vasilepi/Thesis/README.md

# Thesis
This repo contains everything about my thesis project at AUTh
