vasilepi/Thesis/TeX/title.tex

\newcommand{\uni}{ΑΡΙΣΤΟΤΕΛΕΙΟ ΠΑΝΕΠΙΣΤΗΜΙΟ ΘΕΣΣΑΛΟΝΙΚΗΣ}
\newcommand{\faculty}{ΠΟΛΥΤΕΧΝΙΚΗ ΣΧΟΛΗ}
\newcommand{\tmhma}{ΤΜΗΜΑ ΜΗΧΑΝΟΛΟΓΩΝ ΜΗΧΑΝΙΚΩΝ}

\newcommand{\titlos}{Προκαταρτικός Και Μηχανοτρονικός Σχεδιασμός Ημιαυτόνομου Ρομποτικού Διασώστη Για U.S.A.R. Αποστολές}
\newcommand{\ypotitlos}{Διπλωματική Εργασία}

\newcommand{\onomaauthor}{ΒΑΣΙΛΕΙΟΣ ΠΑΠΑΜΙΧΑΗΛ}

\newcommand{\advisor}{Σαββαΐδης Γεώργιος}
\newcommand{\advisorView}{Γιαννάκης Ευστράτιος, Τσακίρης Αντώνιος}
\newcommand{\mailauthor}{\href{mailto:vasilepi@meng.auth.gr}{vasilepi@meng.auth.gr}}
\newcommand{\aem}{6920}
\newcommand{\hmeromhnia}{\today}

\begin{titlepage}
    \begin{center}
    \raisebox{20mm}{
    \begin{tikzpicture}
        \draw (0,0) -- (6,0);
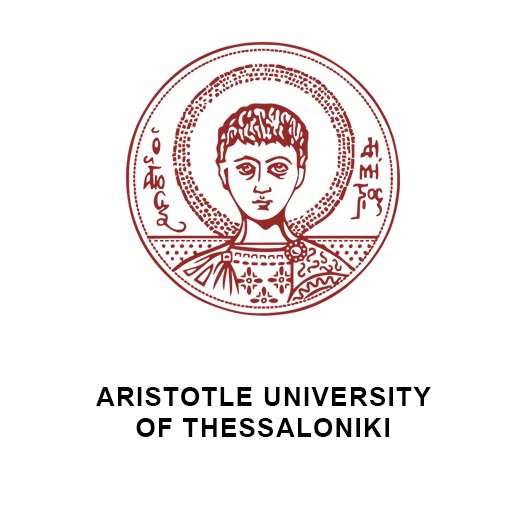
[picture p1: TeX/media/autheng.png]
    \end{tikzpicture}}\raisebox{20mm}{\begin{tikzpicture}
        \draw (0,0) -- (6,0);
    \end{tikzpicture}}
     \end{center}
    
    \begin{center}
        \large
        \uni\\
        \normalsize
        \faculty\\
        \vspace{1em}
        \tmhma
    \end{center}

    \vspace{2cm}
    \begin{center}
        \Large
        \textbf{\titlos}\\
        \vspace{1em}
        \large
        \textit{\ypotitlos}
    \end{center}
    \begin{center}
        \begin{tikzpicture}
        \draw (0,0) -- (4,0);
    \end{tikzpicture}\\
    \vspace{7em}
    \Large
    \textbf{\onomaauthor}\\
    \vspace{3em}
    
    \end{center}

    \vspace{1em}
    \hspace{4ex}
    \begin{minipage}[t]{0.8\textwidth} 
        \raggedright
        \textbf{Υπεύθυνος καθηγητής}: \advisor\\
        \textbf{Υπεύθυνος παρακολούθησης}: \advisorView\\
        \textbf{Email}: \mailauthor\\
        \textbf{ΑΕΜ}: \aem
    \end{minipage}\\

    \vspace{4cm}
    \begin{center}
        \textit{\hmeromhnia}\\
        \begin{tikzpicture}
            \draw (0,0) -- (15,0);
        \end{tikzpicture}
    \end{center}

\end{titlepage}
