vasilepi/Thesis/TeX/sections/conceptual.tex

\section{Στόχοι του προκαταρτικού σχεδιασμού}
% project requirements

Ο προκαταρτικός σχεδιασμός αναφέρεται στην δημιουργική φάση σχεδιασμού ενός συστήματος. Συνήθως αποτελείται από τη φάση του προσδιρισμού των λειτουργιών του προς σχεδίαση συστήματος, τη φάση της διατύπωσης των προϋποθέσεων, των προδιαγραφών, αλλά και των στόχων του σχεδιασμού, και τη φάση της υλοποίησης της σχεδιαστικής πρότασης. Πολλές φορές επίσης, αναλύονται εναλλακτικές σχεδιαστικές προτάσεις και αξιολογούνται με διάφορες μεθόδους ώστε να προκύψει η βέλτιστη σχεδιαστική πρόταση για το προς μελέτη σύστημα \cite{designArgyris}. Παρακάτω θα αναλυθούν οι προδιαγραφές του σχεδιασμού και οι προϋποθέσεις της σχειδαστικής πρότασεις.
\par Η αποστολή ενός ρομποτικού διασώστη μπορεί να διαφέρει σημαντικά, όπως και η πληθώρα των πιθανών καταστροφών. Ιδιαίτερα σε περίπτωση σεισμού, η χρήση ενός τέτοιου συστήματος καθίσταται ακόμη πιο αποτελεσματική, τόσο επειδή η σχεδίαση και υλοποίηση ενός ρομποτικού διασώστη παρουσιάζει λιγότερες τεχνικές δυσκολίες, όσο και επειδή οι άνθρωποι διασώστες εκτίθενται σε υψηλό και απρόβλεπτο κίνδυνο. Ένας άνθρωπος διασώστης που επιχειρεί να εισχωρήσει σε συντρίμμια για τον εντοπισμό θυμάτων δεν μπορεί να γνωρίζει εάν και πότε ενδέχεται να σημειωθεί επιπλέον κατάρρευση ή πτώση φερώντων υλικών με αποτέλεσμα να διακινδυνεύει τη ζωή του. Επιπλέον, οι άνθρωποι διασώστες συχνά αντιμετωπίζουν σημαντικούς περιορισμούς χώρου σε τέτοιες αποστολές. Λόγω του όγκου του ανθρώπινου σώματος, πολλές φορές δεν είναι δυνατόν να περάσουν μέσα από πολύ στενά ανοίγματα ή σχισμές, στα οποία ενδέχεται να βρίσκεται παγιδευμένο κάποιο θύμα. Έτσι, ένας ρομποτικός διασώστης για σεισμικές καταστροφές καθίσταται ιδιαίτερα χρήσιμος και αποτελεσματικός.
\par Η χρήση των ρομποτικών διασώστων μπορεί επίσης να ποικίλει. Τα ρομπότ αυτά συχνά δαιχωρίζονται στα παρακάτω είδη. Προφανώς ένας ρομποτικός διασώστης μπορεί να σχεδιάζεται για να λειτουργεί με οποιονδήποτε συνδυασμό όλων των παρακάτω:
\begin{itemize}
    \item \textbf{Ρομπότ έρευνας και ανίχνευσης.} Βασικός στόχος του διασώστη αυτού είναι η έρευνα μιας πληγείσας περιοχής και η ανίχνευση πιθανών θυμάτων ή αιτιών της καταστροφής.
    \item \textbf{Ρομπότ αρωγής ανθρώπινων αποστολών.} Τα ρομπότ αυτά υποστηρίζουν τους ανθρώπους διασώστες κατά τη διάρκεια των επιχειρήσεων, παρέχοντας βοήθεια όπου απαιτείται.
    \item \textbf{Ρομπότ παροχής πρώτων βοηθειών.} Έχουν ως κύρια αποστολή τη μεταφορά ειδών πρώτης ανάγκης ή ιατρικού εξοπλισμού σε δυσπρόσιτες περιοχές όπου μπορεί να βρίσκονται θύματα.
    \item \textbf{Άμεσοι ρομποτικοί διασώστες.} Αποτελούν την πιο προηγμένη κατηγορία, καθώς σχεδιάζονται για να λειτουργούν ημιαυτόνομα σε επιχειρήσεις απεγκλωβισμού. Διαθέτουν μηχανισμούς για τον εντοπισμό, την απελευθέρωση και τη μεταφορά θυμάτων.
\end{itemize} 
Παρακάτω φαίνονται μερικά παραδείγματα ρομποτικών διασωστών με διάφορες λειτουργίες. Αυτά τα ρομπότ εξειδικεύονται σε USAR αποστολές και έχουν αναπτυχθεί στην Ιαπωνία, όπου η ανάγκη για τέτοιες τεχνολογίες είναι πολύ μεγάλη λόγω της συχνότητας αλλά και της κλίμακας των σεισμικών καταστροφών. Για τα πλαίσια αυτής εργασίας κρίνεται σκόπιμο να σχεδιασθεί ένας διασώστης για USAR αποστολές και πιο συγκεκριμένα για αποστολές διάσωσης μετά από σεισμούς.
\begin{figure}[H]
    \centering
    \begin{subfigure}[b]{0.3\linewidth}
        \centering
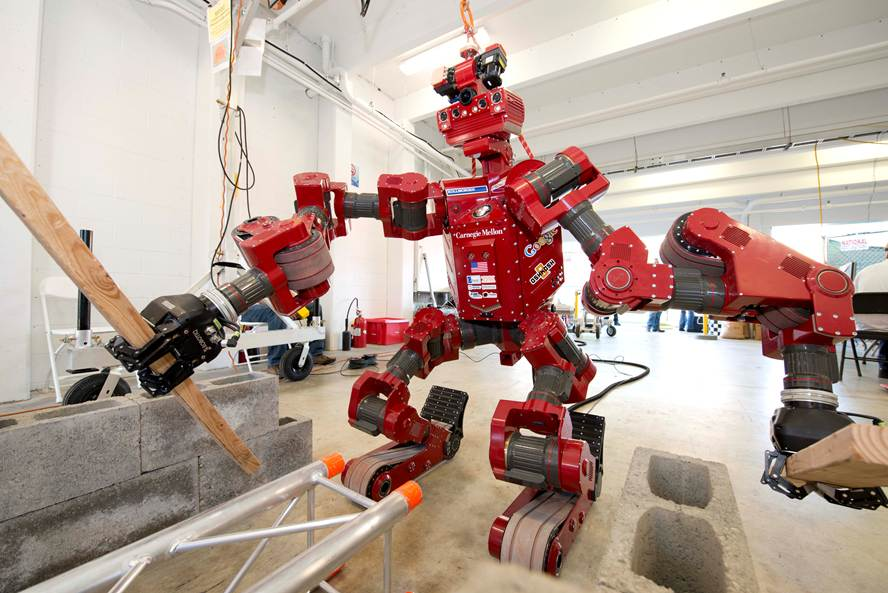
[picture p2: TeX/media/chimp.jpg]
        \adjustbox{valign=b}{}
        \caption{CHIMP (CMU Highly Intelligent Mobile Platform) ρομποτικός διασώστης.}
        \label{fig:rlabel1}
    \end{subfigure}
    \hfill
    \begin{subfigure}[b]{0.3\linewidth}
        \centering
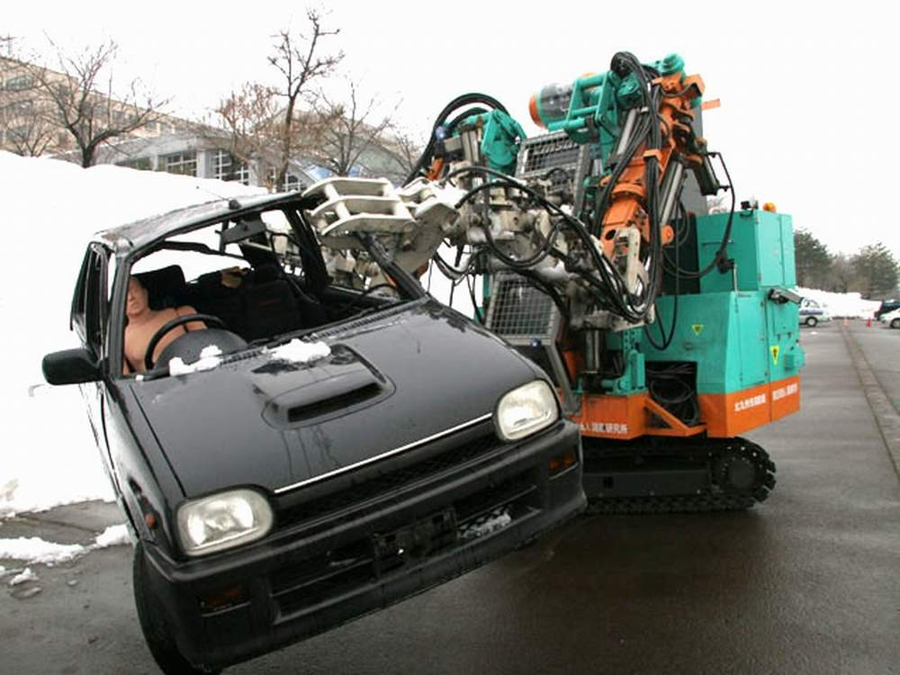
[picture p3: TeX/media/enryu.JPG]
        \adjustbox{valign=b}{}
        \caption{T-52 Enryu (Rescue Dragon) ρομποτικός εξομοιωτής.}
        \label{fig:rlabel2}
    \end{subfigure}
    \hfill
    \begin{subfigure}[b]{0.3\linewidth}
        \centering
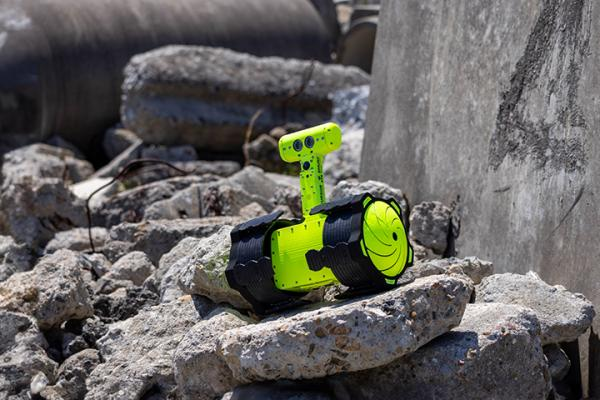
[picture p4: TeX/media/smurf.jpg]
        \adjustbox{valign=b}{}
        \caption{SMURF (Soft Miniaturized Underground Robotic Finder) ανιχνευτής.}
        \label{fig:rlabel3}
    \end{subfigure}
    \caption{Διάφοροι ρομποτικοί διασώστες γαι ξεχωριστές λειτουργίες. Από αριστερά προς τα δεξιά: άμεσος ρομποτικός διασώστης, ρομπότ αρωγής ανθρώπινων αποστολών, ρομπότ έρευνας και ανίχνευσης.}
    \label{fig:robotRescuers}
\end{figure}

 Με βάση όλα τα παραπάνω, η κύρια λειτουργία του διασώστη εκλέγεται να είναι η ανίχνευση και η έρευνα μετά από σεισμικές καταστροφές. Ο διασώστης προς σχεδιάση θα κληθεί κατά τη λειτουργία του να αναζητά και να εντοπίζει θύματα καθώς και να παρέχει σε αυτά είδη πρώτων αναγκών. Επομένως, η λειτουργία του ρομπότ θα είναι καθαρά ο εντοπισμός των θυμάτων ή των επιζόντων που χρήζουν βοήθεια. Για να έχει νόημα ένα τέτοιο σύστημα θα πρέπει προφανώς το ρομπότ να είναι αρκετά μικρό ώστε να μπορεί διασχίζει περάσματα μη προσβάσιμα από άνθρωπο. Επίσης, το όλο σύστημα θα λειτουργεί με αλγόριθμο εντοπισμού ώστε το ρομπότ να είναι αυτόνομο. Η ημιαυτονομία θα προκύπτει από το γεγονός ότι ο ειδικευμένος χειριστής του ρομπότ θα μπορεί ανά πάσα στιγμή να πάρει τα ηνία και να χειριστεί απομακρυσμένα το ρομπότ.

\par Επομένως, λόγω της φύσης της λειτουργίας του ρομποτικού διασώστη, πρέπει να ληφθούν υπόψη οι παρακάτω προϋποθέσεις σχεδιασμού:
\begin{itemize}
    \item Ο διασώστης θα πρέπει να μπορεί να εισχωρεί σε συντρήμια.
    \item Ο διασώστης θα πρέπει να είναι ανθεκτικός σε κρούσεις και απότομες μεταβολές φορτίου.
    \item Ο διασώστης θα πρέπει να μπορεί να αποφύγει εμπόδια και να κινείται σε ανώμαλο έδαφος.
    \item Ο διασώστης θα πρέπει να έχει, φιλικό προς το θύμα, τρόπο να παραδίδει είδη πρώτων βοηθειών. 
    \item Ο διασώστης θα πρέπει να έχει μεγάλη αυτονομία μπαταρίας και να λειτουργεί ημιαυτόνομα.
\end{itemize}

Αναλύοντας τα παραπάνω, προκύπτουν πιο συγκεκριμένα οι προϋποθέσεις/στόχοι (requirements) του σχεδιασμού. Πιο συγκεκριμένα για να μπορεί ο διασώστης να εισχωρεί σε συντρήμια, θα πρέπει να είναι αρκούντως μικρός. Επίσης, όσο αναφορά την ανθεκτικτότητα, τα υλικά του ρομπότ θα πρέπει να χαρακτηρίζονται από υψηλή αντοχή. Για να επιτευχθεί η εύκολη αποφυγή εμποδίων (transversability), κρίνεται σκόπιμη η χρήση ερπύστριας καθώς προσφέρει τη μέγιστη προσαρμοστικότητα σε ανώμαλα εδάφη. Ο διασώστης θα πρέπει επίσης να είναι όσο πιο ελαφρύς γίνεται από άποψη κόστους αλλά και για να είναι όσο πιο φιλικός προς το θύμα. Τέλος, η μεγάλη διάρκεια ζωής έγγυται στο ότι πρέπει ο διασώστης να διαρκεί όσο μια τυπική επιχείρηση έρευνας και διάσωσης. Με βάση όλα αυτά φαίνονται παρακάτω οι προϋποθέσεις του σχεδιασμού αναλυτικά. Σχετικά με τις μέγιστες διαστάσεις και το βάρος του διασώστη, αυτά δε προκύπτουν τελείως αυθαίρετα αλλά με βάση τις διαστάσεις του \ref{tab:xiphias}, της πλατφόρμας Plasma RX \cite{plasmaRX19}, στην οποία γίνεται εκτενή αναφορά στα παρακάτω κεφάλαια.
\begin{table}[H]
    \centering
    \rowcolors{2}{gray}{white}
        \begin{tabular}{|c|p{13cm}|}
        \hline
        \rowcolor{Dandelion}
        Requirement & \multicolumn{1}{c|}{Description}\\
        \hline
        R-01 & Ο διασώστης θα πρέπει να ζυγίζει λιγότερο από $35\; kg$.\\
        \hline
        R-02 & Ο διασώστης θα πρέπει είναι μικρότερος από $65\times 65 \times 65 cm^3$.\\
        \hline
        R-03 & Η αυτονομία του διασώστη θα πρέπει να διαρκεί τουλάχιστον 3h.\\
        \hline
        R-04 & Ο διασώστης θα πρέπει μεταφέρει ήδη πρώτων αναγκών έως και $5\; kg$.\\
        \hline
        R-05 & Ο διασώστης θα πρέπει να λειτουργεί ημιαυτόνομα, όπου ο χειριστής να μπορεί ανά πάσα στιγμή να πάρει τον έλεγχο του ρομπότ.\\
        \hline
        \end{tabular}
    \caption{Προϋποθέσεις σχεδιασμού ρομποτικού διασώστη για USAR αποστολές.}
    \label{tab:reqs}
\end{table}

Επίσης, όσο αναφορά την ανάλυση των περαιτέρω σχεδιαστικών προτάσεων, κρίνεται αναγκαίο για την επίτευξη των χρονικών ορίων της εργασίας, να μην αναλυθεί πάνω από μια σχεδιαστική πρόταση. Έτσι, ο προκαταρτικός σχεδιασμός θα αποτελείται από δύο επαναλήψεις (loops) με σκοπό τη βελτιστοποίση του βάρους του διασώστη.
\par Η γενικότερη πορεία του σχεδιασμού μπορεί να συνοψιστεί στο \ref{fig:timeplan}. Ξεκινώντας από τις απαιτήσεις του σχεδιασμού, προκύπτει η βασική σχεδιαστική ιδέα. Έπειτα, η βασική ιδέα βελτιώνεται με σκοπό τη μείωση της μάζας του ρομπότ. Αφού σχεδιαστεί η βελτιωμένη έκδοση του ρομπότ, σειρά έχει ο σχεδιασμός του κυκλώματος και η επιλογή των ηλεκτρονικών καθώς και η ανάλυση της αυτονομίας της μπαταρίας του ρομπότ. Τέλος, προχωρώντας πλέον στον διαμορφωτικό σχεδιασμό, αναλύονται οι μηχανισμοί των οδοντωτών τροχών αλλά και των λοιπών μηχανολογικών στοιχείων. Με την ολοκλήρωση και αυτού του σταδίου προκύπτει η τελική σχεδιαστική πρόταση καθώς και προτάσεις για περαιτέρω βελτίωση του διασώστη.
\begin{figure}[H]
    \centering
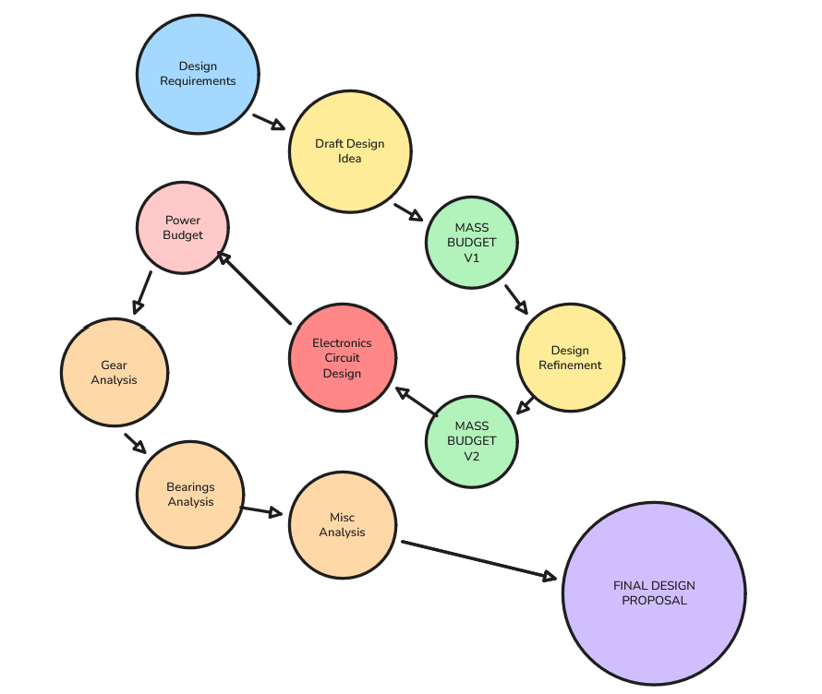
[picture p5: TeX/media/designTimeplan.png]
    
    \caption{Γενικότερη πορεία σχεδιασμού και σταδίων της μελέτης.}
    \label{fig:timeplan}
\end{figure}

\section{Ανάλυση απαιτήσεων συστήματος}
\subsection{Λειτουργικές απαιτήσεις}
% functionality system
% sensors initial
Στα πλαίσια του σχεδιασμού της αρχιτεκτονικής ελέγχου του ρομπότ, κρίνεται απαραίτητος ο σαφής καθορισμός της ισορροπίας μεταξύ των εντολών του χειριστή-διασώστη και του βαθμού αυτονομίας του συστήματος. Επιπροσθέτως, για λόγους συντομίας και ευκολίας στην αναφορά κατά την παρούσα μελέτη, στο προτεινόμενο ρομποτικό σύστημα αποδίδεται η κωδική ονομασία \textbf{V.L.A.D. (Victim Localization Assistant Droid)}. Εφεξής, η αναφορά στο σύστημα θα γίνεται με τη χρήση αυτού του ακρωνυμίου.
\par Εξετάζοντας το περιβάλλον στο οποίο θα δρα το V.L.A.D., όπως και έχει ήδη αναφερθεί, θα πρέπει η λειτουργικότητα του συστήματος να δίνει τη δυνατότητα για ευκολία στην αποφυγή εμποδίων και την προσαρμοστικότητα σε ανώμαλα εδάφη. Επίσης, θα πρέπει το κέντρο βάρους του συστήματος να βρίσκεται χαμηλά αλλά και η ροπή αδράνειας του ως προς τους άξονες παράλληλους στο έδαφος του πεδίου να είναι υψηλή, ώστε να αποφευχθεί η ανατροπή του συστήματος.
\par Η χρήση του V.L.A.D. θα είναι καθαρά μη παρεμβατική καθώς σχεδιάζεται έτσι ώστε να είναι μικρό και ταχύ. Αυτή η λειτουργία ενισχύει τη χρήση του σε αποστολές έρευνας και ανίχνευσης και για αυτό ο κύριος σκοπός του συστήματος θα είναι ο εντοπισμός θυμάτων ή επιζώντων μετά από τη καταστροφή. Το σύστημα έπειτα θα έχει ως σκοπό να παρέχει πρώτες βοήθειες στους επιζώντες και να ειδοποιεί τον χειριστή του για την ακριβή θέση και κατάσταση των επιζώντων ώστε να καταστρωθεί η αποστολή διάσωσής τους.
\par Το λειτουργικό σύστημα θα καταστρωθεί έτσι ώστε, οι ενδείξεις και τα δεδομένα από τους αισθητήρες να χρησιμοποιούνται σε μοντέλα αναγνώρισης επιζώντων/θυμάτων. Έπειτα, με υπολογιστική λογική θα προκύπτουν οι επόμενες κινήσεις του συστήματος. Μία εξ αυτών θα είναι και η σήμανση προς τον χειριστή σε περίπτωση που προκύπτουν σφάλματα από τα μοντέλα επεξεργασίας δεδομένων ή λόγω σύντηξης σε επίπεδο απόφασης των μοντέλων.
\par Με βάση τα παραπάνω, οι στόχοι του σχεδιασμού του λειτουργικού συστήματος συνοψίζονται παρακάτω:
\begin{itemize}
    \item Ανίχνευση και εντοπισμός της ακριβής τοποθεσίας επιζώντων/θυμάτων μετά το πέρας της καταστροφής.
    \item Αναγνώριση εμποδίων και χαρτογράφηση χώρου κατά τη λειτουργία.
    \item Αυτόνομη λήψη αποφάσεων στηριζόμενη από μοντέλα μηχανικής μάθησης και επεξεργασίας δεδομένων.
\end{itemize}
Επομένως, η επιλογή των αισθητήρων θα πρέπει να δικαιολογείται με τη κατάστρωση ενός υποθετικού πλάνου λειτουργίας του συστήματος για απόδειξη της ορθής λειτουργίας του.

\par Ξεκινώντας με την ανίχνευση και τον εντοπισμό των θυμάτων, αναλύοντας τις πιθανές ανάγκες σε μια τέτοια κατάσταση, το V.L.A.D. θα πρέπει να είναι ικανό να:
\begin{itemize}
    \item Φέρνει σε επικοινωνία τους επιζώντες με το χειριστή
    \item Μεταφέρει εικόνες των θυμάτων/επιζώντων στο χειριστή
    \item Αναγνωρίζει αυτόνομα τον ανθρώπινο οργανισμό
\end{itemize}

Για την επίτευξη των παραπάνω, διάφοροι συνδυασμοί αισθητήρων θα μπορούσαν να χρησιμοποιηθούν. Σε περίπτωση μη ορατότητας του επιζώντος, θα πρέπει το V.L.A.D. να ανιχνεύει τη παραμικρή κίνηση ή και ήχο και μέσω αυτής/ού να λαμβάνει ημιαυτόνομα αποφάσεις. Κρίνεται σκόπιμο σε μια τέτοια κατάσταση, να υπάρχει η δυνατότητα ανίχνευσης σημάτων δονήσεων υψηλής αλλά και χαμηλής συχνότητας καθώς και ηχητικών σημάτων. Για τα τελευταία, η χρήση ενός απλού μικροφώνου είναι αρκετή για να επιτρέψει την επικοινωνία των επιζώντων με το κέντρο ελέγχου/χειριστή. Όσο αναοφρά τα σήματα υψηλής συχνότητας, αυτά μπορούν να ανφέρονται σε σήματα από χτύπους (tapping, knocking) οι οποίοι μπορεί να δηλώνουν την ύπαρξη του ανθρώπου στα συντρήμμια. Αντίστοιχα, τα σήματα χαμηλής συχνότητας όπως η ανθρώπινη κίνηση ή η αναπνοή δηλώνουν το ίδιο. Για την ανίχνευση τέτοιων σημάτων, η χρήση επιταχυνσιόμετρων είναι ικανοποιητική.
\par Άλλες ανάγκες ανίχνευσης σε τέτοιες αποστολές είναι η εικόνα. Αντί της συμβατικής κάμερας προτιμάται η χρήση θερμικής κάμερας ευρείας γωνίας. Αυτό γιατί η θερμική κάμερα θα επιτρέψει στον διασώστη να λαμβάνει δεδομένα πίσω από ογκώδη αντικείμενα αλλά και για τη καταγραφή εικόνας ανεξαρτήτος της φωτεινότητας του χώρου. Σε πολύ κρυφά σημεία μέσα στα συντρήμμια μπορεί να μην υπάρχει η δυνατότητα να περάσουν οι ακτίνες του φωτός, καθιστόντας μια συμβατική κάμερα χωρίς κάποιου είδους περαιτέρω φωτισμού μη χρήσιμη. 
\par Τέλος, για τη βελτίωση της ευρωστίας του συτήματος αλλά και για μια πιο ολοκληρωμένη συλλογή δεδομένων κατά την λειτουργία, δύναται να χρησιμοποιηθούν αισθητήρες καταγραφής ρύπων και συγκεκριμένα $CO_2$. Ο ανθρώπινος οργανισμός εκμπέμπει υψηλή συγκέντρωση του προαναφερόμενου ρύπου, με αποτελέσμα να καθίσταται ιδιαίτερα χρήσιμη για την ανίχνευση των επιζόντων ένας τέτοιος αισθητήρας.
\begin{figure}[H]
    \centering
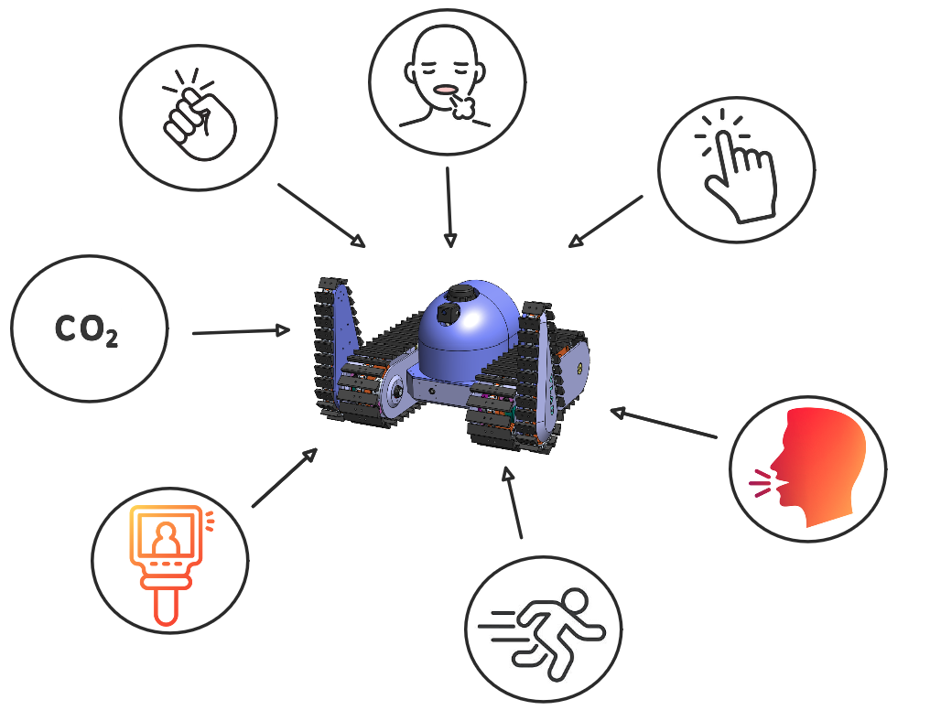
[picture p6: TeX/media/sensorData.png]
    
    \caption{Δυνατότητες ανίχνευσης ρομποτικού διασώστη με βάση το διαφορετικό είδος δεδομένων.}
    \label{fig:sensorData}
\end{figure}

\par Οι προαναφερθέντες αισθητήρες συμβάλλουν καθοριστικά στον εντοπισμό των θυμάτων, ωστόσο, δεν επαρκούν για την αντίληψη του χώρου από την πλευρά του ρομπότ. Συγκεκριμένα, αδυνατούν να υποστηρίξουν λειτουργίες χαρτογράφησης του άγνωστου περιβάλλοντος ή να εντοπίσουν εμπόδια που απειλούν την ακεραιότητα του οχήματος. Συνεπώς, για την επίτευξη αυτόνομης ή ημι-αυτόνομης πλοήγησης, κρίνεται απαραίτητη η ενσωμάτωση μιας επιπρόσθετης σουίτας αισθητήρων πλοήγησης.
\par Αρχικά, είναι αναγκαίο το σύστημα να γνωρίζει ανά πάσα στιγμή τον προσανατολισμό του και τις μεταβολές της κινητικής του κατάστασης στον χώρο. Η λειτουργία αυτή επιτυγχάνεται μέσω μιας μονάδας αδρανειακών μετρήσεων (Inertial Measurement Unit - IMU). Ο συγκεκριμένος αισθητήρας συνδυάζει δεδομένα από επιταχυνσιόμετρα, γυροσκόπια και συχνά μαγνητόμετρα. Στο πλαίσιο του V.L.A.D., το IMU είναι κρίσιμο για τον αλγόριθμο εκτίμησης θέσης, καθώς παρέχει δεδομένα για τις γωνίες Euler (Roll, Pitch, Yaw), επιτρέποντας στο ρομπότ να αντιλαμβάνεται την κλίση του σε ράμπες ή σκάλες και να διορθώνει την πορεία του.
\par Έπειτα, για τη διαδικασία της χαρτογράφησης και του ταυτόχρονου εντοπισμού θέσης, η βιβλιογραφία προτείνει διάφορες προσεγγίσεις. Μία επιλογή αποτελεί η χρήση τρισδιάστατων σαρωτών laser (3D LiDAR), οι οποίοι προσφέρουν πλήρη γεωμετρική αναπαράσταση του χώρου, αλλά με υψηλό κόστος και υπολογιστικό φόρτο. Μια εναλλακτική είναι οι κάμερες βάθους (RGB-D Cameras), οι οποίες παρέχουν πληροφορία χρώματος και απόστασης, ωστόσο η απόδοσή τους επηρεάζεται σημαντικά από τις συνθήκες φωτισμού και τη σκόνη που συχνά επικρατούν σε σενάρια καταστροφών.
\par Για την περίπτωση του V.L.A.D., η βέλτιστη λύση, λαμβάνοντας υπόψη τους περιορισμούς κόστους και υπολογιστικής ισχύος, κρίνεται η χρήση ενός δισδιάστατου σαρωτή laser (2D LiDAR 360$^\circ$). Ο αισθητήρας αυτός λειτουργεί εκπέμποντας παλμούς laser περιστροφικά, μετρώντας τον χρόνο που απαιτείται για την επιστροφή της δέσμης. Το αποτέλεσμα είναι η δημιουργία ενός δισδιάστατου νέφους σημείων σε πραγματικό χρόνο, το οποίο επιτρέπει σε αντίστοιχο λογισμικό να δημιουργήσει έναν χάρτη κατάληψης, εντοπίζοντας τοίχους και εμπόδια περιμετρικά του ρομπότ με υψηλή ακρίβεια.
\par Συνοψίζοντας, οι αισθητήρες που κρίνονται αναγκαίοι για την ορθή και αξιόπιστη λειτουργία του V.L.A.D. είναι αισθητήρες καταγραφής διοξειδίου του άνθρακα ($CO_2$), αισθητήρες καταγραφής ήχου (μικρόφωνο), αισθητήρας θερμικής απεικόνισης (thermal image camera) και τέλος αισθητήρας καταγραφής ταλαντωτικών σημάτων (επιταχυνσιόμετρο) για την ανίχνευση των θυμάτων. Αντίστοιχα, χρειάζονται επίσης και αισθητήρες IMU και 2D LiDAR για τη χαρτογράφηση και την αναγνώριση εμποδίων. Με την σωστή διαχείριση και επεξεργασία των δεδομένων των παραπάνω αισθητήρων, ο διασώστης καλύπτει πολύ μεγάλο εύρος δυνατοτήτων κατά τις αποστολές εύρευνας και ανίχνευσης, καθιστόντας το σύστημα ικανό να πετύχει τον σκοπό για τον οποίο σχεδιάζεται.

\subsection{Μηχανικές απαιτήσεις}
% terrain transversability
% payload
% μεταδοση κινησης
% αναλυση του plasma rx19

\subsubsection{Σύστημα κίνησης}

Καθώς η μελέτη βασίζεται σε ρομποτικό σύστημα το οποίο θα πρέπει να κινείται σε συντρήμμια μετά το πέρας καταστροφών, είναι ύψιστης σημασίας να αναλυθούν οι μηχανικές απαιτήσεις του ρομπότ για την ορθή λειτουργία του. Όσο αναφορά τα ρομποτικά συστήματα και τα υποσυστήματα μετάδοσης της κίνησης, υπάρχουν διάφοροι τρόποι να ενιχύσει κανείς τη δυνατότητα του συστήματος να διασχίζει ανώμαλα εδάφη με ευκολία. Μερικές επιλογές για το σύστημα κίνησης πέρα από τη τυπική οδήγηση με τροχούς παρουσιάζονται παρακάτω \cite{mobileRobots}.
\par Η χρήση μηχανισμού ερπύστριας αποτελεί μία από τις πιο αποδοτικές μεθόδους για την πλοήγηση ρομποτικών οχημάτων σε δύσβατα και ανώμαλα εδάφη. Δομικά, το σύστημα αποτελείται από τον οδοντωτό τροχό μετάδοσης κίνησης (sprocket), τους τροχούς υποστήριξης (roller wheels) και τον τροχό τάνυσης (idler). Το κυρίως σώμα της ερπύστριας συγκροτείται από αρθρωτούς συνδέσμους (links) που φέρουν τα πέλματα (track shoes). Λειτουργικά, ο οδοντωτός τροχός λαμβάνει ροπή από τον κινητήρα και την μετατρέπει σε γραμμική κίνηση της αλυσίδας. Οι τροχοί υποστήριξης κατανέμουν το βάρος του οχήματος στο έδαφος, ενώ περιστρέφονται ελεύθερα. Τα πέλματα είναι σχεδιασμένα ώστε να μεγιστοποιούν την πρόσφυση (traction) και να μειώνουν την πίεση που ασκείται στο έδαφος (ground pressure), επιτρέποντας την κίνηση σε μαλακά ή ανώμαλα υποστρώματα. Τέλος, ο τροχός τάνυσης ρυθμίζει την ένταση της αλυσίδας, απορροφώντας τυχόν χαλαρώσεις (slack) και εξασφαλίζοντας τη σταθερή εμπλοκή των εξαρτημάτων κατά την κίνηση. Εναλλακτικά, οι ερπύστριες μπορούν να είναι και ενιαίας χύτευσης (continuous tracks). Οι ερπύστριες αυτές είναι κατασκευασμένες από ενισχυμένο συνθετικό ελαστικό και φέρουν στην εσωτερική τους πλευρά διαμορφωμένες προεξοχές (drive lugs), οι οποίες εμπλέκονται άμεσα με εσοχές στον κινητήριο τροχό (sprocket), επιτυγχάνοντας έτσι θετική μετάδοση κίνησης χωρίς ολίσθηση.

\begin{figure}[H]
    \centering
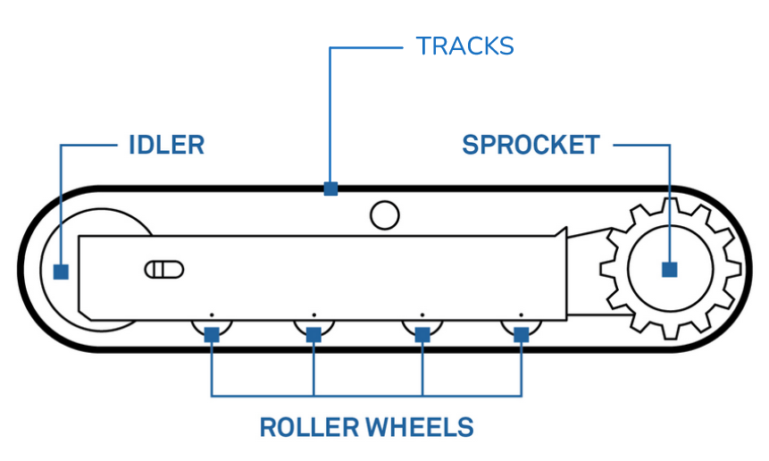
[picture p7: TeX/media/tracks1.png]
    
    \caption{Μηχανικά μέρη ερπυστρίας.}
    \label{fig:tracks1}
\end{figure}

\begin{figure}[H]
    \centering
    \begin{subfigure}{0.45\linewidth}
        \centering
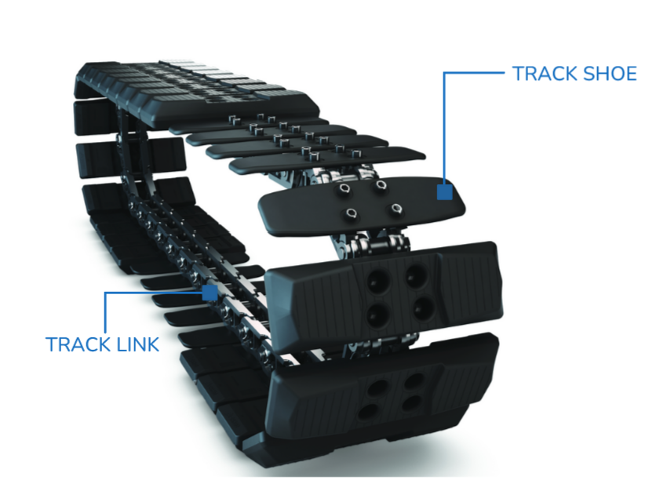
[picture p8: TeX/media/tracks2.png]
        
        \caption{Ερπύστρια με αρθρωτούς συνδέσμους.}
        \label{fig:track2}
    \end{subfigure}
    \hfill
    \begin{subfigure}{0.45\linewidth}
        \centering
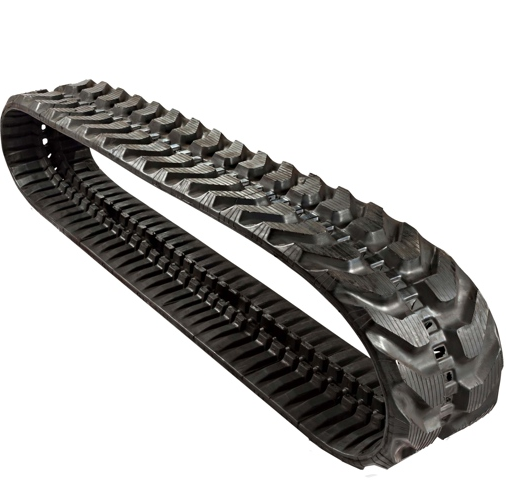
[picture p9: TeX/media/tracks3.png]
        
        \caption{Ενιαία ερπύστρια.}
        \label{fig:tracks3}
    \end{subfigure}
    \caption{Σύγκριση διαφορετικών ειδών ερπύστριας.}
    \label{fig:tracksvs}
\end{figure}

Άλλη επιλογή για το σύστημα κίνησης αποτελούν οι ερπύστριες μεταβλητής γεωμετρίας. Αυτή η κατηγορία αφορά ερπυστριοφόρα οχήματα που έχουν τη δυνατότητα να αλλάζουν το σχήμα της ερπύστριας κατά τη λειτουργία τους. Το σασί ή οι τροχοί τάνυσης κινούνται μέσω ενεργοποιητών, αλλάζοντας το περίγραμμα της ερπύστριας. Επίσης, αντί ερπυστριών, μπορούν αν χρησιμοποιηθούν και τροχοί μεταβλητής γεωμετρίας. Και τα δύο προαναφερθέντα συστήματα κίνησης βασίζονται στη μεταβολή της γεωμετρίας των τροχών ή και του γενικότερου συστήματος κίνησης για τη διευκόλυνση της κίνησης σε ανώμαλα εδάφη αλλά και για την αλλαγή του κέντρου βάρους σε σημείο που εξυπηρετεί καλύτερα κατά την λειτουργία του οχήματος. Τέτοια συστήματα παρουσιάζονται παρακάτω.
\begin{figure}[H]
    \centering
    \begin{subfigure}{0.45\linewidth}
        \centering
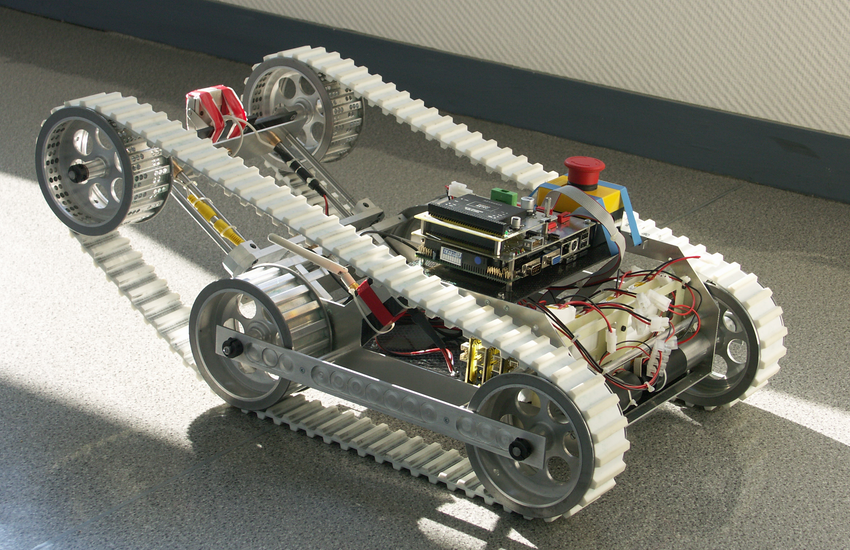
[picture p10: TeX/media/confTracks.png]
        
        \caption{Σύστημα μεταβλητής γεωμετρίας ερπύστριας \cite{b2p2}.}
        \label{fig:confTracks}
    \end{subfigure}
    \hfill
    \begin{subfigure}{0.45\linewidth}
        \centering
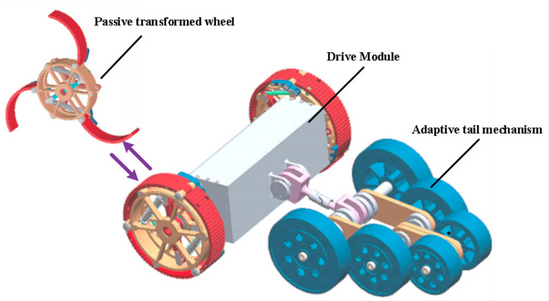
[picture p11: TeX/media/confWheels.png]
        
        \caption{Σύστημα μεταβλητής γεωμετρίας τροχού \cite{transWheel}.}
        \label{fig:confWheels}
    \end{subfigure}
    \caption{Συστήματα κίνησης μεταβλητής γεωμετρίας.}
    \label{fig:transMove}
\end{figure}

Τέλος, τα συστήματα με το μεγαλύτερο ενδιαφέρον, αλλά και αυτά με τα οποία ασχολείται η παρόν μελέτη, είναι τα συστήματα πολλαπλών ερπυστριών όπου το όχημα αποτελείται από επιπλέον ερπύστριες που δύναται να κινούνται σε σχέση με το σώμα του ρομπότ. Οι δεύτερες αναφέρονται και ως ερπύστριες με περιστρεφόμενους βραχίονες και αποτελούν τη πιο δημοφιλή κατηγορία συστήματος κίνησης σε ρομποτικούς διασώστες. Τα συστήματα αυτά αποτελούνται από το κύριο σώμα ερπύστριας (main track) και από βοηθητικές, μικρότερες ερπύστριες προσαρμοσμένες στα άκρα, οι οποίες ονομάζονται \textit{Flippers} ή \textit{Sub-tracks}. Οι βραχίονες αυτοί έχουν τη δυνατότητα ενεργής περιστροφής (συνήθως 360 μοιρών) γύρω από τον άξονα του κινητήριου τροχού ή του τροχού τάνυσης. Η συγκεκριμένη αρχιτεκτονική επιτρέπει τη δυναμική μεταβολή της γεωμετρίας του ρομπότ, καθιστώντας εφικτή την υπερπήδηση εμποδίων ύψους μεγαλύτερου από τη διάμετρο του τροχού, καθώς και την ασφαλή πλοήγηση σε κλιμακοστάσια μέσω της ενεργής μετατόπισης του κέντρου μάζας. Τέτοιο σύστημα παρουσιάζεται παρακάτω.
\begin{figure}[H]
    \centering
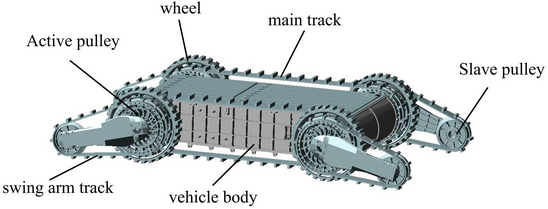
[picture p12: TeX/media/flipperTrack.png]
    
    \caption{Σύστημα πολλαπλής ερπύστριας με περιστρεφόμενο βραχίονα \cite{multiJoint}.}
    \label{fig:flipperTrack}
\end{figure}

Η επιλογή του συστήματος κίνησης με ερπύστρια και περιστρεφόμενους βραχίονες (flipper tracks) για την παρούσα μελέτη βασίστηκε στην αδιαμφισβήτητη υπεροχή του έναντι των συμβατικών μεθόδων πλοήγησης. Παράλληλα, πρόκειται για μια τεχνολογική λύση ευρέως διαδεδομένη στα ρομποτικά συστήματα διάσωσης, γεγονός που εξασφαλίζει την ύπαρξη εκτενούς βιβλιογραφίας και ερευνητικών δεδομένων για την υποστήριξη του σχεδιασμού. 
\par Η υπεροχή του συστήματος αυτού βασίζεται κυρίως στο γεγονός ότι δίνεται η δυνατότητα στο V.L.A.D. να αναριχείται με ευκολία σε σκάλες/υψώματα. Περιστρέφοντας τα flippers προς τα κάτω, το ρομπότ ανυψώνει το μπροστινό μέρος του σώματος του, αλλάζοντας τη γωνία προσβολής. Αυτό επιτρέπει στο ρομπότ να ξεπεράσει ψηλά εμπόδια όπως ένα σκαλοπάτι. Επίσης, ο περιστρεφόμενος βραχίονας βοηθάει στη γενικότερη διαχείριση του κέντρου βάρους της πλατφόρμας. Κατά την άνοδο σε απότομες κλίσεις, τα flippers εκτείνονται μπροστά ή πίσω για να αυξήσουν το ενεργό μήκος του οχήματος. Αυτό μετατοπίζει το κέντρο βάρους και αποτρέπει την εκτροπή της πλατφόρμας όπως φαίνεται και στο \ref{fig:flipperPerk}. Επιπροσθέτως, η συμβολή των αρθρωτών βραχιόνων (flippers) κρίνεται καθοριστική για τη δυνατότητα διέλευσης εδαφικών κενών. Στις αποστολές έρευνας και διάσωσης, οι οποίες διεξάγονται κατά κανόνα σε μετα-καταστροφικά περιβάλλοντα, η παρουσία εδαφικών ασυνεχειών αποτελεί συχνό φαινόμενο και μείζονα πρόκληση για την κινητικότητα ενός ρομποτικού συστήματος. Τέλος, οι βραχίονες αυτοί καθίστανται χρήσιμοι και σε περίπτωση ανατροπής της πλατφόρμας, όπου με τη χρήση τους ως μοχλό μπορεί ένα ρομποτικό σύστημα να επανέλθει στο φυσικό του προσανατολισμό.
\begin{figure}[H]
    \centering
    \begin{subfigure}{0.3\linewidth}
        \centering
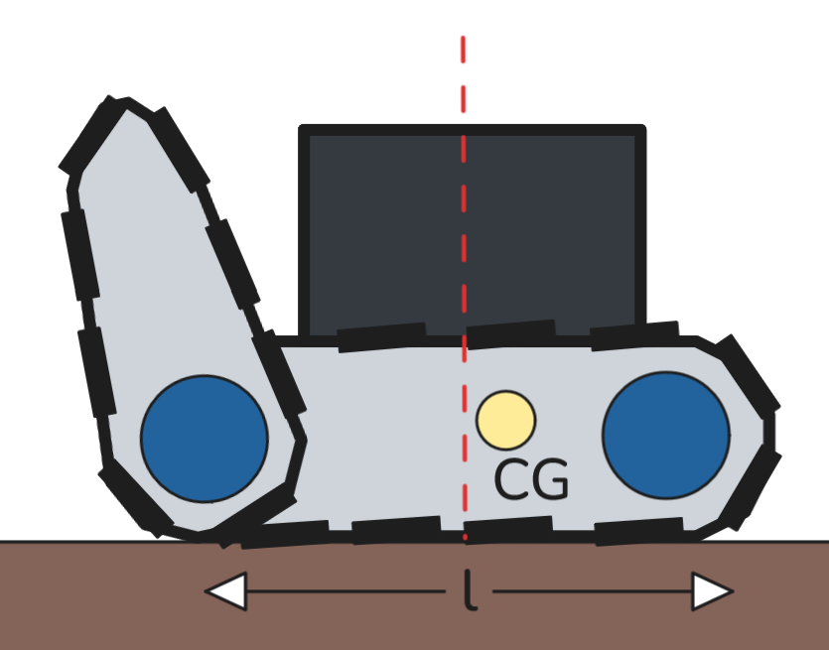
[picture p13: TeX/media/flipperPerk1.png]
        
        \caption{Κίνηση σε ευθεία.}
        \label{fig:flipperPerk1}
    \end{subfigure}
    \hfill
    \begin{subfigure}{0.3\linewidth}
        \centering
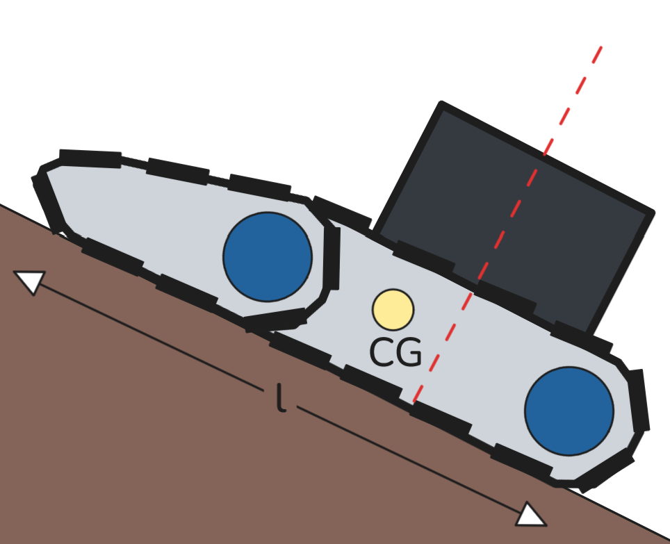
[picture p14: TeX/media/flipperPerk2.png]
        
        \caption{Κίνηση σε κεκλιμένο επίπεδο.}
        \label{fig:flipperPerk2}
    \end{subfigure}
    \hfil
    \begin{subfigure}{0.3\linewidth}
        \centering
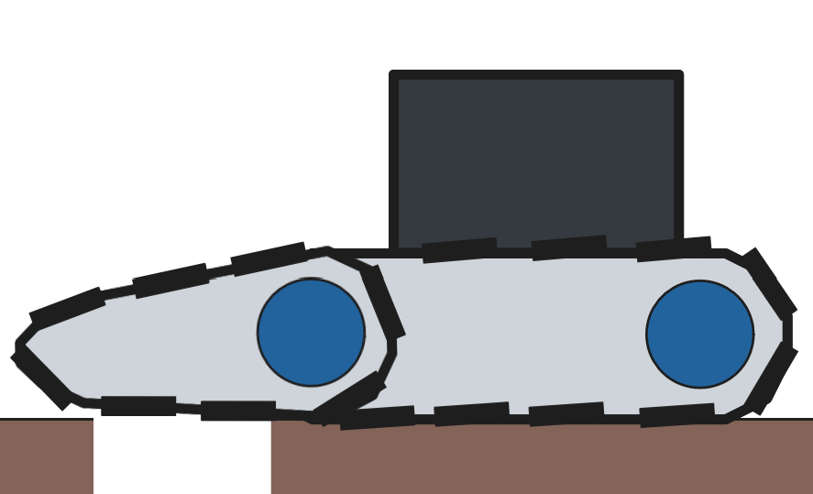
[picture p15: TeX/media/flipperPerk3.png]
        
        \caption{Διέλευση εδαφικών ασυνεχειών.}
        \label{fig:flipperPerk3}
    \end{subfigure}
    \caption{Σενάρια κίνησης συστήματος με διπλή ερπύστρια και περιστρεφόμενο βραχίονα (\textit{Flipper}).}
    \label{fig:flipperPerk}
\end{figure}

\begin{figure}[H]
    \centering
    \begin{subfigure}{0.3\linewidth}
        \centering
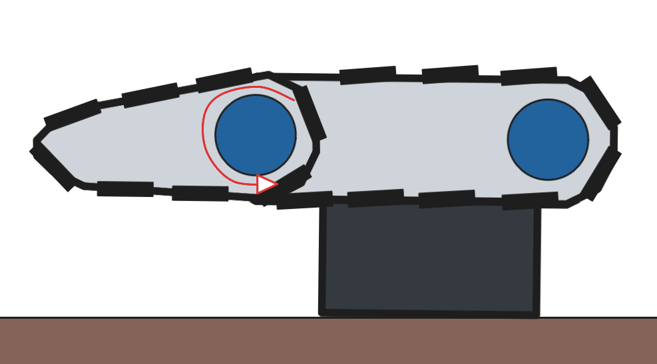
[picture p16: TeX/media/flipUp1.png]
        
        \caption{Καρέ 1.}
        \label{fig:flip1}
    \end{subfigure}
    \hfill
    \begin{subfigure}{0.3\linewidth}
        \centering
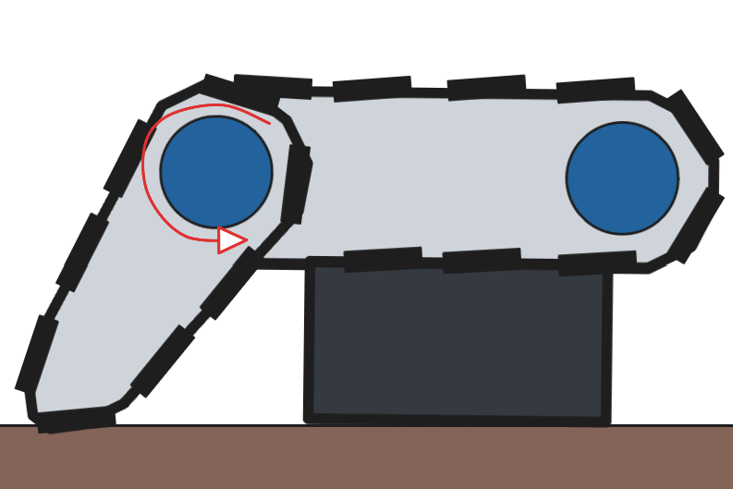
[picture p17: TeX/media/flipUp2.png]
        
        \caption{Καρέ 2.}
        \label{fig:flip2}
    \end{subfigure}
    \hfill
    \begin{subfigure}{0.3\linewidth}
        \centering
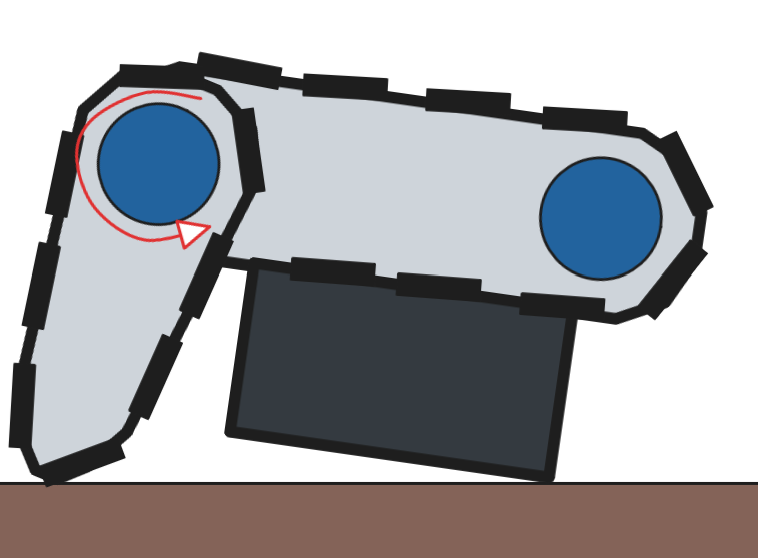
[picture p18: TeX/media/flipUp3.png]
        
        \caption{Καρέ 3.}
        \label{fig:flip3}
    \end{subfigure}
    \caption{Αλληλουχία επαναφοράς πλατφόρμας από ανατροπή με τη χρήση των flippers.}
    \label{fig:flipUp}
\end{figure}

\subsubsection{Μετάδοση κίνησης και αλλαγή κατεύθυνσης}
Ο σύνηθης και πιο αποδοτικός τρόπος να κινείται ένας τέτοιος διασώστης είναι προφανώς η χρήση ηλεκτροκινητήρων. Για τη χρήση αυτών, θα πρέπει να επιλεχθεί το είδος του ηλεκτροκινητήρα καθώς και η διάταξη των κινητήρων. Η διάταξη και ο αριθμός των κινητήρων θα πρέπει να αποφασιστούν με γνώμονα τον επιθμητό τρόπο αλλαγής πορείας του ρομπότ.
\par Η επιλογή των ηλεκτροκινητήρων αποτελεί κρίσιμη παράμετρο για τον σχεδιασμό του συστήματος κίνησης, καθώς καθορίζει άμεσα την ικανότητα του ρομπότ να υπερνικά εμπόδια και να διαχειρίζεται το φορτίο του. Στη ρομποτική κινητικότητα, οι επικρατέστερες τεχνολογίες είναι τρεις.
\par Αρχικά, οι Βηματικοί Κινητήρες προσφέρουν υψηλή ακρίβεια θέσης χωρίς ανάγκη κλειστού βρόχου ελέγχου, ωστόσο απορρίπτονται συχνά σε εφαρμογές ταχείας κίνησης λόγω του χαμηλού λόγου ισχύος προς βάρος και της μειωμένης απόδοσης σε υψηλές στροφές. Μια δεύτερη κατηγορία είναι οι Κινητήρες Συνεχούς Ρεύματος. Διακρίνονται για την απλότητα της οδήγησής τους και το χαμηλό κόστος, αποτελώντας μια αξιόπιστη λύση και θεωρούνται η πλέον ενδεδειγμένη επιλογή για σύγχρονα ρομπότ έρευνας και διάσωσης. Αν και απαιτούν πολύπλοκα ηλεκτρονικά ελέγχου, προσφέρουν τον βέλτιστο λόγο ροπής-βάρους, υψηλότερη ενεργειακή απόδοση και μεγαλύτερη διάρκεια ζωής. Για αυτούς τους λόγους, το V.L.A.D. έχει επιλεχθεί να κινείται με κινητήρες \textbf{συνεχούς ρεύματος}.
\par Η ικανότητα αλλαγής πορείας ενός ρομποτικού οχήματος δύναται να υλοποιηθεί μέσω διαφορετικών μηχανικών διατάξεων, οι οποίες κατηγοριοποιούνται βάσει του τρόπου που επιβάλλουν τη ροπή στρέψης. Η πιο διαδεδομένη μέθοδος στα συμβατικά οχήματα είναι το σύστημα Ackermann (Ackermann steering), όπου η αλλαγή κατεύθυνσης επιτυγχάνεται μέσω της γεωμετρικής μεταβολής της γωνίας των κατευθυντήριων τροχών. Μια δεύτερη κατηγορία είναι η αρθρωτή αλλαγή διεύθυνσης (Articulated steering), κατά την οποία το σασί χωρίζεται σε δύο τμήματα που περιστρέφονται το ένα ως προς το άλλο, μέθοδος συνήθης σε βαρέα χωματουργικά οχήματα.
\par Ωστόσο, για τα ερπυστριοφόρα ρομπότ και τα οχήματα υψηλής ευελιξίας, προκρίνεται η μέθοδος της αλλαγής διεύθυνσης μέσω ολίσθησης (Skid Steering) ή διαφορικής (Differential Steering). Στη πρώτη, οι τροχοί ή οι ερπύστριες της αριστερής και της δεξιάς πλευράς κινούνται ανεξάρτητα. Η στροφή επιτυγχάνεται εφαρμόζοντας γωνιακές ταχύτητες αντίθετης κατεύθυνσης στην κάθε πλευρά, δημιουργώντας έτσι μια ροπή εκτροπής που εξαναγκάζει το όχημα να περιστραφεί ολισθαίνοντας. Το σημαντικότερο πλεονέκτημα αυτής της μεθόδου είναι η δυνατότητα επίτευξης μηδενικής ακτίνας στροφής, επιτρέποντας στο ρομπότ να περιστρέφεται γύρω από τον γεωμετρικό του άξονα, χαρακτηριστικό κρίσιμο για την πλοήγηση σε στενούς χώρους. Η δε δεύτερη, επιτυγχάνεται μέσω χρήσης ίδιας κατεύθυνσης αλλά διαφορετικής σε μέτρο, γωνιακή ταχύτητα σε κάθε πλευρά της πλατφόρμας, με αποτέλεσμα αυτή να στρίβει ακολουθώντας μια γεωμετρική καμπύλη στροφής.
\begin{figure}[H]
    \centering
    \begin{subfigure}{0.28\linewidth}
        \centering
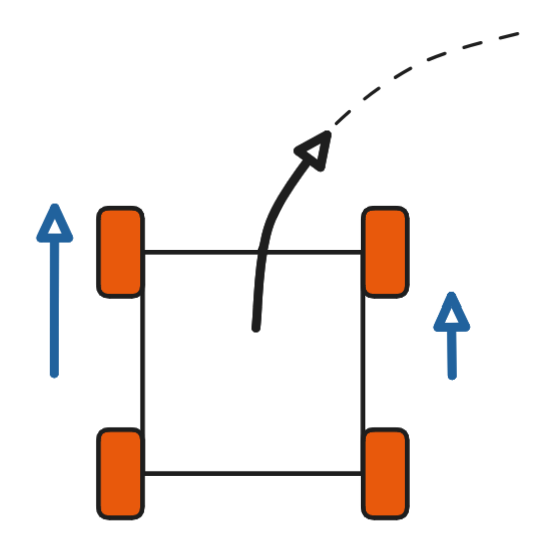
[picture p19: TeX/media/diffSteer.png]
        
        \caption{Διαφορική αλλαγή κατεύθυνσης.}
        \label{fig:diffSteer}
    \end{subfigure}%
    \hspace{2cm}
    \begin{subfigure}{0.28\linewidth}
        \centering
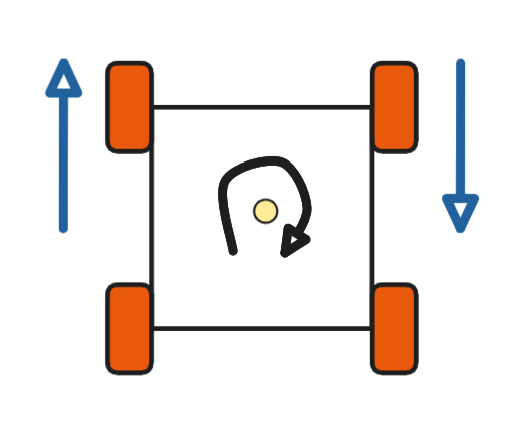
[picture p20: TeX/media/skidSteer1.png]
        
        \caption{Αλλαγή κατεύθυνσης μέσω ολίσθησης.}
        \label{fig:skidSteer1}
    \end{subfigure}
    \caption{Μέθοδοι αλλαγής κατεύθυνσης πλατφόρμας με τέσσερεις τροχούς.}
    \label{fig:steer}
\end{figure}

\section{Ισοζύγιο μάζας και διάταξη αισθητήρων}
\subsection{Αρχικός σχεδιασμός συστήματος κίνησης}
% basismenos sto plasma rx19
% mass budget v1
\subsubsection{Η ρομποτική πλατφόρμα Plasma RX}
Ο τομέας της ρομποτικής διάσωσης γνωρίζει ραγδαία ανάπτυξη στις χώρες της Ασίας και, ειδικότερα, στην Ιαπωνία. Λόγω της έντονης σεισμικότητας που χαρακτηρίζει την περιοχή, η χρήση ρομποτικών διασωστών έχει αναχθεί σε επιτακτική ανάγκη για τη διασφάλιση της αποτελεσματικότητας και της ασφάλειας των επιχειρήσεων έρευνας και διάσωσης. Στο πλαίσιο αυτό, η σχεδίαση της πλατφόρμας V.L.A.D. ενσωματώνει και αξιοποιεί βέλτιστες πρακτικές και αρχιτεκτονικές επιλογές που έχουν προκύψει από την ιαπωνική έρευνα. Ιδιαίτερη έμφαση δίνεται σε λύσεις που έχουν δοκιμαστεί και διακριθεί στον ετήσιο διεθνή διαγωνισμό RoboCupRescue, ο οποίος αποτελεί πεδίο αναφοράς για την εξέλιξη των αυτόνομων διασωστικών συστημάτων. 
\par Ειδικότερα, ξεκινώντας από το κρισιμότερο υποσύστημα ενός ρομποτικού διασώστη, αυτό της κίνησης, εξετάστηκαν σχεδιαστικές επιλογές που βασίζονται σε ερπύστριες με περιστρεφόμενους βραχίονες. Χαρακτηριστικό παράδειγμα αποτελεί η εργασία των Kamol Chuengsatiansup κ.ά. \cite{plasmaRX19} και η ανάπτυξη της ρομποτικής πλατφόρμας Plasma RX. Η αρχιτεκτονική κίνησης του V.L.A.D. αντλεί το σχεδιαστικό της έναυσμα από την εν λόγω πλατφόρμα, ενώ επιμέρους στόχο της παρούσας έρευνας αποτελεί η βελτιστοποίηση του συγκεκριμένου μηχανισμού και η προσαρμογή του στις μικρότερες διαστάσεις του V.L.A.D.
\par Η πλατφόρμα Plasma RX συμμετείχε στον παγκόσμιο διαγωνισμό World RoboCup το 2008 κερδίζοντας τη πρώτη θέση και με τη βράβευση της καλύτερης κινητικότητας ρομποτικής πλατφόρμας. Η πλατφόρμα αφορά δύο διαφορετικούς διασώστες βασισμένους στην ίδια σχεδιαστική πρόταση. Αυτά είναι το RX και το Xiphias. Το μικρότερο εξ αυτών, το Xiphias, φέρει τα χαρακτηριστικά του \ref{tab:xiphias}, και αποτελεί την έμπνευση για το V.L.A.D.
\begin{figure}[H]
    \centering
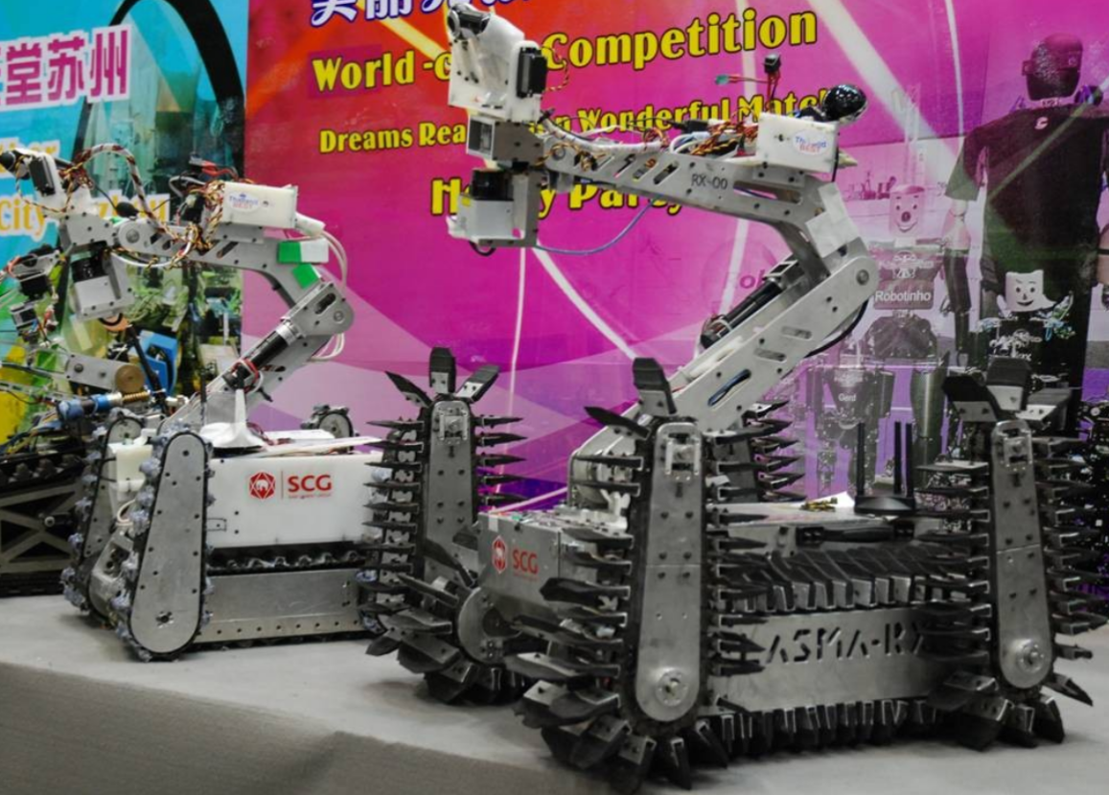
[picture p21: TeX/media/plasmaRob.png]
    
    \caption{Ρομποτική πλατφόρμα Plasma RX. Στα αριστερά το Xiphias και στα δεξιά το RX \cite{plasmaRX19}.}
    \label{fig:label}
\end{figure}
\begin{table}[H]
    \centering
    \rowcolors{2}{gray}{white}
        \begin{tabular}{|c|c|}
        \hline
        \rowcolor{Dandelion}
        Characteristic & Value \\
        \hline
        Mass & $35\;kg$\\
        \hline
        Volume & $62\times 65 \times 40 cm^3$\\
        \hline
        Αριθμός βραχιόνων & 4 (2 σε κάθε πλευρά)\\
        \hline
        \end{tabular}
    \caption{Χαρακτηριστικά του ρομποτικού διασώστη Xiphias.}
    \label{tab:xiphias}
\end{table} 

Η πλατφόρμα διασωστών Plasma RX αποτελείται από τέσσερεις συνολικά βραχίονες και έξι δαφορετικές ερπυστρίες. Επίσης, υιοθετεί και ρομποτικό χέρι-βραχίονα για την εξυπηρέτηση πιο δραστικών αναγκών ενός διασώστη από την απλή ανίχνευση. Το σύστημα κίνησης λειτουργεί με έξι συνολικά ηλεκτροκινητήρες εκ των οποίων, οι δύο είναι για τη μεταφορά της πλατφόρμας και τη κίνηση της βασικής ερπύστριας, ενώ οι υπόλοιποι τέσσερεις προορίζονται για τη περοστροφή των βραχιόνων (flippers). 
\begin{figure}[H]
    \centering
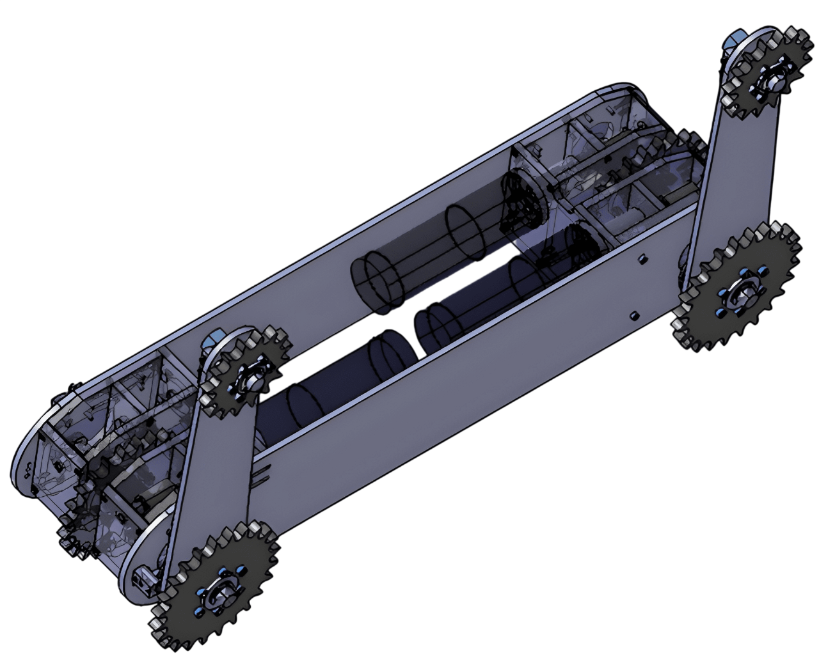
[picture p22: TeX/media/plasmaDrive.png]
    
    \caption{Σύστημα κίνησης ερπύστριας και βραχιόνων της πλατφόρμας Plasma RX \cite{plasmaRX19}.}
    \label{fig:plasmaDrive}
\end{figure}

Παρακάτω φαίνεται επίσης και η τομή του συστήματος κίνησης. Αυτό αποτελείται από το περίβλημα του συστήματος (gearbox), δύο ζευγάρια οδοντωτών τροχών ατέρμονα-κορώνα, τον βραχίονα καθώς και τις ατράκτους για τη μεταφορά της κίνησης. Η κύρια άτρακτος (sprocket shaft) είναι υπεύθυνη για τη μετάδοση της κίνησης από τον ηλεκτροκινητήρα στο τροχό της ερπύστριας.  Όπως παρατηρείτα, η ερπύστρια αποτελείται από αρθρωτούς συνδέσμους με πέλματα ενώ η διαφορετική περιστροφή του βραχίονα (flipper) και της κύριας ατράκτου επιτυγχάνεται μέσω χρήσης εδράνων κύλισης. Οι μεταφορές ροπής γίνονται με τη χρήση πολύσφηνων ή κοχλιών. Οι ερπύστριες των βραχιόνων και του κυρίου μέρους το συστήματος κίνησης κινούνται με κοινή γωνιακή ταχύτητα καθώς συνδέονται οι δύο τροχοί των διαφορετικών ερπυστριών στην ίδια άτρακτο κίνησης.
\par Η χρήση ζεύγους οδοντωτών τροχών ατέρμονα-κορώνας, αποτελεί μια ιδιαίτερα έξυπνη λύση για τη μεταφορά της ροπής. Η συγκεκριμένη οδοντοκίνηση χαρακτηρίζεται από μεγάλους λόγος μετάδοσης επιτρέποντας την μεγάλη αύξηση της ροπής έναντι της ταχύτητας. Επίσης, αποτελούν εξαιρετικά χρήσιμη λύση για την εξοικονόμιση χώρου καθώς μεταφέρουν τη ροπή σε άξονες κάθετους μεταξύ τους. 
\begin{figure}[H]
    \centering
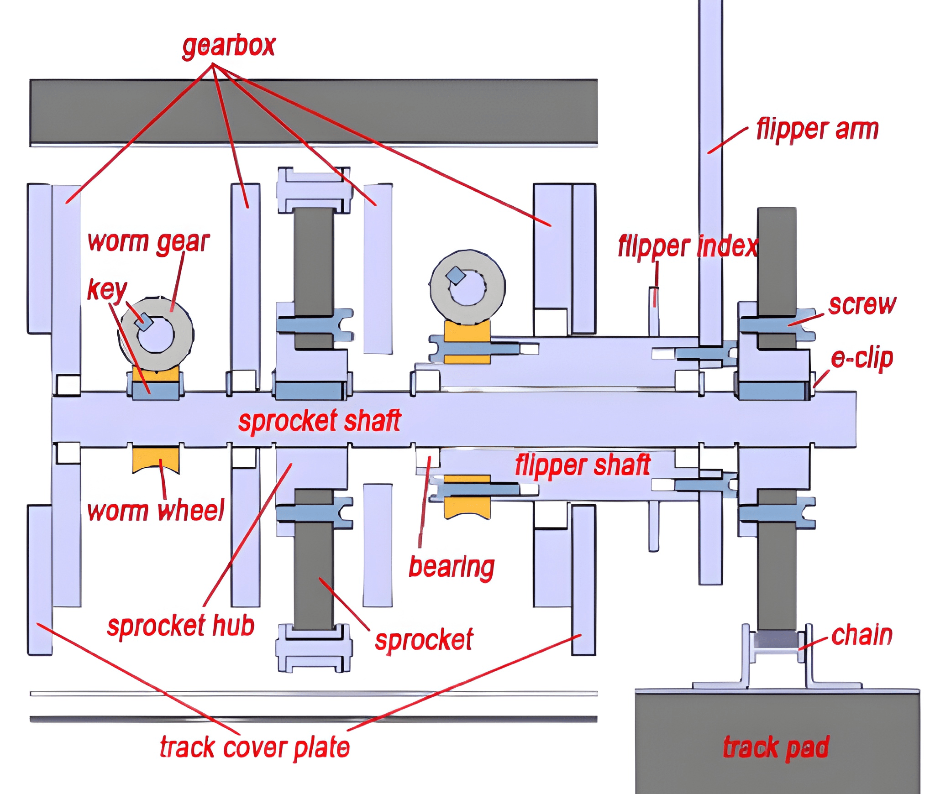
[picture p23: TeX/media/plasmaCS.png]
    
    \caption{Τομή συστήματος κίνησης Plasma RX \cite{plasmaRX19}.}
    \label{fig:plasmaCS}
\end{figure}

\subsubsection{Πρώτη εκδοχή πλατφόρμας V.L.A.D.}
Ακολουθώντας τη σχεδιαστική λογική της παραπάνω πλατφόρμας, το πρώτο πράγμα που πρέπει να γίνει είναι ο σχεδιασμός των κομματιών που αποτελούν τη συναρμολογημένη διάταξη του συστήματος κίνησης. Οι αρχικές διαστάσεις των διαφόρων κομματιών προκύπτουν αυθαίρετα στην αρχή, τηρώντας τις προϋποθέσεις του σχεδιασμού στον \ref{tab:reqs}. Στη δεύτερη επανάληψη του ισοζυγίου μάζας θα προκύψουν πιο συγκεκριμένες και στοχευμένες διαστάσεις με γνώμονα που θα αναλυθεί παρακάτω. Στο πρώτο ισοζύγιο μάζας θα περιλαμβάνονται, τα δύο συμμετρικά κιβώτια κίνησης με τα επιμέρους κομμάτια και το σώμα της πλατφόρμας. Δε θα περιλαμβάνονται δηλαδή οι διαμορφώσεις για τον αποθηκευτικό χώρο του διασώστη αλλά και τα ηλεκτρονικά του συστήματος.

\begin{figure}[H]
    \centering
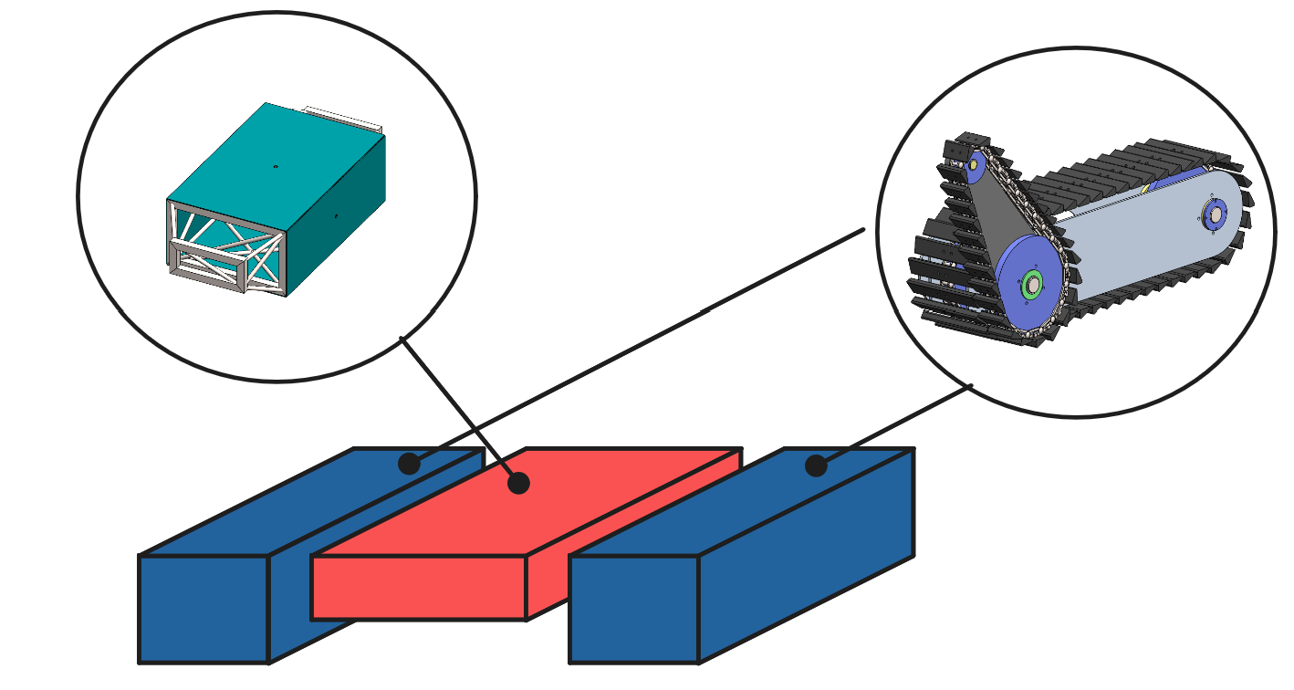
[picture p24: TeX/media/draftidea.png]
    
    \caption{Αρχική γεωμετρία για τη πρώτη επανάληψη του ισοζυγίου μάζας.}
    \label{fig:draftidea}
\end{figure}

\par Ξεκινώντας με το σκαρίφημα της συναρμολογημένης, θα γίνουν έπειτα και τα τρισδιάστατα σχέδια του κάθε στοιχείου του μηχανισμού. Το σκαρίφημα φαίνεται στο \ref{fig:skar} και όπως παρατηρείται ακολουθεί πιστά τη πλατφόρμα του Plasma RX με ορισμένες αλλαγές. Οι αλλαγές αυτές αφορούν τον πιο ορθό ορισμό των εδράσεων.

\begin{figure}[H]
    \centering
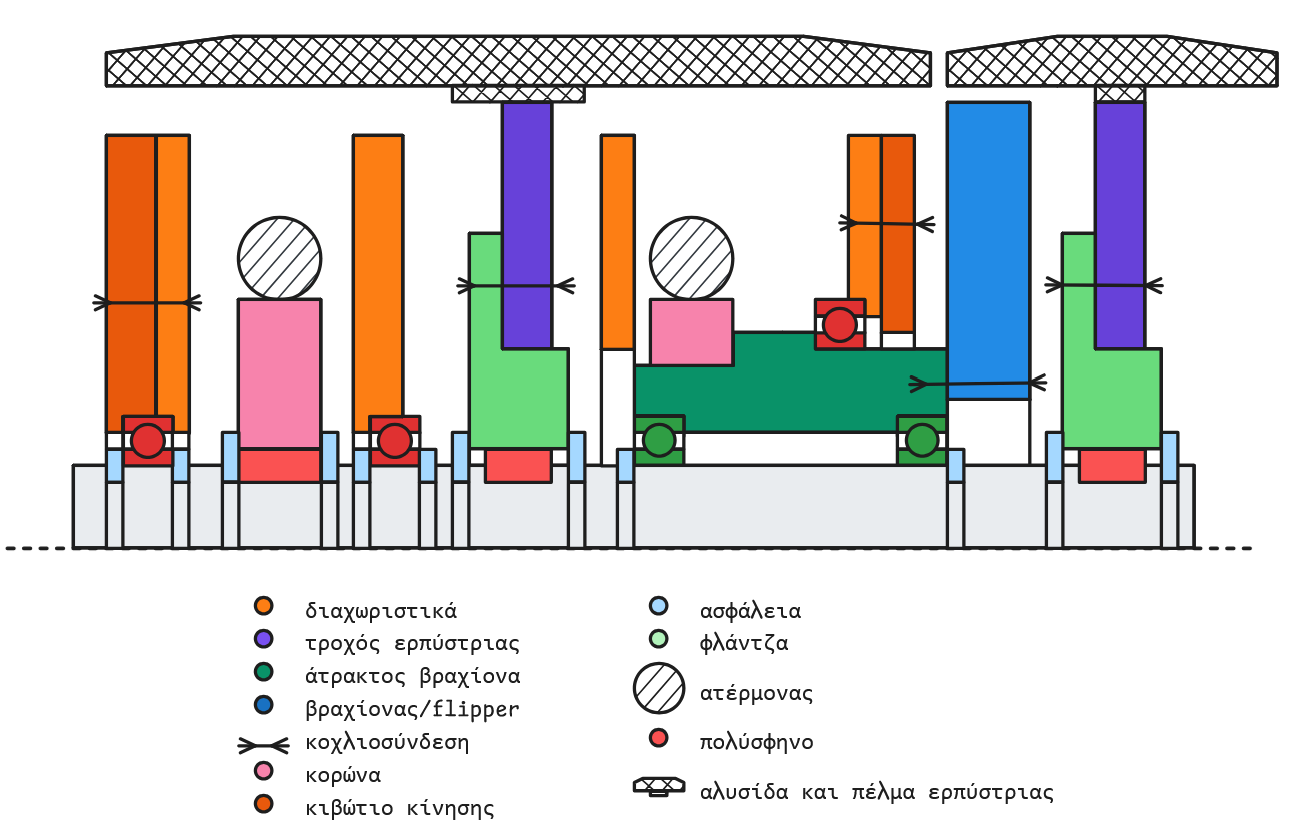
[picture p25: TeX/media/skar.png]
    
    \caption{Αρχικό σκαρίφημα κιβωτίο κίνησης.}
    \label{fig:skar}
\end{figure}

Στο παραπάνω σκαρίφημα, διακρίνονται όλα τα στοιχεία του μηχανισμού. Τα διαχωριστικά και το κιβώτιο κίνησης συνδέονται με κοχλίες καθώς και με στιβαρή πλάκα. Επομένως, αυτό είναι το στιβαρό κομμάτι του μηχανισμού. Η σταθερή έδραση γίνεται στα αριστερά, δηλαδή πιο κοντά στο σώμα της πλατφόρμας. Στο αρχικό σκαρίφημα υπάρχουν αρκετές εκρεμμότητες αλλά αυτές θα διορθωθούν κατά τη δεύτερη επανάληψη. Το πρώτο αυτό στάδιο χρησιμεύει στη πλαισίωση της ιδέας και στο να δημιουργήσει το αρχικό έναυσμα για τη δημιουργία των τρισδιάστατων αρχείων CAD των κομματιών αλλά και της συναρμολογημένης διάταξης του μηχανισμού.

\par Αρχικά, γίνεται ο σχεδιασμός της κύριας ατράκτου. Θα χρησιμοποιηθούν ασφάλειες για τη τοποθέτηση όλων των στοιχείων και αυτό θα αναθεωρηθεί αργότερα. Η αρχική διάμετρος της ατράκτου επιλέγεται στα $20\;mm$. Δημιουργούνται όλα τα απαραίτητα διάκενα για τη τοποθέτηση των ασφαλειών και τη σταθεροποίηση των λοιπών στοιχείων. Επίσης, δημιουργούνται και τυφλές οπές για τη χρήση πολύσφηνου για τη μεταφορά της ροπής από την κύρια άτρακτο στους τροχούς των ερπυστριών. Θα σχεδιαστούν δύο συμμετρικά κιβώτια κίνησης που θα αποτελούνται από όλα τα επιμέρους στοιχεία κίνησης και τους κινητήρες. Όλα τα στοιχεία κίνησης θα αναφέρονται από εδώ και πέρα για τη πρώτη εκδοχή του σχεδιασμού ως \textbf{v1} (version 1).
\begin{figure}[H]
    \centering
    \begin{subfigure}{0.45\linewidth}
        \centering
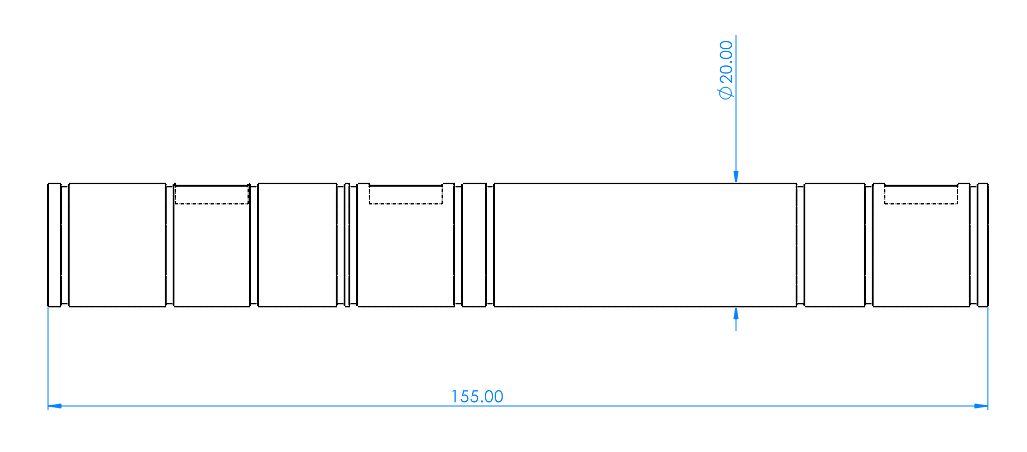
[picture p26: TeX/media/shaftMech1.png]
        
        \caption{Διαστάσεις της κύριας ατράκτου \textit{v1}.}
        \label{fig:shaftMech1}
    \end{subfigure}
    \hfill
    \begin{subfigure}{0.45\linewidth}
        \centering
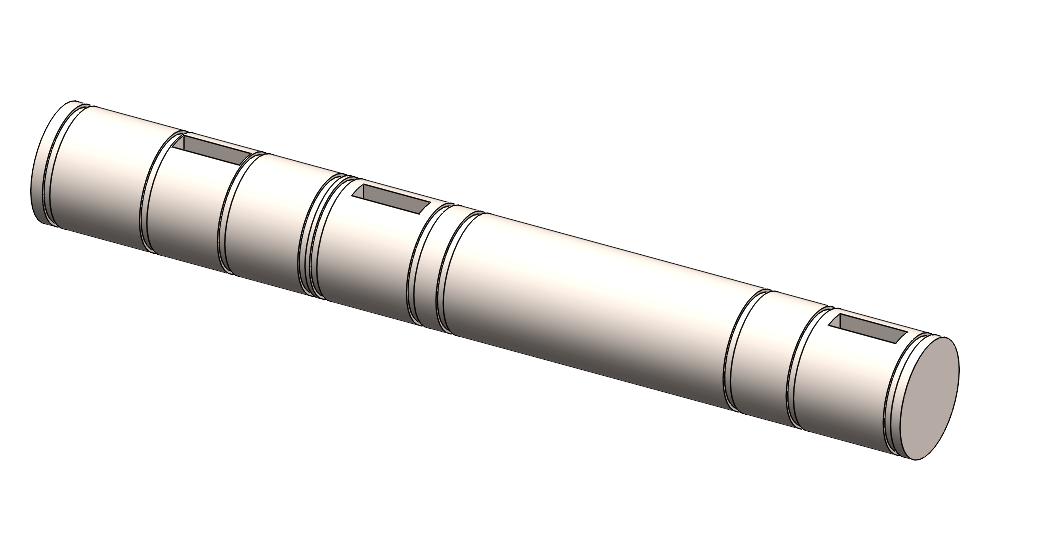
[picture p27: TeX/media/shaftTri1.png]
        
        \caption{Τριμετρική όψη κύριας ατράκτου \textit{v1}.}
        \label{fig:shaftTri1}
    \end{subfigure}
    \caption{Τρισδιάστατο σχέδιο κύριας ατράκτου \textit{v1}.}
    \label{fig:shaftv1}
\end{figure}
Έπειτα θα δημιουργηθεί ο βραχίονας (flipper) καθώς και η άτρακτος του βραχίονα (μανίκι). Το μανίκι θα πρέπει να εδράζεται στην κύρια άτρακτο κίνησης. Τα έδρανα κύλισης πρέπει εφαρμόζουν σε εσωτερική διάμετρο $20\; mm$. Όλα τα έδρανα κύλισης θα επιλεχθούν από τον επίσημο ιστότοπο της SKF Bearings. Οι ασφάλειες και τα λοιπά στοιχεία επιλέγονται από τον επίσημο ιστότοπο της McMaster Carr. Ο βραχίονας παρατηρείται παρακάτω.

\begin{figure}[H]
    \centering
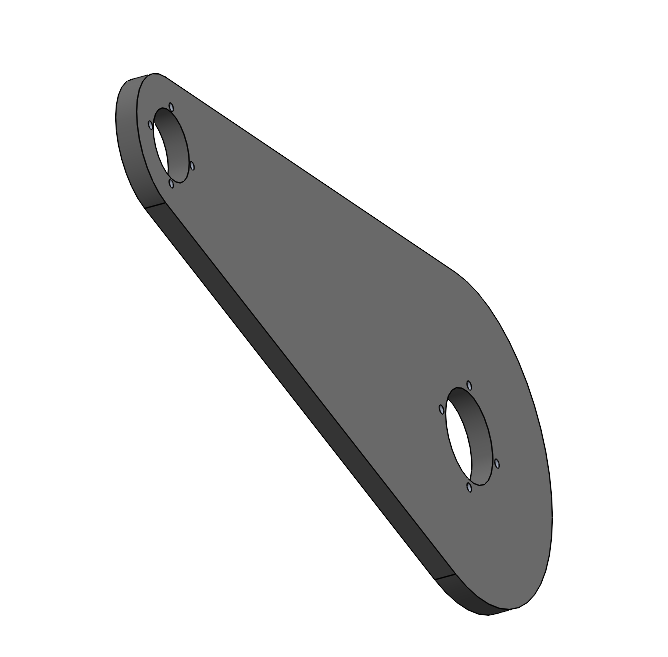
[picture p28: TeX/media/flipperv1.png]
    
    \caption{Περιστρεφόμενος βραχίονας \textit{v1}.}
    \label{fig:flipperv1}
\end{figure}

Αυθαίρετα επιλέγονται τα έδρανα που φαίνονται στον \ref{tab:bearings} για το σύστημα. Με βάση αυτές τις διαστάσεις σχεδιάζεται και η άτρακτος του βραχίονα καθώς και τα λοιπά μηχανολογικά στοιχεία. Ο τροχός της ερπύστριας επιλέγεται με διάμετρο αρκούντως μεγάλη για να προσφέρει ανοχή μεταξύ της αλυσίδας της ερπύστριας και του κιβωτίου κίνησης.
\begin{table}[H]
    \centering
    \rowcolors{2}{gray}{white}
        \begin{tabular}{|c|c|c|}
        \hline
        \rowcolor{Dandelion}
        Bearing & Specification & Usage\\
        \hline
        w61704 & 20x27x4 mm & Σταθερή έδραση κύριας ατράκτου και έδραση διαχωριστικού\\
        \hline
        61804 & 20x32x7 mm & Εδράσεις ατράκτου βραχίονα\\
        \hline
        61809 & 45x58x7 mm & Έδραση κιβωτίου κίνησης\\
        \hline
        \end{tabular}
    \caption{Έδρανα κύλισης συστήματος κίνησης κύριας ερπύστριας και βραχίονα \textit{v1}.}
    \label{tab:bearings}
\end{table}

Παρακάτω φαίνεται η συναρμολογημένη του κιβωτίου με τα διαχωριστικά. Δύο συμμετρικά κιβώτια αποτελούν το σύστημα κίνησης της πλατφόρμας. Τα δύο αυτά κιβώτια θα συνδέονται με κοχλίες στο κεντρικό σώμα της πλατφόρμας. Το σώμα αυτό θα σχεδιασθεί για αρχή με συμβατικό τρόπο δημιουργείας σασί. Θα δημιουργηθεί δηλαδή δικτύωμα απο μεταλλικές μπάρες το οποίο θα περιβάλλεται απο μεταλλικές πλάκες. Αργότερα αυτό θα αναθεωρηθεί καθώς αποτελεί έναν παρχωχημένο, κοστοβόρο και μη αποδοτικό τρόπο σχεδιασμού.
\begin{figure}[H]
    \centering
    \begin{subfigure}{0.45\linewidth}
        \centering
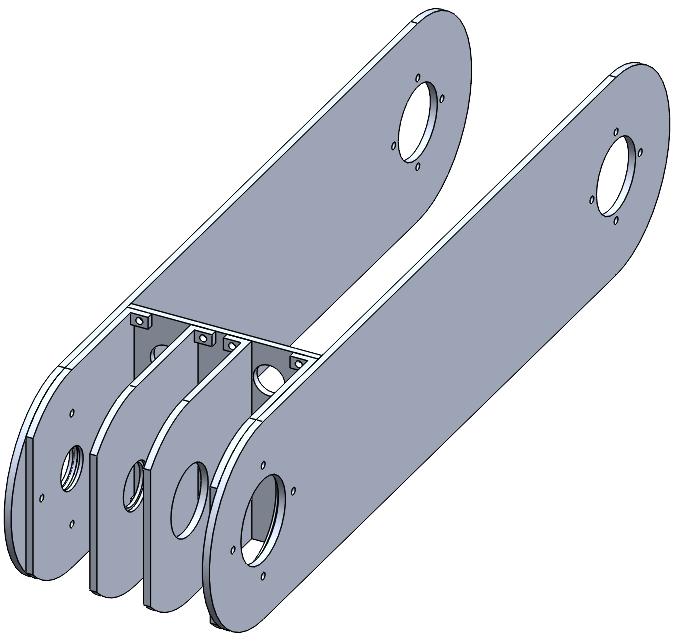
[picture p29: TeX/media/encv1.png]
        
        \caption{Κιβώτιο κίνησης \textit{v1}.}
        \label{fig:encv1}
    \end{subfigure}
    \hfill
    \begin{subfigure}{0.45\linewidth}
        \centering
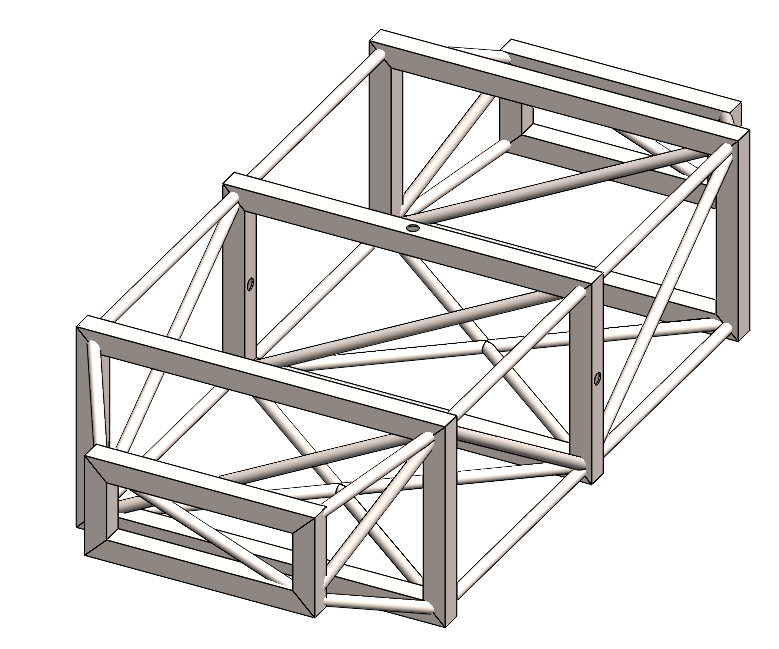
[picture p30: TeX/media/chasisv1.png]
        
        \caption{Δικτύωμα σώματος \textit{v1}.}
        \label{fig:chasisv1}
    \end{subfigure}
    \caption{Κιβώτιο κίνησης και σασί πλατφόρμας V.L.A.D. \textit{v1}.}
    \label{fig:encchasisv1}
\end{figure}

Όπως αναφέρθηκε, η ερπύστρια που θα χρησιμοποιηθεί θα αποτελείται από αρθρωτούς συνδέσμους και πέλματα αντί της ενιαίας χύτευσης. Συνολικά για τη γεωμετρία που προκύπτει για τη πλατφόρμα χρειάστηκαν 47 συναρμολογημένες διατάξεις συνδέσμου-πέλματος για τη κύρια ερπύστρια. Ενώ με μικρότερο πέλμα, χρειάστηκαν 29 σύνδεσμοι για τη δευτερεύουσα ερπύστρια του βραχίονα. Παρακάτω φαίνεται ο μεταλλικός αρθρωτός σύνδεσμος καθώς και η συναρμολόγηση με το πέλμα της ερπύστριας.
\begin{figure}[H]
    \centering
    \begin{subfigure}{0.45\linewidth}
        \centering
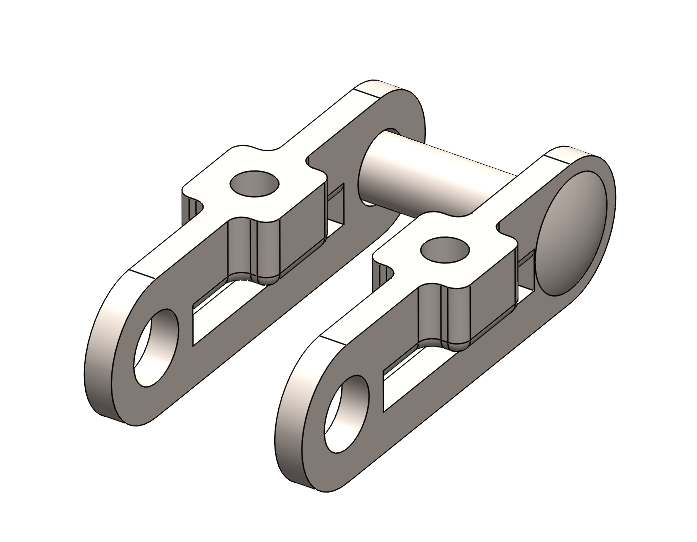
[picture p31: TeX/media/chainlinkv1.png]
        
        \caption{Αρθρωτός σύνδεσμος αλυσίδας ερπύστριας.}
        \label{fig:chainlinkv1}
    \end{subfigure}
    \hfill
    \begin{subfigure}{0.45\linewidth}
        \centering
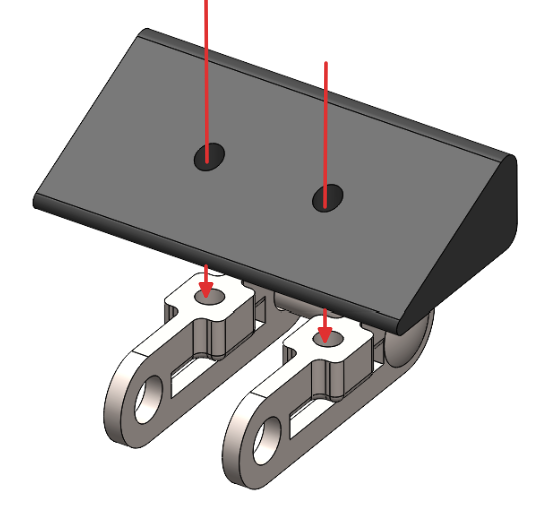
[picture p32: TeX/media/chainShoev1.png]
        
        \caption{Συναρμολόγηση συνδέσμου-πέλματος ερπύστριας.}
        \label{fig:chainShoev1}
    \end{subfigure}
    \caption{Στοιχεία ερπύστριας \textit{v1}.}
    \label{fig:tracksv1}
\end{figure}

Αφού λοιπόν σχεδιαστούν όλα τα τρισδιάστατα αρχεία των επιμέρους στοιχείων που αποτελούν τη πλατφόρμα, δημιουργείται και η ολική συναρμολογημένη διάταξη σε τρισδιάστατη μορφή. Περιορίζονται οι κατάλληλοι βαθμοί ελευθερίας με τη χρήση mates/joints, ενώ επιτρέπεται η περιστροφή των συνδέσμων της ερπύστριας αλλά και των βραχιόνων για καλύτερη οπτικοποίηση του μηχανισμού και των ανοχών του συστήματος. Η συναρμολογημένη φαίνεται παρακάτω.

\begin{figure}[H]
    \centering
    \begin{subfigure}{0.3\linewidth}
        \centering
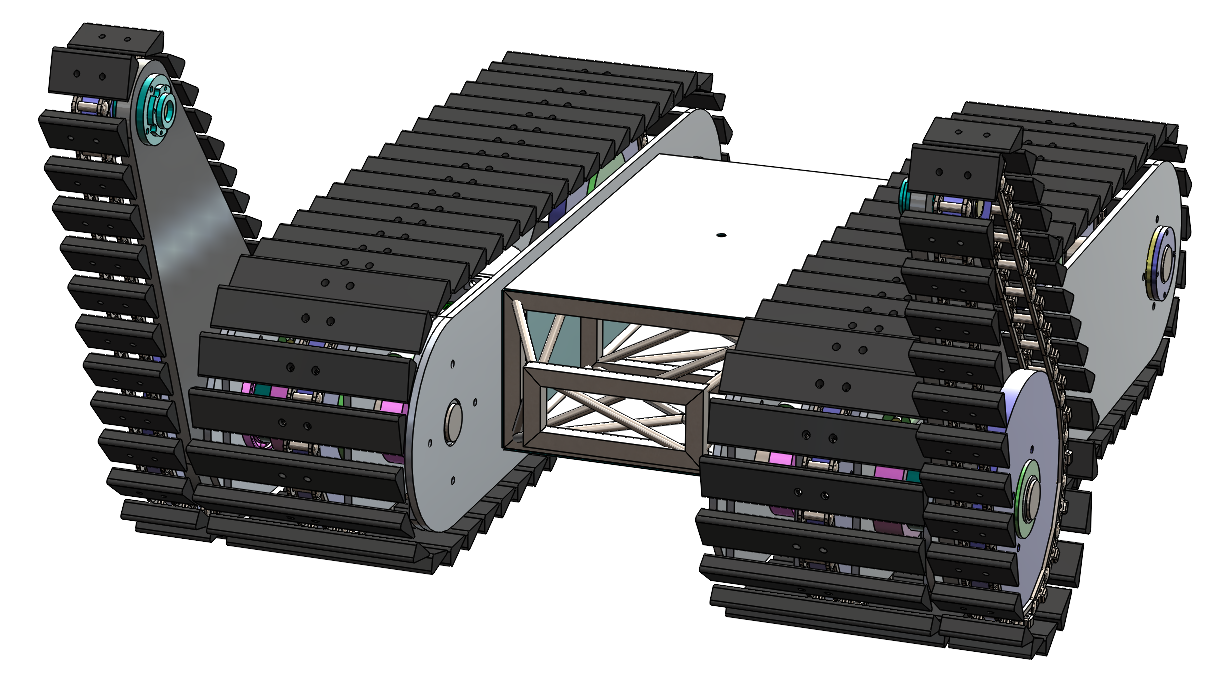
[picture p33: TeX/media/v11.png]
        
        \caption{Εμπρόσθια διμετρική όψη.}
        \label{fig:v11}
    \end{subfigure}
    \hfill
    \begin{subfigure}{0.3\linewidth}
        \centering
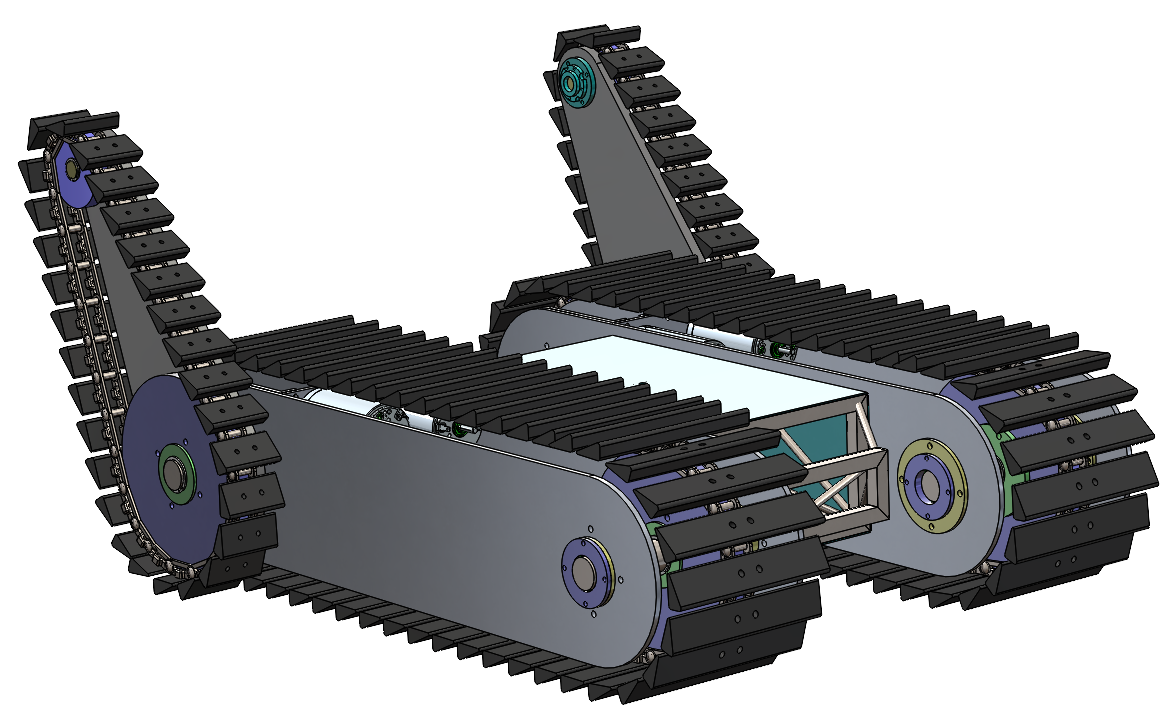
[picture p34: TeX/media/v12.png]
        
        \caption{Οπίσθια διμετρική όψη.}
        \label{fig:v12}
    \end{subfigure}
    \hfill
    \begin{subfigure}{0.3\linewidth}
        \centering
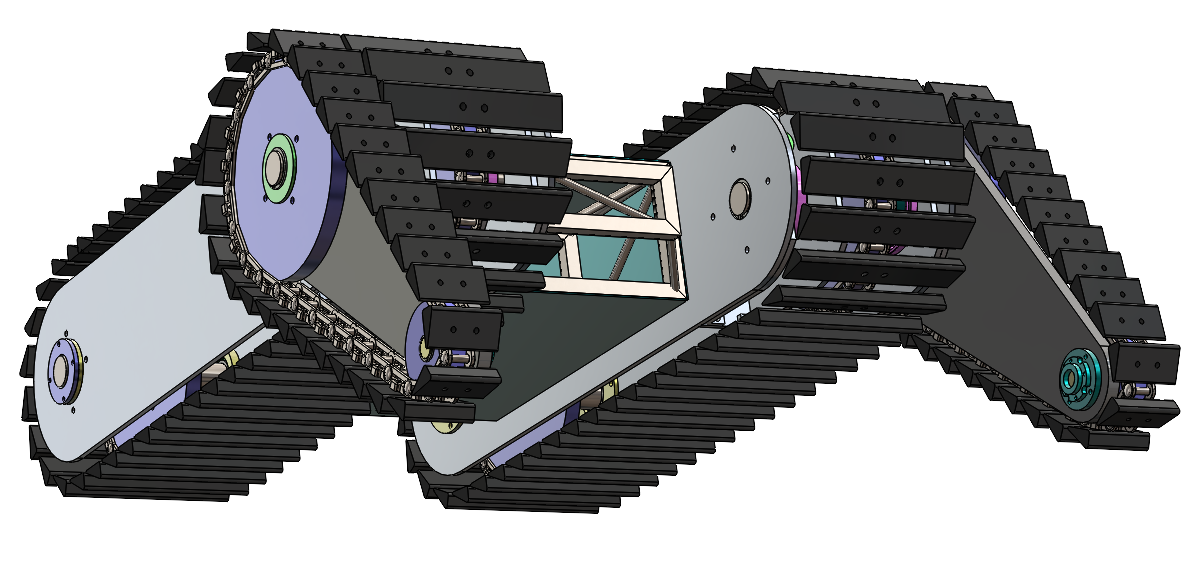
[picture p35: TeX/media/v13.png]
        
        \caption{Κάτω διμετρική όψη.}
        \label{fig:v13}
    \end{subfigure}
    \caption{Πρώτη εκδοχή της συναρμολογημένης πλατφόρμας V.L.A.D.}
    \label{fig:assv1}
\end{figure}

\begin{figure}[H]
    \centering
    \begin{subfigure}{0.45\linewidth}
        \centering
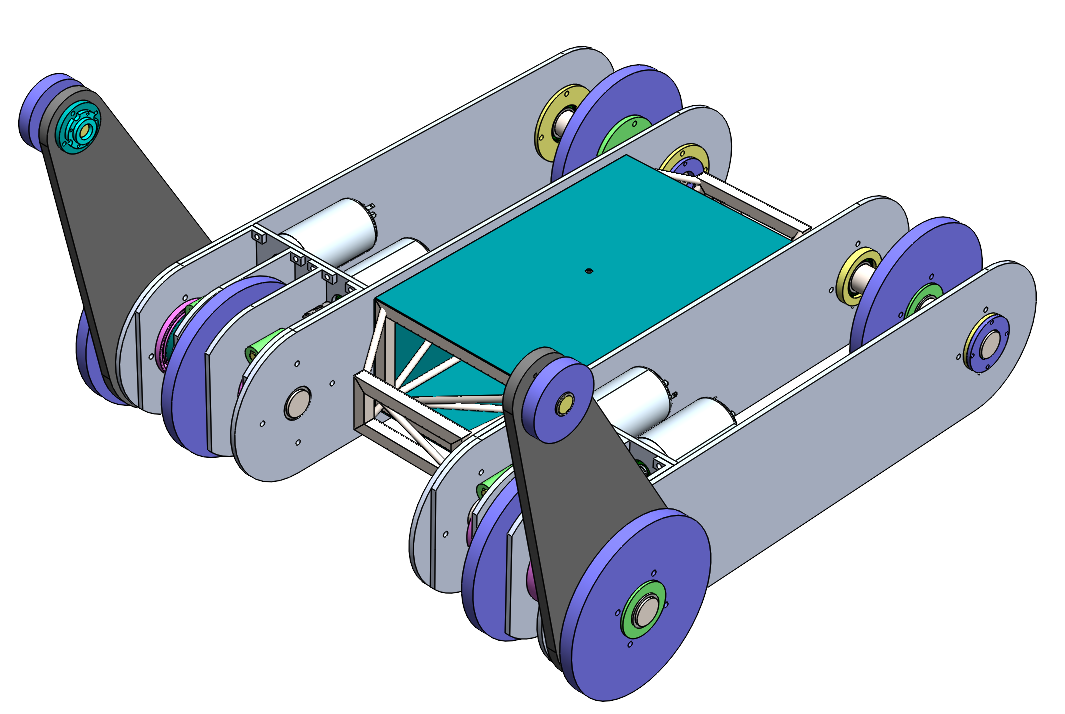
[picture p36: TeX/media/v14.png]
        
        \caption{Τριμετρική όψη.}
        \label{fig:v14}
    \end{subfigure}
    \hfill
    \begin{subfigure}{0.45\linewidth}
        \centering
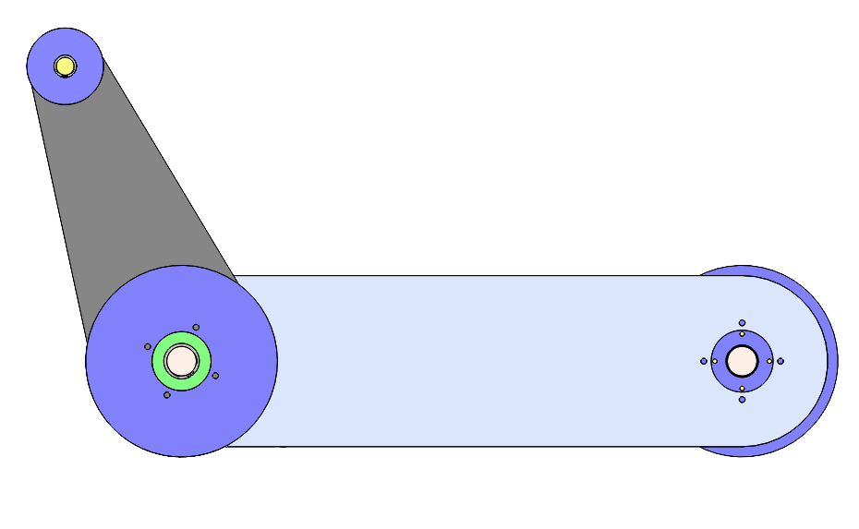
[picture p37: TeX/media/v15.png]
        
        \caption{Πλάγια όψη.}
        \label{fig:v15}
    \end{subfigure}
    \caption{Πρώτη εκδοχή συναρμολογημένου διασώστη, δίχως τη παρουσία των ερπυστρίων.}
    \label{fig:assv1NOTRACK}
\end{figure}

Παρακάτω επίσης παρατηρούνται μερικές απεικονίσεις του V.L.A.D. κατά μερικά σενάρια λειτουργίας. Πιο συγκεκριμένα, οι αναδιπλωμένοι βραχίονες (retracted flippers) σε γωνία $0^\circ$ σε σχέση με τον άξονα κατά το μήκος του ρομπότ, βοηθούν στην εξοικονόμιση χώρου και τη μείωση του ενεργού μήκος της πλατφόρμας. Αυτό καθίσταται ιδιαίτερα χρήσιμο κατά τη διέλευση από στενά περάσματα. Έπειτα, οι ανασηκωμένοι βραχίονες κατά $90^\circ$, χρησιμοποιούνται κατά την καθοδική πορεία του διασώστη καθώς προσφέρουν τη μεγαλύτερη δυνατή τριβή λόγω της μικρότερης δυνατής επιφάνειας επαφής της δευτερεύουσας ερπύστριας με το έδαφος. Τέλος, οι εκτεταμένοι βραχίονες, ή αλλιώς οι βραχίονες σε γωνία $180^\circ$, προσφέρουν τη μέγιστη δυνατή τριβή αλλά και ενεργό επιφάνεια επαφής που τους καθιστά ιδιαίτερα χρήσιμους κατά την κίνηση σε κεκλιμένο επίπεδα και την αποφυγή ανατροπής της πλατφόρμας.

\begin{figure}[H]
    \centering
    \begin{subfigure}{0.3\linewidth}
        \centering
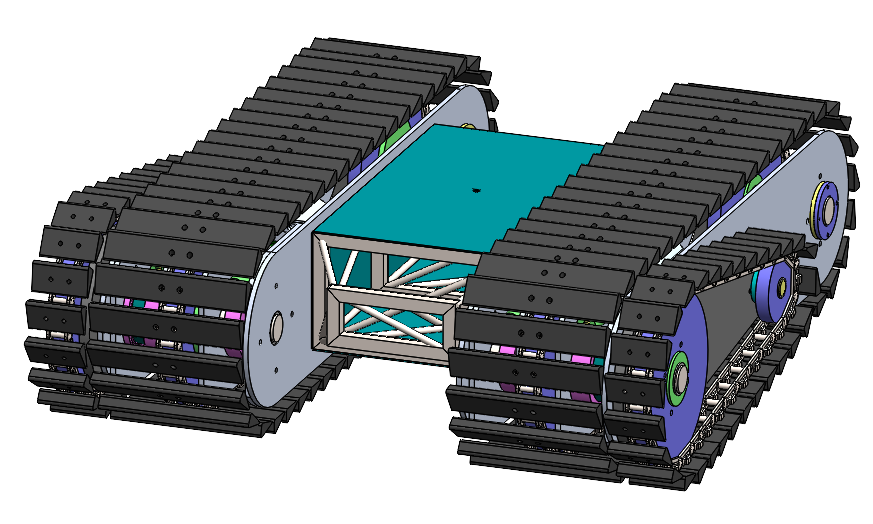
[picture p38: TeX/media/v16.png]
        
        \caption{Αναδιπλωμένοι βραχίονες για εξοικονόμηση χώρου.}
        \label{fig:v16}
    \end{subfigure}
    \hfill
    \begin{subfigure}{0.3\linewidth}
        \centering
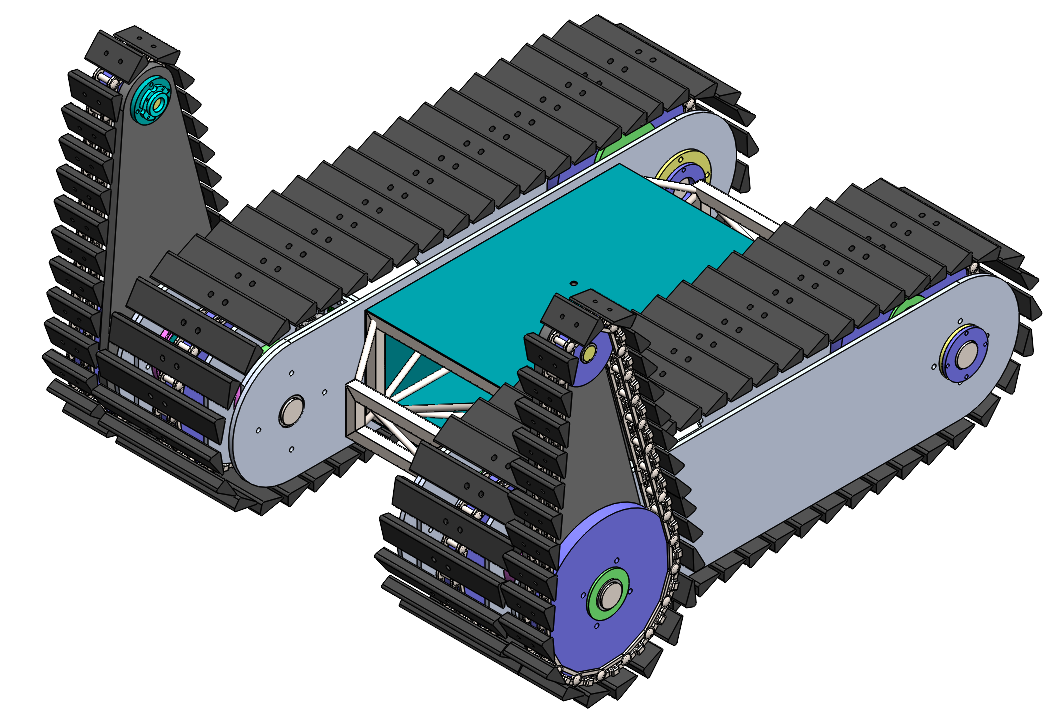
[picture p39: TeX/media/v17.png]
        
        \caption{Ανασηκωμένοι βραχίονες σε γωνία $90^\circ$ για κανονική πορεία σε ευθεία.}
        \label{fig:v17}
    \end{subfigure}
    \hfill
    \begin{subfigure}{0.3\linewidth}
        \centering
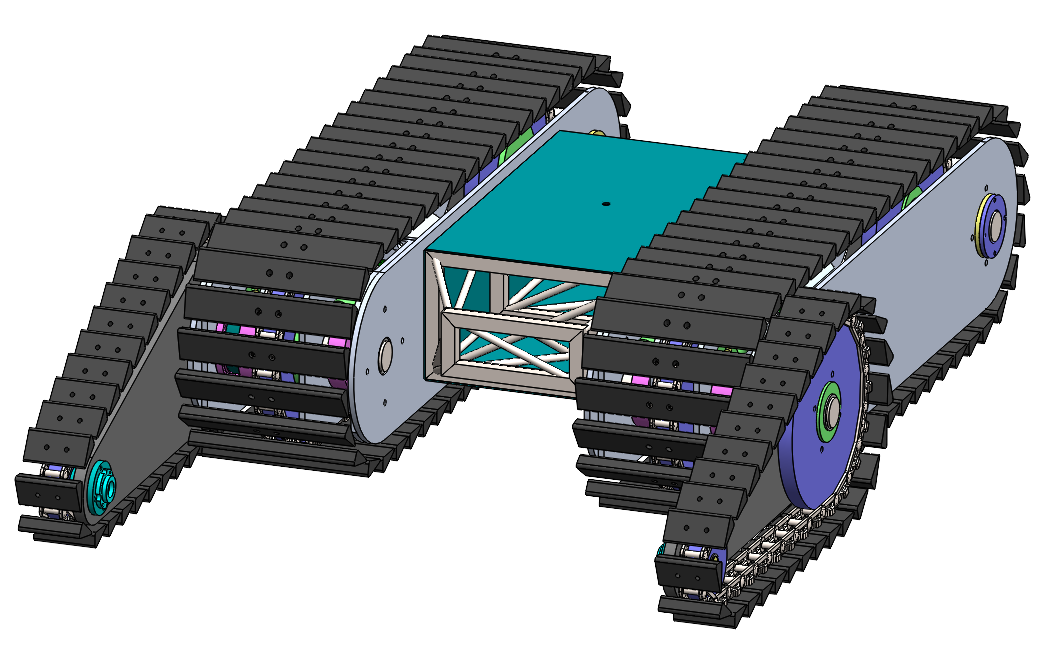
[picture p40: TeX/media/v18.png]
        
        \caption{Εκτεταμένοι βραχίονες για κίνηση σε κεκλιμένο.}
        \label{fig:v18}
    \end{subfigure}
    \caption{Σενάρια κίνησης πρώτης εκδοχής πλατφόρμας V.L.A.D.}
    \label{fig:assv1MOVE}
\end{figure}

\subsubsection{Επιλογή υλικών και πρώτη εκδοχή ισοζύγιου μάζας}
Όσο αναφορά τα υλικά των επιμέρους κομματιών του διασώστη. Αυτά επιλέγονται με γνώμονα τη μείωση του συνολικού βάρους της παλτφόρμας. Με βάση αυτό, για κάθε τεμάχιο, \textbf{εκτός των πελμάτων και των αρθρωτών συνδέσμων της ερπύστριας και όλων των ατράκτων}, επιλέγεται το αλουμίνιο ως υλικό κατασκευής. Πιο συγκεκριμένα επιλέγεται το υλικό \textit{2024 T4}, για τον υψηλό λόγο μέτρου ελαστικότητας προς πυκνότητα υλικού που διαθέτει, καθιστόντας το ιδανικό για τη μείωση του συνολικού βάρους της κατασκευής χωρίς να περιορίζεται η αντοχή της. Για τα υπόλοιπα μεταλλικά κομμάτια, δηλαδή για τις ατράκτους και τους συνδέσμους, επιλέγεται ο απλός κατασκευαστικός χάλυβας λόγω του μεγάλου μέτρου ελαστικότητας του υλικού και καθώς αυτό το υλικό συνηθίζεται για τη κατασκευή των συγκεκριμένων μηχανολογικών στοιχείων. Τέλος, τα πέλματα της ερπύστριας κατασκευάζονται από ελαστικό υλικό για την αποφυγή της ολίσθησης της πλατφόρμας κατά την εκκίνηση της περιστροφής των τροχών της ερπύστριας.
\par Ο υπολογισμός της μάζας του κάθε επιμέρους στοιχείου γίνεται μέσω του ίδιου λογισμικού σχεδίασης CAD (SOLIDWORKS) και του built-in εργαλείου του. Επίσης, στο ισοζύγιο πρέπει να συνυπολογιστούν και τα βάρη των:
\begin{itemize}
    \item κινητήρων
    \item ηλεκτρονικών
    \item λοιπών μηχανολογικών στοιχείων
    \item payload
\end{itemize}

Το payload (φορτίο μεταφοράς), αναφέρεται στο φορτίο πρώτων βοηθειών που θα μεταφέρει ο διασώστης. Το φορτίο αυτό θα πρέπει να μη ξεπερνάει τα $5\;kg$ σύμφωνα με τον \ref{tab:reqs}. Στο ισοζύγιο θα ληφθεί υπόψη η μέγιστη τιμή του payload, δηλαδή αυτή των πέντε κιλών. Αναφορικά με τα παρελκόμενα μηχανολογικά στοιχεία και τα υλικά σύνδεσης (κοχλίες, περικόχλια, ασφάλειες κ.ά.), διενεργήθηκε μια συντηρητική εκτίμηση της μάζας τους, ενσωματώνοντας σημαντικό περιθώριο ασφαλείας. Η προσέγγιση αυτή στοχεύει στην αύξηση του συνολικού υπολογιζόμενου βάρους στο ισοζύγιο μάζας, ώστε να διασφαλιστεί η εγκυρότητα της μελέτης βάσει της αρχής σχεδιασμού για το δυσμενέστερο σενάριο (worst-case scenario).
\par Όσον αφορά τον υπολογισμό της συνολικής μάζας των ηλεκτρονικών ελήφθησαν υπόψη οι τεχνικές προδιαγραφές αντίστοιχων εμπορικά διαθέσιμων αισθητήρων. Παράλληλα, για την ενεργειακή μονάδα του ρομπότ, διενεργήθηκε αναλυτική εκτίμηση βάρους. Θεωρώντας ότι η μπαταρία της πλατφόρμας συγκροτείται από συγκεκριμένο πλήθος στοιχείων λιθίου τύπου 18650, η συνολική μάζα υπολογίζεται αθροιστικά, λαμβάνοντας υπόψη την τυπική μάζα εκάστου στοιχείου. Η σχεδίαση της συστοιχίας περιλαμβάνει συνδεσμολογία σε σειρά για την επίτευξη της απαιτούμενης τάσης λειτουργίας, καθώς και παράλληλη σύνδεση για την αύξηση της χωρητικότητας και κατ' επέκταση της αυτονομίας του συστήματος. Θεωρώντας περίπου 40 τέτοια στοιχεία και με μάζα $50\; g$ έκαστο, υπολογίζεται η συνολική μάζας της μπαταρίας στα $2\; kg$.
\par Τέλος, σχετικά με τους κινητήρες, επιλέγονται εμπορικά διαθέσιμοι κινητήρες συνεχούς ρεύματος. Οι κινητήρες αυτοί λειτουργούν ως place-holders, προσδίδουν δηλαδή την πιο ολοκληρωμένη γεωμετρική απεικόνιση του διασώστη χωρίς να έχει διερευνηθεί εάν μπορούν να υποστηρίξουν την πλατφόρμα με την απαραίτητη ροπή κίνησης. Αργότερα, αφού ολοκληρωθεί το ισοζύγιο μάζας θα υπολογισθούν πολύ πιο αναλυτικά οι απαιτήσεις των κινητήρων για το σύστημα.
\par Οι κινητήρες εδώ εφαρμόζουν στην πλάκα σύνδεσης των διαχωριστικών πλακών και πακτώνονται σε αυτήν μέσω των ιδίων εσωτερικών σπειρωμάτων που φέρουν στην εμπρόσθια επιφάνεια του κελύφους του κινητήρα. Ο κινητήρας έπειτα συνδέεται μέσω ενός εύκαμπτου συνδέσμου αξόνων, με τον ατέρμονα κοχλία. Ο σύνδεσμος αυτός, διαθέτει ελικοειδή χάραξη στο σώμα του που το βοηθάει να δρα ως ελατήριο, με αποτέλεσμα να απορροφάει κραδασμούς και να διορθώνει σφάλματα παράλληλων και γωνιακών αποκλίσεων. Οι απαραίτητες εδράσεις (μία μετά τον εύκαμπτο σύνδεσμο και μία μετά τον ατέρμονα) δε θα σχεδιασθούν για αυτό το πρώτο στάδιο του ισοζυγίου αλλά θα αναλυθούν μετέπειτα.

\begin{figure}[H]
    \centering
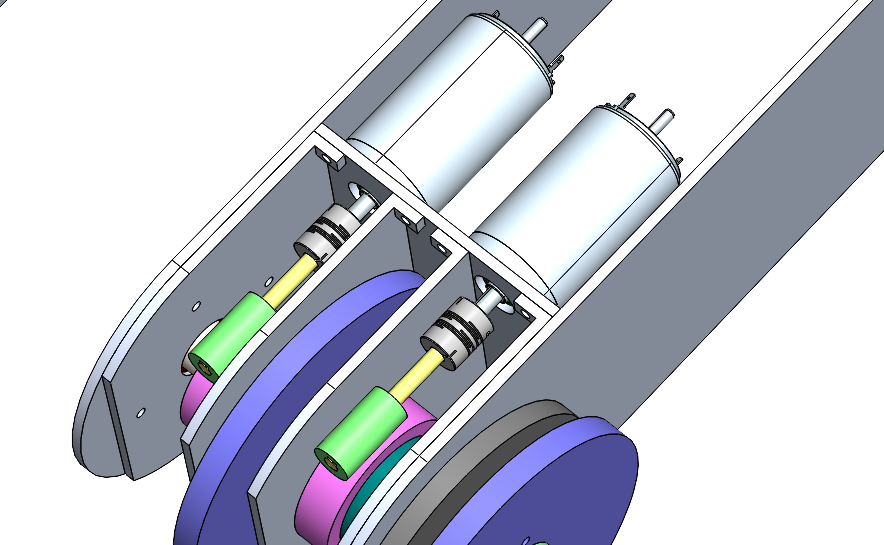
[picture p41: TeX/media/motorMount.png]
    
    \caption{Συνδεσμολογία κινητήρα και ατέρμονα κοχλία.}
    \label{fig:motorMount}
\end{figure}

\par Παρακάτω στο \ref{fig:bomv1} φαίνεται η τομή της συναρμολογημένης διάταξης του κύριου συστήματος κίνησης και του δευτερεύων συστήματος κίνησης. Σχετικά με το δευτερεύων σύστημα κίνησης, αυτό πρέπει να φέρει άτρακτο με ελεύθερη περιστροφή η οποία στηρίζει και τον δευτερεύων τροχό της εξωτερικής ερπύστριας του βραχίονα. Εδώ, οι ασφάλειες είναι πρόχειρα τοποθετημένες για την εξακρίβωση της γεωμετρίας του συστήματος.
\begin{figure}[H]
    \centering
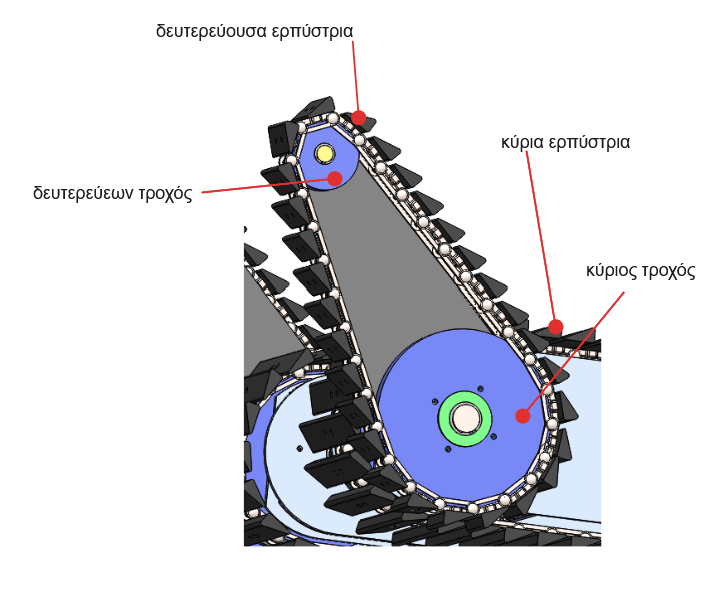
[picture p42: TeX/media/secTrack.png]
    
    \caption{Δευτερεύων σύστημα κίνησης πλατφόρμας.}
    \label{fig:secTrack}
\end{figure}

Η διάμετρος της δευτερεύουσας ατράκτου εκλέγεται $10\; mm$ και με βάση αυτήν επιλέγονται τα έδρανα κύλισης 61800 με διαστάσεις 10x19x5 mm. Σχεδιάεται και πλήμνη για την έδραση της ατράκτου στον βραχίονα ενώ ο τρόπος μεταφοράς ροπής από την δευτερεύουσα άτρακτο στον τροχό κρίνεται δίχως ενδιαφέρον για το συγκεκριμένο στάδιο του σχεδιασμού και θα αναλυθεί εκτενέστερα παρακάτω.
\par Τέλος, διακρίνονται και εξαρτήματα της οπίσθιας σύνδεσης, όπου η άτρακτος εδράζεται στο σώμα του κιβωτίου κίνησης και περιστρέφεται μέσω του οπίσθιου τροχού της κύριας ερπύστριας.
\newpage

\begin{figure}[H]
    \centering
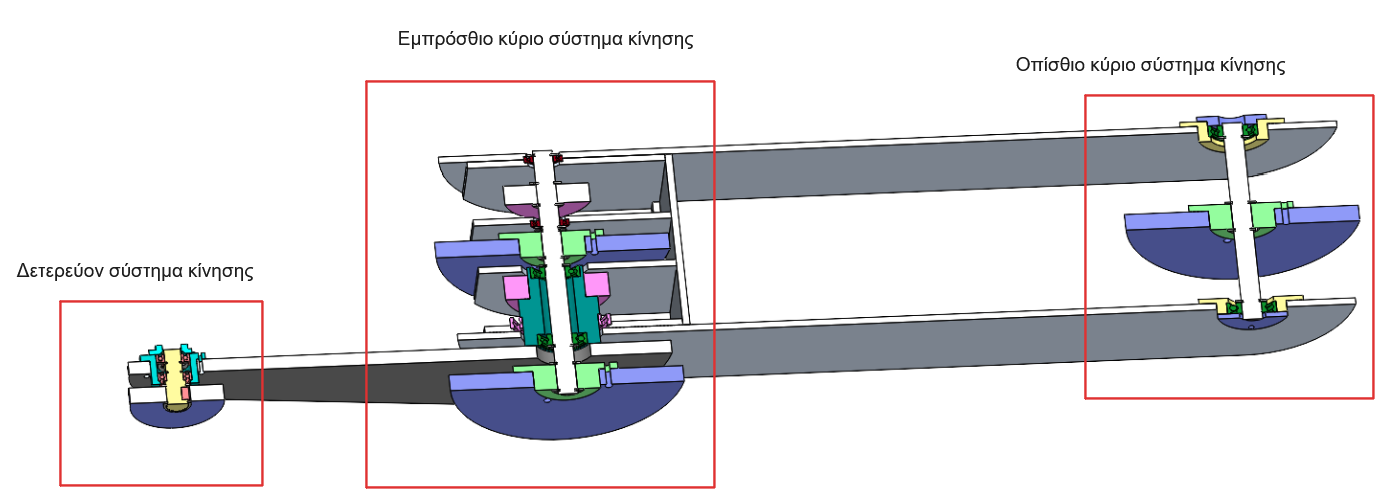
[picture p43: TeX/media/systKin.png]
    
    \caption{Διάκριση υποσυστημάτων κίνησης.}
    \label{fig:systKin}
\end{figure}

\begin{figure}[H]
    \centering
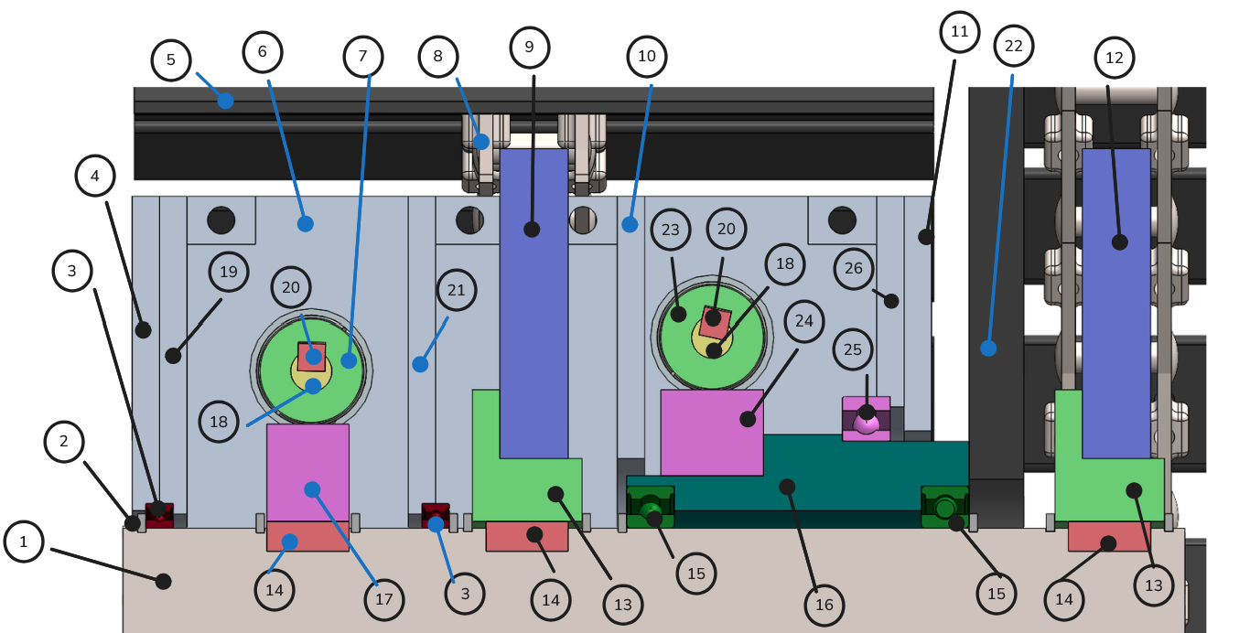
[picture p44: TeX/media/bomv1.png]
    
    \caption{Τομή συναρμολογημένης διάταξης κύριου συστήματος κίνησης \textit{v1}.}
    \label{fig:bomv1}
\end{figure}

\begin{figure}[H]
    \centering
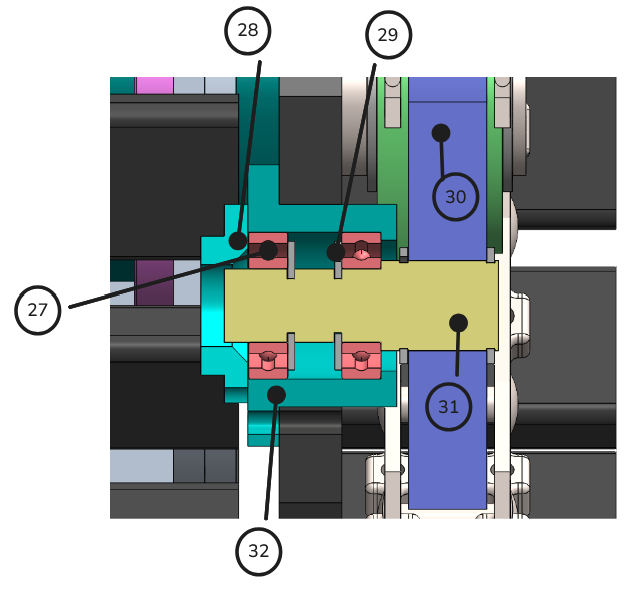
[picture p45: TeX/media/bomsmallV1.png]
    
    \caption{Τομή συναρμολογημένης διάταξης δευτερεύοντος συστήματος κίνησης \textit{v1}.}
    \label{fig:bomsmallV1}
\end{figure}

\begin{figure}[H]
    \centering
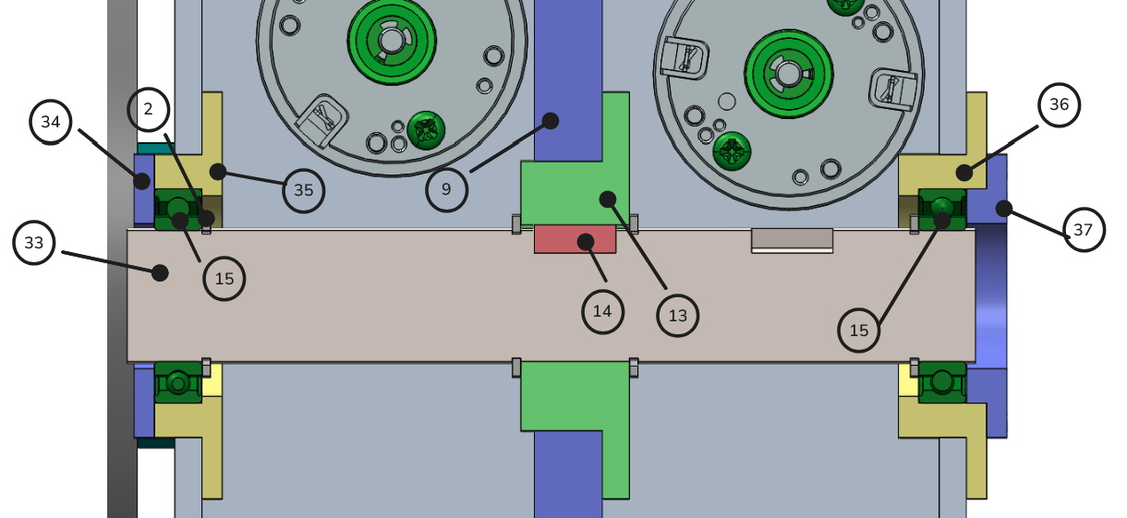
[picture p46: TeX/media/bombackV1.png]
    
    \caption{Τομή συναρμολογημένης διάταξης οπίσθιας ατράκτου κύριου συστήματος κίνησης \textit{v1}.}
    \label{fig:bombackV1}
\end{figure}

\begin{table}[H]
    \centering
    \rowcolors{2}{gray}{white}
        \begin{tabular}{|c|l|}
       \hline
       \rowcolor{Dandelion}
       Part ID & Description\\
       \hline
MOB-01 & Κύρια άτρακτος \\
\hline
MOB-02 & Ασφάλεια ατράκτου\\
\hline
MOB-03 & SKF w61704\\
\hline
MOB-04 & Εσωτερικό καπάκι κιβωτίου κίνησης\\
\hline
MOB-05 & Πέλμα κύριας ερπύστριας\\
\hline
MOB-06 & Πλάκα ένωσης διαχωριστικών\\
\hline
MOB-07 & Ατέρμονας κύριας ερπύστριας\\
\hline
MOB-08 & Αρθρωτός σύνδεσμος ερπύστριας\\
\hline
MOB-09 & Τροχός κύριας ερπύστριας\\
\hline
MOB-10 & Διαχωριστική πλάκα\\
\hline
MOB-11 & Εξωτερικό καπάκι κιβωτίου κίνησης\\
\hline
MOB-12 & Κινητήριος τροχός δευτερεύουσας ερπύστριας (ίδιος με κύριας)\\
\hline
MOB-13 & Φλάντζα τροχού ερπύστριας\\
\hline
MOB-14 & Πολύσφηνο κύριας ατράκτου\\
\hline
MOB-15 & SKF 61804\\
\hline
MOB-16 & Άτρακτος περιστρεφόμενου βραχίονα\\
\hline
MOB-17 & Οδοντωτός τροχός κύριας ατράκτου\\
\hline
MOB-18 & Άξονας ατέρμονα κοχλία\\
\hline
MOB-19 & Πλάκα στήριξης εδράνου 1\\
\hline
MOB-20 & Πολύσφηνο ατράκτου ατέρμονα\\
\hline
MOB-21 & Πλάκα στήριξης εδράνου 2 \\
\hline
MOB-22 & Περιστρεφόμενος βραχίονας\\
\hline
MOB-23 & Ατέρμονας δευτερεύουσας ερπυστρίας\\
\hline
MOB-24 & Οδοντωτός τροχός ατράκτου βραχίονα\\
\hline
MOB-25 & SKF 61809\\
\hline
MOB-26 & Πλάκα στήριξης εδράνου 3\\
\hline
MOB-27 & SKF 61800\\
\hline
MOB-28 & Καπάκι πλήμνης βραχίονα\\
\hline
MOB-29 & Ασφάλεια ατράκτου\\
\hline
MOB-30 & Τροχός δευτερέυουσας ερπύστριας\\
\hline
MOB-31 & Δευτερεύουσα άτρακτος\\
\hline
MOB-32 & Πλήμνη στήριξης βραχίονα\\
\hline
MOB-33 & Οπίσθια κύρια άτρακτος\\
\hline
MOB-34 & Καπάκι πλήμνης κιβωτίου 1\\
\hline
MOB-35 & Πλήμνη στήριξης κιβωτίου κίνησης 1\\
\hline
MOB-36 & Πλήμνη στήριξης κιβωτίου κίνησης 2\\
\hline
MOB-37 & Καπάκι πλήμνης κιβωτίου 2\\
\hline
        \end{tabular}
    \caption{Λίστα εξαρτημάτων συστήματος κίνησης.}
    \label{tab:bom}
\end{table}

Από τις παραπάνω τομές διακρίνονται όλα τα επιμέρους στοιχεία του μηχανισμού του συστήματος κίνησης. Παρακάτω, στον \ref{tab:massBudgetV1} φαίνεται η πρώτη επανάληψη του ισοζυγίου μάζας με όλα τα εξαρτήματα συγκεντρωμένα. Στα λοιπά μηχανολογικά στοιχεία έχουν συμπεριληφθεί κοχλίες, περικόχλια, οι έυκαμπτοι σύνδεσμοι, ασφάλειες και γενικότερα, οποιδήποτε εξάρτημα δεν αναγράφεται ως διακριτή οντότητα στον πίνακα. Τα λοιπά ηλεκτρονικά, αναφέρονται στα καλώδια, connectors κ.λ.π. ενώ τα λοιπά εξαρτήματα στο σώμα αναφέρονται πάλι σε μηχανολογικά στοιχεία όπως εξαρτήματα σύνδεσης. Έχουν καταγραφεί μόνο οι αισθητήρες που έχουν σημαντική μάζα στοιχείου ενώ οι υπόλοιποι εξ αυτών έχουν ομαδοποιηθεί μέσω των λοιπών αισθητήρων. Τέλος, να σημειωθεί πως στο συγκεκριμένο στάδιο, ο ατέρμονας είναι κοινός στο σχεδιασμό και για τις δύο οδοντοκινήσεις.

\begin{table}[H]
    \centering
    \rowcolors{2}{gray}{white}
\begin{tabular}{|l|l|c|r|r|}
\hline
\rowcolor{Periwinkle}
\multicolumn{1}{|c|}{Part} & \multicolumn{1}{c|}{Material} & \multicolumn{1}{c|}{Qty} & \multicolumn{1}{c|}{Unit Mass (g)} & \multicolumn{1}{c|}{Total Mass (g)} \\
\hline
\rowcolor{YellowGreen}
\multicolumn{5}{|c|}{Mobility Subsystem} \\
\hline
Καπάκι πλήμνης κιβωτίου 1 & 2024 T4 & 2 & 8.15 & 16.3 \\
\hline
Καπάκι πλήμνης κιβωτίου 2 & 2024 T4 & 2 & 11.63 & 23.26 \\
\hline
Πλήμνη στήριξης κιβωτίου κίνησης 1 & 2024 T4 & 2 & 32.95 & 65.9 \\
\hline
Πλήμνη στήριξης κιβωτίου κίνησης 2 & 2024 T4 & 2 & 28.18 & 56.36 \\
\hline
Αρθρωτός σύνδεσμος ερπύστριας & Steel & 152 & 12.25 & 1862 \\
\hline
Πέλμα κύριας ερπύστριας & Rubber Natural & 94 & 16.64 & 1564.16 \\
\hline
Πέλμα δευτερεύουσας ερπυστρίας & Rubber Natural & 58 & 6.09 & 353.22 \\
\hline
Περιστρεφόμενος βραχίονας & 2024 T4 & 2 & 526.09 & 1052.18 \\
\hline
Άτρακτος περιστρεφόμενου βραχίονα & 2024 T4 & 2 & 109.54 & 219.08 \\
\hline
Πλάκα στήριξης εδράνου 1 & 2024 T4 & 2 & 130.42 & 260.84 \\
\hline
Πλάκα στήριξης εδράνου 2 & 2024 T4 & 2 & 131.62 & 263.24 \\
\hline
Πλάκα στήριξης εδράνου 3 & 2024 T4 & 2 & 108.22 & 216.44 \\
\hline
Διαχωριστική πλάκα & 2024 T4 & 2 & 122.7 & 245.4 \\
\hline
Πλάκα ένωσης διαχωριστικών & 2024 T4 & 2 & 133.23 & 266.46 \\
\hline
Πλήμνη στήριξης βραχίονα & 2024 T4 & 2 & 18.2 & 36.4 \\
\hline
Δευτερεύουσα άτρατκος & Steel & 2 & 23.82 & 47.64 \\
\hline
Καπάκι πλήμνης βραχίονα & 2024 T4 & 2 & 4.33 & 8.66 \\
\hline
Τροχός δευτερεύουσας ερπύστριας & 2024 T4 & 2 & 55.7 & 111.4 \\
\hline
Τροχός κύριας ερπύστριας & 2024 T4 & 6 & 332.66 & 1995.96 \\
\hline
Φλάντζα τροχού ερπυστρίας & 2024 T4 & 6 & 58.68 &352.08 \\
\hline
Κύρια άτρακτος & Steel & 2 & 386.41 & 736.82 \\
\hline
Οπίσθια κύρια άτρακτος & Steel & 2 & 298.84 & 597.86 \\
\hline
Εσωτερικό καπάκι κιβωτίου κίνησης & 2024 T4 & 2 & 585.25 & 1170.5 \\
\hline
Εξωτερικό καπάκι κιβωτίου κίνησης & 2024 T4 & 2 & 571.04 & 1142.08 \\
\hline
Ατέρμονας κοχλίας (κοινός) & 2024 T4 & 4 & 11.89 & 47.56 \\
\hline
Άξονας ατέρμονα & 2024 T4 & 4 & 12.04 & 48.16 \\
\hline
Οδοντωτός τροχός κύριας ατράκτου & 2024 T4 & 2 & 54.91 & 109.82 \\
\hline
Οδοντωτός τροχός ατράκτου βραχίονα & 2024 T4 & 2 & 76.6 & 153.2 \\
\hline
Λοιπά μηχανολογικά στοιχεία & Var. & 1 & 3000.0 & 3000.0 \\
\hline
\rowcolor{YellowGreen}
\multicolumn{5}{|c|}{Body Subsystem} \\
\hline
Δικτύωμα σώματος & Steel & 1 & 526.98 & 526.98 \\
\hline
Καπάκια σασί σώματος & 1060 Al & 1 & 335.36 & 335.36 \\
\hline
Payload & Var. & 1 & 5000.0 & 5000.0 \\
\hline
Λοιπά στοιχεία & Var. & 1 & 1000.0 & 1000.0 \\
\hline
\rowcolor{YellowGreen}
\multicolumn{5}{|c|}{Electronics Hardware} \\
\hline
LiDAR Unit & - & 1 & 200.0 & 200.0 \\
\hline
Thermal Camera & - & 1 & 200.0 & 200.0 \\
\hline
Λοιποί αισθητήρες & - & 1 & 50.0 & 50.0 \\
\hline
Μπαταρία & - & 1 & 2000.0 & 2000.0 \\
\hline
Κινητήρες ερπύστριας & - & 2 & 480.0 & 960.0 \\
\hline
Κινητήρες βραχίονα & - & 2 & 480.0 & 960.0 \\
\hline
Λοιπά ηλεκτρονικά & - & 1 & 10.0 & 10.0 \\
\hline
\rowcolor{BlueGreen}
\multicolumn{4}{|c|}{Grand Total Mass} & $27.36\; kg$ \\
\hline
\end{tabular}

    \caption{Ισοζύγιο μάζας \textit{v1}.}
    \label{tab:massBudgetV1}
\end{table}

\subsection{Αναθεώρηση διαστάσεων ρομποτικού διασώστη}
% flip condition

Μετά την πρώτη επανάληψη του ισοζυγίου μάζας, θα πρέπει να πραγματοποιηθούν βελτιώσεις στο V.L.A.D. με κύριο σκοπό τη μείωση του βάρους του διασώστη. Μια βασική αλλαγή για την επίτευξη του σκοπού αυτού θα είναι ο επανασχεδιασμός των βασικών διαστάσεων του διασώστη. Κυρίως όσον αναφορά, το μήκος, πλάτος και ύψος της πλατφόρμας. 
\par Κατά την πρώτη επανάληψη, η μάζα του V.L.A.D. είναι \textbf{27.36 kg} και φαίνεται στον \ref{tab:massBudgetV1}. Αντίστοιχα, το μήκος της πλατφόρμας, μετρημένο από το κέντρο του εμπρόσθιου τροχού της κύριας ερπύστριας έως το κέντρο του οπίσθιου τροχού της ερπύστριας, προκύπτει \textbf{380 mm}. Επίσης, το μήκος του βραχίονα, από το κέντρο του μεγάλου τροχού της δευτερεύουσας ερπύστριας έως το κέντρο του μικρού, είναι \textbf{215 mm}. Οι συγκεκριμένες τιμές, βρίσκονται εντός των αρχικά εκλεγμένων οριών του \ref{tab:reqs}. Ωστόσο, με βάση δύο απλούς πυλώνες, θα βελτιστοποιηθούν τα συγκεκριμένα μεγέθη.
\par Ο πρώτος πυλώνας αφορά την ικανότητα του διασώστη να προσαρμόζεται σε δύσβατα εδάφη. Κρίνεται γενικότερα σκόπιμο σε τέτοιες αποστολές διάσωσης, οι ρομποτικοί διασώστες να έχουν την δυνατότητα υπερπήδησης εμποδίων και υψομετρικών διαφορών, αντίστοιχα με την ικανότητα των ανθρώπων να ανέρχονται σκαλοπάτια. Η διαδικασία λειτουργίας που ακολουθεί η πλατφόρμα V.L.A.D. για την υπερπήδηση ενός σκαλοπατιού, βασίζεται στη χρήση του περιστρεφόμενου βραχίονα του, όπως φαίνεται και στο \ref{fig:stairClimb}. Με βάση λοιπόν τα παραπάνω, κρίνεται ότι η ιδανική διάσταση για το μήκος του βραχίονα πρέπει να είναι μεγαλύερο από ένα συμβατικό σκαλοπάτι. Το ύψος ενός σκαλοπατιού εκτιμάται στα 180 mm. Έτσι, το μήκος του βραχίονα μπορεί να μειωθεί στα \textbf{200 mm}, με αποτελέσμα και τη μείωση της μάζας του. 
\begin{figure}[H]
    \centering
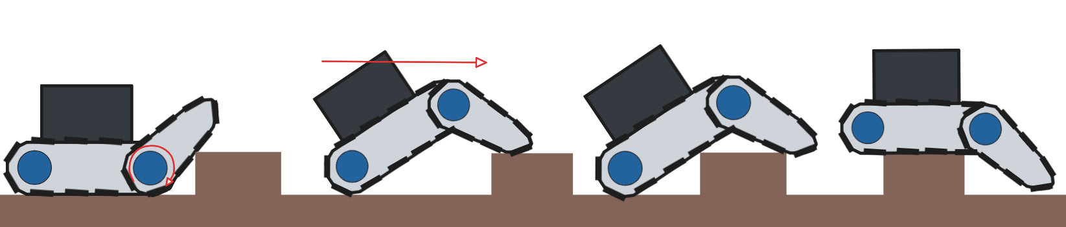
[picture p47: TeX/media/stairClimb.png]
    
    \caption{Αλληλουχία κινήσεων πλατφόρμας V.L.A.D. κατά την υπερπήδηση σκαλοπατιού.}
    \label{fig:stairClimb}
\end{figure}

\par Ο δεύτερος πυλώνας αφορά την κινηματική σταθερότητα της πλατφόρμας και την αποφυγή της ανατροπής της. Το συνολικό μήκος της πλατφόρμας σε σύγκριση με το σημείο του κέντρου βάρους της, επηρεάζουν άμεσα την ανατροπή του διασώστη κατά την ανάβαση σε κεκλιμένα επίπεδα. Από τη πρώτη εκδοχή της συναρμολογήμενης διάταξης σε CAD του V.L.A.D. μπορεί να ληφθεί το σημείο του κέντρου βάρους του.
\begin{figure}[H]
    \centering
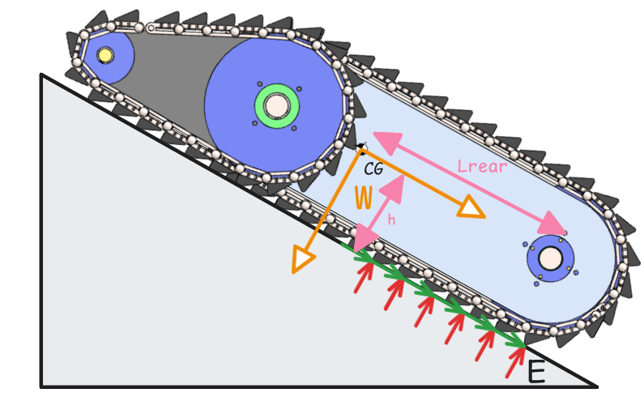
[picture p48: TeX/media/flipCond.png]
    
    \caption{Στατική ανάλυση κατά την πορεία σε κεκλιμένο επίπεδο της πλατφόρμας V.L.A.D.}
    \label{fig:flipCond}
\end{figure}

Όπως παρατηρείται στο \ref{fig:flipCond}, κατά την ανατροπή του διασώστη, η κάθετη αντίδραση του εδάφους μηδενίζεται σε κάθε σημείο επαφής της ερπύστριας με το έδαφος, εκτός από το σημείο \textit{E}, γύρω από το οποίο περιστρέφεται και ο διασώστης κατά τη πορεία σε κεκλιμένο με γωνία $\theta$. Λίγο πριν την ανατροπή η συνισταμένη ροπών ως προς το \textit{E} είναι μηδενική:
\begin{equation}
    \Sigma M_{E} = 0
\end{equation}

Στη συνισταμένη επιδρά μόνο το βάρος του διασώστη, το οποίο ασκείται στο κέντρο βάρος της πλατφόρμας που απέχει $h$ από το σημείο επαφής με το κεκλιμένο και $L_{rear}$ από το \textit{E}. Αναλύοντας τις συνιστώσες του βάρους προκύπτει:

\begin{equation}
    w\cdot h \cdot sin\theta - w \cdot L_{rear} \cdot cos\theta = 0
\end{equation}

Αναδιατυπώνοντας την παραπάνω εξίσωση προκύπτει η μέγιστη τιμή της γωνίας του κεκλιμένου επιπέδου για την αποφυγή της ανατροπής της πλατφόρμας:

\begin{equation}
    \theta = arctan\bigg(\frac{L_{rear}}{h}\bigg)
\end{equation}

Παρατηρείται ότι, όσο αυξάνεται η απόσταση του κέντρου βάρους της πλατφόρμας από το σημείο ανατροπής τόσο αυξάνεται και η επιτρεπτή γωνία κεκλιμένου. Για αυτόν τον λόγο, κατά την ανάβαση κεκλιμένου εδάφους, ο βραχιόνας οριζοντιοποιείται με το επίπεδο μετακινώντας το κέντρο βάρους πιο μακριά από το σημείο ανατροπής. 
\par Θεωρώντας λοιπόν μια αρκούντως ικανοποιητική γωνία κεκλιμένου $\theta = 50^\circ$, οι διαστάσεις $L_{rear}, h$ μπορούν να ξανά οριστούν και πιο συγκεκριμένα να μειωθεί το μήκος της πλατφόρμας σε σημείο που η οριακή γωνία κεκλιμένου είναι η ζητούμενη. Έτσι, μειώνεται το μήκος της πλατφόρμας στα \textbf{280 mm}.

\subsection{Μείωση μάζας}
%% τεχνικες μειωσης μαζας
Έχοντας πλέον μειώσει τις διαστάσεις του V.L.A.D., σειρά έχουν πιο δραστικές αλλαγές για τη μείωση της μάζας του. Όλες οι τεχνικές μείωσης μάζας που χρησιμοποιήθηκαν κατά τη δεύτερη εκδοχή του ισοζυγίου μάζας θα αναλυθούν παρακάτω.
\par Η πιο βασική τεχνική μείωσης της μάζας, είναι η επιλογή ελαφρύτερων υλικών με παρόμοια στιβαρότητα. Καθώς το αλουμίνιο αποτελεί ένα ελαφρύ σε σύγκριση με το χάλυβα υλικό, για αρχή επιλέγεται ξανά το υλικό των ατράκτων να είναι αλουμίνιο. Με αυτόν τον τρόπο εξοικονομείται πολύ μάζα στα βαριά κομμάτια του συστήματος κίνησης (ατράκτοι). Επίσης, επιλέγονται τα κομμάτια του σώματος, τα οποία θα επανασχεδιαστούν αργότερα, αλλά και τα εξωτερικά καπάκια του κιβωτίου κίνησης να κατασκευαστούν από σύνθετο υλικό ινών άνθρακα (carbon fiber). Πιο συγκεκριμένα επιλέγεται ο τύπος Zoltek Panex 33 λόγω της βελτιωμένης αντοχής του. Τέλος, οι αρθωτοί σύνδεσμοι της ερπύστριας κρίνεται ότι θα κατασκευαστούν επίσης από αλουμίνιο. Καθώς μειώθηκε το μήκος της πλατφόρμας, μειώνονται και οι σύνδεσμοι της ερπύστριας, με αποτέλεσμα να μείωνεται ακόμη περισσότερο η μάζα.
\par Παρατηρώντας ξανά τον \ref{tab:massBudgetV1}, φαίνεται ότι οι ατράκτοι προσδίδουν πολύ βάρος στη κατασκευή. Επομένως, κρίνεται αναγκαίο να μειωθεί κάπως η μάζα τους. Με τη μετατροπή των κυλίνδρικών ατράκτων σε κύλινδρο με αξονική οπή κατά όλο το μήκος τους, μειώνεται σημαντικά η μάζας της κάθε ατράκτου. Επιλέγεται κοίλη διατομή εσωτερικής διαμέτρου $5\; mm$. Η συγκεκριμένη γεωμετρία βελτιστοποιεί τον λόγο αντοχής προς βάρος, καθώς επιτυγχάνει τη μείωση της μάζας χωρίς να διακυβεύεται η μηχανική αντοχή και η δυσκαμψία του εξαρτήματος. 
\par Παράλληλα, στο πλαίσιο της βελτιστοποίησης του βάρους, εξετάστηκε η δυνατότητα μείωσης των δομικών στοιχείων. Καθώς η απλή αφαίρεση εξαρτημάτων θα διακύβευε τη λειτουργικότητα του μηχανισμού, προκρίθηκε η στρατηγική της ενοποίησης εξαρτημάτων. Συγκεκριμένα, η συναρμογή άτρακτος-πολύσφηνο-φλάντζας-τροχού αντικαταστάθηκε από απλούστερο σχεδιασμό. Στη νέα διάταξη, η φλάντζα του τροχού της ερπύστριας κατασκευάζεται ως ενιαίο τμήμα της κύριας ατράκτου, καταργώντας την ανάγκη για ξεχωριστά εξαρτήματα προσαρμογής και συνδέσμους, μειώνοντας έτσι τόσο τη μάζα όσο και την πολυπλοκότητα συναρμολόγησης. Αντίστοιχα, και ο οδοντωτός τροχός της κύριας ερπύστριας κατεργάζεται και αυτός απευθείας πάνω στην άτρακτο.

\begin{figure}[H]
    \centering
    \begin{subfigure}{0.45\linewidth}
        \centering
        
        \caption{Πρώτη εκδοχή.}
        \label{fig:csShaftOld}
    \end{subfigure}
    \hfill
    \begin{subfigure}{0.45\linewidth}
        \centering
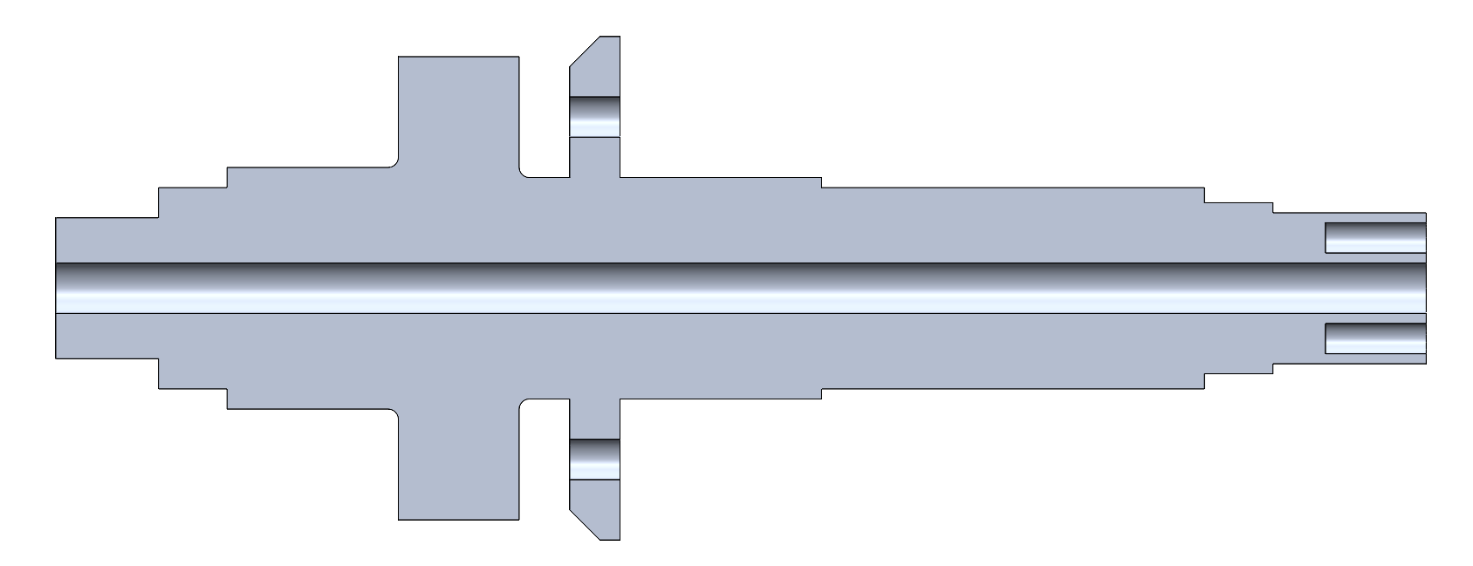
[picture p49: TeX/media/csShaftNew.png]
        
        \caption{Δεύτερη εκδοχή.}
        \label{fig:csShaftNew}
    \end{subfigure}
    \caption{Τομή κύριας ατράκτου κατά την πρώτη και δεύτερη επανάληψη του ισοζυγίου μάζας.}
    \label{fig:csShaft}
\end{figure}

\par Συνεχίζοντας, οι τροχοί των ερπυστριών μεταξύ της πρώτης και της δεύτερης εκδοχής σημειώνουν αλλαγές με σκοπό τη μείωση της επιμέρους μάζας τους. Αφαιρείται υλικό κατά την ακτινική διεύθυνση των τροχών με αποτέλεσμα να δημιουργείται νεύρο στην εσωτερική του κάθε τροχού που ενώνει την εξωτερική και την εσωτερική ακτίνα του. Αυτό συμβαίνει τόσο για τον κύριο τροχό όσο και για τον τροχό του δευτερεύοντος συστήματος κίνησης.
\begin{figure}[H]
    \centering
    \begin{subfigure}{0.45\linewidth}
        \centering
        
        \caption{Πρώτη εκδοχή.}
        \label{fig:wheelOld}
    \end{subfigure}
    \hfill
    \begin{subfigure}{0.45\linewidth}
        \centering
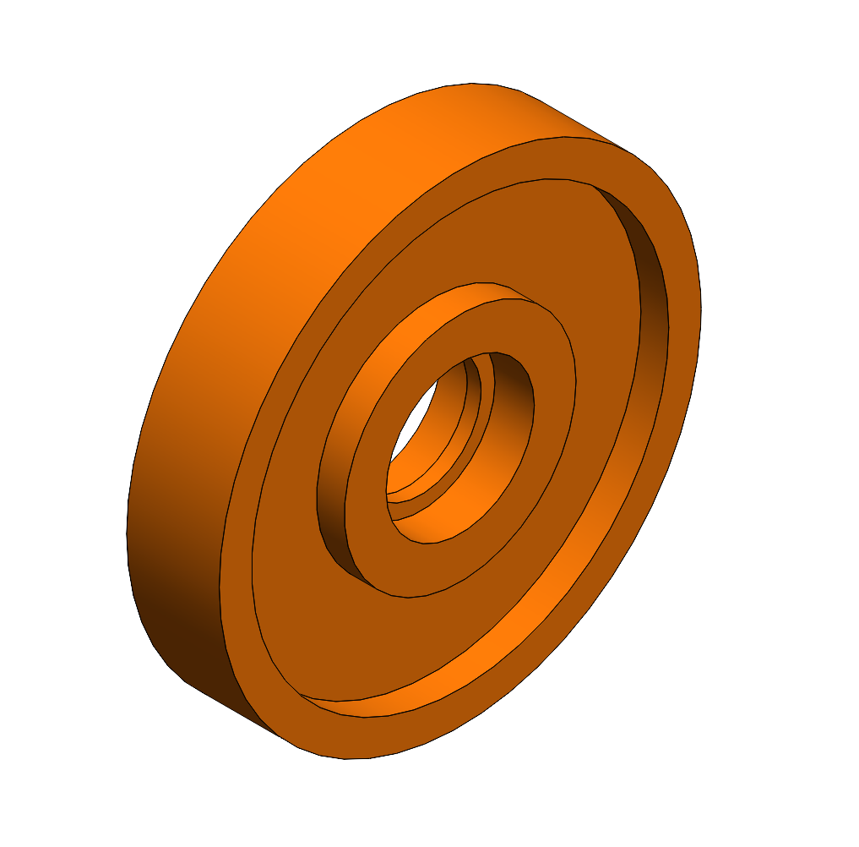
[picture p50: TeX/media/wheelNew.png]
        
        \caption{Δεύτερη εκδοχή.}
        \label{fig:wheelNew}
    \end{subfigure}
    \caption{Δευτερεύον οδοντωτός τροχός κίνησης κατά την πρώτη και δεύτερη επανάληψη του ισοζυγίου μάζας.}
    \label{fig:wheel}
\end{figure}

\par Σχετικά με τα κομμάτια του κιβωτίου κίνησης, αυτά επίσης προσδίδουν μεγάλο βάρος στην κατασκευή. Επιλέγεται λοιπόν η μείωση του πάχους των εσωτερικών και εξωτερικών καπακιών του κιβωτίου καθώς και η αφαίρεση των διαχωριστικών. Τα διαχωριστικά θα αντικατασταθούν από σταθεροποιητές για την έδραση των ζευγών των γραναζοκινήσεων ατέρμονα-τροχού, ενώ τα εξωτερικά καπάκια θα σχεδιασθούν πιο στιβαρά στα σημεία σταθεροποίησης των εδράνων κύλισης.
\par Τέλος, όπως έχει ήδη αναφερθεί, η επιλογή του σχεδιασμού δικτυώματος για το σώμα του V.L.A.D. αποτελεί μία παρωχημένη πλέον λύση. Όπως μπορεί κανείς να παρατηρήσεις από τον \ref{tab:massBudgetV1}, το δικτύωμα και τα καπάκια του συνεισφέρουν σημαντικά στην αύξηση του βάρους της κατασκευής. Εφόσον η τεχνολογία των σύνθετων υλικών εξυπηρέτησε και σε προηγούμενο σημείο τη μείωση της μάζας, προσφέροντας εξαιρετική αντοχή και ποιότητα έναντι κόστους, κρίνεται σκόπιμο, τόσο και για τη προσφορά περαιτέρω ελευθερίας κατά τον σχεδιασμό, να χρησιμοποιηθούν σύνθετα υλικά για το σώμα της πλατφόρμας. Επίσης, για την αύξηση της στιβαρότητας του συνολικού συστήματος στα σημεία ένωσης των δύο συμμετρικών κιβωτίων κίνησης του V.L.A.D., επιλέγεται η συγχώνευση του εσωτερικού καπακιού του κιβωτίου κίνησης με το σώμα της πλατφόρμας. Με αυτόν τον τρόπο, καταπολεμάται η στρέψη των κιβωτίων κίνησης αντίθετα μεταξύ τους (\ref{fig:torsionBody}) κατά την λειτουργία του διασώστη, μια καταπόνηση ιδίως σοβαρή λόγω και της έλλειψης ανάρτησης στο όχημα.

\begin{figure}[H]
    \centering
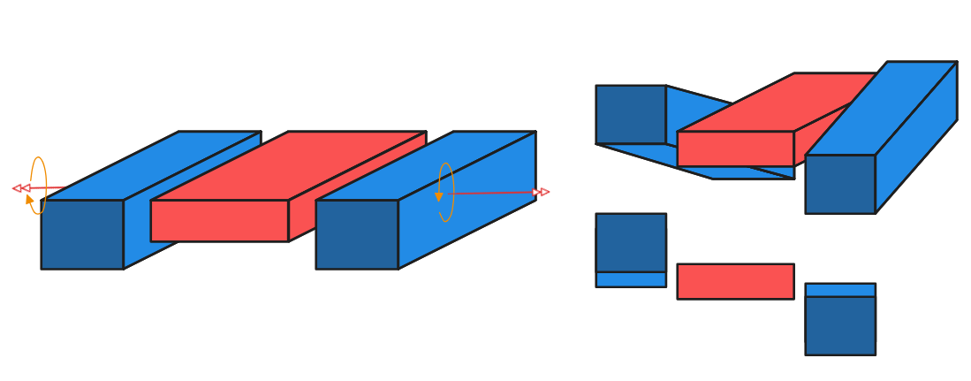
[picture p51: TeX/media/torsionBody.png]
    
    \caption{Στρέψη κιβωτίων κίνησης ως προς το σώμα της πλατφόρμας.}
    \label{fig:torsionBody}
\end{figure}

\par Παρακάτω, στο \ref{fig:bodyNew} παρατηρείται η καινούργια βελτιωμένη εκδοχή το σώματος της πλατφόρμας. Παραπάνω σχετικά με τις σχεδιαστικές αλλαγές του θα ανλυθούν στα παρακάτω κεφάλαια. Είναι εμφανές ότι τα εσωτερικά καπάκια του κιβωτίου, είναι πλέον αναπόσπαστο κομμάτι το σώματος του V.L.A.D. Το υλικό που επιλέγεται για τη κατασκευή αυτή είναι πάλι σύνθετο ανθρακόνημα Zoltek Panex 33, είτε με τη χρήση τρισδιάτατης εκτύπωσης, χρησιμοποιώντας το υλικό ως ενίσχυση σε συμβατικά πλαστικά εκτύπωσης, είτε με τη χρήση χύτευσης καλουπιού, τη σύνηθη μέθοδο παραγωγής εξαρτημάτων από ίνες άνθρακα. Για το σημείο αυτό, επιλέγεται η χρήση της απλής χύτευσης καθώς απλοποιεί τη διαδικασία υπολογισμού της μάζας του σώματος.
\begin{figure}[H]
    \centering
    \begin{subfigure}{0.45\linewidth}
        \centering
        
        \caption{Πρώτη εκδοχή.}
        \label{fig:bodyOld}
    \end{subfigure}
    \hfill
    \begin{subfigure}{0.45\linewidth}
        \centering
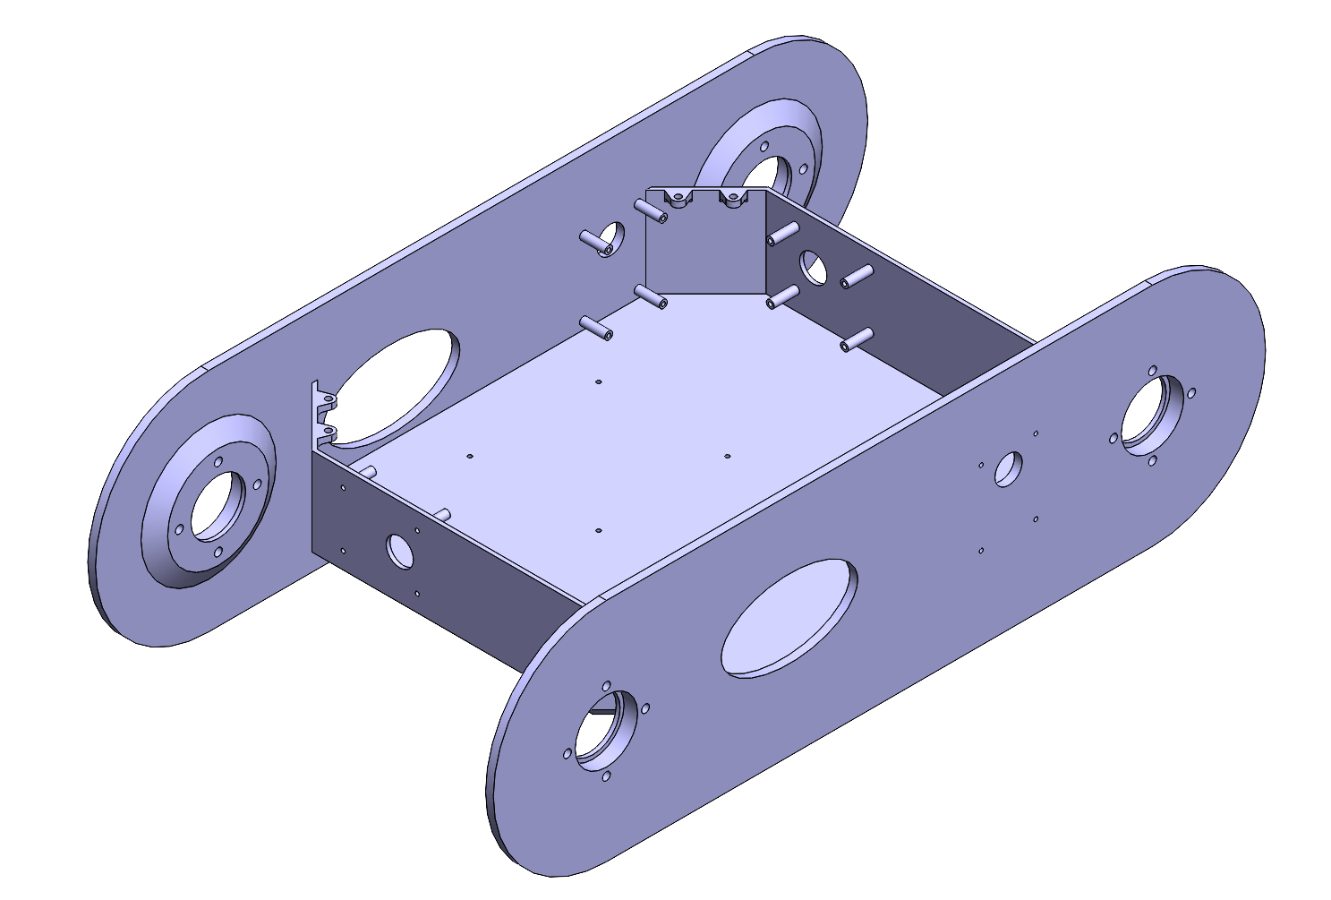
[picture p52: TeX/media/bodyNew.png]
        
        \caption{Δεύτερη εκδοχή.}
        \label{fig:bodyNew}
    \end{subfigure}
    \caption{Διάταξη σώματος πλατφόρμας κατά την πρώτη και δεύτερη επανάληψη του ισοζυγίου μάζας.}
    \label{fig:bodybody}
\end{figure}

\subsection{Στρατηγική τοποθέτησης αισθητήρων και αλγοριθμική διαχείριση τους}

Μετά την επιλογή των αισθητήρων και τον καθορισμού της χρήσης και λειτουργίας τους στα προηγούμενα κεφάλαια, θα πρέπει να δωθεί βάση και στη χωροταξική τοποθέτηση των αισθητήρων στην πλατφόρμα του V.L.A.D. με σκοπό την πιο αξιόπιστη και αποδοτική λειτουργία των ηλεκτρονικών και των αλγορίθμων διαχείρισης των δεδομένων των αισθητήρων.
Με μια ανακεφαλαίωση, οι αισθητήρες που θα χρησιμοποιηθούν είναι οι εξής:
\begin{itemize}
    \item Θερμική κάμερα
    \item Μικρόφωνο
    \item Επιταχυνσιόμετρο
    \item LiDAR
    \item IMU
    \item Αισθητήρας διοξειδίου του άνθρακα 
\end{itemize}

Ξεκινώντας με την κάμερα, κρίνεται ότι μια κάμερα είναι αρκετή για να πληρεί τις λειτουργίες-στόχους του διασώστη. Η κάμερα θα πρέπει να βρίσκεται σε υψηλό σημείο στην πλατφόρμα με σκοπό να μην επηρεάζεται το οπτικό της πεδίο από τα μέρη του ίδιου του διασώστη που αποτελούν σημαντικές πηγές θερμότητας, όπως οι κινητήρες και η μονάδα ενέργειας (μπαταρία). Η κάμερα θα πρέπει να διαθέτει αρκούντως μεγάλο οπτικό πεδίο ώστε να περιοριστεί η ανάγκη για σχεδιασμό συστήματος που της προσφέρει πολλούς βαθμούς ελευθερίας κινήσεων. Σύμφωνα και με την επιλογή του αισθητήρα LiDAR παρακάτω, κρίνεται ότι ένας περιστροφικός βραχίονας προσδίδει στην κάμερα ικανοποιητικό οπτικό πεδίο, δηλαδή $360^\circ$, εφόσον αυτή κατέχει μεγάλο οπτικό πεδίο. Το όριο που τίθεται για το οπτικό πεδίο της κάμερας είναι οι $80^\circ$ καθώς για την κάλυψη ολόκληρου το πεδίου γύρω από την πλατφόρμα απαιτείται λίγο περισσότερο από 4 περιστροφές των $90^\circ$ γύρω από τον βραχίονα περιστροφής της κάμερας.
\par Παράλληλα, για τα μικρόφωνα είναι πάλι αναγκαία η κάλυψη όλου το πεδίου γύρω από την πλατφόρμα, έτσι ώστε η τυχόν επικοινωνία με επιζώντες να μπορεί να πραγματοποιηθεί δίχως τεχνικές δυσκολίες και αντίστοιχα οι αλγόριθμοι εύρεσης θυμάτων να μην έχουν πολλά σημεία μικρής εμπιστοσύνης στο πεδίο του χώρου (λόγω ασθενών σημάτων ήχου). Για τον λόγο αυτό λοιπόν, και για την υπεροχή τους ως προς τον λόγο ποιότητας προς κόστος σε σχέση με τους υπόλοιπους τύπους, επιλέγονται δύο δικατευθιντικά μικρόφωνα, τα οποία αρκεί να τοποθετηθούν σε άξονες κάθετους μεταξύ τους για να καλύπτεται όλο το πεδίο γύρω από τον διασώστη. Τα μικρόφωνα αμφίδρομης κατευθυντικότητας, καταγράφουν σήμα μέσω πολικού διαγράμματος οκταειδούς και χαρακτηρίζονται από σημεία μηδενισμού  στον εγκάρσιο άξονα της κάψουλας, ενώ διατηρούν μέγιστη ευαισθησία στον διαμήκη άξονα. Μέσω της χρήσης δύο τέτοιων καψών σε ορθογώνια διάταξη και την εφαρμογή αλγορίθμων διασταύρωσης δεδομένων, επιτυγχάνεται η ελαχιστοποίηση της αβεβαιότητας του ακουστικού σήματος στα "τυφλά" σημεία της διάταξης.
\begin{figure}[H]
    \centering
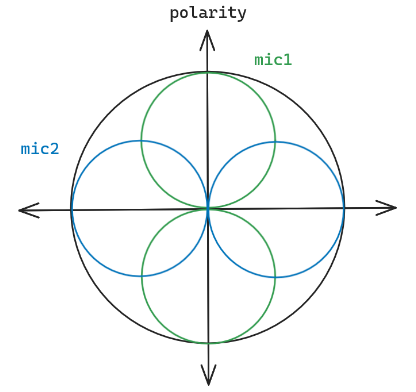
[picture p53: TeX/media/micPolarity.png]
    
    \caption{Διάγραμμα καταγραφής σήματος διάταξης μικροφώνων.}
    \label{fig:micPolarity}
\end{figure}

\par Σχετικά με το επιταχυνσιόμετρο, για τη καλύτερη εξακρίβωση των δεδομένων θα πρέπει να τοποθετηθούν δύο όμοιοι αισθητήρες. Ένας ως σημείο αναφοράς των δονήσεων που παράγει το μηχανικό σύστημα της πλατφόρμας, και ένας κοντά στην πηγή καταγραφής των δονήσεων, δηλαδή σε όσο πιο άμεση επαφή με το έδαφος. Αυτό σημαίνει ότι το επιταχυσνιόμετρο θα πρέπει να βρίσκεται στο σώμα του διασώστη, κοντά στο έδαφος ενώ το επιταχυσνιόμετρο σημείο αναφοράς μέσα στο σύστημα κίνησης ή στο κέλυφος του κιβωτίου κίνησης.
\par Προφανώς η μονάδα αδρανειακής μέτρησης θα πρέπει να βρίσκεται κοντά στο κέντρο βάρους της κατασκευής, ενώ αναφορικά με το LiDAR, μιας και η θερμική κάμερα καλύπτει ήδη την ανάγκη για τρισδιάστατη χωρική απεικόνιση, ο αισθητήρας αυτός λόγω του μικρότερου κόστους μπορεί να επιλεγεί για δισδιάστατη απεικόνιση. Έτσι, με ένα 2D LiDAR με πεδίο σκαναρίσματος $360^\circ$, οι ανάγκες χαρτογράφησης του χώρου της αποστολής του διασώστη καλύπτεται πλήρως.
\par Τέλος, οι αισθητήρες καταγραφής διοξειδίου του άνθρακα, θα πρέπει να καλύπτουν επίσης όλο το πεδίο γύρω από τον διασώστη. Μιας και οι αισθητήρες αυτοί γενικά δεν έχουν μεγάλκο εύρος καταγραφής, θα πρέπει να τοποθετηθεί ένας σε κάθε πλευρά του V.L.A.D. με σκοπό τη πλήρη κάλυψη του πεδίου. Η τελική χωροταξική τοποθέτηση των αισθητήρων στη πλατφόρμα φαίνεται στο \ref{fig:sensorPlacement}.

\begin{figure}[H]
    \centering
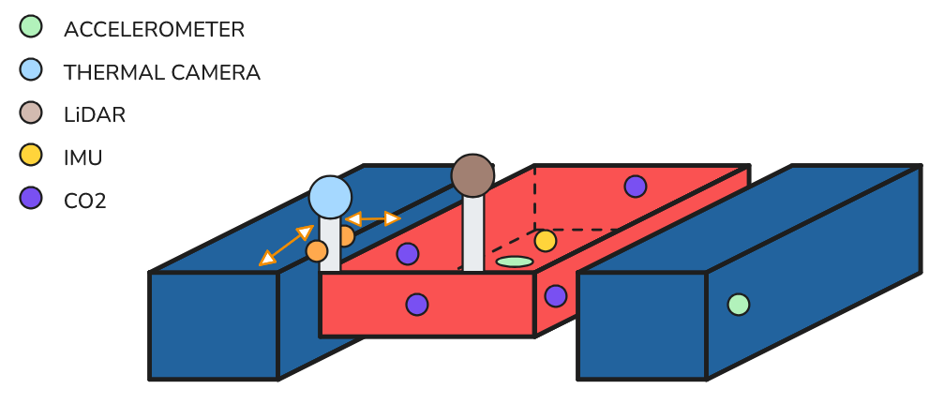
[picture p54: TeX/media/sensorPlacement.png]
    
    \caption{Στρατηγική τοποθέτηση αισθητήρων στη πλατφόρμα του V.L.A.D.}
    \label{fig:sensorPlacement}
\end{figure}

\par Για όλους τους παραπάνω αισθητήρες, θεωρείται ότι υπάρχει αντίστοιχος αλγόριθμος επεξεργασίας των δεδομένων. Είναι πολύ σημαντικό επίσης, κυρίως για τα επιταχυσνιόμετρα και τα μικρόφωνα να προηγείται στάδιο φιλτραρίσματος των σημάτων για την απλοποίηση του σειρών των δεδομένων και της καλύτερης μετεπεξεργασίας τους. Εάν τα δεδομένα κάθε αισθητήρα, μετά από την κατάλληλη προ-επεξεργασία του σήματος, είχαν τον δικό τους αλγόριθμο εντοπισμού θύματος, πρέπει να δημιουργηθεί μια λογική αλληλουχία αλγοριθμικής διαχείρισης ώστε η πλατφόρμα να δουλεύει αυτόνομα κατά την αναζήτηση θυμάτων. Ο διασώστης θεωρείται ότι λειτουργεί αυτόνομα έως ότου παρέμβει ο χειριστής του. Έτσι, με τη χρήση του παρακάτω αλγόριθμου διαχείρισης του συνόλου των δεδομένων, επιτυγχάνεται ο εντοπισμός του θύματος.
\par Αν θεωρηθεί ότι:
\begin{itemize}
    \item $A$: είναι το αποτέλεσμα (λογικό 1 ή 0) του αλγορίθμου εντοπισμού θύματος μόνο από τα δεδομένα της θερμικής κάμερας μετά από κατάλληλη προ-επεξεργασία αυτών. Όπου λογικό 1 σημαίνει ότι ο αλγόριθμος εντοπίζει θύμα προς συγκεκριμένη κατεύθυνση και 0 ότι δεν εντοπίζει.
    \item $M_i$: είναι το αποτέλεσμα (λογικό 1 ή 0) του αλγορίθμου εντοπισμού θύματος μόνο από τα δεδομένα των μικροφώνων μετά από κατάλληλη προ-επεξεργασία αυτών. Όπου λογικό 1 σημαίνει ότι ο αλγόριθμος εντοπίζει θύμα προς συγκεκριμένη κατεύθυνση και 0 ότι δεν εντοπίζει.
    \item $C_i$: είναι το αποτέλεσμα (λογικό 1 ή 0) του αλγορίθμου εντοπισμού θύματος μόνο από τα δεδομένα των αισθητήρων διοξειδίου του άνθρακα μετά από κατάλληλη προ-επεξεργασία αυτών. Όπου λογικό 1 σημαίνει ότι ο αλγόριθμος εντοπίζει θύμα προς συγκεκριμένη κατεύθυνση και 0 ότι δεν εντοπίζει.
    \item $V$: είναι το αποτέλεσμα (λογικό 1 ή 0) του αλγορίθμου εντοπισμού θύματος μόνο από τα δεδομένα του επιταχυνσιόμετρου μετά από κατάλληλη προ-επεξεργασία αυτών. Όπου λογικό 1 σημαίνει ότι ο αλγόριθμος εντοπίζει θύμα προς συγκεκριμένη κατεύθυνση και 0 ότι δεν εντοπίζει.
\end{itemize}

Για τα αποτελέσματα των αισθητήρων των μικροφώνων και του διοξειδίου του άνθρακα, θα πρέπει τουλάχιστον ένας εξ αυτών να έχει αποτέλεσμα λογικό 1. Δηλαδή για να ισχύει ότι $M_i = 1$ θα πρέπει $M_1 \text{OR} M_2 = 1$. Επίσης ορίζοντας τα παρακάτω σενάρια προκύπτει μια προτεινόμενη δομή του ολικού αλγορίθμου εντοπισμού θυμάτων της πλατφόρμας στο \ref{fig:functionality}:
\begin{itemize}
    \item $S1$: Σενάριο πρώτο, όπου το σύστημα του V.L.A.D., λόγω χαμηλής εμπιστοσύνης του ολικού αλγορίθμου εντοπισμού θύματος, παραπέμπει στον χειριστή να λάβει την απόφαση για τις επόμενες κινήσεις της αποστολής (αν θα συνεχιστεί η αναζήτηση, να ελεγχθεί κάποια άλλη συγκεκριμένη περιοχή, να επιβεβαιώσει αν όντως βρέθηκε θύμα).
    \item $VI$: Σενάριο αναγνώρισης θύματος. Κάθε φορά δηλαδή που ο αλγόριθμος καταλήγει στο αποτέλεσμα ότι εντοπίστηκε θύμα και αναμένει τις εντολές του χειριστή.
    \item $S2$: Σενάριο δεύτερο, όπου ξεκινά η αναγνώριση της πηγής ων δονήσεων μέσω κατάλληλου αλγορίθμου.
    \item $SL$: Σενάριο εκκίνησης αλγορίθμου εντοπισμού της πηγής του ηχητικού κύματος.
    \item $0$: Σενάριο σφάλματος, δεν λαμβάνονται υπόψη οι ενδείξεις των αλγορίθμων και συνεχίζεται η αναζήτηση.
    \item $CL$: Σενάριο εκκίνησης αλγορίθμου εντοπισμού της πηγής υψηλής συγκέντρωσης διοξειδίου του άνθρακα.
\end{itemize}

\begin{figure}[H]
    \centering
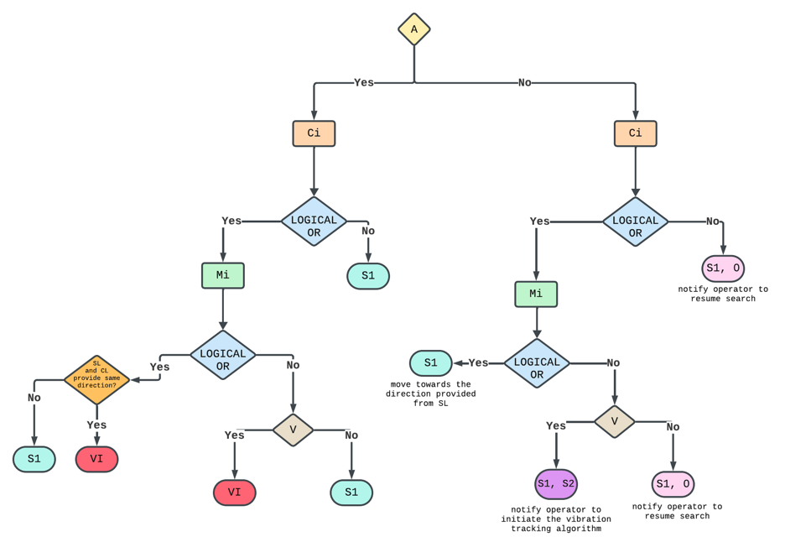
[picture p55: TeX/media/functionality.png]
    
    \caption{Ολικός αλγόριθμος εντοπισμού θυμάτων της πλατφόρμας V.L.A.D.}
    \label{fig:functionality}
\end{figure}

Θα αναλυθούν δύο παραδείγματα παρακάτω ώστε να γίνει απολύτως αντιληπτή η λειτουργία της αυτόνομης διαχείρισης των δεδομένων με σκοπό τον εντοπισμό θυμάτων.
\par Ξεκινώντας με τις ενδείξεις της θερμικής κάμερας, έστω ότι ο αλγόριθμος εντοπισμός θυμάτων μόνο από αυτά τα δεδομένα καταλήγει σε λογικό 1 (βρέθηκε θύμα). Τότε, ακολουθώντας τη δομή του ολικού αλγορίθμου, σειρά έχει η εξακρίβωση των ενδείξεων της θερμικής κάμερας με τους αισθητήρες $CO_2$. Έστω ότι ένας εξ αυτών καταλήγει σε λογικό 1, τότε επιβεβαιώνει τις ενδείξεις της θερμικής κάμερας και σειρά έχουν οι ενδείξεις των μικροφώνων. Έστω πάλι ότι ένα από τα δύο μικρόφωνα εντοπίζει θύμα μέσω του αλγορίθμου του, και επίσης έστω ότι η τοποθεσία του θύματος σύμφωνα με το αποτέλεσμα του αλγορίθμου εντοπισμού τοποθεσίας $SL$ και του $CL$ είναι προς κοινή κατεύθυνση, τότε ο ολικός αλγόριθμος καταλήγει στο συμπέρασμα ότι εντοπίστηκε θύμα.
\par Για το δεύτερο παράδειγμα υποτίθεται ότι οι ενδείξεις της κάμερας δεν εντοπίζουν θύμα. Ωστόσο, εάν τα αποτελέσματα από τουλάχιστον έναν αισθητήρα $CO_2$ καταλήγουν θετικά, ελέγχονται τότε και τα αποτελέσματα των μικροφώνων. Εάν αυτά δεν εντοπίζουν θύμα, με τη σειρά τους ελέγχονται τα αποτελέσματα του αλγορίθμου των επιταχυνσιόμετρων και έστω ότι και αυτά πορκύψουν αρνητικά, τότε ο ολικός αλγόριθμος παραπέμπει τον χειριστή να συνεχίσει την αναζήτηση.
\par Ο παραπάνω αλγόριθμος αποτελεί μια πρόταση για το πως οι εκλεγμένοι αισθητήρες μπορούν να πλαισιώσουν την αποστολή του διασώστη προσφέροντας αυτονομία κατά την λειτουργία του, ακολουθώντας τον κύριο στόχο σχεδιασμού του V.L.A.D. Προφανώς, υπάρχουν καλύτερες και πιο αποδοτικές μέθοδοι διαχείρισης του όγκου των δεδομένων από όλους τους αισθητήρες, ωστόσο αυτή η πρόταση αποτελεί μια εξακρίβωση της ευρωστίας του λειτουργικού συστήματος του ρομποτικού διασώστη.

\subsection{Σχεδιασμός σώματος και αποθήκης ειδών πρώτης ανάγκης}
Όπως έχει προηγουμένως αναφερθεί, το σώμα της πλατφόρμας θα πληρεί τις παρακάτω προϋποθέσεις:
\begin{itemize}
    \item Θα παρέχει χώρο αποθήκευσης ειδών πρώτης ανάγκης, με βάρος φορτίου όχι μεγαλύτερο από 5 κιλά.
    \item Θα αποτελεί το μέρος της πλατφόρμας όπου θα τοποθετηθούν όλα τα ηλεκτρονικά και η μπαταρία του συστήματος.
    \item Θα είναι ενιαίο κομμάτι με το εσωτερικό κέλυφος του κιβωτίου κίνησης για αύξηση της στιβαρότητας της κατασκευής.
\end{itemize}

Να σημειωθεί, ότι στις τελικές αλλαγές του σώματος, λήφθηκαν υπόψη οι πραγματικές επιλογές ηλεκτρονικών εξαρτημάτων και η τοποθέτηση τους. Οι επιλογές αυτές θα καλυφθούν σε μετέπειτα κεφάλαια.
\par Καταρχάς, πρέπει να ορισθεί σαφώς το φορτίο πρώτων βοηθειών της πλατφόρμας. Για τον λόγο αυτό χρειάζεται να επιλεγούν συγκεκριμένα αντικείμενα και παροχές που είναι σημαντικά και προτείνονται σε αποστολές διάσωσης. Στην δουλειά του Εμμανουήλ Κυριαζή κ.ά. (\cite{operations}), καταγράφονται σημαντικές λειτουργίες και στρατηγικές στις αποστολές διάσωσης σε σεισμούς. Με βάση την παραπάνω αναφορά αλλά και με περαιτέρω έρευνα προκύπτουν παρακάτω τα άκρως αναγκαία μεταφερόμενα αντικείμενα του διασώστη:
\begin{itemize}
    \item Νερό σε μπουκάλι ή σε πλαστικές σακούλες με στόμιο.
    \item Επίδεσμους, γάζες και άλλες παροχές για την περίθαλψη τραυματισμών.
    \item Αλοιφές ευγκαυμάτων και καταπολέμησης πόνων.
    \item Τρόφιμα σε ξηρή ή ρευστή μορφή, όπου στη δεύτερη περίπτωση με μεταφορά σε ειδικά σακουλάκια.
\end{itemize} 
Επιλέγεται λοιπόν, με βάση τα παραπάνω, η χρήση δύο μπουκαλιών νερού των 200 ml το κάθε ένα, η χρήση ενός φορητού φαρμακείου με επιδέσμους, γάζες, αλοιφές, χάπια κ.ά., και φακελάκια ρευστής και ξηράς τροφής.

\par Έχοντας πλέον ορίσει πιο συγκεκριμένα το payload της πλατφόρμας, μπορεί να δημιουργηθεί το τρισδιάστατο αρχείο του σώματος. Το σώμα επιλέγεται να χωριστεί σε δύο μέρη, ένα για τη τοποθέτηση της μονάδας της μπαταρίας και ένας για την αποθήκευση του payload. 
\par Το κάτω μέρος, υπεύθυνο για την τοποθέτηση του κύριου κυκλώματος ηλεκτρονικών, σχεδιάζεται με βάση τις διαστάσεις του δικτυώματος του σώματος. Η τελική του μορφή φαίνεται παρακάτω στο \ref{fig:db}. Όπως γίνεται αντιληπτό, τα εσωτερικά μέρη του κελύφους του κιβωτίου κίνησης αποτελούν προέκταση του σώματος. Επίσης, φαίνονται και δίαφοροι αποστάτες για τη τοποθέτηση συγκεκριμένων αισθητήρων όπως θα αναλυθεί και παρακάτω. Αυτό το μισό του σώματος θα είναι υπεύθυνο για την αποθήκευση της πλακέτας του επεξεργαστή, των οδηγών των κινητήρων, των αισθητήρων καταγραφής $CO_2$, της μπαταρίας και των απαραίτητων πλακετών διεπαφής των ηλεκτρονικών της πλατφόρμας.
\begin{figure}[H]
    \centering
    \begin{subfigure}{0.3\linewidth}
        \centering
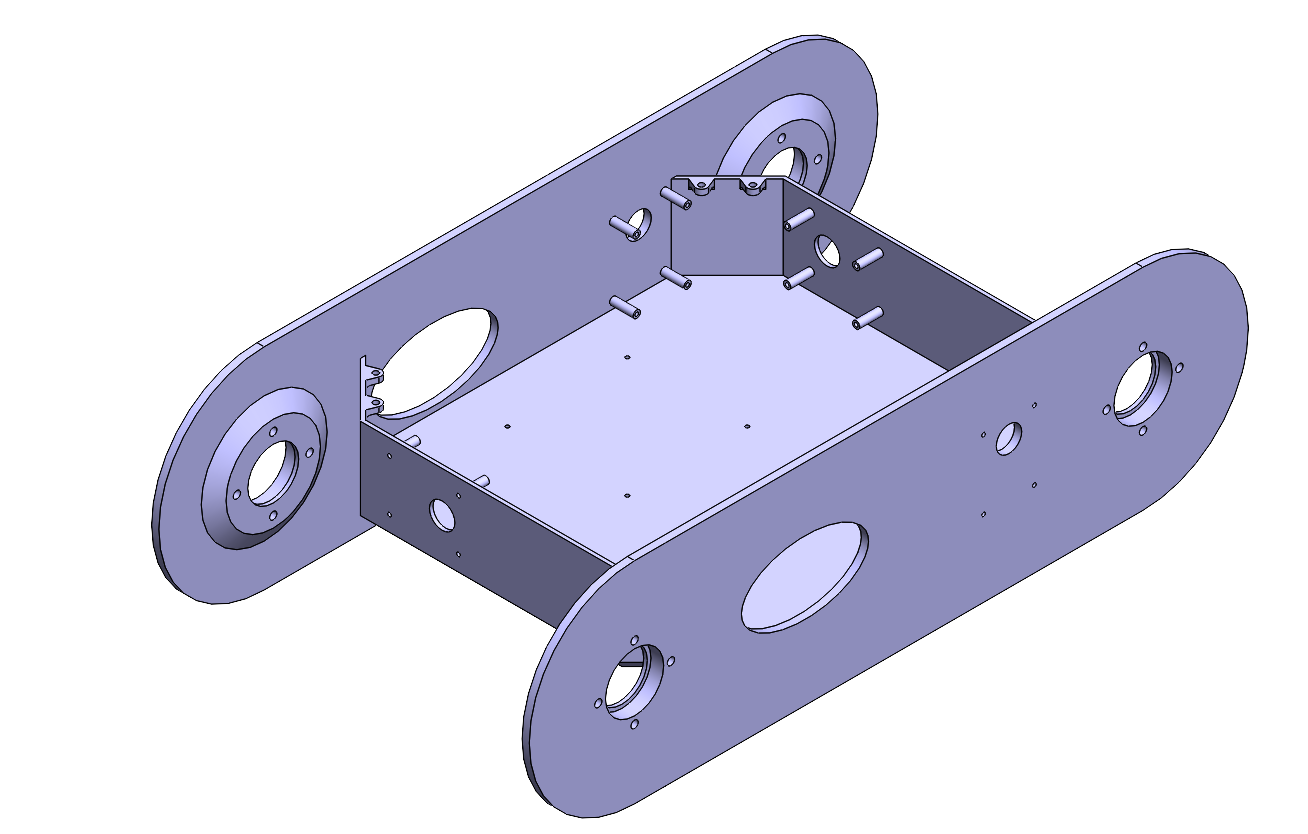
[picture p56: TeX/media/db1.png]
        
        \caption{Διμετρική όψη.}
        \label{fig:db1}
    \end{subfigure}
    \hfill
    \begin{subfigure}{0.3\linewidth}
        \centering
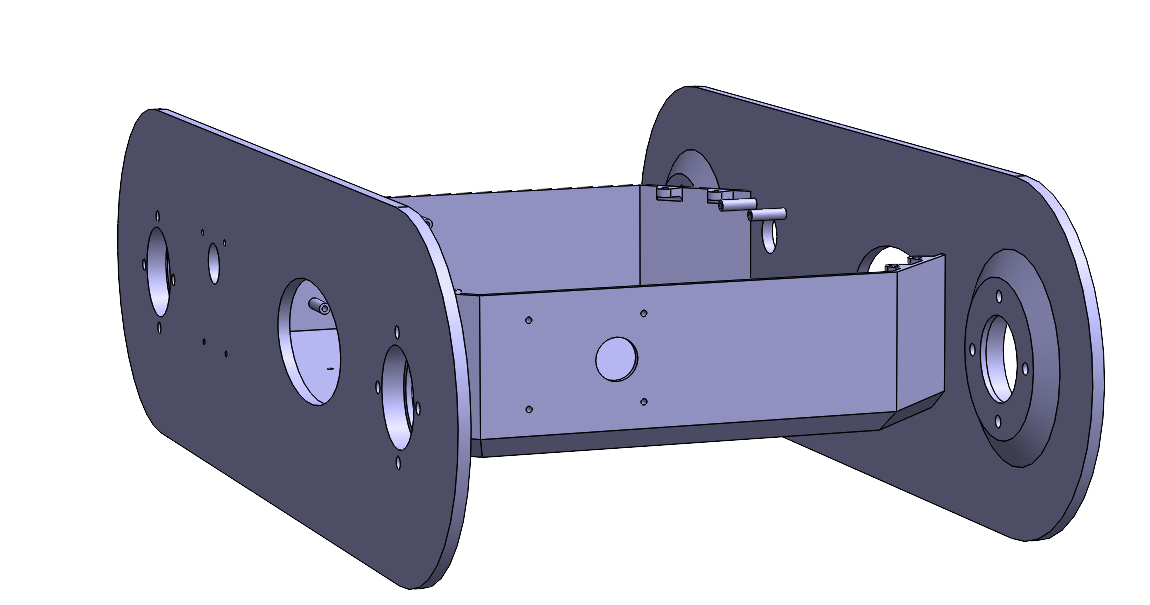
[picture p57: TeX/media/db2.png]
        
        \caption{Προοπτική σώματος.}
        \label{fig:db2}
    \end{subfigure}
    \hfill
    \begin{subfigure}{0.3\linewidth}
        \centering
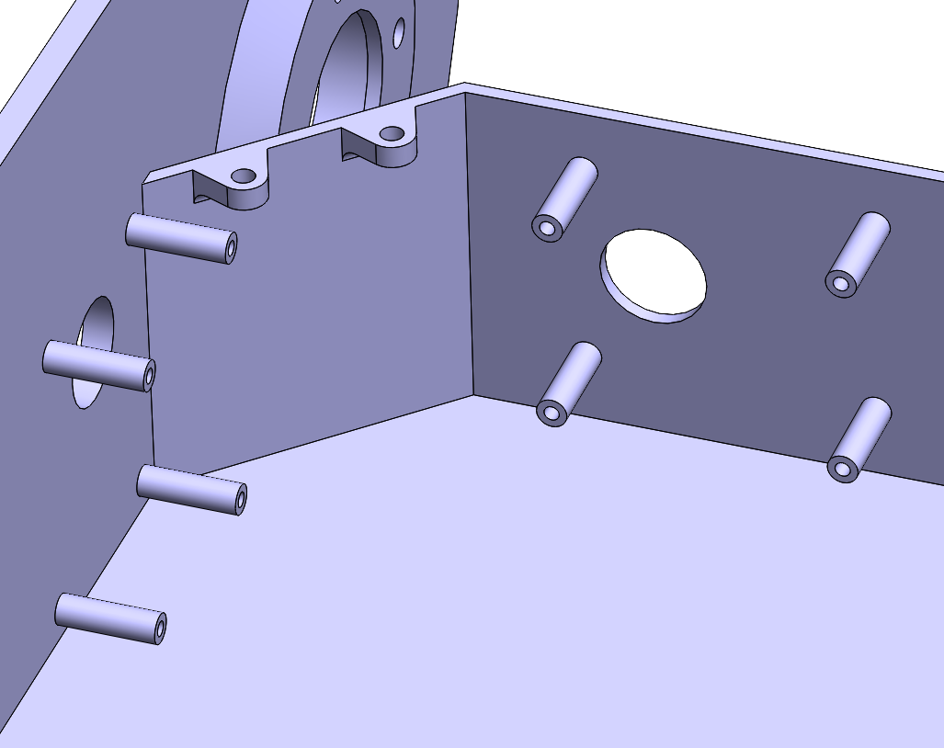
[picture p58: TeX/media/db3.png]
        
        \caption{Αποστάτες τοποθέτησης αισθητήρων.}
        \label{fig:db3}
    \end{subfigure}
    \caption{Τρισδιάστατο σχέδιο CAD του κάτω μέρους του σώματος της πλατφόρμας V.L.A.D.}
    \label{fig:db}
\end{figure}

\par Το πάνω μέρος του σώματος του V.L.A.D. θα είναι υπεύθυνο για την μεταφορά του payload και των αισθητήρων LiDAR, της κάμερας και των μικροφώνων, καθώς όπως έχει αναφερθεί, αυτά θα πρέπει να βρίσκονται σε υψηλά σημεία στην πλατφόρμα. Για λόγους αισθητικής, και εφόσον ακόμη και με αυτόν τον τρόπο εξυπηρετούνται οι στόχοι της αποστολής επιλέγεται να σχεδιαστεί θόλος για αυτό το μισό του σώματος. Ο θόλος αυτός, αποτελείται από δύο μέρη, την βάση και το καπάκι και το υλικό αυτών καθώς και η μέθοδος παραγωγής τους, επιλέγονται διαφορετικά από αυτών του κάτω μέρους. Κρίνεται ότι η χρήση τεχνολογιών τρισδιάστατης εκτύπωσης αποτελούν μια ικανοποιητική και μη κοστοβόρα επιλογή για τη κατασκευή του θόλου. Το υλικό που επιλέγεται είναι το PEEK λόγω της υψηλής αντοχής του. Παρακάτω, στα \ref{fig:ub} και \ref{fig:ubb} φαίνεται η τρισδιάστατη μορφή του θόλου καθώς και κάποιοι όγκοι που αναπαριστούν τα αντικείμενα πρώτων βοηθειών του payload. Με τη πράσινη απόχρωση αναπαρίσταται το φαρμακείο πρώτων βοηθειών με διαστάσεις $80\times75\times40\; mm$ και με ροζ απόχρωση τα μπουκάλια νερού των 200ml, με διαστάσεις $\varnothing 49\times 142\; mm$. Ο συνολικός όγκος μεταφοράς αντικειμένων πρώτων βοηθειών του θόλου προκύπτει $4.05\; lt$.
\par Όπως φαίνεται, η βάση για το LiDAR τοποθετείται στο υψηλότερο σημείο του σώματος για τους λόγους που έχουν αναφερθεί παραπάνω, ενώ η κάμερα τοποθετείται λίγο χαμηλότερα, με αποτέλεσμα βέβαια να μειώνεται λίγο από το οπτικό της πεδίο. Αυτή η παραδοχή έγινε για να μην καλύπτεται το οπτικό πεδίο σάρωσης του LiDAR. Επιπροσθέτως, η βάση στήριξης του LiDAR σχεδιάστηκε ως διαιρετή, με στόχο τη βελτιστοποίηση της διαχείρισης των καλωδιώσεων εντός της πλατφόρμας. Συγκεκριμένα, η βάση φέρει δύο οπές διέλευσης, οι οποίες επιτρέπουν την ασφαλή όδευση των καλωδίων από τους αισθητήρες του άνω επιπέδου προς τις υποδοχές των ηλεκτρονικών μονάδων που βρίσκονται στο κάτω τμήμα.

\begin{figure}[H]
    \centering
    \begin{subfigure}{0.3\linewidth}
        \centering
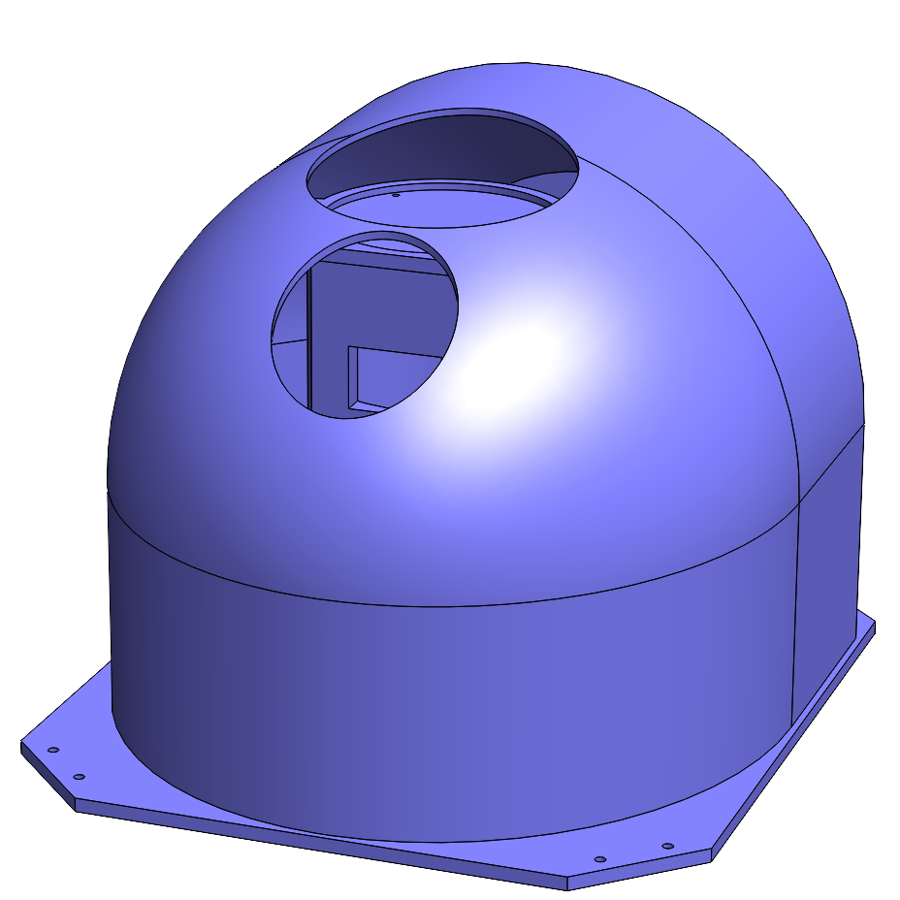
[picture p59: TeX/media/ub1.png]
        
        \caption{Συναρμολογημένη θόλου.}
        \label{fig:ub1}
    \end{subfigure}
    \hfill
    \begin{subfigure}{0.3\linewidth}
        \centering
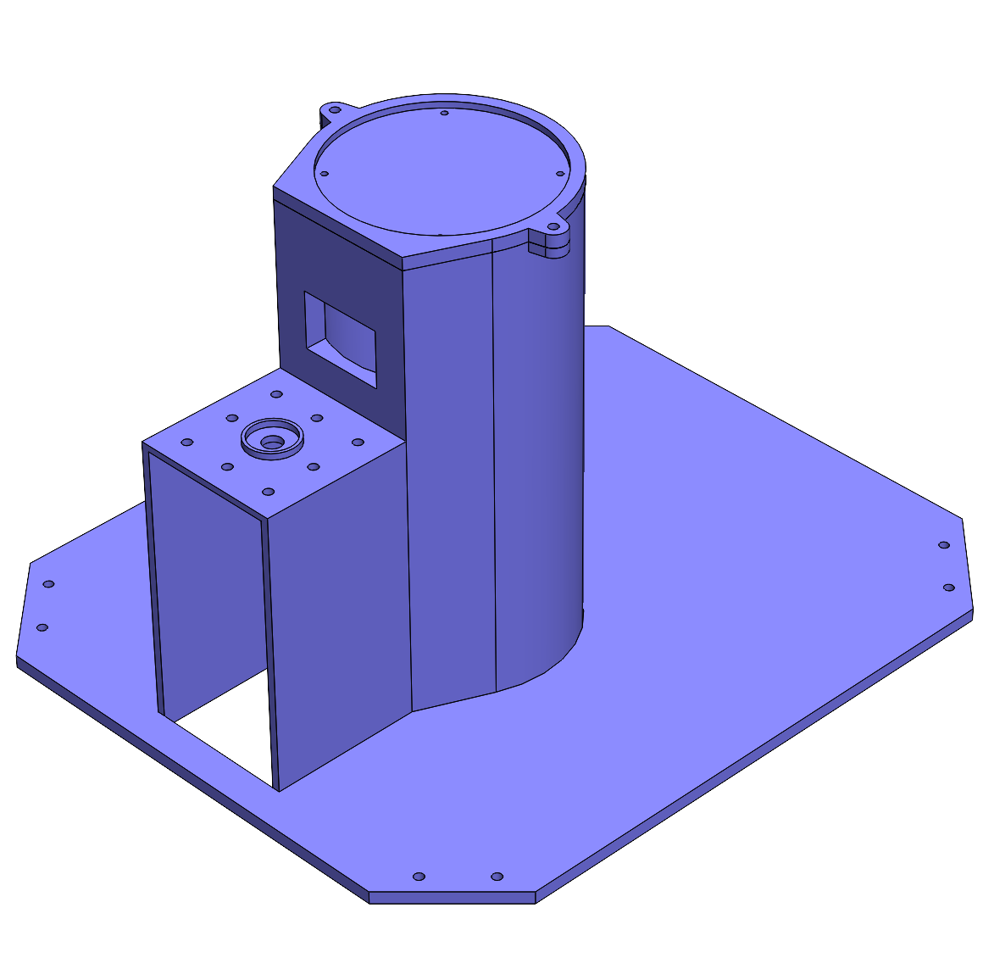
[picture p60: TeX/media/ub2.png]
        
        \caption{Βάση θόλου.}
        \label{fig:ub2}
    \end{subfigure}
    \hfill
    \begin{subfigure}{0.3\linewidth}
        \centering
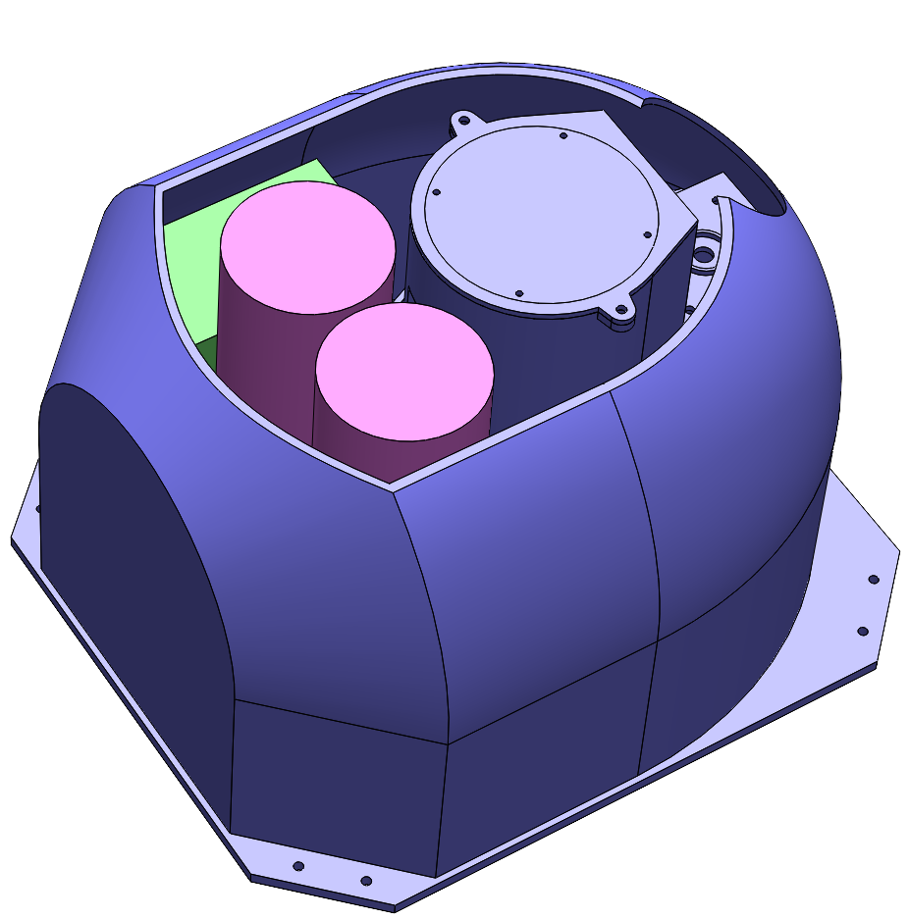
[picture p61: TeX/media/ub3.png]
        
        \caption{Χώρος αποθήκευσης payload.}
        \label{fig:ub3}
    \end{subfigure}
    \caption{Τρισδιάστατη απεικόνιση άνω μέρος σώματος και χώρου αποθήκευσης.}
    \label{fig:ub}
\end{figure}

\begin{figure}[H]
    \centering
    \begin{subfigure}{0.45\linewidth}
        \centering
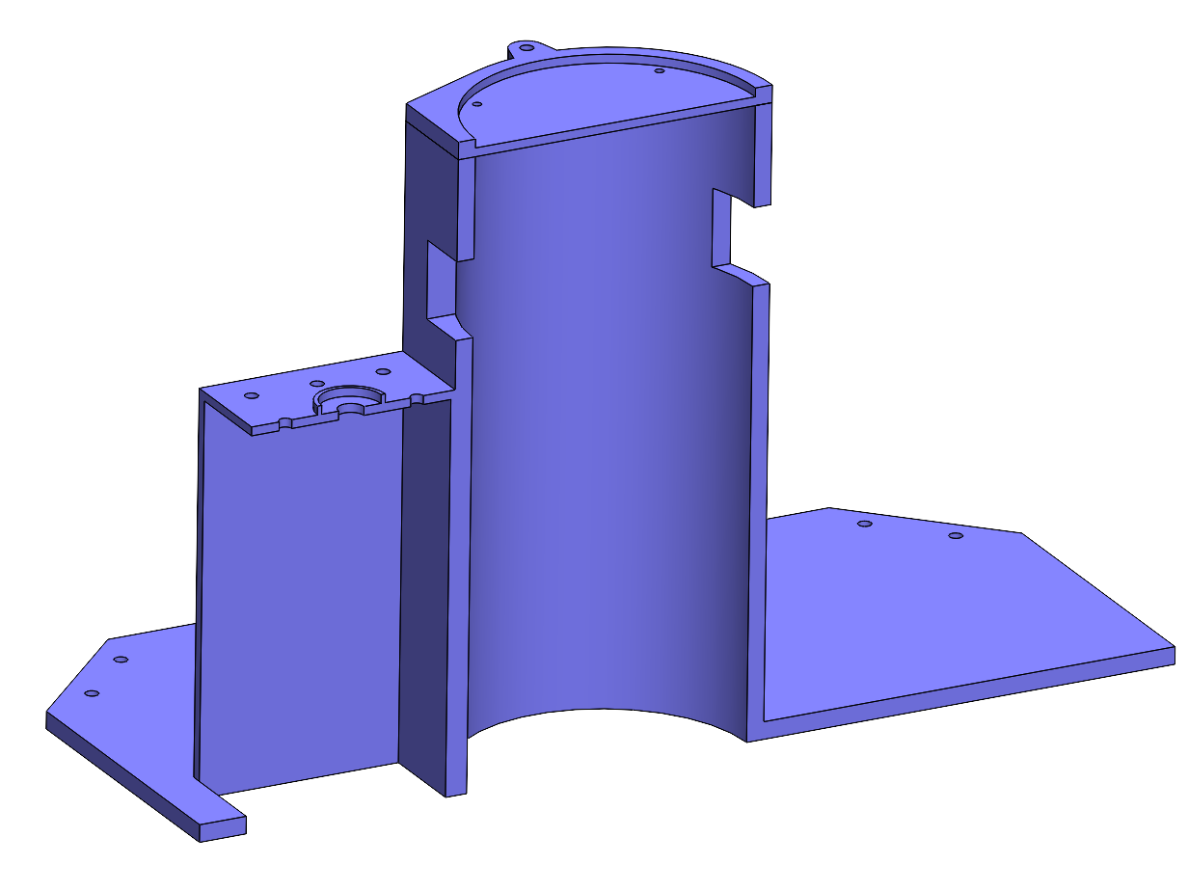
[picture p62: TeX/media/ub4.png]
        
        \caption{Τομή βάσης θόλου.}
        \label{fig:ub4}
    \end{subfigure}
    \hfill
    \begin{subfigure}{0.45\linewidth}
        \centering
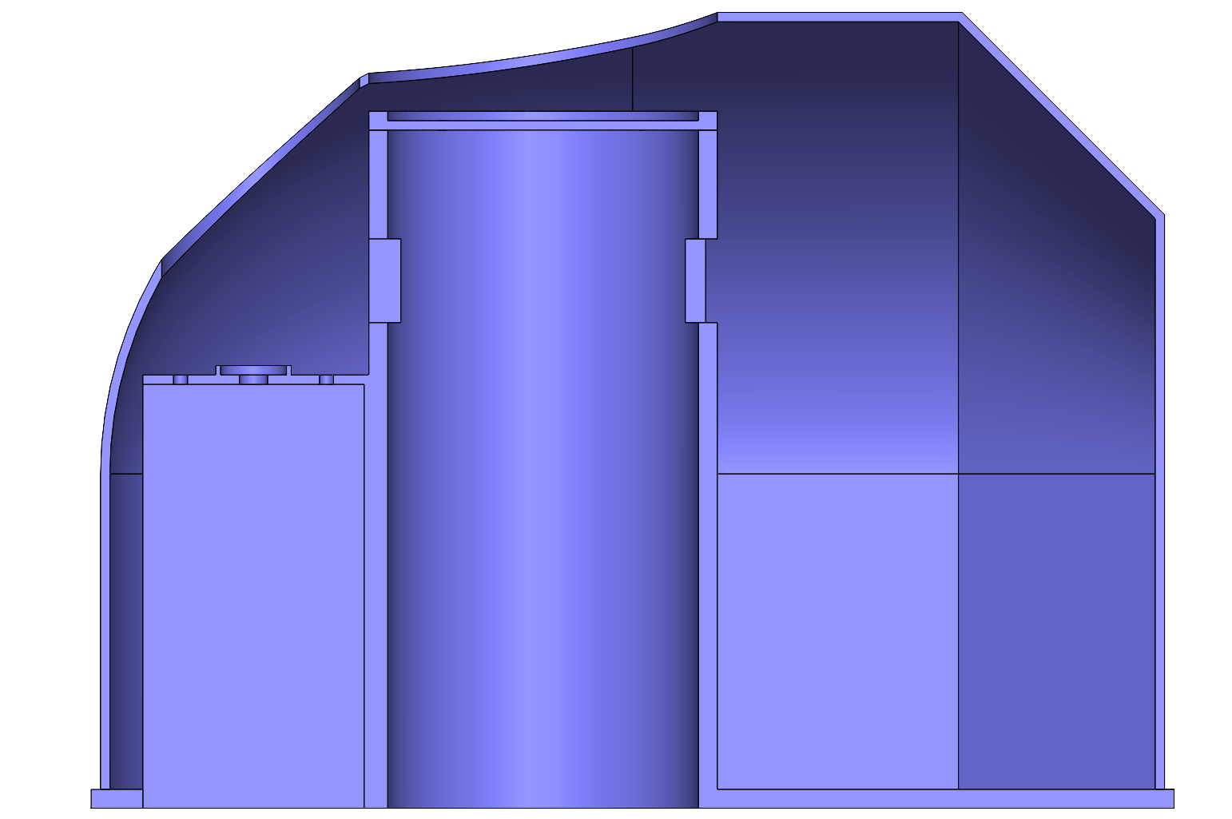
[picture p63: TeX/media/ub5.png]
        
        \caption{Τομή συναρμολογημένης.}
        \label{fig:ub5}
    \end{subfigure}
    \caption{Τομή άνω μέρους σώματος.}
    \label{fig:ubb}
\end{figure}

\subsection{Αναθεώρηση σχεδιασμού συστήματος κίνησης και τελικό ισοζύγιο μάζας}
%% allages sto systhma metadoshs kinhshs
% refinement gear interfaces, refinement worm, refinement bearing connections
% mass budget v2

Μετά και τον τελικό σχεδιασμό του σώματος, οι πιο κρίσιμες αλλαγές είναι αυτές στο σύστημα κίνησης για τη διασφάλιση της σωστής λειτουργίας όλων των μηχανολογικών εξαρτημάτων. Έχει ήδη προαναφερθεί, ότι κατά τη προηγούμενη σχεδιαστική πρόταση του συστήματος κίνησης, υπήρχαν αρκετά σημεία που χρήζαν πιο ορθή μελέτη και σχεδιασμό, αλλά για το σκοπό της αρχικής εκτίμησης μάζας κρίθηκε μη αναγκαίο να οριστούν καλύτερα σε εκείνο το σημείο. Πλεόν πρέπει να ορισθούν πιο ορθά οι εδράσεις του συστήματος, επιτρέποντας κατάλληλη στήριξη στις ατράκτους του συτήματος και οι συνδέσεις των λοιπών μηχανολογικών εξαρτημάτων.
\par Ξεκινώντας από τις εδράσεις, αυτές δεν ακολουθούσαν τις σύνηθεις πρακτικές στην έδραση ατράκτων. Μιας και η πλατφόρμα του V.L.A.D. αποτελεί ένα σύστημα που δύναται να χρησιμοποιηθεί σε δυσμενείς συνθήκες πρέπει οι εδράσεις να εξασφαλίζουν τη σταθερότητα της ατράκτου και τη σωστή διαχείριση των δυνάμεων που αυτή δέχεται. Με πλέον στιβαρό σημείο της κατασκευής το εσωτερικό μέρος του κελύφους, που αποτελεί κομμάτι του σώματος, η έδραση του σώματος στην άτρακτο αποτελεί ένα κρίσιμο σημείο καταπόνησης της κατασκευής. Έτσι, σε εκείνο το σημείο επιλέγεται να δημιουργηθεί η σταθερή έδραση της ατράκτου. Το κινητό δημείο της έδρασης της ατράκτου θα είναι στο εξωτερικό κομμάτι του κελύφους του κιβωτίου κίνησης. Σε όλα τα σημεία εδράσεων, τα κατασκευαστικά στοιχεία που είναι υπεύθυνα για τη σταθεροποίηση των εδράνων πρέπει να παρουσιάζουν κατάλληλη στιβαρότητα. Επομένως, σε εκείνα τα σημεία το πάχος των τεμαχίων αυτών αυξάνεται για να διασφαλίσει τη κατασκευαστική ακεραιότητα του συστήματος. 
\par Τα λοιπά διαχωριστικά επιλέγεται να απαλοιφθούν από τη συναρμολόγηση του κιβωτίου, επομένως μόνο η έδραση της ατράκτου του βραχίονα (flipper) του V.L.A.D. πρέπει να ορισθεί ορθά από τις εδράσεις του κύριου συτήματος κίνησης. Επιλέγεται πάλι μια συνδεσμολογία εδράνων τύπου "Σταθερή-Κινητή", όπου η σταθερή έδραση συμβαίνει στο εξωτερικό σημείο της ατράκτου, αξιοποιώντας τη κοχλιοσύνδεση του βραχίονα στην άτρακτο για τη παρεμπόδιση της κίνησης του εδράνου και τη σταθεροποίηση της ατράκτου του βραχίονα. Καθώς η άτρακτος του βραχίονα φέρει κατεργασία οδόντωσης θα πρέπει να δωθούν μεγάλη προσοχή στον ορισμό των ανοχών της συναρμολογημένης για τη διασφάλιση της ορθής θέσης λειτουργίας της οδοντοκίνησης. 
\par Και για τις δύο εδράσεις των δύο ατράκτων του κύριου συστήματος κίνησης, χρησιμοποιούνται και περικόχλια ασφαλείας ατράκτου. Αυτά τοποθετούνται σε ειδικά διαμορφωμένα εξωτερικά σπειρώματα στην επιφάνεια της κύριας ατράκτου. Για τη σύσφιξη των εδράσεων χρησιμοποιούνται και αποστάτες με σκοπό την αύξηση της επιφάνειας επαφής για τη σταθεροποίηση της έδρασης. 
\par Οι επιλογές των μηχανολογικών εξαρτημάτων έγινε με βάση των διαστάσεων που είχαν ορισθεί κατά τον σχεδιασμό του τρισδιάστατου αρχείου CAD της πλατφόρμας. Προφανώς οι επιλογές αυτές θα πρέπει να ελεγχθούν για αντοχή με βάση το έδρανο κύλισης που επιλέγεται. Μια πρόχειρη μελέτη, καθώς πιο λεπτομερής ανάλυση ξεφεύγει του στόχουν της παρόν εργασίας, πραγματοποιείται σε μετέπειτα κεφάλαια. Η τομή του κύριου συστήματος κίνησης με τις αλλαγές που προαναφέρθηκαν στο παρόν υποκεφάλαιο και στα κεφάλαια αναφορικά με τις τεχνικές μείωσης μάζας της πλατφόρμας, παρατηρείται στο \ref{fig:maingt}

\begin{figure}[H]
    \centering
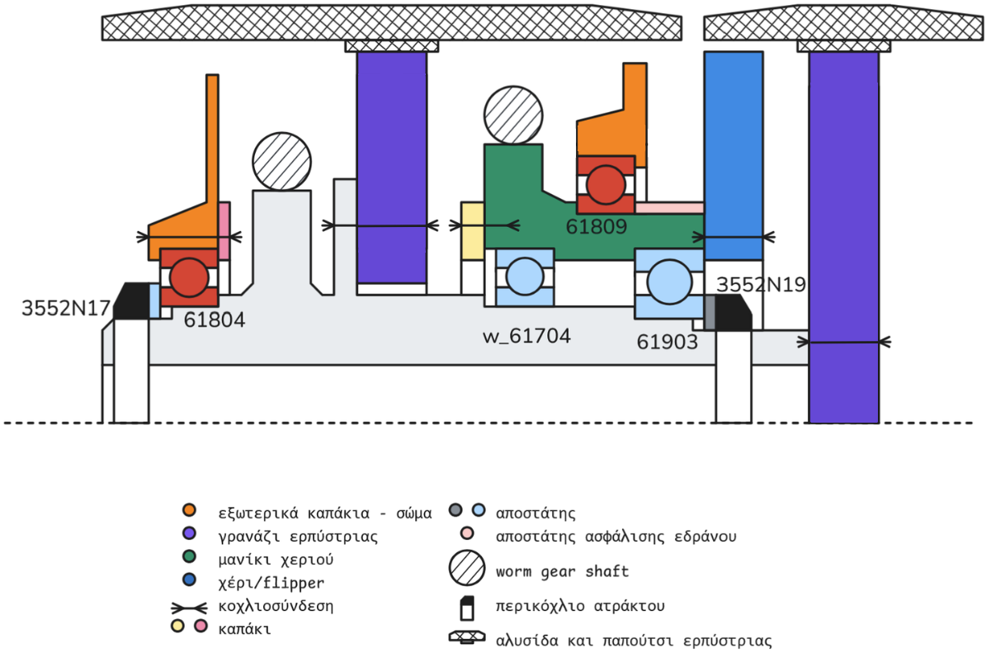
[picture p64: TeX/media/maingt.png]
    
    \caption{Σκαρίφημα συναρμολογημένης διάταξης κύριου συτήματος κίνησης κατά την δεύτερη επανάληψη του ισοζυγίου μάζας \textit{v2}.}
    \label{fig:maingt}
\end{figure}

\par Παράλληλα, αναφορικά με το οπίσθιο σύστημα κίνησης, η σταθερή έδραση είναι πάλι στο εσωτερικό κομμάτι του κελύφους, διορθώνοντας το προηγούμενο σφάλμα όπου το καπάκι της πλήμνης του κιβωτίου φέρει επαφή και με τους δύο δαχτύλιους του εδράνου κύλισης. Τέτοια σφάλματα, μαζί και με άλλα, έγιναν κατά την πρώτη επανάληψη καθώς ο σκοπός ήταν να διορθωθούν στη δεύτερη έκδοση του ισοζυγίου μάζας. Όπως ήδη αναφέρθηκε, η πρώτη επανάληψη έγινε για να αποκτηθεί μια πρώτη εκδοχή των σχεδίων της κατασκευής και να δημιουργηθεί μια πρώτη χωροταξική εκτίμηση της συναρμολόγισης. Επίσης, αντίστοιχα με τη κύρια άτρακτο, οι φλάντζες για τη πάκτωση των οδοντωτών τροχών και τη μεταφορά ροπής κατεργάζονται απευθείας στην οπίσθια κύρια άτρακτο. Η δεύτερη έδραση της ατράκτου, δημιουργείται και αυτή ως σταθερή καθώς αυτή η άτρακτος είναι βοηθητική και οδηγείται από τον εμπρόσθιο τροχό. Στο \ref{fig:backgt} φαίνεται το σκαρίφημα του οπίσθιου συστήματος κίνησης.

\begin{figure}[H]
    \centering
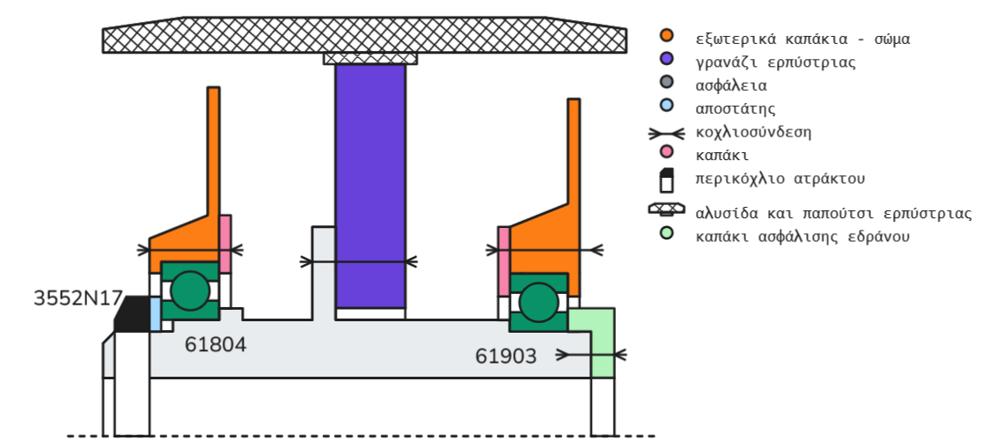
[picture p65: TeX/media/backgt.png]
    
    \caption{Σκαρίφημα συναρμολογημένης διάταξης οπίσθιου συστήματος κίνησης κατά τη δεύτερη επανάληψη του ισοζυγίου μάζας \textit{v2}.}
    \label{fig:backgt}
\end{figure}

\par Επιπρόσθετα, το δευτερεύον σύστημα κίνησης αλλάζει σε σχέση με τον ορισμό της έδρασης του βραχίονα. Πλεόν, η δευτερεύουσα άτρακτος συνδέεται μέσω κοχλιοσύνδεσης με τον βραχίονα περιστροφής και η έδραση πραγματοποιείται στον οδοντωτό τροχό. Ο τροχός αυτός είναι κινούμενος από τον τροχό της δευτερεύουσας ερπύστριας του κύριου συτήματος κίνησης. Τα έδρανα ακουλουθούν μια έδραση με προένταση τύπου "Χ", καθώς προεντείνονται τα εσωτερικά δαχτυλίδια των εδράνων μέσω ενός περικοχλίου ασφαλείας ατράκτου. Προφανώς για να λειτουργήσει αυτή η έδραση θα πρέπει ο αποστάτης των εσωτερικών δαχτυλιδιών των εδράνων να έχει μικρότερο πάχος από ότι ο αποστάτης των άνω δαχτυλιδιών, ο οποίος είναι κατεργαζμένος στον οδοντωτό τροχό. Η άτρακτος κατασκευάζεται και αυτή ως κοιλοδοκός για τη μείωση της μάζας του υποσυστήματος. Το σκαρίφημα φαίνεται παρακάτω.
\begin{figure}[H]
    \centering
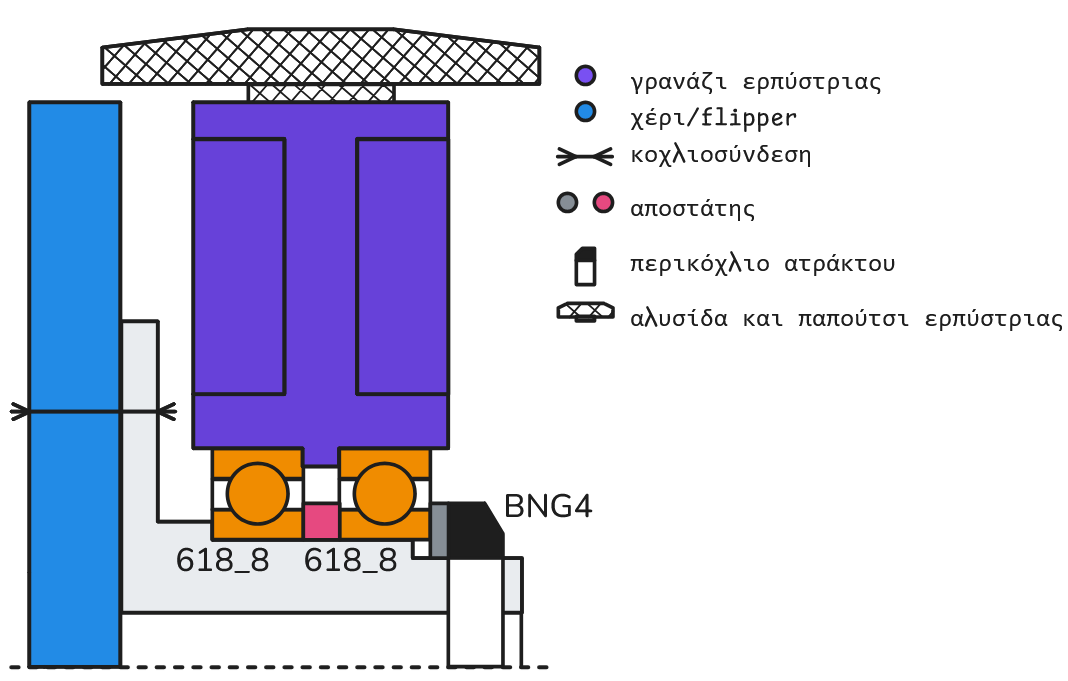
[picture p66: TeX/media/secgt.png]
    
    \caption{Σκαρίφημα συναρμολογημένης διάταξης οπίσθιου συστήματος κίνησης κατά τη δεύτερη επανάληψη του ισοζυγίου μάζας \textit{v2}.}
    \label{fig:secgt}
\end{figure}

\par Πέραν των συστημάτων κίνησης, θα πρέπει να επανασχεδιαστεί με πολύ μεγαλύτερη σαφήνεια και η έδραση του ατέρμονα κοχλία. Για να εδραστεί σωστά η άτρακτος του κοχλία θα πρέπει να δημιουργηθεί ένα σταθερό σημείο έδρασης. Αυτό επιλέγεται να γίνει στην πλευρά μακριά του κινητήρα για διευκόλυνση της συναρμολόγησης. Για να δημιουργηθούν ορθά οι εδράσεις θα πρέπει τα σημεία που πακτώνονται τα έδρανα να έχουν ικανοποιητική στιβαρότητα. Επομένως, εισάγονται στο σχεδιασμό δύο σταθεροποιητές. Αυτοί θα συνδέονται τόσο στην πλάκα ένωσης του κιβωτίου κίνησης και του σώματος όσο και στο ίδιο το σώμα μέσω κοχλισυνδέσεων. Το υλικό τους επιλέγεται για άλλη μια φορά το PEEK. Παρακάτω, στο \ref{fig:wormgt} φαίνεται το σκαρίφημα της συναρμολογημένης.
\begin{figure}[H]
    \centering
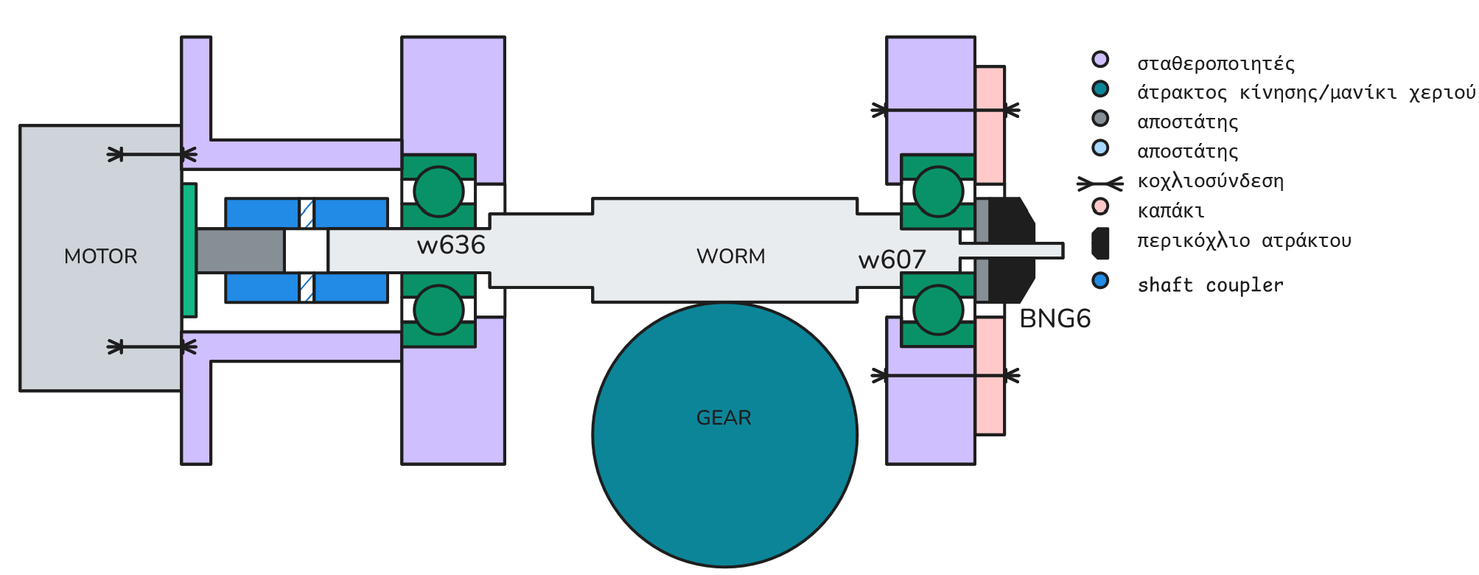
[picture p67: TeX/media/wormgt.png]
    
    \caption{Σκαρίφημα συναρμολογημένης διάταξης οπίσθιου συστήματος κίνησης κατά τη δεύτερη επανάληψη του ισοζυγίου μάζας \textit{v2}.}
    \label{fig:wormgt}
\end{figure}

\begin{figure}[H]
    \centering
    \begin{subfigure}{0.3\linewidth}
        \centering
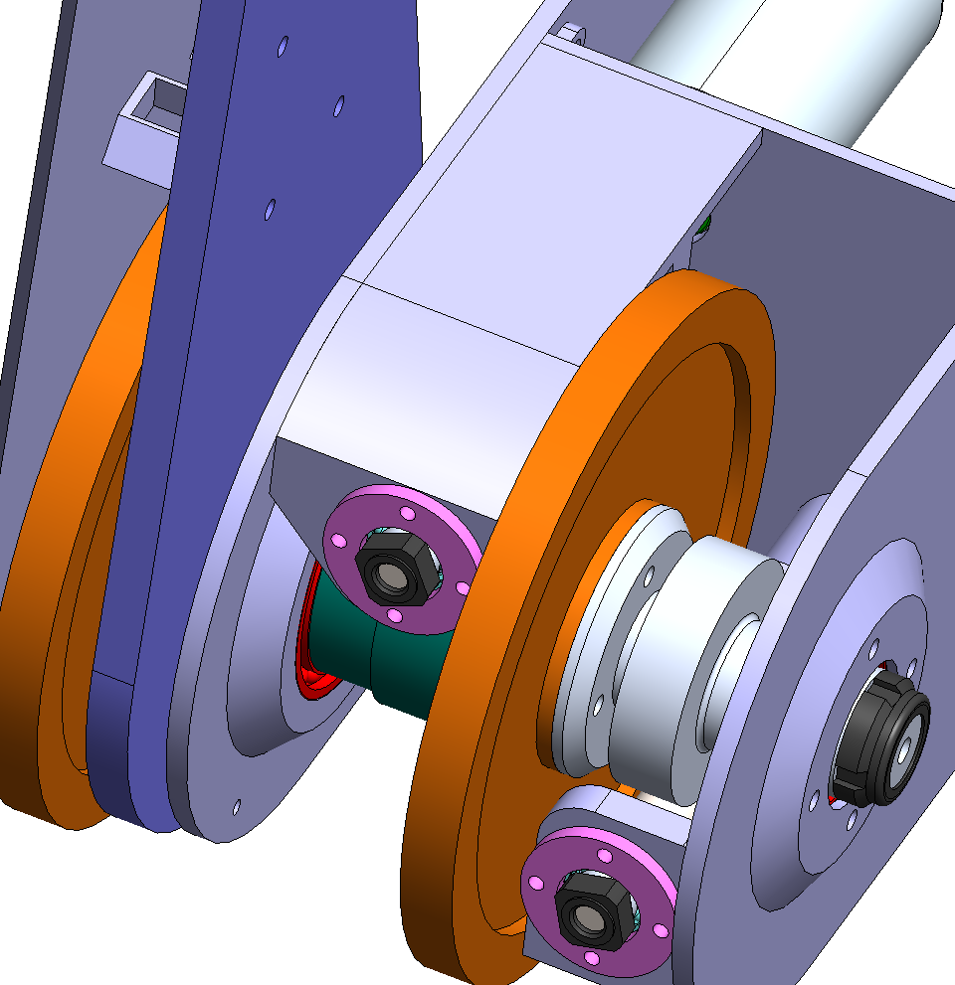
[picture p68: TeX/media/stab1.png]
        
        \caption{Άνω σταθεροποιητής.}
        \label{fig:stab1}
    \end{subfigure}
    \hfill
    \begin{subfigure}{0.3\linewidth}
        \centering
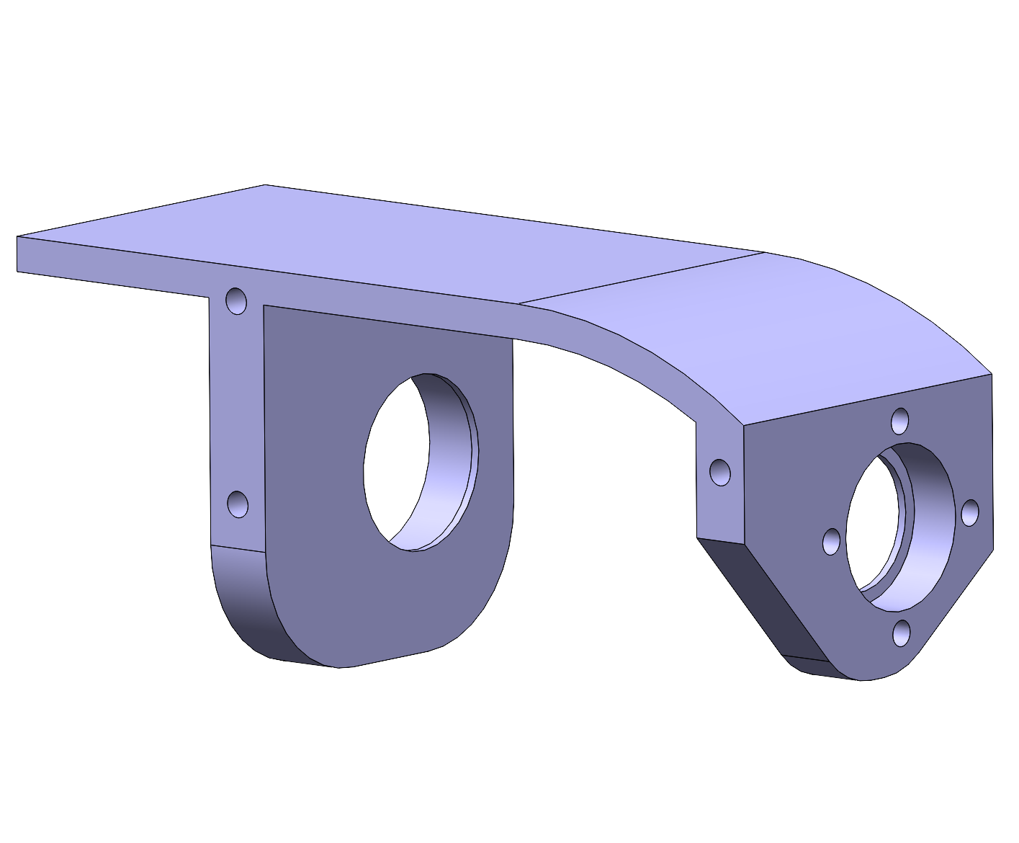
[picture p69: TeX/media/stab2.png]
        
        \caption{Αρχείο CAD.}
        \label{fig:stab2}
    \end{subfigure}
    \hfill
    \begin{subfigure}{0.3\linewidth}
        \centering
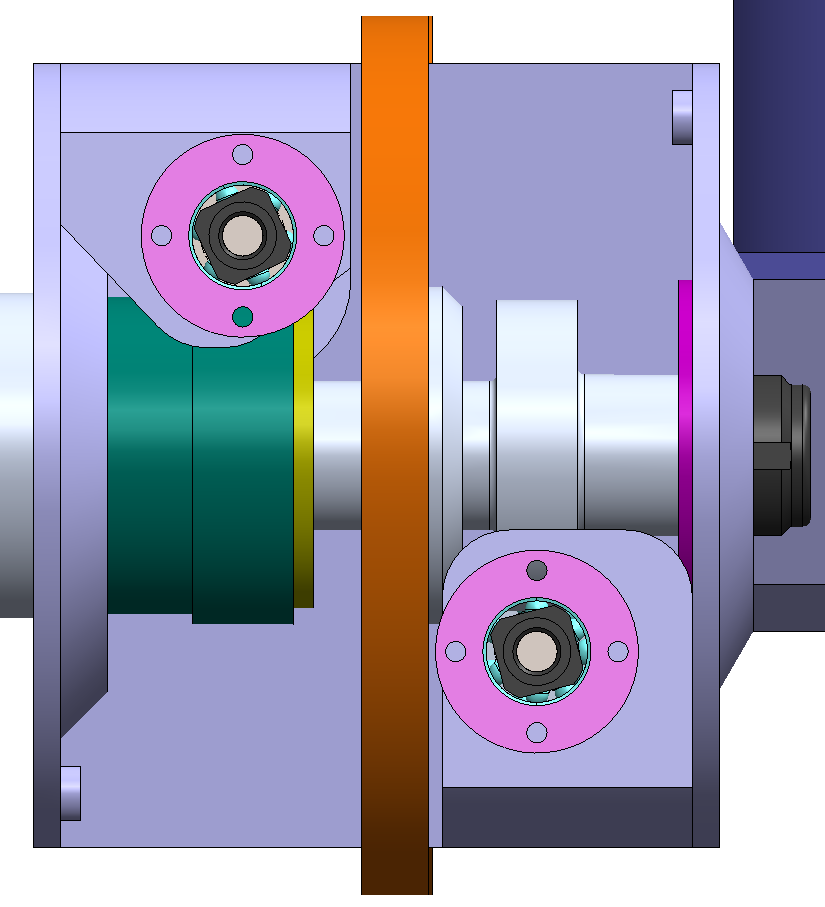
[picture p70: TeX/media/stab3.png]
        
        \caption{Άνω και κάτω σταθεροποιητές.}
        \label{fig:stab3}
    \end{subfigure}
    \caption{Σταθεροποιητές άξονα ατέρμονα κοχλία του κύριου συστήματος κίνησης.}
    \label{fig:stab}
\end{figure}

Όπως παρατηρείται παρακάτω, οι δύο σταθεροποιητές εδράζονται στην άτρακτο του ατέρμονα κοχλία, έχοντας τη σταθερή έδραση προς την αντίθετη κατεύθυνση από το σημείο εφαρμογής της ροπής από τον κινητήρα. Αυτό συμβαίνει για διευκόλυνση της συναρμολόγησης της διάταξης. Στη συναρμολόγηση, η άτρακτος εισέρχεται εντός του σταθεροποιητή από την εξωτερική του οπή και εδράζεται στην κινητό έδρανο της διάταξης, που είναι ήδη εφαρμοζμένο στον σταθεροποιητή. Οι κοχλίες σύσφιξης του καμπτικού συνδέσμου θα πρέπει να συσφιχθούν αφού φορεθεί η άτρακτος, επομένως ο αποστάτης που προεξέχει από τη πλάκα ένωσης δεν αντισκέται περιμετρικά στο έδρανο κύλισης αλλά σε ένα τόξο $270 ^\circ$, αφήνοντας άνοιγμα για το εργαλείο σύσφιξης των κοχλιών.

\begin{figure}[H]
    \centering
    \begin{subfigure}{0.45\linewidth}
        \centering
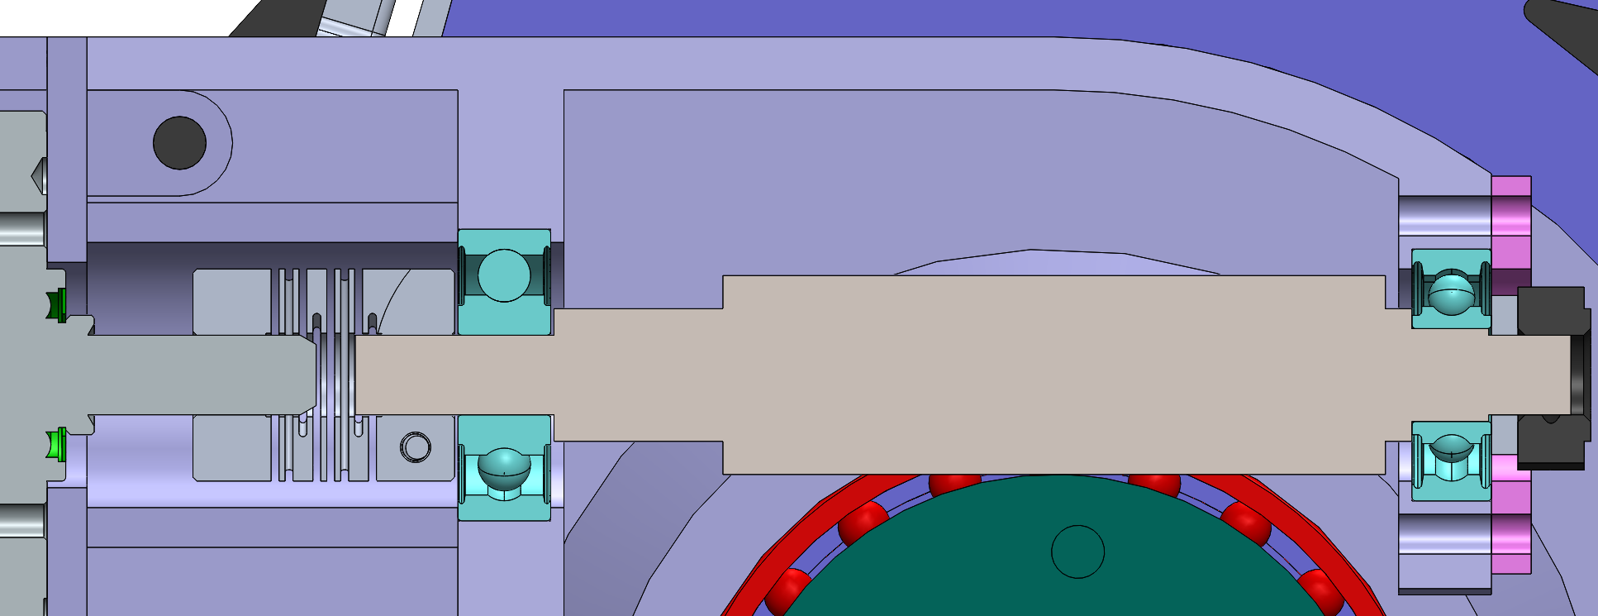
[picture p71: TeX/media/sup1.png]
        
        \caption{Άνω σταθεροποιητής.}
        \label{fig:sup1}
    \end{subfigure}
    \hfill
    \begin{subfigure}{0.45\linewidth}
        \centering
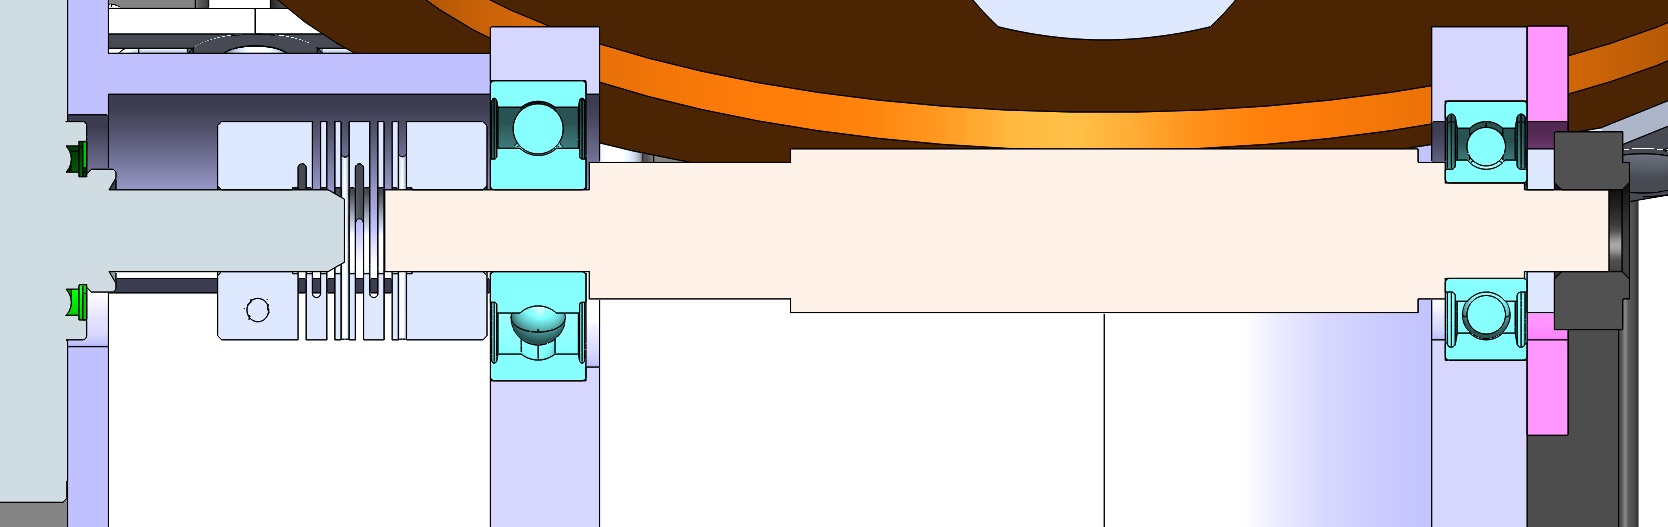
[picture p72: TeX/media/supp1.png]
        
        \caption{Κάτω σταθεροποιητής.}
        \label{fig:supp1}
    \end{subfigure}
    \caption{Τομές συναρμολογημένων διατάξεων άνω και κάτω σταθεροποιητών.}
    \label{fig:suppp}
\end{figure}

\par Εφόσον πλεόν, έχουν ορισθεί ορθά οι εδράσεις σε όλα τα σημεία του συστήματος κίνησης, θα πρέπει να επιλεχθούν τα έδρανα και τα λοιπά μηχανολογικά στοιχεία που ικανοποιούν τα κριτήρια του σχεδιασμού. Για τα έδρανα κύλισης επιλέγονται πάλι από τη βιβλίοθήκη της SKF, σφαιρικά έδρανα κύλισης που ικανοποιούν τις διαστάσεις του σχεδιασμού. Σχετικά με τα περικόχλια ατράκτου, αυτά επιλέγονται από τη βιβλιοθήκη της McMaster Carr και της MISUMI. Ο εύκαμπτος σύνδεσμος αξόνων επιλέγεται και αυτός από τον κατάλογο της McMaster Carr.

\begin{figure}[H]
    \centering
    \begin{subfigure}{0.3\linewidth}
        \centering
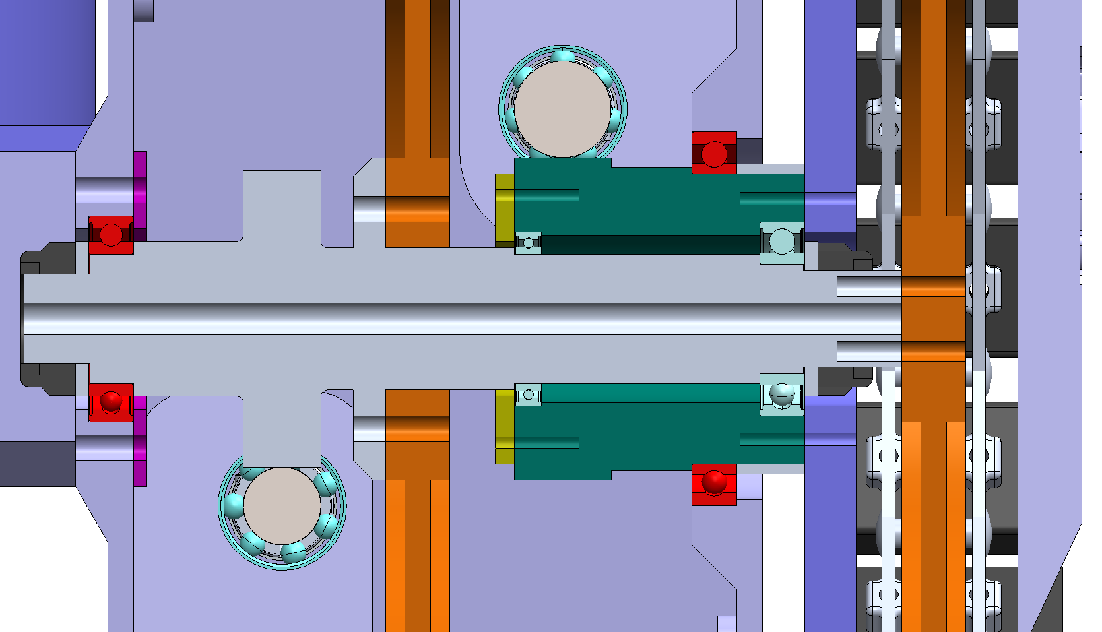
[picture p73: TeX/media/v21.png]
        
        \caption{Κύριο σύστημα κίνησης.}
        \label{fig:v21}
    \end{subfigure}
    \hfill
    \begin{subfigure}{0.3\linewidth}
        \centering
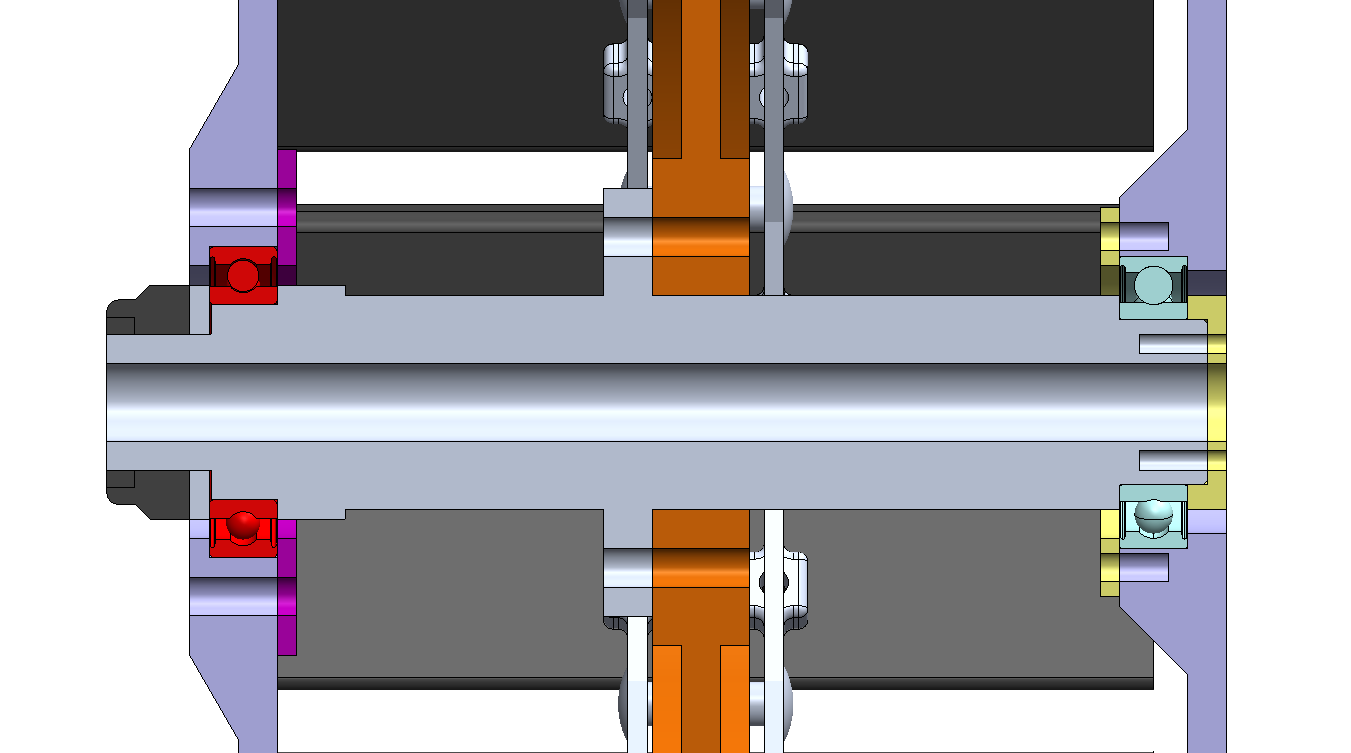
[picture p74: TeX/media/v22.png]
        
        \caption{Οπίσθιο σύστημα κίνησης.}
        \label{fig:v22}
    \end{subfigure}
    \hfill
    \begin{subfigure}{0.3\linewidth}
        \centering
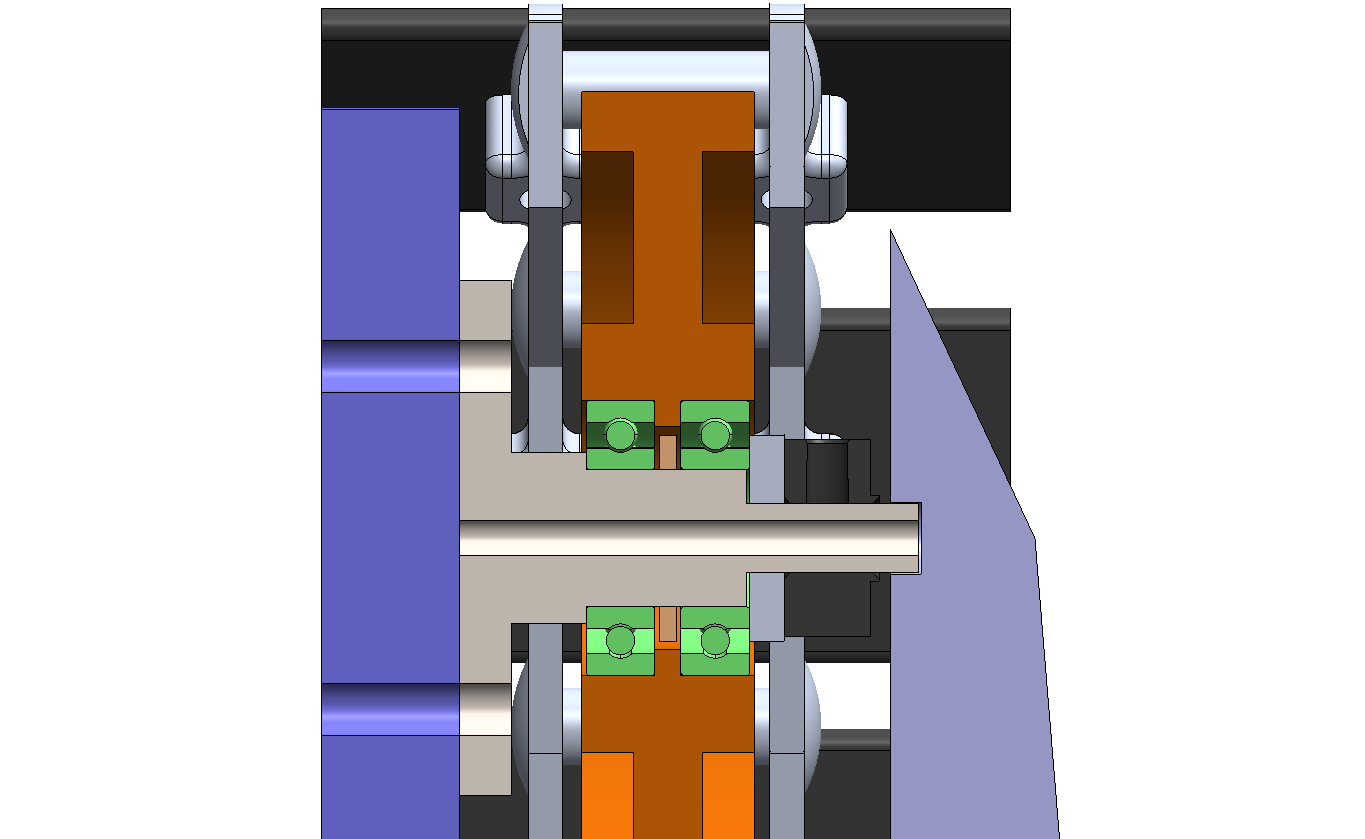
[picture p75: TeX/media/v23.png]
        
        \caption{Δευτερεύον σύστημα κίνησης.}
        \label{fig:v23}
    \end{subfigure}
    \caption{Τομές συναρμολογημένων διατάξεων συστημάτων κίνησης κατά τη δεύτερη επανάληψη του ισοζυγίου μάζας \textit{v2}.}
    \label{fig:v222}
\end{figure}

\begin{figure}[H]
    \centering
    \begin{subfigure}{0.45\linewidth}
        \centering
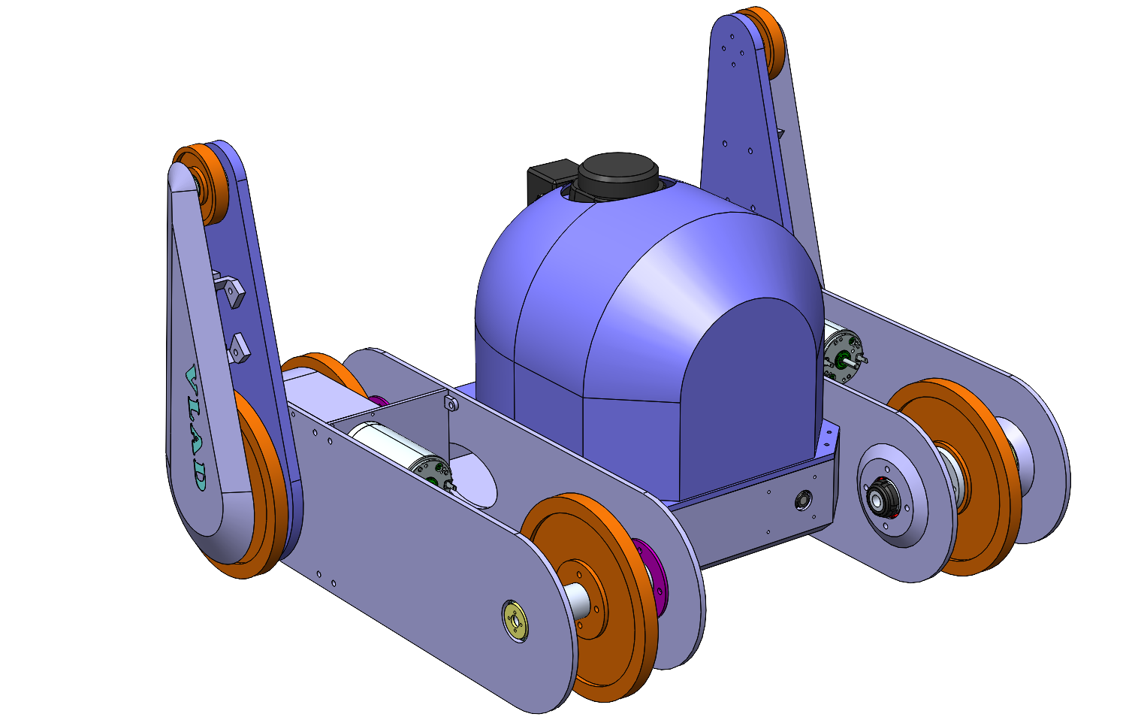
[picture p76: TeX/media/notracksV2.png]
        
        \caption{Διμετρική όψη.}
        \label{fig:notracksV2}
    \end{subfigure}
    \hfill
    \begin{subfigure}{0.45\linewidth}
        \centering
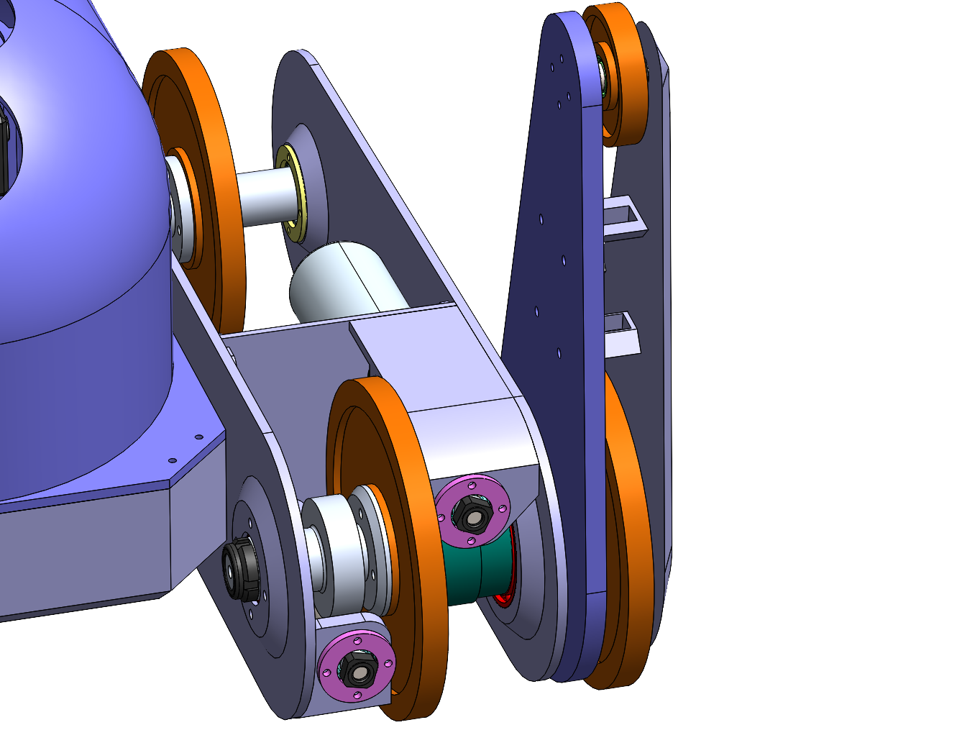
[picture p77: TeX/media/notracksV22.png]
        
        \caption{Λεπτομέρειες σχεδιασμού.}
        \label{fig:notracksV22}
    \end{subfigure}
    \caption{Λεπτομέρειες συστήματος κίνησης της πλατφόρμας V.L.A.D. κατά τη δεύτερη επανάληψη του ισοζυγίου μάζας \textit{v2}.}
    \label{fig:notracksV222}
\end{figure}

\begin{figure}[H]
    \centering
    \begin{subfigure}{0.45\linewidth}
        \centering
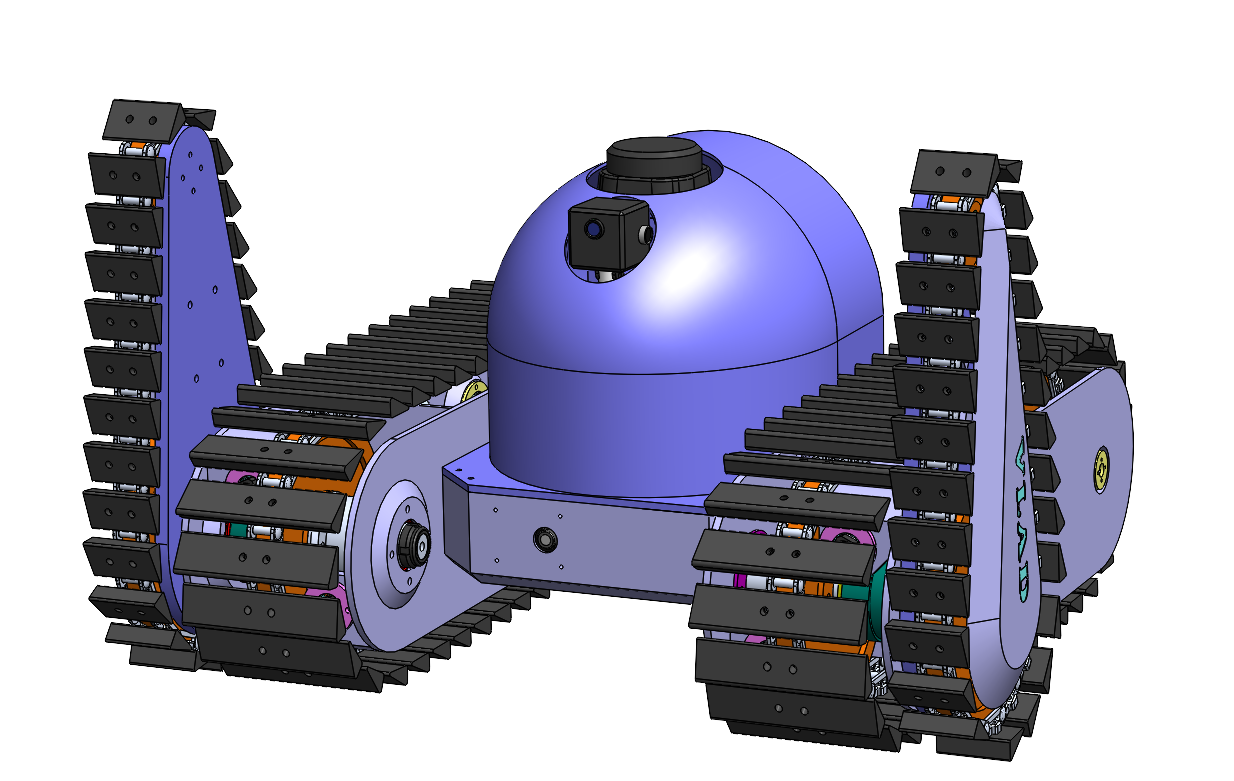
[picture p78: TeX/media/v2full.png]
        
        \caption{Διμετρική όψη.}
        \label{fig:v2full}
    \end{subfigure}
    \hfill
    \begin{subfigure}{0.45\linewidth}
        \centering
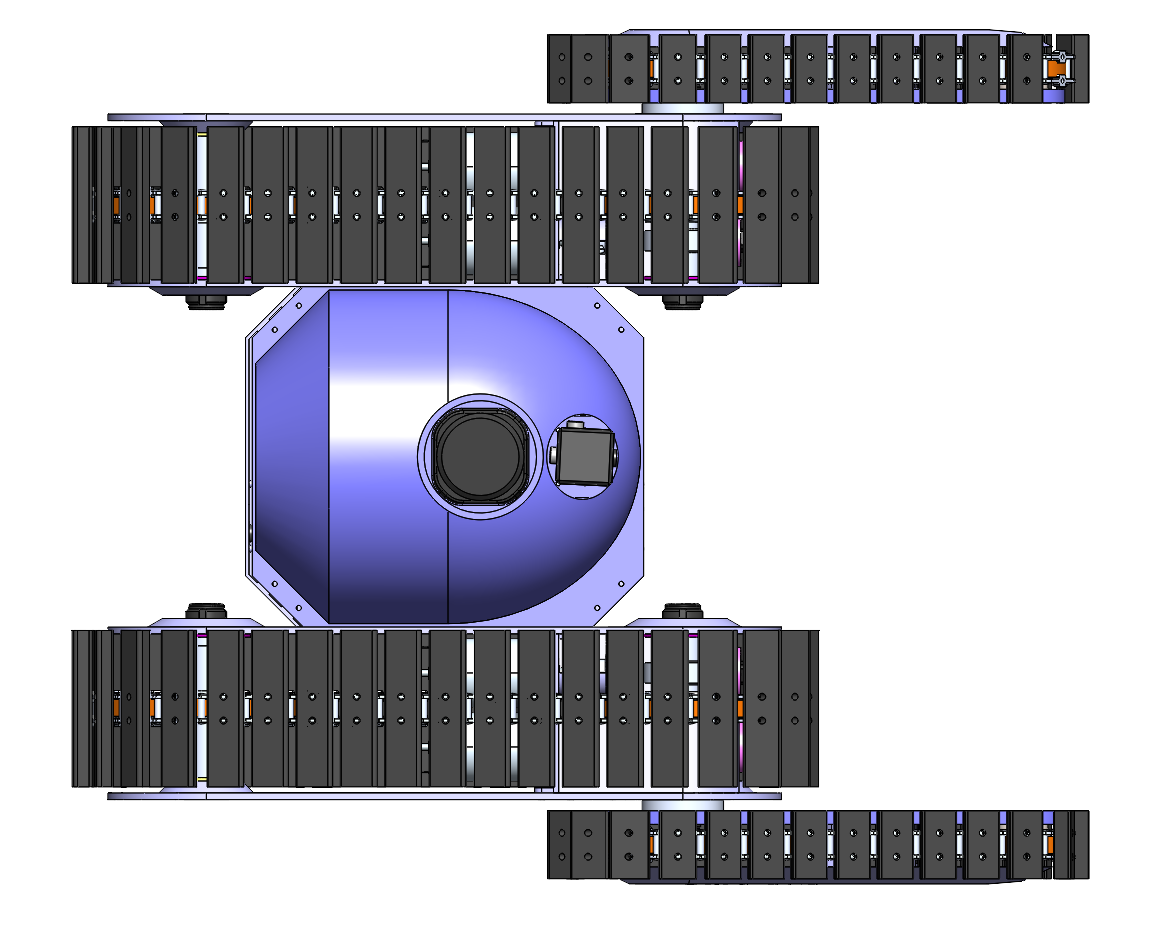
[picture p79: TeX/media/v2TOP.png]
        
        \caption{Κάτοψη.}
        \label{fig:v2TOP}
    \end{subfigure}
    \caption{Τρισδιάστατη απεικόνιση πλατφόρμας V.L.A.D. κατά τη δεύτερη επανάληψη του ισοζυγίου μάζας \textit{v2}.}
    \label{fig:v2y}
\end{figure}

\begin{figure}[H]
    \centering
    \begin{subfigure}{0.45\linewidth}
        \centering
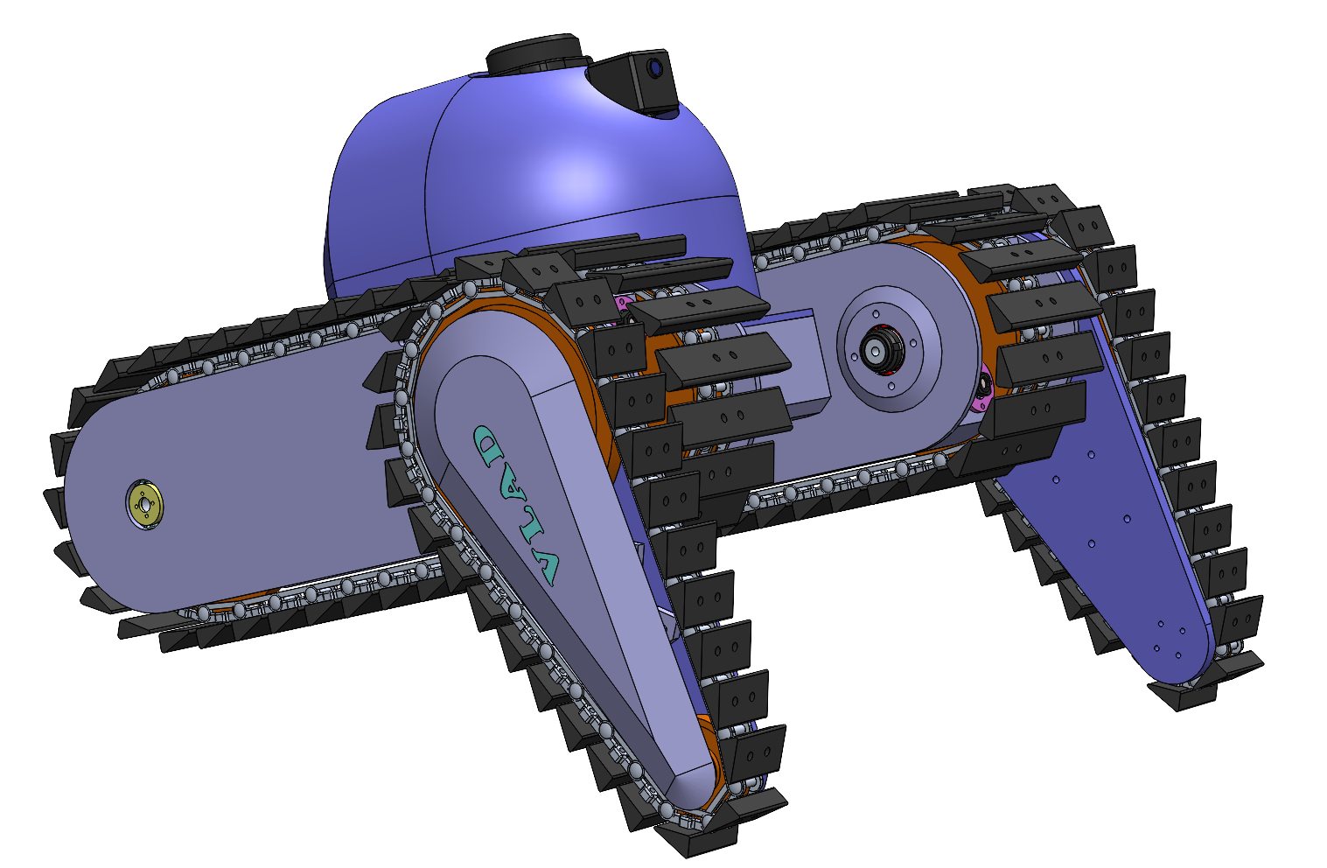
[picture p80: TeX/media/v2Full2.png]
        
        \caption{Αναρρίχηση εμποδίων.}
        \label{fig:v2Full2}
    \end{subfigure}
    \hfill
    \begin{subfigure}{0.45\linewidth}
        \centering
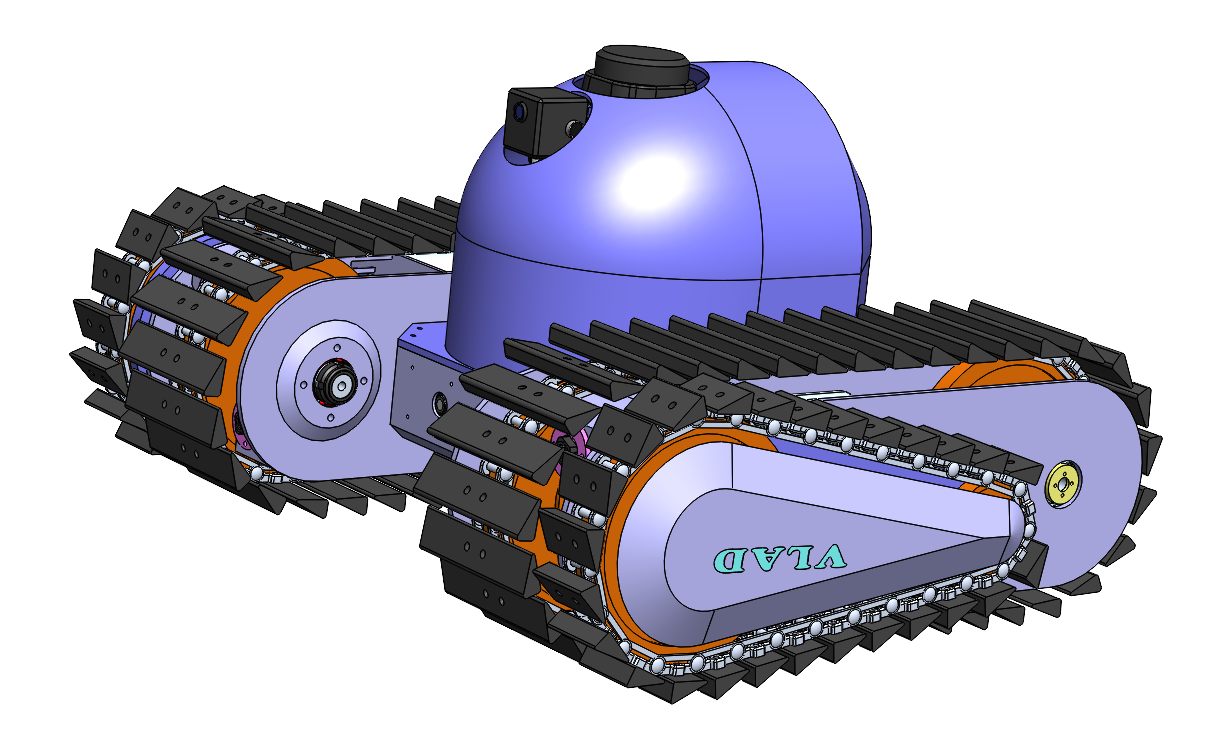
[picture p81: TeX/media/v2Full3.png]
        
        \caption{Εξοικονόμιση χώρου.}
        \label{fig:v2Full3}
    \end{subfigure}
    \caption{Μερικές λειτουργίες της πλατφόρμας V.L.A.D. κατά τη δεύτερη επανάληψη του ισοζυγίου μάζας \textit{v2}.}
    \label{fig:V2FUN}
\end{figure}

\par Κατά την δεύτερη επανάληψη, έγινε και μια πιο ορθή εκτίμηση του βάρους των μηχανολογικών εξαρτημάτων, του φορτίου μεταφοράς (payload) και των ηλεκτρονικών. Αυτή η εκτίμηση καθτέστη δυνατή, λόγω του πιο εμπερειστατωμένου και αναλυτικού ορισμού των στοιχείων αυτών. Η συνολική μάζα της πλατφόρμας, με όλες τις αλλαγές που περιγράφηκαν σε αυτά τα κεφάλαια, μειώθηκε κατά περίπου 10 κιλά. Μια πολύ σημαντική μείωση με σκοπό τη βελτιστοποίηση της αποόδοσης του διασώστη, που αποτελεί ένα πολύ πιο ολοκληρωμένο σημείο εκκίνησης για τον διαμορφωτικό σχεδιασμό του V.L.A.D. Στον \ref{tab:massBudgetV2} φαίνονται αναλυτικά τα στοιχεία της κατασκευής και το ισοζύγιο μάζας κατά τη δεύτερη επανάληψη. Εδώ, σαν λοιπά μηχανολογικά στοιχεία έχουν θεωρηθεί και οι διάφοροι αποστάτες για σταθεροποίηση των εδράσεων. Έχει επίσης σχεδιαστεί ένα καπάκι για τον βραχίονα, με σκοπό τη προστασία των τροχών στην εξωτερική μεριά του, που φέρει και το ακρωνύμιο της πλατφόρμας.

\begin{table}[H]
    \centering
    \rowcolors{2}{gray}{white}
\begin{tabular}{|l|l|c|r|r|}
\hline
\rowcolor{Periwinkle}
\multicolumn{1}{|c|}{Part} & \multicolumn{1}{c|}{Material} & \multicolumn{1}{c|}{Qty} & \multicolumn{1}{c|}{Unit Mass (g)} & \multicolumn{1}{c|}{Total Mass (g)} \\
\hline
\rowcolor{YellowGreen}
\multicolumn{5}{|c|}{Mobility Subsystem} \\
\hline
Σύνδεσμος κύριας ερπύστριας & 2024 Τ4/Rubber & 37 & 18.05 & 667.85 \\
\hline
Σύνδεσμος δευτερεύουσας ερπύστριας & 2024 Τ4/Rubber & 27 & 10.17 & 274.59 \\
\hline
Περιστρεφόμενος βραχίονας & 2024 T4 & 2 & 515.88 & 1031.76 \\
\hline
Άτρακτος περιστρεφόμενου βραχίονα & 2024 T4 & 2 & 146.42 & 292.84 \\
\hline
Πλάκα ένωσης σώματος-κιβωτίου & 2024 T4 & 2 & 108 & 216 \\
\hline
Δευτερεύουσα άτρατκος & Steel & 2 & 22.23 & 44.46 \\
\hline
Ελεύθερος τροχός δευτερεύουσας ερπύστριας & 2024 T4 & 2 & 35.39 & 70.78 \\
\hline
Τροχός κύριας ερπύστριας & 2024 T4 & 4 & 231.27 & 925.08 \\
\hline
Τροχός δευτερεύουσας ερπύστριας & 2024 T4 & 2 & 223.11 & 446.22 \\
\hline
Κύρια εμπρόσθια άτρακτος & 2024 T4 & 2 & 175.8 & 351.6 \\
\hline
Κύρια οπίσθια άτρακτος & 2024 T4 & 2 & 108.12 & 216.24 \\
\hline
Εξωτερικό καπάκι κιβωτίου κίνησης & Zoltek Panex 33 & 2 & 329.7 & 659.4 \\
\hline
Ατέρμονας κοχλίας κύριας ερπύστριας & Steel & 2 & 52.02 & 104.04 \\
\hline
Ατέρμονας κοχλίας περιστρεφόμενου βραχίονα & Steel & 2 & 82.2 & 164.4 \\
\hline
Σταθεροποιητής ατέρμονα ερπύστριας & PEEK & 2 & 45.08 & 90.16 \\
\hline
Σταθεροποιητής ατέρμονα βραχίονα & PEEK & 2 & 37.67 & 75.34 \\
\hline
Καπάκι βραχίονα & PEEK & 2 & 179.53 & 359.06 \\
\hline
Καπάκι σταθεροποίησης εδράνου ατράκτου βραχίονα & 2024 T4 & 2 & 9.08 & 18.16 \\
\hline
Λοιπά μηχανολογικά στοιχεία & Var. & 1 & 1500.0 & 1500.0 \\
\hline

\rowcolor{YellowGreen}
\multicolumn{5}{|c|}{Body Subsystem} \\
\hline
Κάτω μέρος σώματος & Zoltek Panex 33 & 1 & 1180.5 & 1180.5 \\
\hline
Άνω μέρος σώματος & PEEK & 1 & 778.43 & 778.43 \\
\hline
Payload & Var. & 1 & 2000.0 & 2000.0 \\
\hline
Λοιπά στοιχεία & Var. & 1 & 200.0 & 200.0 \\
\hline

\rowcolor{YellowGreen}
\multicolumn{5}{|c|}{Electronics Hardware} \\
\hline
LiDAR Unit & - & 1 & 380.0 & 380.0 \\
\hline
Thermal Camera & - & 1 & 30.0 & 30.0 \\
\hline
Λοιποί αισθητήρες & - & 1 & 50.0 & 50.0 \\
\hline
Μπαταρία & - & 1 & 2000.0 & 2000.0 \\
\hline
Κινητήρες ερπύστριας & - & 2 & 820.0 & 1640.0 \\
\hline
Κινητήρες βραχίονα & - & 2 & 480.0 & 960.0 \\
\hline
Λοιπά ηλεκτρονικά & - & 1 & 100.0 & 100.0 \\
\hline
\rowcolor{BlueGreen}
\multicolumn{4}{|c|}{Grand Total Mass} & $17.33\; kg$ \\
\hline
\end{tabular}

    \caption{Ισοζύγιο μάζας \textit{v2}.}
    \label{tab:massBudgetV2}
\end{table}

\newpage

\begin{figure}[H]
    \centering
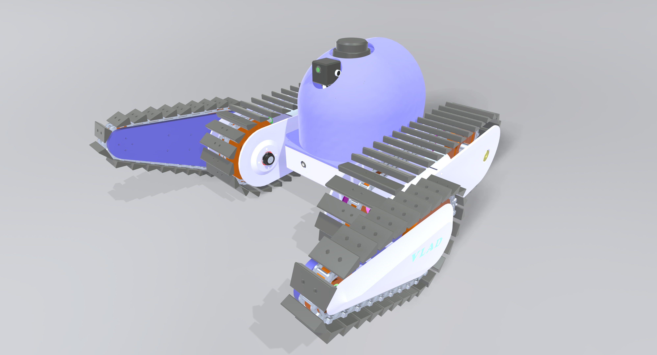
[picture p82: TeX/media/rr5.png]
    
    \caption{Render 1 ρομποτικού διασώστη V.L.A.D.}
    \label{fig:re1}
\end{figure}

\begin{figure}[H]
    \centering
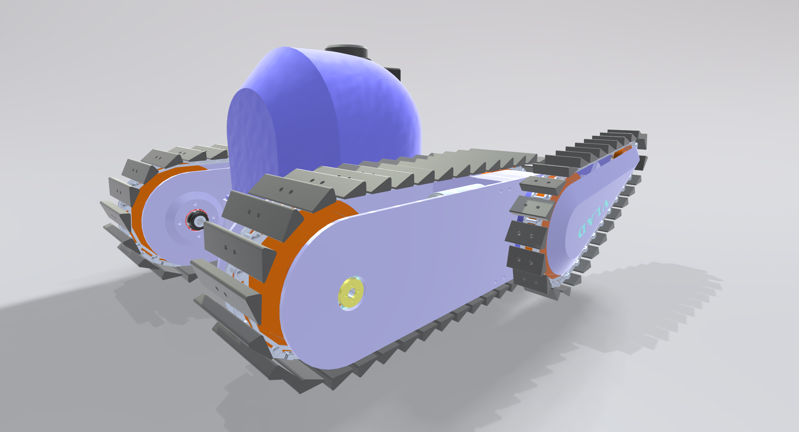
[picture p83: TeX/media/rr4.png]
    
    \caption{Render 2 ρομποτικού διασώστη V.L.A.D.}
    \label{fig:re2}
\end{figure}

\begin{figure}[H]
    \centering
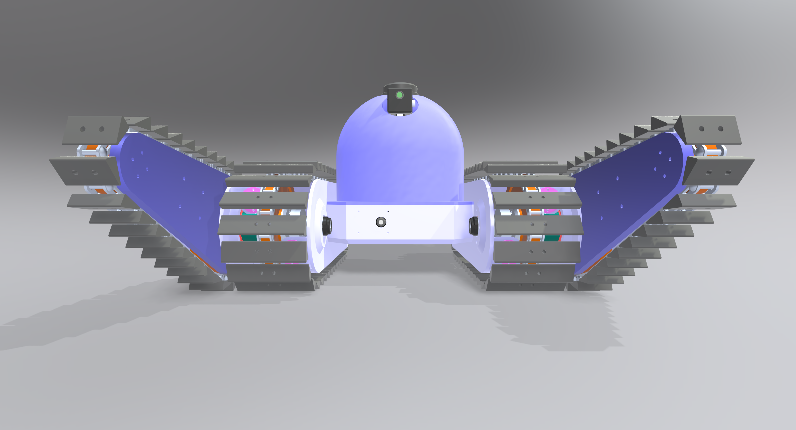
[picture p84: TeX/media/rr6.png]
    
    \caption{Render 3 ρομποτικού διασώστη V.L.A.D.}
    \label{fig:re3}
\end{figure}

\begin{figure}[H]
    \centering
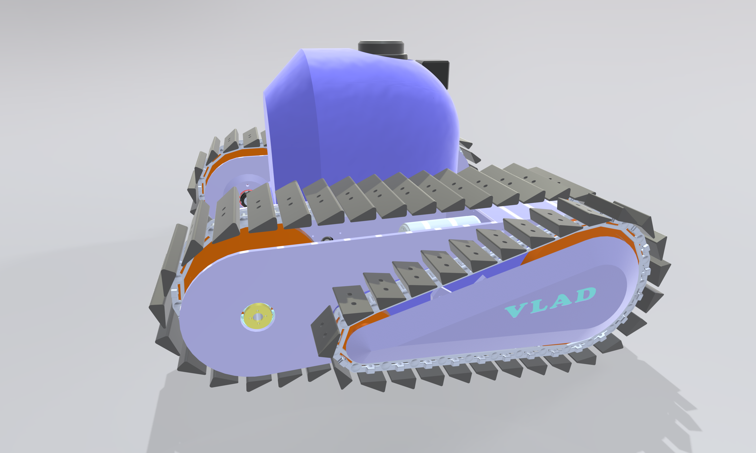
[picture p85: TeX/media/rr7.png]
    
    \caption{Render 4 ρομποτικού διασώστη V.L.A.D.}
    \label{fig:re4}
\end{figure}

\newpage

\section{Ισοζύγιο ισχύος και εκλογή κινητήρων}

\subsection{Απαιτήσεις ροπής και εκλογή κινητήρων}

Έχοντας πλέον τη συνολική εκτιμώμενη μάζα της πλατφόρμας V.L.A.D., για να κλείσει το κεφάλαιο του προκαταρτικού σχεδιασμού, πρέπει να επιλεχθούν κινητήρες για τη κύρια ερπύστρια αλλά και για τους βραχίονες. Αρχικά πρέπει να γίνει εκτίμηση της απαιτούμενης ροπής για τους δύο κινητήρες.
Σχετικά με τον κινητήρα της κύριας ερπύστριας, αυτός θα πρέπει να είναι ικανός για εκκίνηση σε κεκλιμένο επίπεδο. Πιο συγκεκριμένα της μέγιστης εκλεγμένης γωνίας κεκλιμένου $a = 50^\circ$.
\begin{figure}[H]
    \centering
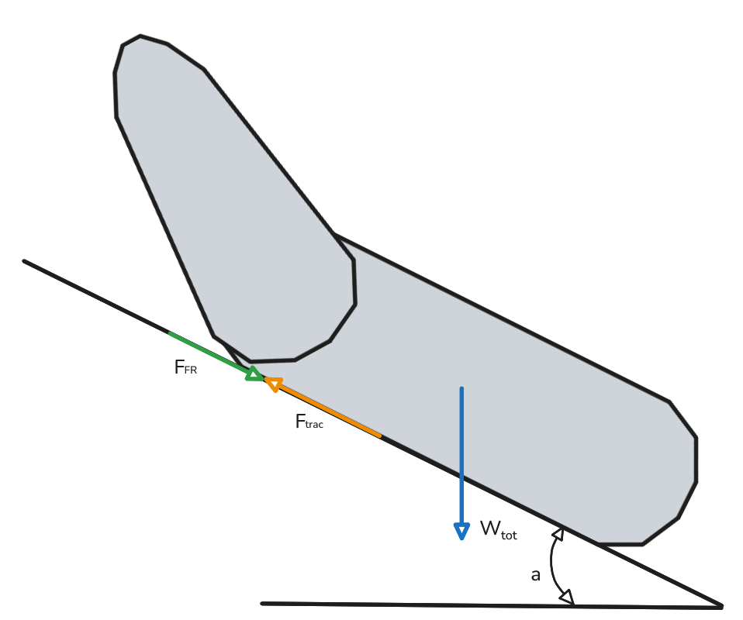
[picture p86: TeX/media/torque1.png]
    
    \caption{Υπολογισμός ροπής κινητήρα κύριας ερπύστριας.}
    \label{fig:torque1}
\end{figure}

Για να υπολογιστεί η ροπή, απαιτείται ο γεωμετρικός ορισμός των οδοντοκινήσεων. Ορίζοντας αρχικά, τη διάμετρο του τροχού κίνησης της ερπύστριας $D_s = 130\;mm$ και υποθέτοντας μια ταχύτητα ως στόχο της πλατφόρμας στα $V = 200 mm/s$, μπορούν να υπολογιστούν μερικά γεωμετρικά μεγέθη παρακάτω.
\par Ορίζεται επίσης η κύρια διάμετρος της οδοντοκίνησης του οδοντωτού τροχού της ατράκτου $D_G = 46\; mm$ και η απόσταση των κέντρων του ατέρμονα και του γραναζιού ως $C = 29\;mm $. Θεωρώντας μία οδόντωση με μία εκκίνηση για τον ατέρμονα $N_W = 1$ και ένα βήμα για την οδόντωση του γραναζιού $p_G = 0.61 \; teeth/mm$, προκύπτει ο αριθμός δοντιών του τροχού:
\begin{equation}
N_G = ROUND(p_G\cdot D_2)
\end{equation}

Επίσης, από την απόσταση των κεντρών μπορεί να προκύψει η κύρια διάμετρος της οδόντωσης του ατέρμονα:
\begin{equation}
D_W = 2\cdot C - D_G
\end{equation}

Το αξονικό βήμα του ατέρμονα είναι:
\begin{equation}
p_x = \pi \cdot \frac{D_2}{N_G}
\end{equation}

Μπορεί λοιπόν να προκύψει η γραμμική απόσταση που διανύει ένα σημείο σε πλήρη περιστροφή του ατέρμονα (πρόωση):
\begin{equation}
L_x = p_x \cdot N_W
\end{equation}

Έτσι, προκύπτει η γωνία ελίκωσης του ατέρμονα:
\begin{equation}
\lambda = arctan(\frac{L_x}{\pi \cdot D_W})
\end{equation}

Στη συνέχεια, προκύπτει η κάθετη γωνία πίεσης της οδόντωσης ακολουθώντας τις συστάσεις του συγγράματος των Shigley J. κ.ά. \cite{handbook} για την επιλογή της $\phi_n$ συναρτήσει της γωνίας ελίκωσης με σκοπό την αποφυγή του φαινομένου της υποκοπής:
\begin{equation}
    \phi_n = \begin{cases} 
      20^{\circ} & \text{if } \lambda < 30^{\circ} \\
      25^{\circ} & \text{if } 30^{\circ} \leq \lambda \leq 45^{\circ}
    \end{cases}
\end{equation}

Τέλος, πρέπει να υπολογιστεί ο συντελεστής τριβής. Με την υπόθεση της ταχύτητας μπορεί να προκύψει η περιστροφική ταχύτητα του τροχού:
\begin{equation}
n_G = 60\frac{V}{\pi \cdot D_G}
\end{equation}

Έχοντας τον αριθμό των δοντιών της συγκεκριμένης οδοντοκίνησης μπορεί να προκύψει η σχέση μετάδοσης που προκύπτει ξέροντας ότι ο κινητήριος τροχός είναι ο ατέρμονας:
\begin{equation}
i _D = \frac{D_G}{D_W}
\end{equation}

Μέσω της σχέσης μετάδοσης υπολογίζεται πλεόν η περιστροφική ταχύτητα του ατέρμονα:
\begin{equation}
n_W = n_G \cdot i_D
\end{equation}

Και έτσι προκύπτει η ταχύτητα ολίσθησης της οδοντοκίνησης ως:
\begin{align}
V_W &= \frac{D_W \cdot n_W \cdot \pi }{60}\\

V_s &= \frac{V_W}{cos\lambda}
\end{align}

\begin{figure}[H]
    \centering
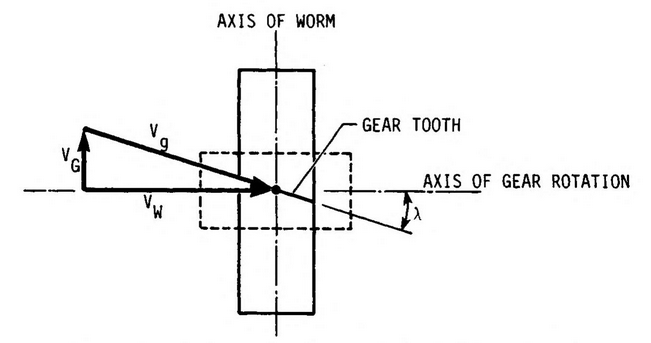
[picture p87: TeX/media/Vs.png]
    
    \caption{Συνιστώσες ταχύτητας σε μια οδοντοκίνηση ατέρμονα - τροχού.}
    \label{fig:Vs}
\end{figure}

Έχοντας πλέον τη ταχύτητα ολίσθησης μπορεί να υπολογιστεί ο συντελεστής τριβής της οδοντοκίνησης από το \ref{fig:mu}.
\begin{figure}[H]
    \centering
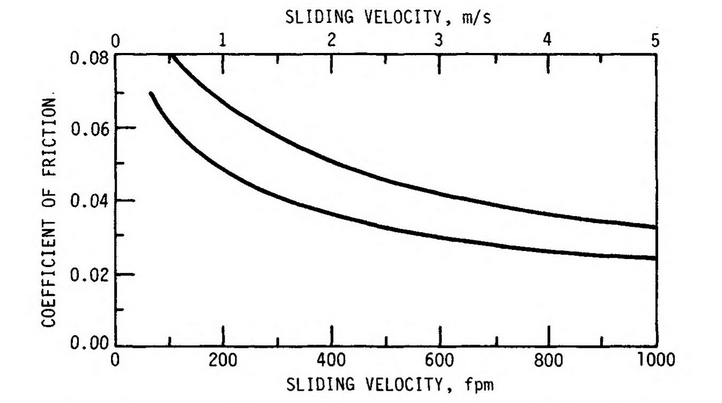
[picture p88: TeX/media/mu.png]
    
    \caption{Συντελεστής τριβής συναρτήσει της ταχύτητας ολίσθησης. Θεωρείται επαρκής λίπανση. Η άνω καμπύλη αναφέρεται σε μη επισκληρημένα υλικά οδοντώσεων ενώ η κάτω σε βέλτιστα υλικά οδοντοκίνησης ατέρμονα - τροχού \cite{handbook}.}
    \label{fig:mu}
\end{figure}

Υπολογίζεται τελικά παρακάτω η αποδοτικότητα της οδοντοκίνησης:
\begin{equation}
\eta_D = \frac{cos\phi_n - \mu \cdot tan\lambda}{cos\phi_n + \mu \cdot cot\lambda}
\end{equation}

Από το \ref{fig:torque1}, προκύπτει ότι η απαιτούμενη δύναμη ώθησης του κινητήρα για εκκίνηση σε κεκλιμένο επίπεδο, θεωρώντας πολύ μικρή επιτάχυνση της πλατφόρμας, είναι:
\begin{align}

F_W &= W_{tot} \cdot sina\\
F_{Fr} &= \mu_a \cdot W_{tot} \cdot  cosa\\

F_{trac} &= F_{Fr} + F_W\\
\end{align}
Όπου, $\mu_a$ είναι ο συντελεστής τριβής της ασφάλτου με το υλικό του πέλματος της ερπύστριας (Rubber), και $W_{tot}$, το συνολικό βάρος της κατασκευής. Επομένως, η απαιτούμενη ροπή του κινητήρα της ερπύστριας υπολογίζεται μέσω της απαιτούμενης ροπής της ατράκτου $T_D = F_{trac} \cdot \frac{D_s}{2}$ και της σχέσης μετάδοσης της οδοντοκίνησης:
\begin{equation}
T_{M_{D}} = \frac{F_{trac} \cdot R_s}{i_D\cdot \eta_D}
\end{equation}

Με εντελώς όμοιο τρόπο, προκύπτουν και η σχέση μετάδοσης $i_F$ και απόδοσης $\eta_F$ της οδοντοκίνησης του βραχίονα, θεωρώντας, $C = 32.5\; mm$, $D_G = 50\;mm$, $p_G = 0.5\; teeth/mm$, $n_W = 1$. O κινητήρας του βραχίονα θα πρέπει να είναι ικανός να ανασηκώσει το βάρος του διασώστη από μηδενική γωνία του βραχίονα με το έδαφος. Όταν δηλαδή ο βραχίονας προσπαθεί να ανασηκώσει τη πλατφόρμα όντας πλήρως επιμηκυνμένος.
\begin{figure}[H]
    \centering
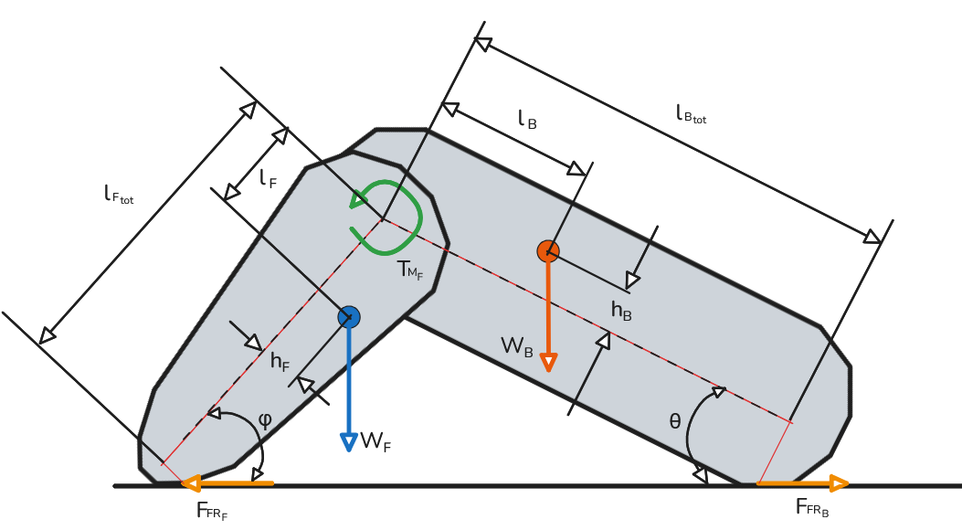
[picture p89: TeX/media/torque2.png]
    
    \caption{Υπολογισμός ροπής κινητήρα βραχίονα.}
    \label{fig:torque2}
\end{figure}

Από το νόμο των συνημιτόνων:
\begin{equation}
\frac{sin\phi}{l_{B_{tot}}} = \frac{sin\theta}{l_{F_{tot}}}
\end{equation}

Προκύπτει εν τέλει απαιτούμενη ροπή της ατράκτου του βραχίονα:
\begin{equation}
T_{F} = w_F \cdot cos\theta \cdot l_F + w_F \cdot sin \phi \cdot h_F + w_B \cdot cos\theta\cdot l_B -w_B \cdot sin\theta \cdot h_B + \mu \cdot w_F \cdot cos\phi \cdot l_{F_{tot}} - \mu\cdot w_B \cdot cos\phi \cdot  l_{B_{tot}}
\end{equation}

Επομένως, υποθέτοντας πολύ μικρή γωνιακή επιτάχυνση η απαιτούμενη ροπή του κινητήρα προκύπτει:
\begin{equation}
T_{M_{F}} = \frac{T_{F}}{i_F\cdot \eta_F}
\end{equation}

Στον \ref{tab:calcTorque} φαίνονται οι υπολογισμοί για τις απαιτούμενες ροπές των κινητήρων. Με βάση τα παρακάτω επιλέγονται κινητήρες από την MAXON που ικανοποιούν τόσο τις απαιτήσεις χώρου αλλά και τις απαιτήσεις ροπής. Τα μοντέλα που επιλέχθηκαν είναι οι κινητήρες συνεχούς ρεύματος \textbf{EC-i 579165 52} και \textbf{EC-i 666603 40} για την \textbf{ερπύστρια} και τον \textbf{βραχίονα} αντίστοιχα.

\begin{table}[H]
    \centering
    \rowcolors{2}{gray}{white}
\begin{tabular}{|c|c|c|}
\hline
\rowcolor{Periwinkle}
Variable & Symbol & Calculation\\
\hline
\rowcolor{Dandelion}
\multicolumn{3}{|c|}{Tracks Gear Interface}\\
\hline
Worm Pitch Diameter & $D_W^T\; [mm]$ & 12\\
\hline
Worm Lead Angle & $\lambda^T\; [^\circ]$ & 7.8\\
\hline
Tracks Gear Ratio & $i_D$ & 28\\
\hline
Tracks Gear Efficiency & $\eta_D\; [\%]$ & 60.94\\
\hline
\rowcolor{Dandelion}
\multicolumn{3}{|c|}{Flipper Gear Interface}\\
\hline
Worm Pitch Diameter & $D_W^F\; [mm]$ & 15\\
\hline
Worm Lead Angle & $\lambda^F\; [^\circ]$ & 7.59\\
\hline
Tracks Gear Ratio & $i_F$ & 25\\
\hline
Tracks Gear Efficiency & $\eta_F\; [\%]$ & 63.52\\
\hline
\rowcolor{Dandelion}
\multicolumn{3}{|c|}{Motors Torque}\\
\hline
Main Shaft Torque Required &  $T_D\; [Nm]$ & 6.203\\
\hline
Tracks Motor Torque Required &  $T_{M_D}\; [Nm]$ & 0.364\\
\hline
Flipper Shaft Torque Required &  $T_F\; [Nm]$ & 3.375\\
\hline
Flipper Motor Torque Required &  $T_{M_D}\; [Nm]$ & 0.213\\
\hline
\end{tabular}
\caption{Υπολογισμοί απαιτούμενης ροπής κινητήρων.}
\label{tab:calcTorque}
\end{table}

Υπολογίζοντας ένα περιθώριο ασφάλειας για τον κάθε κινητήρα ως:
\begin{equation}
MoS\; [\%] = \frac{\text{Nominal Motor Torque}}{\text{Required Torque}} - 1
\end{equation}

Πλέον, τα βάρη των κινητήρων προσθέτονται στο ισοζύγιο μάζας για τη τελικό υπολογισμό του βάρους της πλατφόρμας, το οποίο καταλήγει όπως αναγράφεται στον πίνακα \ref{tab:massBudgetV2}.
\par Τέλος, για τον κινητήρα της κάμερας, καθώς δεν υπάρχει απαίτηση στη ροπή, επιλέγεται ένας βηματικός κινητήρας τύπου NEMA 11 τεσσάρων φάσεων. Αυτός έχει ικανοποιητική ροπή για να περιστρέψει το βάρος της κάμερας και απαιτεί τυπική επιλογή σε παρόμοιες εφαρμογές.

\begin{table}[H]
    \centering
    \rowcolors{2}{gray}{white}
        \begin{tabular}{|c|c|c|c|c|c|}
        \hline
        \rowcolor{Dandelion}
        Part Number & Shell Diameter & Wattage  & Max Continuous Torque & Nominal Speed & $MoS$\\
        \hline
        EC-i 579165 52 & $\varnothing 52\;mm$ &$180\; W$ & $0.423\; Nm$ & $4470\; rpm$ & $16\%$\\
        \hline
        EC-i 666603 40 & $\varnothing 40\;mm$ &$130\; W$ & $0.343\; Nm$ & $3910\; rpm$ & $46\%$ \\
        \hline
        \end{tabular}
    \caption{Επιλεγμένοι κινητήρες συνεχούς ρεύματος της πλατφόρμας V.L.A.D.}
    \label{tab:motors}
\end{table}

\subsection{Σχεδιασμός κυκλώματος ηλεκτρονικών}

Έχοντας πλέον αποφασίσει περί των κινητήρων, σειρά έχει ο σχεδιασμός του κυκλώματος των ηλεκτρονικών. Το μέρος αυτό ξεφεύγει των στόχων μιας γενικότερης προκαταρτικής σχεδιαστικής πρότασης, ωστόσο επιλέγεται να πραγματοποιηθεί για τη παράδοση μιας πιο ολοκληρωμένης πλατφόρμας.
\par Πριν την επιλογή των ηλεκτρονικών εξαρτημάτων, πρέπει να βελτιστοποιηθεί το σύστημα καταγραφής $CO_2$. Καθώς οι περισσότεροι αισθητήρες καταγραφής κατέχουν σχετικά αργή απόκριση, και εφόσον οι απαιτήσεις του σχεδιασμού θα προϋπόθεταν μικρή σταθερά χρονοκαθυστέρησης του συστήματος για ημι-αυτόνομη λειτουργία, επιλέγεται να χρησιμοποιηθούν ένα ζεύγος αισθητήρων με ταχεία απόκριση και ένα ζεύγος με τυπική απόκριση. Το ζεύγος ταχείας απόκρισης θα τοποθετηθεί μπροστά και πίσω στο σώμα της πλατφόρμας ενώ το άλλο στα πλάγια.
\par Αρχικά, επιλέγονται οι οδηγοί των κινητήρων. Για τον κινητήρα της κάμερας, θα επιλεχθεί τυπική πλακέτα οδήγησης τύπου A4988. Όλοι οι οδηγοί επιλέγονται με βάση το απαιτούμενο ρεύμα λειτουργίας των κινητήρων. Για τους κινητήρες της MAXON δίνεται ο χάρτης λειτουργίας του κινητήρα. Επιλέγοντας το σημείο λειτουργίας (\ref{tab:motors}), προκύπτει η ταχύτητα περιστροφής και το ρεύμα λειτουργίας του κάθε κινητήρα.
\begin{figure}[H]
    \centering
    \begin{subfigure}{0.45\linewidth}
        \centering
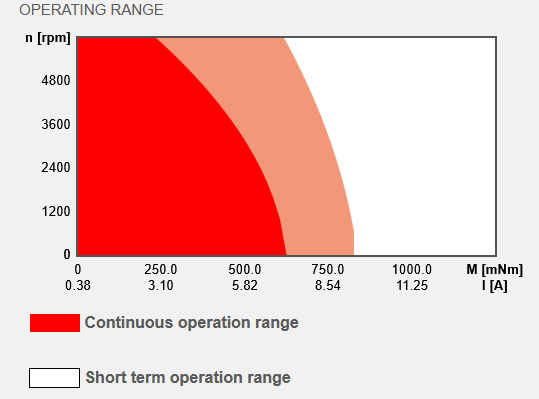
[picture p90: TeX/media/motMap1.png]
        
        \caption{Κινητήρας ερπύστριας EC-i 579165 52.}
        \label{fig:motMap1}
    \end{subfigure}
    \hfill
    \begin{subfigure}{0.45\linewidth}
        \centering
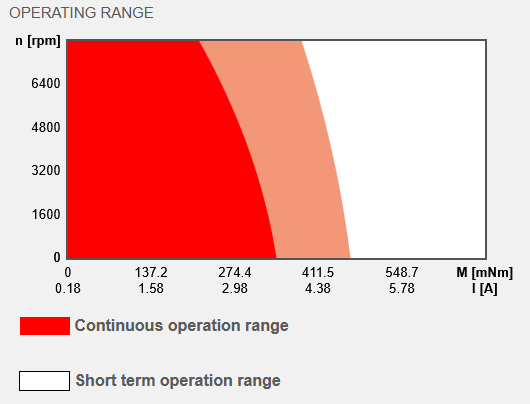
[picture p91: TeX/media/motMap2.png]
        
        \caption{Κινητήρας βραχίονα EC-i 666603 40.}
        \label{fig:motMap2}
    \end{subfigure}
    \caption{Χάρτες λειτουργίας κινητήρων συστήματος κίνησης.}
    \label{fig:motmapm}
\end{figure}
Από τους παραπάνω χάρτες προκύπτει ότι τα ρεύματα λειτουργίας των κινητήρων είναι αρκετά υψηλά. Έτσι, είναι αναγκαία η χρήση οδηγού υψηλών προδιαγραφών τόσο για το επιτρεπόμενο ρεύμα οδήγησης όσο και για την επιτρεπόμενη τάση οδήγησης. Η τάση οδήγησης και των δύο κινητήρων του συστήματος κίνησης είναι στα $48\;V$. Επομένως, για τους πιο απαιτητικούς κινητήρες του συστήματος κίνησης διαλέγονται οι οδηγοί ODrive S1. Αντίστοιχα, για τον κινητήρα περιστροφής της κάμερας, επιλέγεται από το φύλλο δεδομένων του επιλεγμένου NEMA 11, το ρεύμα λειτουργίας του. Ο οδηγός A4998 είναι ικανός για οδήγηση κινητήρα έως $2\;A$ ενώ το NEMA 11 11HS3410 που επιλέγεται κινείται με $0.1\; A$.

\par Με τους κινητήρες επιλεγμένους, σειρά έχει ο εγκέφαλος της πλατφόρμας. Για αυτή τη χρήση επιλέγεται μια τυπική πλακέτα μικροεπεξεργαστή Raspberry Pi 5, για την οδήγηση των κινητήρων και την επικοινωνία με τον σταθμό χειρισμού του διασώστη. Προφανώς, λόγω των υψηλών απαιτήσεων της αποστολής και του μεγάλου πλήθους δεδομένων που θα κληθεί να διαχειριστεί η πλακέτα RPi5, θα χρειαστεί και ψύκτρα για τη διασφάλιση της ορθής λειτουργίας της. Για τη σύνδεση της πλακέτας με τους οδηγούς των κινητήρων, ακολουθούνται οι οδηγίες των φύλλων οδηγιών των οδηγών (\ref{fig:dataMDrivers}).

\begin{figure}[H]
    \centering
    \begin{subfigure}{0.45\linewidth}
        \centering
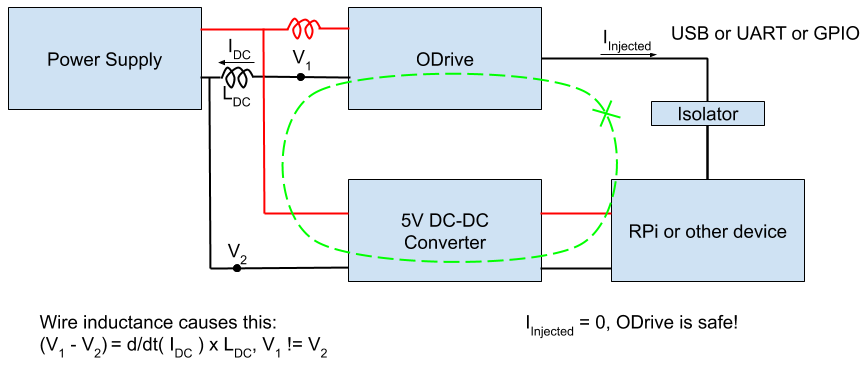
[picture p92: TeX/media/mdriver1.png]
        
        \caption{ODrive S1.}
        \label{fig:mdriver1}
    \end{subfigure}
    \hfill
    \begin{subfigure}{0.45\linewidth}
        \centering
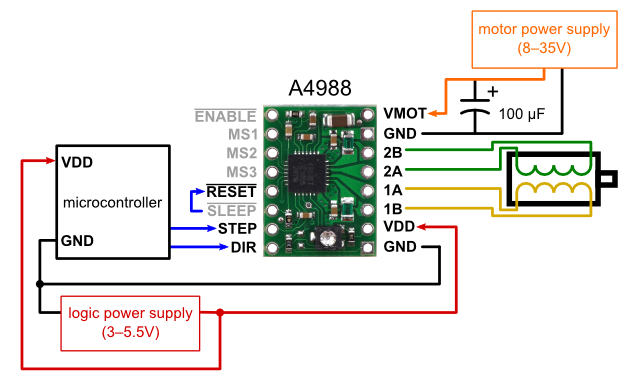
[picture p93: TeX/media/mdriver2.png]
        
        \caption{A4998.}
        \label{fig:mdriver2}
    \end{subfigure}
    \caption{Συνδεσμολογία οδηγών κινητήρων.}
    \label{fig:dataMDrivers}
\end{figure}

Όπως φαίνεται, προτείνεται η χρήση απομονωτή στο κύκλωμα του οδηγού ODrive S1. Αυτός επιλέγεται επίσης από την εταιρία της ODrive και επιλέγεται σύνδεση USB μεταξύ του επεξεργαστή και του οδηγού. Θα πρέπει επίσης να επιλεχθούν και μετατροπείς υποβιβασμού τάσης (Buck Converters). Ένας εξ αυτών θα πρέπει να δέχονται τάση στα 48V, όσο και οι κινητήρες που τροφοδοτούνται μέσω του οδηγού ODrive S1, και να υποβιβάζει τη τάση στα 5V για τη τροφοδοσία του RPi5 και του NEMA 11. Επίσης, ένας άλλος θα πρέπει να τροφοδοτεί το λογικό κύκλωμα του οδηγού AA998, που είναι προδιαγραφόμενο στα 3.3V.
\par Η κάμερα και το LiDAR, φέρουν καλώδιο USB για τη σύνδεση κατευθείαν στο RPi5. Αντίστοιχα, όλοι οι απομονωτές θα πρέπει να συνδέονται με USB. Για τη διασφάλιση αρκετών θυρών θα χρησιμοποιηθεί και USB Hub. Οι αισθητήρες καταγραφής $CO_2$ και τα επιταχυνσιόμετρα συνδέονται στις GPIO υποδοχές του RPi5. Για τα μικρόφωνα, θα χρησιμοποιηθεί κάψουλα μικροφώνου, κολλημένη σε καλώδιο τύπου Jack ενώ η σύνδεση με το RPi5 θα γίνει μέσω κάρτας ήχου Jack-USB. Τέλος, ο αισθητήρας IMU θα επικοινωνεί μέσω πρωτοκόλου I2C με τη πλακέτα του επεξεργαστή. Προφανώς σχεδιάζεται κοινή γραμμή γείωσης για το σύστημα.  Όλοι οι επιλεγμένοι αισθητήρες φαίνονται παρακάτω.
\par Για την επικοινωνία με το σταθμό χειρισμού, επιλέγεται κεραία και πρωτόκολλο Wi-Fi. Χρησιμοποιώντας έναν κεντρικό υπολογιστή (Laptop) με λειτουργικό Linux OS, η πλακέτα RPi5 στη πλατφόρμα θα αποτελεί και Wi-Fi Host για την επικοινωνία laptop και ρομπότ. Για την μεταφορά των δεδομένων από τους αισθητήρες στον υπολογιστή αλλά και για τον απομακρυσμένο χειρισμό του V.L.A.D. θα επιλεχθεί να στηθεί σύστημα επικοινωνίας ROS. Το λογικό κύκλωμα των ηλεκτρονικών φαίνεται στο \ref{fig:elec}.

\begin{figure}[H]
    \centering
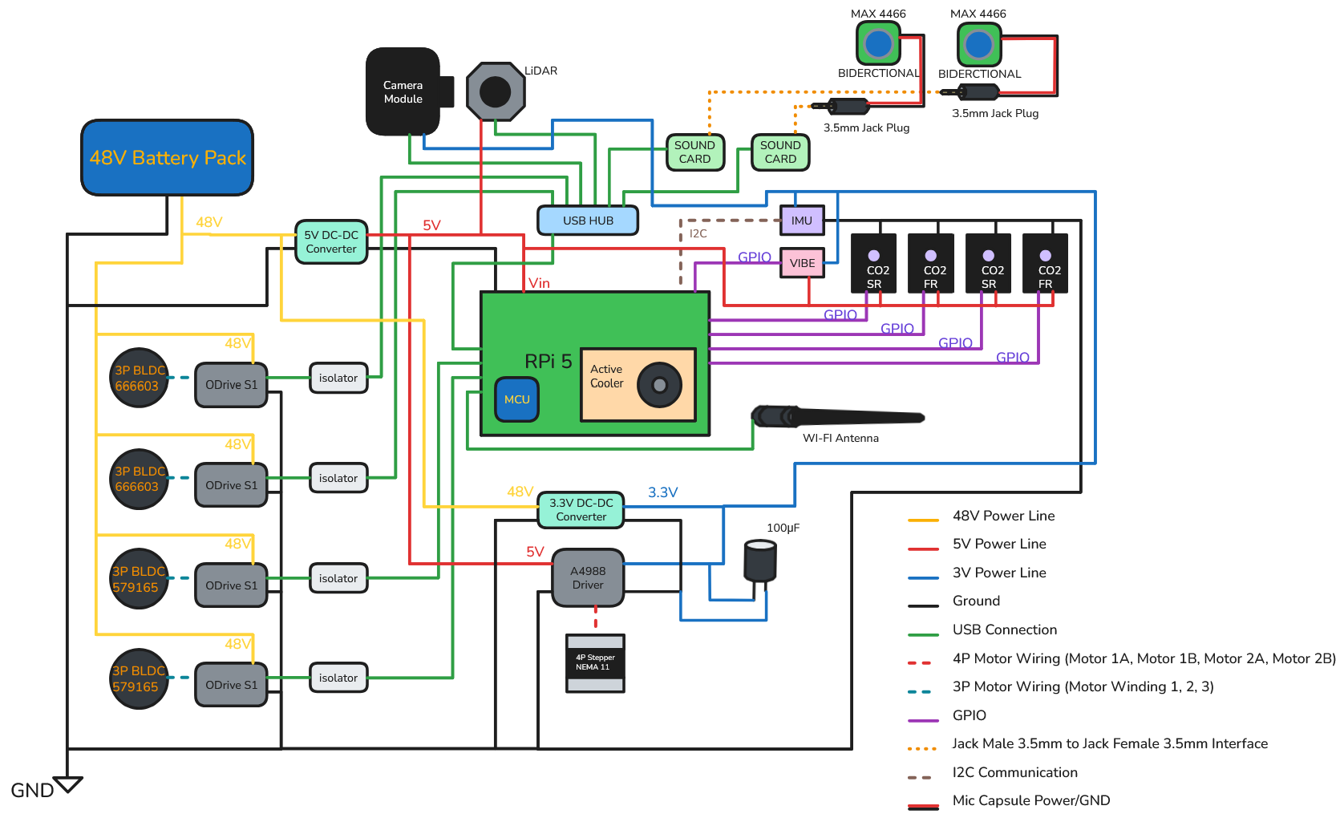
[picture p94: TeX/media/elec.png]
    
    \caption{Κύκλωμα ηλεκτρονικών.}
    \label{fig:elec}
\end{figure}

\par Πλέον με την επιλογή των κινητήρων και του σημείου λειτουργίας, μπορεί να υπολογιστεί και η πραγματική ταχύτητα της πλατφόρμας. Στο σημείο λειτουργίας του κινητήρα της ερπύστριας και μέσω της σχέσης μετάδοσης της οδοντοκίνησης όπως προέκυψε προηγουμένως, η ταχύτητα του V.L.A.D. είναι $V = 1.08\; m/s$.

\begin{table}[H]
    \centering
    \rowcolors{2}{gray}{white}
        \begin{tabular}{|c|c|c|c|}
        \hline
        \rowcolor{Periwinkle}
        \multicolumn{4}{|c|}{Actuators}\\
        \hline
        \rowcolor{Dandelion}
        Usage & Type & Nominal Voltage [$V$]& Nominal Amperage [$A$]\\
        \hline
        Flipper & 3P BLDC & 48 & 3.87\\
        \hline
        Tracks & 3P BLDC & 48 & 4.59\\
        \hline
        Camera & 4P Stepper & 3.6 & 0.1\\
        \hline
        \rowcolor{Periwinkle}
        \multicolumn{4}{|c|}{Drivers}\\
        \hline
        \rowcolor{Dandelion}
        Usage & Type & Logic Voltage [$V$]& Nominal Output Amperage [$A$]\\
        \hline
        Flipper & ODrive S1 & From RPi5 & 40\\
        \hline
        Tracks & ODrive S1 & From RPi5 & 40\\
        \hline
        Camera & A4998 & 5V & 2\\
        \hline
        \rowcolor{Periwinkle}
        \multicolumn{4}{|c|}{Sensors}\\
        \hline
        \rowcolor{Dandelion}
        Usage & Module & Logic Voltage [$V$]& Response Time [$s$]\\
        \hline
        $CO_2$ Fast & K30 & 5 & 2 \\
        \hline
        $CO_2$ Slow & MG-811 & 5 & <20 \\
        \hline
        \rowcolor{Dandelion}
        Usage & Module & Logic Voltage [$V$]& Nominal Amperage [$A$]\\
        \hline
        IR Camera & Waveshare ESP32-S3 IR & 3.7 & 0.13 \\
        \hline
        IMU & Waveshare 10 DOF & 3.7 & 0.005 \\
        \hline
        Accelerometer & ATO-SADR301 & 3.7 & 0.005 \\
        \hline
        LiDAR & WayPonDEV S2P & 5 & 0.005\\
        \hline
        Microphone Capsule & ECM-715N & 1.5 & 0.005 \\
        \hline
        \rowcolor{Periwinkle}
        \multicolumn{4}{|c|}{Rest}\\
        \hline
        \rowcolor{Dandelion}
        Usage & Module & - & -\\
        \hline
        MCU & Raspberry Pi 5 & - & -\\
        \hline
        MCU Cooler & Raspberry Pi 5 & - & -\\
        \hline
        MCU & Raspberry Pi Cooler & - & -\\
        \hline
        Step Down 5V & Polulu D42V110F5 & - & -\\
        \hline
        Step Down 3.3V & Polulu D36V28F3 & - & -\\
        \hline
        USB Dock & Generic 4 port dock & - & -\\
        \hline
        Sound Card & Generic Jack (F) - USB (M) & - & -\\
        \hline
        Wi-Fi Antenna & RTL8192cu for RPi5 & - & -\\
        \hline
        ODrive Isolator & ODrive Isolator for S1 & - & -\\
        \hline

        \end{tabular}
    \caption{Ισοζύγιο ισχύος.}
    \label{tab:powerbudget}
\end{table}

\subsection{Επιλογή μπαταριών και εκτίμηση χρόνου λειτουργίας}

Η‍‌‍‍‌ επιλογή της κατάλληλης πηγής ενέργειας δεν είναι καθόλου αμελητέα — είναι βασικό θέμα για τον σχεδιασμό ενός αυτόνομου ρομποτικού συστήματος διάσωσης, γιατί καθορίζει άμεσα την επιχειρησιακή εμβέλεια και πόσο θα διαρκέσει μια αποστολή. Σύμφωνα με τον \ref{tab:powerbudget} μπορεί να προκύψει η συνολική ζήτηση ρεύματος του συστήματος σε συνεχή κατάσταση λειτουργίας.

\par Από τις επιλογές στοιχείων μπαταρίας, προκρίθηκε η τεχνολογία Ιόντων Λιθίου (Lithium-Ion) και συγκεκριμένα στοιχεία τύπου 18650. Αυτή η τεχνολογία δίνει τον καλύτερο συμβιβασμό ανάμεσα σε χωρητικότητα, βάρος και ασφάλεια, ενώ επίσης διατηρεί σχετικά σταθερή τάση εκφόρτισης. Για να πετύχουμε τα επιθυμητά ηλεκτρικά χαρακτηριστικά, τα μεμονωμένα στοιχεία οργανώνονται σε μια συστοιχία (battery pack) με μικτή συνδεσμολογία. Η διάταξη καθορίζεται κυρίως από δύο παραμέτρους: την απαιτούμενη τάση λειτουργίας (V) για να δουλεύουν σωστά οι οδηγοί των κινητήρων, και την επιθυμητή χωρητικότητα (Ah) που καθορίζει την αυτονομία. Καταλαβαίνετε, δεν είναι μόνο αριθμοί — έχει και πρακτική πλευρά. Συγκεκριμένα, επιλέγεται η σύνδεση S στοιχείων σε σειρά (series) για να αυξηθεί η τάση στα $48\;V$, και P παράλληλων κλάδων (parallel) για να πολλαπλασιαστεί η χωρητικότητα και το μέγιστο συνεχές ρεύμα εκφόρτισης. Η τελική διαμόρφωση της συστοιχίας περιορίζεται και επίσης από τη χωροταξική τοποθέτηση της στο σώμα της πλατφόρμας.

\par Υποθέτοντας συνεχή λειτουργία όλων των ηλεκτρονικών, πράγμα που στη πράξη δεν συμβαίνει, μπορεί να υπολογιστεί ο χρόνος λειτουργίας της πλατφόρμας πριν την επαναφόρτιση. Κανονικά, θα πρέπει να οριστούν κύκλοι λειτουργίας της πλατφόρμας και με βάση αυτούς να υπολογιστεί η απαιτούμενη χωρητικότητα της μπαταρίας. Θεωρώντας όμως το πιο συντηρητικό σενάριο υπολογισμού, δηλαδή αυτό σε συνθήκες μέγιστης καταπόνησης, επιλέγεται να υπολογιστεί με αυτόν τον τρόπο ο χρόνος λειτουργίας. Το σύστημα μπαταριών που επιλέγεται αποτελείται από 3 στοιχεία παράλληλα με $5000\;mAh$ το κάθε ένα και 13 στοιχεία σε σειρά με $3.7\;V$ έκαστο. Η συνολική ισχύς της μπαταρίας είναι $48\;V$ και $15\;Ah$. Έτσι μπορεί να προκύψει ο χρόνος λειτουργίας της πλατφόρμας:
\begin{equation}
OT = \frac{\text{Battery Capacity}}{\text{Total Continuous Current Consumtion}}
\end{equation}
Τελικά προκύπτει ο χρόνος λειτουργίας της πλατφόρμας $\boldsymbol{OT = 0.72\; h} $ ή $\boldsymbol{OT = 43\; min}$ έως την ανάγκη φόρτισης της. Ο παραπάνω χρόνος είναι ικανοποιητικός για το σκοπό της αποστολής, δηλαδή την έρευνα και ανίχνευση θυμάτων μετά από καταστροφές. Μετά τον χρόνο αυτό χρειάζεται η αλλαγή μπαταρίας ή φόρτιση του διασώστη. Για διευκόλυνση και επέκταση του πραγματικού χρόνου της αποστολής, προτείνεται ο σχεδιασμός ώστε η αλλαγή της μπαταρίας να καθίσταται εύκολη. Αυτό μπορεί να γίνει με την εισαγωγή καταπακτής στο πάτο του σώματος της πλατφόρμας για τοποθέτηση της μπαταρίας από την κάτω πλευρά του V.L.A.D.
