vasilepi/Thesis/TeX/preamble.tex

\usepackage{fontspec}
\usepackage{polyglossia}
\usepackage{notomath}
\setmainfont{GFS Artemisia}
\setsansfont{Source Code Pro}
\setmonofont{Source Code Pro}
\newfontfamily\greekfont[Script=Greek]{GFS Artemisia}
\newfontfamily\greekfontsf[Script=Greek]{GFS Artemisia}
\newfontfamily\greekfonttt[Script=Greek]{Source Code Pro}

%languages
\setdefaultlanguage{greek}
\setotherlanguages{english}

%typing
\usepackage{hyphenat}
\usepackage{float}
\usepackage{color, colortbl}
\usepackage{placeins}

%captions
\usepackage{caption}
\usepackage{subcaption}

%bib
\usepackage{biblatex}
\addbibresource{bib.bib}

%gemoetry
\usepackage[a4paper,top=1.2cm,bottom=1.2cm,left=1.2cm,right=1.2cm,marginparwidth=1.5cm]{geometry}

%images
\usepackage{graphicx}
\usepackage{tikz}

%ref
\usepackage[colorlinks=true, allcolors=blue]{hyperref}

\usepackage[export]{adjustbox}

%label
\usepackage{enumitem}
\renewcommand{\labelenumii}{\arabic{enumi}.\arabic{enumii}}
\renewcommand{\labelenumiii}{\arabic{enumi}.\arabic{enumii}.\arabic{enumiii}}
\renewcommand{\labelenumiv}{\arabic{enumi}.\arabic{enumii}.\arabic{enumiii}.\arabic{enumiv}}

%columnnew
\newcolumntype{g}{>{\columncolor{gray}}l}

%colors
\usepackage[dvipsnames]{xcolor}
\definecolor{gray}{gray}{0.9}
\definecolor{blue}{RGB}{82, 138, 174}
\definecolor{green}{RGB}{140, 219, 169}
\definecolor{yellow}{RGB}{253, 221, 92}

% \usepackage{titling}
% \setlength{\droptitle}{-20em}             %allagh glwssas
\hypersetup{
    colorlinks = true,
    linkcolor=black}

\usepackage{autobreak}

%Customize tables
\renewcommand{\arraystretch}{1.2}
% \rowcolors{2}{gray}{white}

\captionsetup[table]{
    format=plain,
    labelfont={small,it,bf}, % Small, italic, and bold label
    textfont={small,it}, % Italic text
    labelsep=colon % Colon separator
}

% Customize the figure caption
\captionsetup[figure]{
    format=plain,
    labelfont={small,it,bf}, % Small, italic, and bold label
    textfont={small,it}, % Italic text
    labelsep=colon % Colon separator
}

\makeatletter
\renewcommand*{\p@table}{\textit{Πίν. }}
\renewcommand*{\p@figure}{\textit{Σχ. }}
\renewcommand*{\p@equation}{\textit{Εξ. }}
\makeatother

\captionsetup[subfigure]{singlelinecheck=false,position=b}
