vasilepi/Thesis/TeX/sections/abstractEng.tex

The current study focuses on the design of a robotic rescuer. This rescuer is intended for use in urban search and rescue (U.S.A.R.) missions, where access for human rescuers can be difficult and even dangerous. The robotic rescuer will be capable of navigating various types of terrain, avoiding obstacles, locating victims, and delivering basic first aid equipment. The study includes both the conceptual and preliminary design of the robot, as well as the analysis of system requirements and its specifications. The aim of this work is to present a comprehensive approach to designing a robotic rescuer capable of semi-autonomous operation, taking into account the challenges and requirements associated with urban search and rescue missions.
\\
\\
Title: \textbf{\textit{Conceptual And Mechatronics Design Of A Semi-Autonomous Robotic Rescuer For U.S.A.R. Missions}}
