vasilepi/Thesis/TeX/sections/conclusion.tex

\section{Διαχείριση όγκου εργασίας}
% διαχειριση χρονου και οργανωσης
%% arxeia - logs - cad - notes ola sto github -> apo ena shmeio kai meta yphrxe pollh plhroforia kai den katagrafotan olh
%% yphrxe cad v1 kai cad v2 gia ta dyo iterations toy amss budget

Η εκπόνηση της παρούσας διπλωματικής εργασίας απαίτησε τη διαχείριση ενός μεγάλου όγκου δεδομένων, υπολογισμών και σχεδιαστικών αρχείων. Για την οργάνωση του υλικού και την παρακολούθηση της εξέλιξης του σχεδιασμού, χρησιμοποιήθηκε η πλατφόρμα GitHub. Σε αυτό το αποθετήριο καταχωρήθηκαν τα αρχεία CAD, οι κώδικες υπολογισμών, και οι σημειώσεις προόδου.

\par Κατά τη διάρκεια της μελέτης, η πολυπλοκότητα του συστήματος οδήγησε αναπόφευκτα στη συσσώρευση μεγάλου πλήθους πληροφοριών. Παρόλο που καταβλήθηκε προσπάθεια για συστηματική καταγραφή, διαπιστώθηκε ότι σε προχωρημένα στάδια του σχεδιασμού, ορισμένες επί μέρους τροποποιήσεις ή σκέψεις δεν καταγράφονταν άμεσα λόγω της ταχύτητας των αλλαγών.

\par Ένα χαρακτηριστικό παράδειγμα της επαναληπτικής διαδικασίας που ακολουθήθηκε είναι η εξέλιξη του τρισδιάστατου μοντέλου. Αναπτύχθηκαν δύο κύριες εκδόσεις, το CAD v1 και το CAD v2, οι οποίες αντιστοιχούν στις δύο επαναλήψεις του ισοζυγίου μάζας. Η μετάβαση από την έκδοση v1 στην v2 πραγματοποιήθηκε κατόπιν αξιολόγησης των αρχικών εκτιμήσεων βάρους, οδηγώντας σε βελτιστοποιημένες επιλογές εξαρτημάτων και δομικές απλουστεύσεις.

\section{Συμπεράσματα}
% απολογισμος στοχων
%% oloi oi stoxoi epiteyxthikan
%% realistika o megistos xronos leitourgias ths platformas logw ths mpatarias einai isws ligos (gia 4h apostolh shmainei oti prepei na allaxthei 5 fores mpataria)
%% cost inefficient kathws de dwthike bash sto kostos (poly akriba eksarthmata opws kinhthres etc)
%% required service life tha mporouse kai parapanw

Ολοκληρώνοντας τον προκαταρτικό και ηλεκτρολογικό σχεδιασμό του ρομποτικού διασώστη V.L.A.D., δύναται να εξαχθούν σημαντικά συμπεράσματα σχετικά με την επίτευξη των στόχων και τη βιωσιμότητα της πρότασης.

\subsection{Αποτίμηση Στόχων}
Το σύνολο των στόχων που τέθηκαν στην αρχή της μελέτης θεωρείται ότι έχει επιτευχθεί. Η μελέτη απέδειξε τη μηχανολογική εφικτότητα της κατασκευής, προσδιορίζοντας με ακρίβεια τα κρίσιμα εξαρτήματα (κινητήρες, μετάδοση κίνησης, υλικά) και επιβεβαιώνοντας τη λειτουργικότητα του συστήματος μέσω αναλυτικών υπολογισμών.

\subsection{Κριτική Αξιολόγηση και Περιορισμοί}
Παρά την επιτυχή σχεδιαστική προσέγγιση, εντοπίζονται ορισμένοι περιορισμοί που χρήζουν αναφοράς:

\begin{itemize}
    \item \textbf{Ενεργειακή Αυτονομία:} Ένα από τα κρισιμότερα ζητήματα είναι η διάρκεια λειτουργίας. Βάσει των υπολογισμών του ενεργειακού ισοζυγίου, ο μέγιστος χρόνος λειτουργίας υπό φορτίο είναι περιορισμένος. Ρεαλιστικά, για την κάλυψη μιας τυπικής αποστολής διάσωσης διάρκειας 4 ωρών, θα απαιτούνταν πολλαπλές αλλαγές μπαταρίας (έως και 5 φορές), γεγονός που αυξάνει τον φόρτο της επιχειρησιακής υποστήριξης.
    \item \textbf{Οικονομική Αποδοτικότητα (Cost Efficiency):} Κατά τον σχεδιασμό, δόθηκε προτεραιότητα στη μέγιστη απόδοση και αξιοπιστία, χωρίς αυστηρούς περιορισμούς κόστους. Αυτό οδήγησε στην επιλογή εξαρτημάτων υψηλής ποιότητας (π.χ. κινητήρες, εξειδικευμένα ρουλεμάν), τα οποία καθιστούν την κατασκευή οικονομικά απαιτητική.
    \item \textbf{Διάρκεια Ζωής (Service Life):} Η απαιτούμενη διάρκεια ζωής του συστήματος περιορίζεται από συγκεκριμένα στοιχεία μηχανών. Συγκεκριμένα, η διάρκεια ζωής περιορίζεται στις 260 ώρες λειτουργίας, τιμή η οποία υπαγορεύεται από την αντοχή των επιλεγμένων εδράνων κύλισης υπό τα μέγιστα φορτία. Αν και επαρκής για πρωτότυπο, η τιμή αυτή είναι χαμηλή για ένα προϊόν μαζικής παραγωγής.
\end{itemize}

\section{Προτάσεις για μελλοντική έρευνα}
% βελτιωσεις στο ρομποτ
%% kibwtio sealing gia lubrication
%% pio kala edrana me megalyterh antoxh
%% aykshsh diametrwn granaziwn gia megalyteroys syntelestes asfaleias
%% meiwsh katanalwshs energeias -> aukshsh tou xronou leitourgias ws thn epanafortish
%% increase in required service life (now it is capped by the bearing at 260h)

% νεες ιδεες
%% mhxanismos flip (anashkwsh platformas an flipparei)
%% fakos
%% flippers apo th pisw meria epishs
%% systhma anarthshs

% συνεχεια της εργασιας
%% mhaxnismos anoigmatos toy payload chamber -> easy to open + sturdy (won't open through vibrations)
%% add battery to cad -> sxediasmos me akribeia to eswteriko tou swmatos toy VLAD gia to housing twn hlektronikwn
%% ypologismoi sta alla bearings
%% ypologismoi atraktoy
%% ypologismoi bides
%% fea yposysthmatwn platformas
%% logismiko twn aisthitirwn kai sthsimo toy kyklwmatos toys
%% 3d print prototype to check -> assemblability, clearances, basic functions
\subsection{Βελτιώσεις στον Υφιστάμενο Σχεδιασμό}
Για την αύξηση της αξιοπιστίας και της απόδοσης του ρομπότ προτείνονται:
\begin{itemize}
    \item \textbf{Στεγανοποίηση Κιβωτίου (Sealing):} Σχεδιασμός και ενσωμάτωση παρεμβυσμάτων για τη στεγανοποίηση του κιβωτίου μετάδοσης, ώστε να επιτραπεί η χρήση υγρού λιπαντικού όπως έχει αποδειχθεί ότι χρειάζεται, βελτιώνοντας την ψύξη και μειώνοντας τις τριβές.
    \item \textbf{Ενίσχυση Εδράνων:} Αντικατάσταση των τρεχόντων εδράνων με άλλα υψηλότερης αντοχής ή αλλαγή της διάταξης έδρασης, με στόχο την αύξηση του προσδόκιμου ζωής (Required Service Life) πέραν των 260 ωρών. Ένα χαρακτηριστικό παράδειγμα εδράνου με υωηλότερη αντοχή του επιλεγόμενου κρίσιμου W 607 είναι το έδρανο κύλισης 607 από τον κατάλογο της SKF, που σημειώνει αύξηση στο συντελεστή δυναμικής και στατικής αντοχής.
    \item \textbf{Αύξηση Διαμέτρου Οδοντωτών Τροχών:} Μελέτη για τη χρήση γραναζιών μεγαλύτερης διαμέτρου ή μέτρου οδόντωσης, ώστε να αυξηθούν περαιτέρω οι συντελεστές ασφαλείας έναντι θραύσης και επιφανειακής κόπωσης οι οποίοι αποδείχθηκαν ικανοποιητικοί αλλά ταυτόχρονα σχετικά χαμηλοί.
    \item \textbf{Ενεργειακή Διαχείριση:} Έρευνα για τη μείωση της κατανάλωσης ενέργειας (π.χ. μέσω αλγορίθμων ελέγχου ή αποδοτικότερων ηλεκτρονικών), ώστε να αυξηθεί ο χρόνος λειτουργίας μεταξύ των επαναφορτίσεων.
\end{itemize}

\subsection{Νέες Λειτουργικές Δυνατότητες}
Για την επαύξηση των επιχειρησιακών δυνατοτήτων του διασώστη προτείνονται:
\begin{itemize}
    \item \textbf{Μηχανισμός Αυτο-αναστροφής (Flip Mechanism):} Σχεδιασμός συστήματος (π.χ. βραχίονες ή αρθρωτό σώμα) που θα επιτρέπει στο ρομπότ να επανέρχεται στην κανονική του θέση σε περίπτωση ανατροπής.
    \item \textbf{Σύστημα Φωτισμού:} Προσθήκη ισχυρού φακού LED για επιχειρήσεις σε σκοτεινά περιβάλλοντα (π.χ. συντρίμμια, σήραγγες).
    \item \textbf{Οπίσθιοι Βραχίονες (Rear Flippers):} Προσθήκη ζεύγους flippers και στο πίσω μέρος για βελτίωση της ικανότητας υπερπήδησης εμποδίων και αναρρίχησης σε σκάλες.
    \item \textbf{Σύστημα Ανάρτησης:} Μελέτη ενσωμάτωσης ανάρτησης για την απορρόφηση κραδασμών, προστατεύοντας τα ευαίσθητα ηλεκτρονικά και το ωφέλιμο φορτίο.
\end{itemize}

\subsection{Επόμενα Βήματα Υλοποίησης}
Για τη συνέχιση της εργασίας και την ολοκλήρωση της κατασκευής απαιτούνται:
\begin{itemize}
    \item \textbf{Μηχανισμός Ασφάλισης Φορτίου:} Λεπτομερής σχεδιασμός του μηχανισμού ανοίγματος του θαλάμου μεταφοράς (payload chamber). Ο μηχανισμός πρέπει να είναι εύχρηστος, αλλά ταυτόχρονα στιβαρός ώστε να μην ανοίγει ακούσια λόγω των κραδασμών. Θα πρέπει να απαιτεί ελάχιστη προσπάθεια από τον χρήστη κατά το άνοιγμα και κλείσιμο του. Παράδειγμα τέτοιου μηχανισμού θα μπορούσε να αποτελεί ο μηχανισμός Push-To-Open.
    \item \textbf{Εσωτερική Χωροταξία:} Ενσωμάτωση της μπαταρίας και των ηλεκτρονικών πλακετών στο CAD μοντέλο, με σχεδιασμό ειδικών βάσεων στήριξης (housing) εντός του σώματος. Παρόλο που η μπαταρία και όλα τα ηλεκτρονικά έχουν ελεγχθεί περί των χωροταξικών οριών της πλατφόρμας, δεν έχουν τοποθετηθεί ακόμη οι τελικά επιλεγμένοι αισθητήρες στο σώμα του V.L.A.D.
    \item \textbf{Λοιποί Μηχανολογικοί Υπολογισμοί:} Εκπόνηση υπολογισμών για τα υπόλοιπα έδρανα του συστήματος και έλεγχος αντοχής των ατράκτων σε σύνθετη καταπόνηση. Επίσης, πρέπει να πραγματοποιηθεί και η επιλογή κοχλιών σύνδεσης και η μελέτη αυτών περί ροπών σύσφιξης.
    \item \textbf{Ανάλυση Πεπερασμένων Στοιχείων (FEA):} Διεξαγωγή προσομοιώσεων αντοχής στα κρίσιμα υποσυστήματα της πλατφόρμας για την επαλήθευση των αναλυτικών υπολογισμών.
    \item \textbf{Ανάπτυξη Λογισμικού και Ηλεκτρονικών:} Υλοποίηση του κυκλώματος των αισθητήρων και συγγραφή του κώδικα ελέγχου (ROS/Python) για την αυτόνομη πλοήγηση.
    \item \textbf{Πρωτοτυποποίηση (Prototyping):} Κατασκευή ενός πρωτοτύπου μέσω τρισδιάστατης εκτύπωσης (3D printing) για τον έλεγχο της συναρμολογησιμότητας (assemblability), των ανοχών και των βασικών μηχανικών λειτουργιών.
\end{itemize}
