vasilepi/Thesis/TeX/sections/intro.tex

\section{Καταστροφές και ανάγκη για αποστολές διάσωσης}
\subsection{Σεισμοί και πυρκαγιές στην Ελλάδα}

% γενικα για σεισμους και πυρκαγιες
% αναφορα σε στατιστικα στοιχεια Ελλαδας
% πως αντιμετωπιζονται αυτες οι καταστροφες στην Ελλαδα
Οι φυσικές και ανθρωπογενείς καταστροφές αποτελούν μια διαρκή απειλή για τις σύγχρονες κοινωνίες, προκαλώντας συχνά εκτεταμένες απώλειες ανθρώπινων ζωών, καταστροφές κρίσιμων υποδομών και σοβαρές οικονομικές επιπτώσεις. Ανεξάρτητα από την αιτία —είτε πρόκειται για ακραία καιρικά φαινόμενα, τεκτονικές δραστηριότητες, είτε για βιομηχανικά ατυχήματα— το χρονικό διάστημα αμέσως μετά την εκδήλωση του συμβάντος είναι το πλέον καθοριστικό. Η άμεση και οργανωμένη παρέμβαση μέσω αποστολών διάσωσης είναι επιβεβλημένη, καθώς οι πρώτες ώρες είναι κρίσιμες για την αύξηση των πιθανοτήτων επιβίωσης των εγκλωβισμένων ή τραυματισμένων ατόμων.

\par Οι φυσικές καταστροφές, και ειδικότερα οι σεισμοί και οι πυρκαγιές, αποτελούν διαχρονικά τις σημαντικότερες απειλές για το φυσικό και δομημένο περιβάλλον. Οι σεισμοί είναι φαινόμενα απρόβλεπτα και στιγμιαία, ικανά να προκαλέσουν ακαριαία κατάρρευση κτιριακών υποδομών και εγκλωβισμό ανθρώπων. Αντίστοιχα, οι δασικές και αστικές πυρκαγιές, οι οποίες εντείνονται λόγω της κλιματικής αλλαγής, εξαπλώνονται ραγδαία και απειλούν άμεσα τις ζώνες μίξης δάσους-αστικού ιστού.

\par Όσον αφορά τα στατιστικά δεδομένα, η Ελλάδα κατέχει την πρώτη θέση σε σεισμικότητα στην Ευρώπη και την έκτη παγκοσμίως, αντιπροσωπεύοντας περίπου το 50\% της σεισμικής ενέργειας που εκλύεται στην ευρωπαϊκή ήπειρο, όπως δηλώνεται στα επίσημα στοιχεία του Ο.Α.Σ.Π. (Ορανισμός Αντισεισμικού Σχεδιασμού και Προστασίας). Σύμφωνα με τα ιστορικά και σύγχρονα σεισμολογικά αρχεία, η χώρα υφίσταται ετησίως εκατοντάδες σεισμικές δονήσεις, εκ των οποίων ορισμένες αποδεικνύονται εξαιρετικά καταστροφικές. Στον τομέα των πυρκαγιών, τα δεδομένα είναι εξίσου ανησυχητικά, καθώς κάθε καλοκαίρι καταγράφονται χιλιάδες αγροτοδασικές πυρκαγιές που καταστρέφουν εκατοντάδες χιλιάδες στρέμματα και συχνά διεισδύουν σε κατοικημένες περιοχές, προκαλώντας απώλειες ανθρώπινων ζωών και περιουσιών.

\subsection{Ανάγκη για εξειδικευμένες αποστολές διάσωσης}  
% σημασια αποστολων διασωσης
% γιατι χρειαζονται εξειδικευμενες ομαδες
% αναφορα σε διεθνεις πρακτικες (ρομποτ διασωσης)
Η σημασία των αποστολών διάσωσης είναι αδιαμφισβήτητη, καθώς ο πρωταρχικός στόχος κάθε επιχείρησης πολιτικής προστασίας είναι η διαφύλαξη της ανθρώπινης ζωής. Ο χρόνος αποτελεί τον πιο κρίσιμο παράγοντα σε αυτές τις επιχειρήσεις. Η άμεση παρέμβαση μέσα στις πρώτες ώρες μετά το συμβάν μειώνει δραστικά τα ποσοστά θνησιμότητας και αποτρέπει επιπλέον τραυματισμούς από δευτερογενείς κινδύνους, όπως μετασεισμούς, διαρροές αερίων ή στατικές αστοχίες κτιρίων.

\par Ωστόσο, σε περιβάλλοντα μαζικών καταστροφών, τα συμβατικά μέσα και το προσωπικό των τοπικών υπηρεσιών έκτακτης ανάγκης συχνά δεν επαρκούν. Για τον λόγο αυτόν, προκύπτει η απόλυτη ανάγκη για εξειδικευμένες ομάδες διάσωσης. Οι ομάδες αυτές διαθέτουν προσωπικό με εξειδικευμένη εκπαίδευση (π.χ. διασώστες, μηχανικούς, γιατρούς αντιμετώπισης τραύματος στο πεδίο) και ειδικό εξοπλισμό για διείσδυση σε ερείπια, υποστύλωση δομικών στοιχείων και απεγκλωβισμό ατόμων κάτω από συνθήκες ακραίου στρες και περιορισμένου χώρου.

\par Περνώντας στις διεθνείς πρακτικές, οι σύγχρονες ομάδες διάσωσης ενσωματώνουν πλέον τεχνολογίες αιχμής για να αυξήσουν την αποτελεσματικότητά τους και να μειώσουν το ρίσκο για τους ίδιους τους διασώστες. Χώρες με υψηλή τεχνολογική και σεισμική εμπειρία, όπως η Ιαπωνία και οι ΗΠΑ, αξιοποιούν εκτενώς ρομπότ διάσωσης (Rescue Robots) στις επιχειρήσεις τους. Αυτά περιλαμβάνουν μη επανδρωμένα εναέρια οχήματα (UAVs) για τη χαρτογράφηση της καταστροφής από αέρος, καθώς και μη επανδρωμένα οχήματα εδάφους (UGVs), τα οποία εισέρχονται σε στενά και επικίνδυνα σημεία στα ερείπια. Εξοπλισμένα με θερμικές κάμερες, μικρόφωνα και αισθητήρες ανίχνευσης αερίων, τα ρομπότ αυτά καθίστανται αναντικατάστατοι «συνεργάτες» των διασωστών, σηματοδοτώντας τη νέα εποχή στις αποστολές διάσωσης.

\section{Αποστολές διάσωσης U.S.A.R.}

\subsection{Γενικά για τις αποστολές U.S.A.R.}
Για την κάλυψη της παραπάνω ανάγκης σε δομημένα περιβάλλοντα, έχει αναπτυχθεί παγκοσμίως το δόγμα των επιχειρήσεων U.S.A.R., το οποίο αποτελεί την αιχμή του δόρατος στην αντιμετώπιση καταστροφών εντός του αστικού ιστού.

\par Οι αποστολές διάσωσης U.S.A.R. (Urban Search and Rescue) αφορούν επιχειρήσεις έρευνας και διάσωσης σε αστικές περιοχές που έχουν πληγεί από φυσικές καταστροφές ή ανθρωπογενείς καταστροφές, όπως σεισμοί, εκρήξεις ή καταρρεύσεις κτιρίων. Οι ομάδες U.S.A.R. είναι εξειδικευμένες μονάδες που εκπαιδεύονται για να εντοπίζουν, να απεγκλωβίζουν και να παρέχουν πρώτες βοήθειες σε θύματα που βρίσκονται παγιδευμένα σε επικίνδυνες συνθήκες. Οι αποστολές αυτές απαιτούν συντονισμό πολλών ειδικοτήτων, όπως μηχανικοί, ιατροί, διασώστες και ειδικοί στην ανίχνευση επιζώντων, και συχνά χρησιμοποιούν προηγμένη τεχνολογία για την ανίχνευση και διάσωση των θυμάτων.  

\subsection{Σημασία και προκλήσεις των αποστολών U.S.A.R.}
Η αποτελεσματικότητα των αποστολών U.S.A.R. εξαρτάται από την ταχύτητα και την ακρίβεια της ανταπόκρισης, καθώς και από την ικανότητα των ομάδων να λειτουργούν υπό δύσκολες και επικίνδυνες συνθήκες. Οι αποστολές αυτές είναι κρίσιμες για τη διάσωση ζωών και την παροχή βοήθειας σε πληγέντες πληθυσμούς μετά από καταστροφές. Οι προκλήσεις που αντιμετωπίζουν οι ομάδες U.S.A.R. περιλαμβάνουν την αβεβαιότητα του περιβάλλοντος, τον περιορισμένο χρόνο για την ανεύρεση και διάσωση θυμάτων, και την ανάγκη για συντονισμό με άλλες υπηρεσίες έκτακτης ανάγκης. Επιπλέον, η χρήση τεχνολογίας, όπως ρομπότ και αισθητήρες, μπορεί να βελτιώσει την αποτελεσματικότητα των αποστολών, αλλά απαιτεί επίσης εξειδικευμένη εκπαίδευση και υποστήριξη.

\subsection{Αποστολές U.S.A.R. στην Ελλάδα}
Στην Ελλάδα, οι αποστολές U.S.A.R. έχουν αποκτήσει ιδιαίτερη βαρύτητα λόγω της γεωγραφικής της θέσης και της αυξημένης συχνότητας φυσικών καταστροφών. Η χώρα διαθέτει εξειδικευμένες ομάδες (όπως η ΕΜΑΚ - Ειδική Μονάδα Αντιμετώπισης Καταστροφών) που συνεργάζονται στενά με τις τοπικές αρχές και διεθνείς οργανισμούς για τη διαχείριση κρίσεων. Οι ελληνικές ομάδες U.S.A.R. έχουν συμμετάσχει σε πλήθος αποστολών διάσωσης, τόσο εντός της επικράτειας όσο και στο εξωτερικό, αποδεικνύοντας την υψηλή επιχειρησιακή τους ικανότητα στην παροχή βοήθειας σε πληγέντες πληθυσμούς. Η συνεχής εκπαίδευση, η ανανέωση του εξοπλισμού και η βελτίωση των δεξιοτήτων τους παραμένουν απαραίτητες προϋποθέσεις για την αποτελεσματική ανταπόκριση στις μελλοντικές προκλήσεις.

\subsection{Ρομποτικοί διασώστες στις αποστολές U.S.A.R.}
Μία από τις σημαντικότερες τεχνολογικές τομές στον τομέα του U.S.A.R. είναι η εισαγωγή των ρομποτικών διασωστών. Τα μηχανοκίνητα αυτά συστήματα λειτουργούν ως πολλαπλασιαστές ισχύος για τις ομάδες διάσωσης. Η ικανότητά τους να εισέρχονται σε στενά, δυσπρόσιτα και εξαιρετικά επικίνδυνα περιβάλλοντα (π.χ. περιοχές με τοξικά αέρια, ραδιενέργεια ή ακραίες θερμοκρασίες) τα καθιστά αναντικατάστατα εργαλεία. Μέσω καμερών, θερμικών αισθητήρων, συστημάτων LiDAR και ανιχνευτών αερίων (π.χ. $CO_2$), τα ρομπότ μπορούν να χαρτογραφήσουν ερείπια και να εντοπίσουν ίχνη ζωής χωρίς να τεθεί σε κίνδυνο η ζωή των ανθρώπινων διασωστών ή των εκπαιδευμένων σκύλων. Η ανάπτυξη τέτοιων ημιαυτόνομων ρομποτικών πλατφορμών αποτελεί πλέον κεντρικό πυλώνα της σύγχρονης έρευνας στη μηχανοτρονική.

\section{Στόχοι της εργασίας}
Η παρούσα εργασία έχει ως απώτερο σκοπό να παρουσιάσει μια ολοκληρωμένη πρόταση σχεδιασμού ενός ρομποτικού διασώστη, ειδικά παραμετροποιημένου για αποστολές U.S.A.R. Καθώς το αντικείμενο είναι πολυδιάστατο, οι στόχοι και οι προϋποθέσεις της μελέτης τέθηκαν με γνώμονα τη σφαιρική μηχανολογική και ηλεκτρολογική/μηχανοτρονική προσέγγιση του συστήματος. Ειδικότερα, η εργασία δομείται πάνω στους εξής τέσσερις βασικούς άξονες:

\par Ειδικότερα, η εργασία δομείται πάνω στους εξής τέσσερις βασικούς άξονες:
\begin{itemize}
    \item Προκαταρκτικός Σχεδιασμός: Υλοποίηση της αρχικής ιδέας και δόμηση της αρχιτεκτονικής του ρομπότ, με βασικό γνώμονα την επίτευξη της βέλτιστης λειτουργικότητας, της ευελιξίας κίνησης και της προσαρμοστικότητας των μηχανισμών του στο ανώμαλο έδαφος.
    \item Μηχανοτρονικός/Ηλεκτρονικός Σχεδιασμός: Καθορισμός της τοπολογίας του κυκλώματος ελέγχου, του ενεργειακού ισοζυγίου και της επιλογής αισθητήρων και ελεγκτών, χωρίς ωστόσο η παρούσα μελέτη να υπεισέρχεται στον αναλυτικό προγραμματισμό (software) αυτών των εξαρτημάτων.
    \item Μηχανολογική Ανάλυση και Διαστασιολόγηση: Εξακρίβωση της ορθότητας της σχεδιαστικής ιδέας μέσω υπολογισμών αντοχής σε κρίσιμα μηχανολογικά στοιχεία της πλατφόρμας (π.χ. κινηματικές αλυσίδες, άξονες, έδρανα), προκειμένου οι θεωρητικές διαστάσεις να λάβουν ακριβείς και ρεαλιστικές τιμές.
    \item Ακαδημαϊκή Εξοικείωση: Η τριβή του συγγραφέα με τις αρχές του μηχανοτρονικού σχεδιασμού και την πολυπλοκότητα των ρομποτικών συστημάτων. Μέσω αυτής της ολιστικής διαδικασίας (από το concept έως τη διαστασιολόγηση), τίθενται γερές βάσεις για την περαιτέρω επιστημονική εξέλιξη του φοιτητή στον ταχύτατα αναπτυσσόμενο κλάδο της ρομποτικής.
\end{itemize}
