vasilepi/Thesis/thesis.pdf

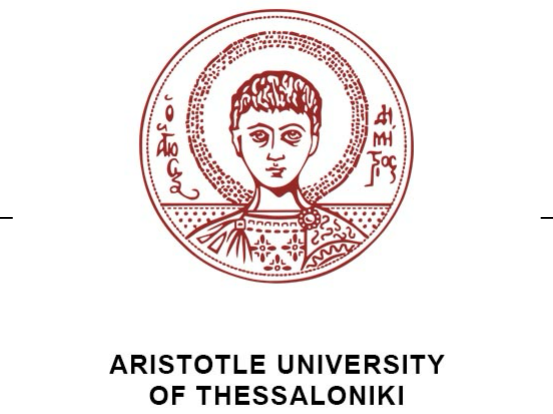
[picture p104: figure]

### ΑΡΙΣΤΟΤΕΛΕΙΟ ΠΑΝΕΠΙΣΤΗΜΙΟ ΘΕΣΣΑΛΟΝΙΚΗΣ

ΠΟΛΥΤΕΧΝΙΚΗ ΣΧΟΛΗ

ΤΜΗΜΑ ΜΗΧΑΝΟΛΟΓΩΝ ΜΗΧΑΝΙΚΩΝ

## Προκαταρτικός Και Μηχανοτρονικός Σχεδιασμός Ημιαυτόνομου Ρομποτικού Διασώστη Για U.S.A.R. Αποστολές

### Διπλωματική Εργασία

## ΒΑΣΙΛΕΙΟΣ ΠΑΠΑΜΙΧΑΗΛ

Υπεύθυνος καθηγητής: Σαββαΐδης Γεώργιος
Υπεύθυνος παρακολούθησης: Γιαννάκης Ευστράτιος, Τσακίρης Αντώνιος Email: vasilepi@meng.auth.gr
ΑΕΜ: 6920

24 Μαρτίου 2026

# Περιεχόμενα

1 Εισαγωγή | 1
2 Προκαταρτικός Σχεδιασμός | 4
3 Διαμορφωτικός Σχεδιασμός | 48
4 Συμπεράσματα και Μελλοντική Έρευνα | 57

Περίληψη

Η παρούσα εργασία μελετά τον σχεδιασμό ενός ρομποτικού διασώστη. Ο διασώστης αυτός προορίζεται να χρησιμοποιηθεί σε αποστολές έρευνας και διάσωσης σε αστικές περιοχές (U.S.A.R.), όπου η πρόσβαση για ανθρώπους διασώστες μπορεί να είναι δύσκολη έως και πολύ επικίνδυνη. Ο ρομποτικός διασώστης θα είναι ικανός να κινείται σε διάφορα είδη εδάφους, να αποφεύγει εμπόδια, να εντοπίζει θύματα και να μεταφέρει βασικό εξοπλισμό πρώτων βοηθειών. Η μελέτη περιλαμβάνει τον προκαταρτικό και διαμορφωτικό σχεδιασμό του ρομπότ, καθώς και την ανάλυση των απαιτήσεων και προδιαγραφών του συστήματος. Στόχος της εργασίας είναι να παρουσιάσει μια ολοκληρωμένη προσέγγιση για τον σχεδιασμό ενός ρομποτικού διασώστη, ικανού να λειτουργεί ημιαυτόματα, λαμβάνοντας υπόψη τις προκλήσεις και τις απαιτήσεις που σχετίζονται με αποστολές έρευνας και διάσωσης σε αστικές περιοχές.

Abstract

The current study focuses on the design of a robotic rescuer. This rescuer is intended for use in urban search and rescue (U.S.A.R.) missions, where access for human rescuers can be difficult and even dangerous. The robotic rescuer will be capable of navigating various types of terrain, avoiding obstacles, locating victims, and delivering basic first aid equipment. The study includes both the conceptual and preliminary design of the robot, as well as the analysis of system requirements and its specifications. The aim of this work is to present a comprehensive approach to designing a robotic rescuer capable of semi-autonomous operation, taking into account the challenges and requirements associated with urban search and rescue missions.

Title: Conceptual And Mechatronics Design Of A Semi-Autonomous Robotic Rescuer For U.S.A.R. Missions

# Κεφάλαιο 1

# Εισαγωγή

## 1.1 Καταστροφές και ανάγκη για αποστολές διάσωσης

### 1.1.1 Σεισμοί και πυρκαγιές στην Ελλάδα

Οι φυσικές και ανθρωπογενείς καταστροφές αποτελούν μια διαρκή απειλή για τις σύγχρονες κοινωνίες, προκαλώντας συχνά εκτεταμένες απώλειες ανθρώπινων ζωών, καταστροφές κρίσιμων υποδομών και σοβαρές οικονομικές επιπτώσεις. Ανεξάρτητα από την αιτία —είτε πρόκειται για ακραία καιρικά φαινόμενα, τεκτονικές δραστηριότητες, είτε για βιομηχανικά ατυχήματα— το χρονικό διάστημα αμέσως μετά την εκδήλωση του συμβάντος είναι το πλέον καθοριστικό. Η άμεση και οργανωμένη παρέμβαση μέσω αποστολών διάσωσης είναι επιβεβλημένη, καθώς οι πρώτες ώρες είναι κρίσιμες για την αύξηση των πιθανοτήτων επιβίωσης των εγκλωβισμένων ή τραυματισμένων ατόμων. Οι φυσικές καταστροφές, και ειδικότερα οι σεισμοί και οι πυρκαγιές, αποτελούν διαχρονικά τις σημαντικότερες απειλές για το φυσικό και δομημένο περιβάλλον. Οι σεισμοί είναι φαινόμενα απρόβλεπτα και στιγμιαία, ικανά να προκαλέσουν ακαριαία κατάρρευση κτιριακών υποδομών και εγκλωβισμό ανθρώπων. Αντίστοιχα, οι δασικές και αστικές πυρκαγιές, οι οποίες εντείνονται λόγω της κλιματικής αλλαγής, εξαπλώνονται ραγδαία και απειλούν άμεσα τις ζώνες μίξης δάσους-αστικού ιστού.
Όσον αφορά τα στατιστικά δεδομένα, η Ελλάδα κατέχει την πρώτη θέση σε σεισμικότητα στην Ευρώπη και την έκτη παγκοσμίως, αντιπροσωπεύοντας περίπου το 50% της σεισμικής ενέργειας που εκλύεται στην ευρωπαϊκή ήπειρο, όπως δηλώνεται στα επίσημα στοιχεία του Ο.Α.Σ.Π. (Ορανισμός Αντισεισμικού Σχεδιασμού και Προστασίας). Σύμφωνα με τα ιστορικά και σύγχρονα σεισμολογικά αρχεία, η χώρα υφίσταται ετησίως εκατοντάδες σεισμικές δονήσεις, εκ των οποίων ορισμένες αποδεικνύονται εξαιρετικά καταστροφικές. Στον τομέα των πυρκαγιών, τα δεδομένα είναι εξίσου ανησυχητικά, καθώς κάθε καλοκαίρι καταγράφονται χιλιάδες αγροτοδασικές πυρκαγιές που καταστρέφουν εκατοντάδες χιλιάδες στρέμματα και συχνά διεισδύουν σε κατοικημένες περιοχές, προκαλώντας απώλειες ανθρώπινων ζωών και περιουσιών.

### 1.1.2 Ανάγκη για εξειδικευμένες αποστολές διάσωσης

Η σημασία των αποστολών διάσωσης είναι αδιαμφισβήτητη, καθώς ο πρωταρχικός στόχος κάθε επιχείρησης πολιτικής προστασίας είναι η διαφύλαξη της ανθρώπινης ζωής. Ο χρόνος αποτελεί τον πιο κρίσιμο παράγοντα σε αυτές τις επιχειρήσεις. Η άμεση παρέμβαση μέσα στις πρώτες ώρες μετά το συμβάν μειώνει δραστικά τα ποσοστά θνησιμότητας και αποτρέπει επιπλέον τραυματισμούς από δευτερογενείς κινδύνους, όπως μετασεισμούς, διαρροές αερίων ή στατικές αστοχίες κτιρίων.
Ωστόσο, σε περιβάλλοντα μαζικών καταστροφών, τα συμβατικά μέσα και το προσωπικό των τοπικών υπηρεσιών έκτακτης ανάγκης συχνά δεν επαρκούν. Για τον λόγο αυτόν, προκύπτει η απόλυτη ανάγκη για εξειδικευμένες ομάδες διάσωσης. Οι ομάδες αυτές διαθέτουν προσωπικό με εξειδικευμένη εκπαίδευση (π.χ. διασώστες, μηχανικούς, γιατρούς αντιμετώπισης τραύματος στο πεδίο) και ειδικό εξοπλισμό για διείσδυση σε ερείπια, υποστύλωση δομικών στοιχείων και απεγκλωβισμό ατόμων κάτω από συνθήκες ακραίου στρες και περιορισμένου χώρου.
Περνώντας στις διεθνείς πρακτικές, οι σύγχρονες ομάδες διάσωσης ενσωματώνουν πλέον τεχνολογίες αιχμής για να αυξήσουν την αποτελεσματικότητά τους και να μειώσουν το ρίσκο για τους ίδιους τους διασώστες. Χώρες με υψηλή τεχνολογική και σεισμική εμπειρία, όπως η Ιαπωνία και οι ΗΠΑ, αξιοποιούν εκτενώς ρομπότ διάσωσης (Rescue Robots) στις επιχειρήσεις τους. Αυτά περιλαμβάνουν μη επανδρωμένα εναέρια οχήματα (UAVs) για τη χαρτογράφηση της καταστροφής από αέρος, καθώς και μη επανδρωμένα οχήματα εδάφους (UGVs), τα οποία εισέρχονται σε στενά και επικίνδυνα σημεία στα ερείπια. Εξοπλισμένα με θερμικές κάμερες, μικρόφωνα και αισθητήρες ανίχνευσης αερίων, τα ρομπότ αυτά καθίστανται αναντικατάστατοι «συνεργάτες» των διασωστών, σηματοδοτώντας τη νέα εποχή στις αποστολές διάσωσης.

1.2 Αποστολές διάσωσης U.S.A.R.

1.2.1 Γενικά για τις αποστολές U.S.A.R.

Για την κάλυψη της παραπάνω ανάγκης σε δομημένα περιβάλλοντα, έχει αναπτυχθεί παγκοσμίως το δόγμα των επιχειρήσεων U.S.A.R., το οποίο αποτελεί την αιχμή του δόρατος στην αντιμετώπιση καταστροφών εντός του αστικού ιστού.
Οι αποστολές διάσωσης U.S.A.R. (Urban Search and Rescue) αφορούν επιχειρήσεις έρευνας και διάσωσης σε αστικές περιοχές που έχουν πληγεί από φυσικές καταστροφές ή ανθρωπογενείς καταστροφές, όπως σεισμοί, εκρήξεις ή καταρρεύσεις κτιρίων. Οι ομάδες U.S.A.R. είναι εξειδικευμένες μονάδες που εκπαιδεύονται για να εντοπίζουν, να απεγκλωβίζουν και να παρέχουν πρώτες βοήθειες σε θύματα που βρίσκονται παγιδευμένα σε επικίνδυνες συνθήκες. Οι αποστολές αυτές απαιτούν συντονισμό πολλών ειδικοτήτων, όπως μηχανικοί, ιατροί, διασώστες και ειδικοί στην ανίχνευση επιζώντων, και συχνά χρησιμοποιούν προηγμένη τεχνολογία για την ανίχνευση και διάσωση των θυμάτων.

1.2.2 Σημασία και προκλήσεις των αποστολών U.S.A.R.

Η αποτελεσματικότητα των αποστολών U.S.A.R. εξαρτάται από την ταχύτητα και την ακρίβεια της ανταπόκρισης, καθώς και από την ικανότητα των ομάδων να λειτουργούν υπό δύσκολες και επικίνδυνες συνθήκες. Οι αποστολές αυτές είναι κρίσιμες για τη διάσωση ζωών και την παροχή βοήθειας σε πληγέντες πληθυσμούς μετά από καταστροφές. Οι προκλήσεις που αντιμετωπίζουν οι ομάδες U.S.A.R. περιλαμβάνουν την αβεβαιότητα του περιβάλλοντος, τον περιορισμένο χρόνο για την ανεύρεση και διάσωση θυμάτων, και την ανάγκη για συντονισμό με άλλες υπηρεσίες έκτακτης ανάγκης. Επιπλέον, η χρήση τεχνολογίας, όπως ρομπότ και αισθητήρες, μπορεί να βελτιώσει την αποτελεσματικότητα των αποστολών, αλλά απαιτεί επίσης εξειδικευμένη εκπαίδευση και υποστήριξη.

### 1.2.3 Αποστολές U.S.A.R. στην Ελλάδα

Στην Ελλάδα, οι αποστολές U.S.A.R. έχουν αποκτήσει ιδιαίτερη βαρύτητα λόγω της γεωγραφικής της θέσης και της αυξημένης συχνότητας φυσικών καταστροφών. Η χώρα διαθέτει εξειδικευμένες ομάδες (όπως η ΕΜΑΚ - Ειδική Μονάδα Αντιμετώπισης Καταστροφών) που συνεργάζονται στενά με τις τοπικές αρχές και διεθνείς οργανισμούς για τη διαχείριση κρίσεων. Οι ελληνικές ομάδες U.S.A.R. έχουν συμμετάσχει σε πλήθος αποστολών διάσωσης, τόσο εντός της επικράτειας όσο και στο εξωτερικό, αποδεικνύοντας την υψηλή επιχειρησιακή τους ικανότητα στην παροχή βοήθειας σε πληγέντες πληθυσμούς. Η συνεχής εκπαίδευση, η ανανέωση του εξοπλισμού και η βελτίωση των δεξιοτήτων τους παραμένουν απαραίτητες προϋποθέσεις για την αποτελεσματική ανταπόκριση στις μελλοντικές προκλήσεις.

1.2.4 Ρομποτικοί διασώστες στις αποστολές U.S.A.R.

Μία από τις σημαντικότερες τεχνολογικές τομές στον τομέα του U.S.A.R. είναι η εισαγωγή των ρομποτικών διασωστών. Τα μηχανοκίνητα αυτά συστήματα λειτουργούν ως πολλαπλασιαστές ισχύος για τις ομάδες διάσωσης. Η ικανότητά τους να εισέρχονται σε στενά, δυσπρόσιτα και εξαιρετικά επικίνδυνα περιβάλλοντα (π.χ. περιοχές με τοξικά αέρια, ραδιενέργεια ή ακραίες θερμοκρασίες) τα καθιστά αναντικατάστατα εργαλεία. Μέσω καμερών, θερμικών αισθητήρων, συστημάτων LiDAR και ανιχνευτών αερίων (π.χ. CO2), τα ρομπότ μπορούν να χαρτογραφήσουν ερείπια και να εντοπίσουν ίχνη ζωής χωρίς να τεθεί σε κίνδυνο η ζωή των ανθρώπινων διασωστών ή των εκπαιδευμένων σκύλων. Η ανάπτυξη τέτοιων ημιαυτόνομων ρομποτικών πλατφορμών αποτελεί πλέον κεντρικό πυλώνα της σύγχρονης έρευνας στη μηχανοτρονική.

## 1.3 Στόχοι της εργασίας

Η παρούσα εργασία έχει ως απώτερο σκοπό να παρουσιάσει μια ολοκληρωμένη πρόταση σχεδιασμού ενός ρομποτικού διασώστη, ειδικά παραμετροποιημένου για αποστολές U.S.A.R. Καθώς το αντικείμενο είναι πολυδιάστατο, οι στόχοι και οι προϋποθέσεις της μελέτης τέθηκαν με γνώμονα τη σφαιρική μηχανολογική και ηλεκτρολογική/μηχανοτρονική προσέγγιση του συστήματος. Ειδικότερα, η εργασία δομείται πάνω στους εξής τέσσερις βασικούς άξονες:
Ειδικότερα, η εργασία δομείται πάνω στους εξής τέσσερις βασικούς άξονες:
- Προκαταρκτικός Σχεδιασμός: Υλοποίηση της αρχικής ιδέας και δόμηση της αρχιτεκτονικής του ρομπότ, με βασικό γνώμονα την επίτευξη της βέλτιστης λειτουργικότητας, της ευελιξίας κίνησης και της προσαρμοστικότητας των μηχανισμών του στο ανώμαλο έδαφος.
- Μηχανοτρονικός/Ηλεκτρονικός Σχεδιασμός: Καθορισμός της τοπολογίας του κυκλώματος ελέγχου, του ενεργειακού ισοζυγίου και της επιλογής αισθητήρων και ελεγκτών, χωρίς ωστόσο η παρούσα μελέτη να υπεισέρχεται στον αναλυτικό προγραμματισμό (software) αυτών των εξαρτημάτων.

- Μηχανολογική Ανάλυση και Διαστασιολόγηση: Εξακρίβωση της ορθότητας της σχεδιαστικής ιδέας μέσω υπολογισμών αντοχής σε κρίσιμα μηχανολογικά στοιχεία της πλατφόρμας (π.χ. κινηματικές αλυσίδες, άξονες, έδρανα), προκειμένου οι θεωρητικές διαστάσεις να λάβουν ακριβείς και ρεαλιστικές τιμές.
- Ακαδημαϊκή Εξοικείωση: Η τριβή του συγγραφέα με τις αρχές του μηχανοτρονικού σχεδιασμού και την πολυπλοκότητα των ρομποτικών συστημάτων. Μέσω αυτής της ολιστικής διαδικασίας (από το concept έως τη διαστασιολόγηση), τίθενται γερές βάσεις για την περαιτέρω επιστημονική εξέλιξη του φοιτητή στον ταχύτατα αναπτυσσόμενο κλάδο της ρομποτικής.

# Κεφάλαιο 2

# Προκαταρτικός Σχεδιασμός

## 2.1 Στόχοι του προκαταρτικού σχεδιασμού

Ο προκαταρτικός σχεδιασμός αναφέρεται στην δημιουργική φάση σχεδιασμού ενός συστήματος. Συνήθως αποτελείται από τη φάση του προσδιρισμού των λειτουργιών του προς σχεδίαση συστήματος, τη φάση της διατύπωσης των προϋποθέσεων, των προδιαγραφών, αλλά και των στόχων του σχεδιασμού, και τη φάση της υλοποίησης της σχεδιαστικής πρότασης. Πολλές φορές επίσης, αναλύονται εναλλακτικές σχεδιαστικές προτάσεις και αξιολογούνται με διάφορες μεθόδους ώστε να προκύψει η βέλτιστη σχεδιαστική πρόταση για το προς μελέτη σύστημα [3]. Παρακάτω θα αναλυθούν οι προδιαγραφές του σχεδιασμού και οι προϋποθέσεις της σχειδαστικής πρότασεις.
Η αποστολή ενός ρομποτικού διασώστη μπορεί να διαφέρει σημαντικά, όπως και η πληθώρα των πιθανών καταστροφών. Ιδιαίτερα σε περίπτωση σεισμού, η χρήση ενός τέτοιου συστήματος καθίσταται ακόμη πιο αποτελεσματική, τόσο επειδή η σχεδίαση και υλοποίηση ενός ρομποτικού διασώστη παρουσιάζει λιγότερες τεχνικές δυσκολίες, όσο και επειδή οι άνθρωποι διασώστες εκτίθενται σε υψηλό και απρόβλεπτο κίνδυνο. Ένας άνθρωπος διασώστης που επιχειρεί να εισχωρήσει σε συντρίμμια για τον εντοπισμό θυμάτων δεν μπορεί να γνωρίζει εάν και πότε ενδέχεται να σημειωθεί επιπλέον κατάρρευση ή πτώση φερώντων υλικών με αποτέλεσμα να διακινδυνεύει τη ζωή του. Επιπλέον, οι άνθρωποι διασώστες συχνά αντιμετωπίζουν σημαντικούς περιορισμούς χώρου σε τέτοιες αποστολές. Λόγω του όγκου του ανθρώπινου σώματος, πολλές φορές δεν είναι δυνατόν να περάσουν μέσα από πολύ στενά ανοίγματα ή σχισμές, στα οποία ενδέχεται να βρίσκεται παγιδευμένο κάποιο θύμα. Έτσι, ένας ρομποτικός διασώστης για σεισμικές καταστροφές καθίσταται ιδιαίτερα χρήσιμος και αποτελεσματικός.
Η χρήση των ρομποτικών διασώστων μπορεί επίσης να ποικίλει. Τα ρομπότ αυτά συχνά δαιχωρίζονται στα παρακάτω είδη. Προφανώς ένας ρομποτικός διασώστης μπορεί να σχεδιάζεται για να λειτουργεί με οποιονδήποτε συνδυασμό όλων των παρακάτω:
- Ρομπότ έρευνας και ανίχνευσης. Βασικός στόχος του διασώστη αυτού είναι η έρευνα μιας πληγείσας περιοχής και η ανίχνευση πιθανών θυμάτων ή αιτιών της καταστροφής.
- Ρομπότ αρωγής ανθρώπινων αποστολών. Τα ρομπότ αυτά υποστηρίζουν τους ανθρώπους διασώστες κατά τη διάρκεια των επιχειρήσεων, παρέχοντας βοήθεια όπου απαιτείται.
- Ρομπότ παροχής πρώτων βοηθειών. Έχουν ως κύρια αποστολή τη μεταφορά ειδών πρώτης ανάγκης ή ιατρικού εξοπλισμού σε δυσπρόσιτες περιοχές όπου μπορεί να βρίσκονται θύματα.
- Άμεσοι ρομποτικοί διασώστες. Αποτελούν την πιο προηγμένη κατηγορία, καθώς σχεδιάζονται για να λειτουργούν ημιαυτόνομα σε επιχειρήσεις απεγκλωβισμού. Διαθέτουν μηχανισμούς για τον εντοπισμό, την απελευθέρωση και τη μεταφορά θυμάτων.

Παρακάτω φαίνονται μερικά παραδείγματα ρομποτικών διασωστών με διάφορες λειτουργίες. Αυτά τα ρομπότ εξειδικεύονται σε USAR αποστολές και έχουν αναπτυχθεί στην Ιαπωνία, όπου η ανάγκη για τέτοιες τεχνολογίες είναι πολύ μεγάλη λόγω της συχνότητας αλλά και της κλίμακας των σεισμικών καταστροφών. Για τα πλαίσια αυτής εργασίας κρίνεται σκόπιμο να σχεδιασθεί ένας διασώστης για USAR αποστολές και πιο συγκεκριμένα για αποστολές διάσωσης μετά από σεισμούς.


(αfl) CHIMP (CMU Highly Intelligent Mobile Platform) ρομποτικός διασώστης.


(βfl) T-52 Enryu (Rescue Dragon) ρομποτικός εξομοιωτής.


(γfl) | SMURF | (Soft | Miniaturized
Underground Robotic Finder) ανιχνευτής.

Σχήμα 2.1: Διάφοροι ρομποτικοί διασώστες γαι ξεχωριστές λειτουργίες. Από αριστερά προς τα δεξιά: άμεσος ρομποτικός διασώστης, ρομπότ αρωγής ανθρώπινων αποστολών, ρομπότ έρευνας και ανίχνευσης.

Με βάση όλα τα παραπάνω, η κύρια λειτουργία του διασώστη εκλέγεται να είναι η ανίχνευση και η έρευνα μετά από σεισμικές καταστροφές. Ο διασώστης προς σχεδιάση θα κληθεί κατά τη λειτουργία του να αναζητά και να εντοπίζει θύματα καθώς και να παρέχει σε αυτά είδη πρώτων αναγκών. Επομένως, η λειτουργία του ρομπότ θα είναι καθαρά ο εντοπισμός των θυμάτων ή των επιζόντων που χρήζουν βοήθεια. Για να έχει νόημα ένα τέτοιο σύστημα θα πρέπει προφανώς το ρομπότ να είναι αρκετά μικρό ώστε να μπορεί διασχίζει περάσματα μη προσβάσιμα από άνθρωπο. Επίσης, το όλο σύστημα θα λειτουργεί με αλγόριθμο εντοπισμού ώστε το ρομπότ να είναι αυτόνομο. Η ημιαυτονομία θα προκύπτει από το γεγονός ότι ο ειδικευμένος χειριστής του ρομπότ θα μπορεί ανά πάσα στιγμή να πάρει τα ηνία και να χειριστεί απομακρυσμένα το ρομπότ.
Επομένως, λόγω της φύσης της λειτουργίας του ρομποτικού διασώστη, πρέπει να ληφθούν υπόψη οι παρακάτω προϋποθέσεις σχεδιασμού:
- Ο διασώστης θα πρέπει να μπορεί να εισχωρεί σε συντρήμια.
- Ο διασώστης θα πρέπει να είναι ανθεκτικός σε κρούσεις και απότομες μεταβολές φορτίου.
- Ο διασώστης θα πρέπει να μπορεί να αποφύγει εμπόδια και να κινείται σε ανώμαλο έδαφος.
- Ο διασώστης θα πρέπει να έχει, φιλικό προς το θύμα, τρόπο να παραδίδει είδη πρώτων βοηθειών.
- Ο διασώστης θα πρέπει να έχει μεγάλη αυτονομία μπαταρίας και να λειτουργεί ημιαυτόνομα.

Αναλύοντας τα παραπάνω, προκύπτουν πιο συγκεκριμένα οι προϋποθέσεις/στόχοι (requirements) του σχεδιασμού. Πιο συγκεκριμένα για να μπορεί ο διασώστης να εισχωρεί σε συντρήμια, θα πρέπει να είναι αρκούντως μικρός. Επίσης, όσο αναφορά την ανθεκτικτότητα, τα υλικά του ρομπότ θα πρέπει να χαρακτηρίζονται από υψηλή αντοχή. Για να επιτευχθεί η εύκολη αποφυγή εμποδίων (transversability), κρίνεται σκόπιμη η χρήση ερπύστριας καθώς προσφέρει τη μέγιστη προσαρμοστικότητα σε ανώμαλα εδάφη. Ο διασώστης θα πρέπει επίσης να είναι όσο πιο ελαφρύς γίνεται από άποψη κόστους αλλά και για να είναι όσο πιο φιλικός προς το θύμα. Τέλος, η μεγάλη διάρκεια ζωής έγγυται στο ότι πρέπει ο διασώστης να διαρκεί όσο μια τυπική επιχείρηση έρευνας και διάσωσης. Με βάση όλα αυτά φαίνονται παρακάτω οι προϋποθέσεις του σχεδιασμού αναλυτικά. Σχετικά με τις μέγιστες διαστάσεις και το βάρος του διασώστη, αυτά δε προκύπτουν τελείως αυθαίρετα αλλά με βάση τις διαστάσεις του Πίν. 2.2, της πλατφόρμας Plasma RX [2], στην οποία γίνεται εκτενή αναφορά στα παρακάτω κεφάλαια.

Requirement | Description
R-01 | Ο διασώστης θα πρέπει να ζυγίζει λιγότερο από 35 kg.
R-02 | Ο διασώστης θα πρέπει είναι μικρότερος από 65 × 65 × 65cm3 .
R-03 | Η αυτονομία του διασώστη θα πρέπει να διαρκεί τουλάχιστον 3h.
R-04 | Ο διασώστης θα πρέπει μεταφέρει ήδη πρώτων αναγκών έως και 5 kg.
R-05 | Ο διασώστης θα πρέπει να λειτουργεί ημιαυτόνομα, όπου ο χειριστής να μπορεί ανά πάσα στιγμή να πάρει τον έλεγχο του ρομπότ.

Πίνακας 2.1: Προϋποθέσεις σχεδιασμού ρομποτικού διασώστη για USAR αποστολές.

Επίσης, όσο αναφορά την ανάλυση των περαιτέρω σχεδιαστικών προτάσεων, κρίνεται αναγκαίο για την επίτευξη των χρονικών ορίων της εργασίας, να μην αναλυθεί πάνω από μια σχεδιαστική πρόταση. Έτσι, ο προκαταρτικός σχεδιασμός θα αποτελείται από δύο επαναλήψεις (loops) με σκοπό τη βελτιστοποίση του βάρους του διασώστη. Η γενικότερη πορεία του σχεδιασμού μπορεί να συνοψιστεί στο Σχ. 2.2. Ξεκινώντας από τις απαιτήσεις του σχεδιασμού, προκύπτει η βασική σχεδιαστική ιδέα. Έπειτα, η βασική ιδέα βελτιώνεται με σκοπό τη μείωση της μάζας του ρομπότ. Αφού σχεδιαστεί η βελτιωμένη έκδοση του ρομπότ, σειρά έχει ο σχεδιασμός του κυκλώματος και η επιλογή των ηλεκτρονικών καθώς και η ανάλυση της αυτονομίας της μπαταρίας του ρομπότ. Τέλος, προχωρώντας πλέον στον διαμορφωτικό σχεδιασμό, αναλύονται οι μηχανισμοί των οδοντωτών τροχών αλλά και των λοιπών μηχανολογικών στοιχείων. Με την ολοκλήρωση και αυτού του σταδίου προκύπτει η τελική σχεδιαστική πρόταση καθώς και προτάσεις για περαιτέρω βελτίωση του διασώστη.


Σχήμα 2.2: Γενικότερη πορεία σχεδιασμού και σταδίων της μελέτης.

## 2.2 Ανάλυση απαιτήσεων συστήματος

### 2.2.1 Λειτουργικές απαιτήσεις

Στα πλαίσια του σχεδιασμού της αρχιτεκτονικής ελέγχου του ρομπότ, κρίνεται απαραίτητος ο σαφής καθορισμός της ισορροπίας μεταξύ των εντολών του χειριστή-διασώστη και του βαθμού αυτονομίας του συστήματος. Επιπροσθέτως, για λόγους συντομίας και ευκολίας στην αναφορά κατά την παρούσα μελέτη, στο προτεινόμενο ρομποτικό σύστημα αποδίδεται η κωδική ονομασία V.L.A.D. (Victim Localization Assistant Droid). Εφεξής, η αναφορά στο σύστημα θα γίνεται με τη χρήση αυτού του ακρωνυμίου.
Εξετάζοντας το περιβάλλον στο οποίο θα δρα το V.L.A.D., όπως και έχει ήδη αναφερθεί, θα πρέπει η λειτουργικότητα του συστήματος να δίνει τη δυνατότητα για ευκολία στην αποφυγή εμποδίων και την προσαρμοστικότητα σε ανώμαλα εδάφη. Επίσης, θα πρέπει το κέντρο βάρους του συστήματος να βρίσκεται χαμηλά αλλά και η ροπή αδράνειας του ως προς τους άξονες παράλληλους στο έδαφος του πεδίου να είναι υψηλή, ώστε να αποφευχθεί η ανατροπή του συστήματος.
Η χρήση του V.L.A.D. θα είναι καθαρά μη παρεμβατική καθώς σχεδιάζεται έτσι ώστε να είναι μικρό και ταχύ. Αυτή η λειτουργία ενισχύει τη χρήση του σε αποστολές έρευνας και ανίχνευσης και για αυτό ο κύριος σκοπός του συστήματος θα είναι ο εντοπισμός θυμάτων ή επιζώντων μετά από τη καταστροφή. Το σύστημα έπειτα θα έχει ως σκοπό να παρέχει πρώτες βοήθειες στους επιζώντες και να ειδοποιεί τον χειριστή του για την ακριβή θέση και κατάσταση των επιζώντων ώστε να καταστρωθεί η αποστολή διάσωσής τους.
Το λειτουργικό σύστημα θα καταστρωθεί έτσι ώστε, οι ενδείξεις και τα δεδομένα από τους αισθητήρες να χρησιμοποιούνται σε μοντέλα αναγνώρισης επιζώντων/θυμάτων. Έπειτα, με υπολογιστική λογική θα προκύπτουν οι επόμενες κινήσεις του συστήματος. Μία εξ αυτών θα είναι και η σήμανση προς τον χειριστή σε περίπτωση που προκύπτουν σφάλματα από τα μοντέλα επεξεργασίας δεδομένων ή λόγω σύντηξης σε επίπεδο απόφασης των μοντέλων.
Με βάση τα παραπάνω, οι στόχοι του σχεδιασμού του λειτουργικού συστήματος συνοψίζονται παρακάτω:
- Ανίχνευση και εντοπισμός της ακριβής τοποθεσίας επιζώντων/θυμάτων μετά το πέρας της καταστροφής.
- Αναγνώριση εμποδίων και χαρτογράφηση χώρου κατά τη λειτουργία.
- Αυτόνομη λήψη αποφάσεων στηριζόμενη από μοντέλα μηχανικής μάθησης και επεξεργασίας δεδομένων.

Επομένως, η επιλογή των αισθητήρων θα πρέπει να δικαιολογείται με τη κατάστρωση ενός υποθετικού πλάνου λειτουργίας του συστήματος για απόδειξη της ορθής λειτουργίας του.
Ξεκινώντας με την ανίχνευση και τον εντοπισμό των θυμάτων, αναλύοντας τις πιθανές ανάγκες σε μια τέτοια κατάσταση, το V.L.A.D. θα πρέπει να είναι ικανό να:
- Φέρνει σε επικοινωνία τους επιζώντες με το χειριστή
- Μεταφέρει εικόνες των θυμάτων/επιζώντων στο χειριστή
- Αναγνωρίζει αυτόνομα τον ανθρώπινο οργανισμό

Για την επίτευξη των παραπάνω, διάφοροι συνδυασμοί αισθητήρων θα μπορούσαν να χρησιμοποιηθούν. Σε περίπτωση μη ορατότητας του επιζώντος, θα πρέπει το V.L.A.D. να ανιχνεύει τη παραμικρή κίνηση ή και ήχο και μέσω αυτής/ού να λαμβάνει ημιαυτόνομα αποφάσεις. Κρίνεται σκόπιμο σε μια τέτοια κατάσταση, να υπάρχει η δυνατότητα ανίχνευσης σημάτων δονήσεων υψηλής αλλά και χαμηλής συχνότητας καθώς και ηχητικών σημάτων. Για τα τελευταία, η χρήση ενός απλού μικροφώνου είναι αρκετή για να επιτρέψει την επικοινωνία των επιζώντων με το κέντρο ελέγχου/χειριστή. Όσο αναοφρά τα σήματα υψηλής συχνότητας, αυτά μπορούν να ανφέρονται σε σήματα από χτύπους (tapping, knocking) οι οποίοι μπορεί να δηλώνουν την ύπαρξη του ανθρώπου στα συντρήμμια. Αντίστοιχα, τα σήματα χαμηλής συχνότητας όπως η ανθρώπινη κίνηση ή η αναπνοή δηλώνουν το ίδιο. Για την ανίχνευση τέτοιων σημάτων, η χρήση επιταχυνσιόμετρων είναι ικανοποιητική.
Άλλες ανάγκες ανίχνευσης σε τέτοιες αποστολές είναι η εικόνα. Αντί της συμβατικής κάμερας προτιμάται η χρήση θερμικής κάμερας ευρείας γωνίας. Αυτό γιατί η θερμική κάμερα θα επιτρέψει στον διασώστη να λαμβάνει δεδομένα πίσω από ογκώδη αντικείμενα αλλά και για τη καταγραφή εικόνας ανεξαρτήτος της φωτεινότητας του χώρου. Σε πολύ κρυφά σημεία μέσα στα συντρήμμια μπορεί να μην υπάρχει η δυνατότητα να περάσουν οι ακτίνες του φωτός, καθιστόντας μια συμβατική κάμερα χωρίς κάποιου είδους περαιτέρω φωτισμού μη χρήσιμη.
Τέλος, για τη βελτίωση της ευρωστίας του συτήματος αλλά και για μια πιο ολοκληρωμένη συλλογή δεδομένων κατά την λειτουργία, δύναται να χρησιμοποιηθούν αισθητήρες καταγραφής ρύπων και συγκεκριμένα CO2. Ο ανθρώπινος οργανισμός εκμπέμπει υψηλή συγκέντρωση του προαναφερόμενου ρύπου, με αποτελέσμα να καθίσταται ιδιαίτερα χρήσιμη για την ανίχνευση των επιζόντων ένας τέτοιος αισθητήρας.


Σχήμα 2.3: Δυνατότητες ανίχνευσης ρομποτικού διασώστη με βάση το διαφορετικό είδος δεδομένων.

Οι προαναφερθέντες αισθητήρες συμβάλλουν καθοριστικά στον εντοπισμό των θυμάτων, ωστόσο, δεν επαρκούν για την αντίληψη του χώρου από την πλευρά του ρομπότ. Συγκεκριμένα, αδυνατούν να υποστηρίξουν λειτουργίες χαρτογράφησης του άγνωστου περιβάλλοντος ή να εντοπίσουν εμπόδια που απειλούν την ακεραιότητα του οχήματος. Συνεπώς, για την επίτευξη αυτόνομης ή ημι-αυτόνομης πλοήγησης, κρίνεται απαραίτητη η ενσωμάτωση μιας επιπρόσθετης σουίτας αισθητήρων πλοήγησης.
Αρχικά, είναι αναγκαίο το σύστημα να γνωρίζει ανά πάσα στιγμή τον προσανατολισμό του και τις μεταβολές της κινητικής του κατάστασης στον χώρο. Η λειτουργία αυτή επιτυγχάνεται μέσω μιας μονάδας αδρανειακών μετρήσεων (Inertial Measurement Unit - IMU). Ο συγκεκριμένος αισθητήρας συνδυάζει δεδομένα από επιταχυνσιόμετρα, γυροσκόπια και συχνά μαγνητόμετρα. Στο πλαίσιο του V.L.A.D., το IMU είναι κρίσιμο για τον αλγόριθμο εκτίμησης θέσης, καθώς παρέχει δεδομένα για τις γωνίες Euler (Roll, Pitch, Yaw), επιτρέποντας στο ρομπότ να αντιλαμβάνεται την κλίση του σε ράμπες ή σκάλες και να διορθώνει την πορεία του.
Έπειτα, για τη διαδικασία της χαρτογράφησης και του ταυτόχρονου εντοπισμού θέσης, η βιβλιογραφία προτείνει διάφορες προσεγγίσεις. Μία επιλογή αποτελεί η χρήση τρισδιάστατων σαρωτών laser (3D LiDAR), οι οποίοι προσφέρουν πλήρη γεωμετρική αναπαράσταση του χώρου, αλλά με υψηλό κόστος και υπολογιστικό φόρτο. Μια εναλλακτική είναι οι κάμερες βάθους (RGB-D Cameras), οι οποίες παρέχουν πληροφορία χρώματος και απόστασης, ωστόσο η απόδοσή τους επηρεάζεται σημαντικά από τις συνθήκες φωτισμού και τη σκόνη που συχνά επικρατούν σε σενάρια καταστροφών.
Για την περίπτωση του V.L.A.D., η βέλτιστη λύση, λαμβάνοντας υπόψη τους περιορισμούς κόστους και υπολογιστικής ισχύος, κρίνεται η χρήση ενός δισδιάστατου σαρωτή laser (2D LiDAR 360◦
). Ο αισθητήρας αυτός λειτουργεί εκπέμποντας παλμούς laser περιστροφικά, μετρώντας τον χρόνο που απαιτείται για την επιστροφή της δέσμης. Το αποτέλεσμα είναι η δημιουργία ενός δισδιάστατου νέφους σημείων σε πραγματικό χρόνο, το οποίο επιτρέπει σε αντίστοιχο λογισμικό να δημιουργήσει έναν χάρτη κατάληψης, εντοπίζοντας τοίχους και εμπόδια περιμετρικά του ρομπότ με υψηλή ακρίβεια.
Συνοψίζοντας, οι αισθητήρες που κρίνονται αναγκαίοι για την ορθή και αξιόπιστη λειτουργία του V.L.A.D. είναι αισθητήρες καταγραφής διοξειδίου του άνθρακα (CO2), αισθητήρες καταγραφής ήχου (μικρόφωνο), αισθητήρας θερμικής απεικόνισης (thermal image camera) και τέλος αισθητήρας καταγραφής ταλαντωτικών σημάτων (επιταχυνσιόμετρο) για την ανίχνευση των θυμάτων. Αντίστοιχα, χρειάζονται επίσης και αισθητήρες IMU και 2D LiDAR για τη χαρτογράφηση και την αναγνώριση εμποδίων. Με την σωστή διαχείριση και επεξεργασία των δεδομένων των παραπάνω αισθητήρων, ο διασώστης καλύπτει πολύ μεγάλο εύρος δυνατοτήτων κατά τις αποστολές εύρευνας και ανίχνευσης, καθιστόντας το σύστημα ικανό να πετύχει τον σκοπό για τον οποίο σχεδιάζεται.

### 2.2.2 Μηχανικές απαιτήσεις

Σύστημα κίνησης

Καθώς η μελέτη βασίζεται σε ρομποτικό σύστημα το οποίο θα πρέπει να κινείται σε συντρήμμια μετά το πέρας καταστροφών, είναι ύψιστης σημασίας να αναλυθούν οι μηχανικές απαιτήσεις του ρομπότ για την ορθή λειτουργία του. Όσο αναφορά τα ρομποτικά συστήματα και τα υποσυστήματα μετάδοσης της κίνησης, υπάρχουν διάφοροι τρόποι να ενιχύσει κανείς τη δυνατότητα του συστήματος να διασχίζει ανώμαλα εδάφη με ευκολία. Μερικές επιλογές για το σύστημα κίνησης πέρα από τη τυπική οδήγηση με τροχούς παρουσιάζονται παρακάτω [6].
Η χρήση μηχανισμού ερπύστριας αποτελεί μία από τις πιο αποδοτικές μεθόδους για την πλοήγηση ρομποτικών οχημάτων σε δύσβατα και ανώμαλα εδάφη. Δομικά, το σύστημα αποτελείται από τον οδοντωτό τροχό μετάδοσης κίνησης (sprocket), τους τροχούς υποστήριξης (roller wheels) και τον τροχό τάνυσης (idler). Το κυρίως σώμα της ερπύστριας συγκροτείται από αρθρωτούς συνδέσμους (links) που φέρουν τα πέλματα (track shoes). Λειτουργικά, ο οδοντωτός τροχός λαμβάνει ροπή από τον κινητήρα και την μετατρέπει σε γραμμική κίνηση της αλυσίδας. Οι τροχοί υποστήριξης κατανέμουν το βάρος του οχήματος στο έδαφος, ενώ περιστρέφονται ελεύθερα. Τα πέλματα είναι σχεδιασμένα ώστε να μεγιστοποιούν την πρόσφυση (traction) και να μειώνουν την πίεση που ασκείται στο έδαφος (ground pressure), επιτρέποντας την κίνηση σε μαλακά ή ανώμαλα υποστρώματα. Τέλος, ο τροχός τάνυσης ρυθμίζει την ένταση της αλυσίδας, απορροφώντας τυχόν χαλαρώσεις (slack) και εξασφαλίζοντας τη σταθερή εμπλοκή των εξαρτημάτων κατά την κίνηση. Εναλλακτικά, οι ερπύστριες μπορούν να είναι και ενιαίας χύτευσης (continuous tracks). Οι ερπύστριες αυτές είναι κατασκευασμένες από ενισχυμένο συνθετικό ελαστικό και φέρουν στην εσωτερική τους πλευρά διαμορφωμένες προεξοχές (drive lugs), οι οποίες εμπλέκονται άμεσα με εσοχές στον κινητήριο τροχό (sprocket), επιτυγχάνοντας έτσι θετική μετάδοση κίνησης χωρίς ολίσθηση.


Σχήμα 2.4: Μηχανικά μέρη ερπυστρίας.

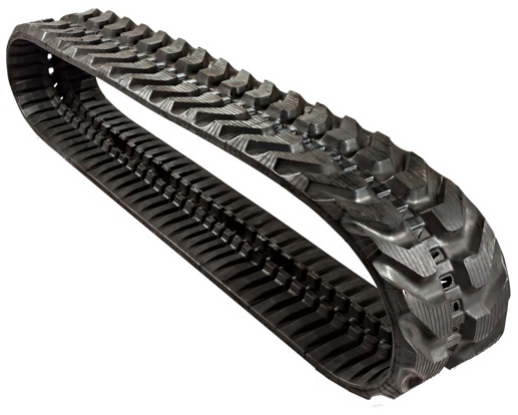
[picture p105: figure]

(αfl) Ερπύστρια με αρθρωτούς συνδέσμους. | (βfl) Ενιαία ερπύστρια.

Σχήμα 2.5: Σύγκριση διαφορετικών ειδών ερπύστριας.

Άλλη επιλογή για το σύστημα κίνησης αποτελούν οι ερπύστριες μεταβλητής γεωμετρίας. Αυτή η κατηγορία αφορά ερπυστριοφόρα οχήματα που έχουν τη δυνατότητα να αλλάζουν το σχήμα της ερπύστριας κατά τη λειτουργία τους. Το σασί ή οι τροχοί τάνυσης κινούνται μέσω ενεργοποιητών, αλλάζοντας το περίγραμμα της ερπύστριας. Επίσης, αντί ερπυστριών, μπορούν αν χρησιμοποιηθούν και τροχοί μεταβλητής γεωμετρίας. Και τα δύο προαναφερθέντα συστήματα κίνησης βασίζονται στη μεταβολή της γεωμετρίας των τροχών ή και του γενικότερου συστήματος κίνησης για τη διευκόλυνση της κίνησης σε ανώμαλα εδάφη αλλά και για την αλλαγή του κέντρου βάρους σε σημείο που εξυπηρετεί καλύτερα κατά την λειτουργία του οχήματος. Τέτοια συστήματα παρουσιάζονται παρακάτω.

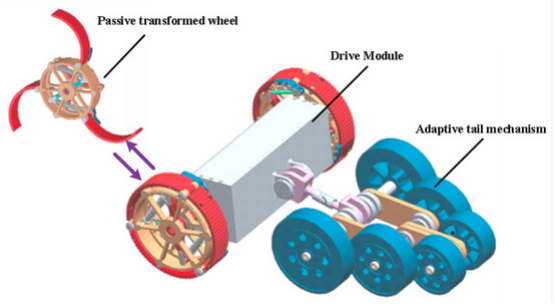
[picture p106: figure]

(αfl) Σύστημα μεταβλητής γεωμετρίας ερπύστριας [12]. | (βfl) Σύστημα μεταβλητής γεωμετρίας τροχού [16].

Σχήμα 2.6: Συστήματα κίνησης μεταβλητής γεωμετρίας.

Τέλος, τα συστήματα με το μεγαλύτερο ενδιαφέρον, αλλά και αυτά με τα οποία ασχολείται η παρόν μελέτη, είναι τα συστήματα πολλαπλών ερπυστριών όπου το όχημα αποτελείται από επιπλέον ερπύστριες που δύναται να κινούνται σε σχέση με το σώμα του ρομπότ. Οι δεύτερες αναφέρονται και ως ερπύστριες με περιστρεφόμενους βραχίονες και αποτελούν τη πιο δημοφιλή κατηγορία συστήματος κίνησης σε ρομποτικούς διασώστες. Τα συστήματα αυτά αποτελούνται από το κύριο σώμα ερπύστριας (main track) και από βοηθητικές, μικρότερες ερπύστριες προσαρμοσμένες στα άκρα, οι οποίες ονομάζονται Flippers ή Sub-tracks. Οι βραχίονες αυτοί έχουν τη δυνατότητα ενεργής περιστροφής (συνήθως 360 μοιρών) γύρω από τον άξονα του κινητήριου τροχού ή του τροχού τάνυσης. Η συγκεκριμένη αρχιτεκτονική επιτρέπει τη δυναμική μεταβολή της γεωμετρίας του ρομπότ, καθιστώντας εφικτή την υπερπήδηση εμποδίων ύψους μεγαλύτερου από τη διάμετρο του τροχού, καθώς και την ασφαλή πλοήγηση σε κλιμακοστάσια μέσω της ενεργής μετατόπισης του κέντρου μάζας. Τέτοιο σύστημα παρουσιάζεται παρακάτω.

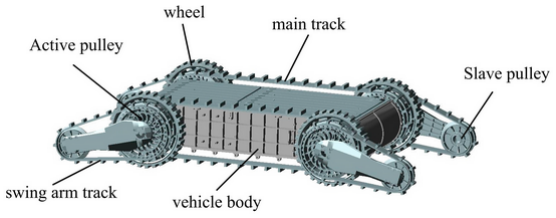
[picture p107: figure]

Σχήμα 2.7: Σύστημα πολλαπλής ερπύστριας με περιστρεφόμενο βραχίονα [5].

Η επιλογή του συστήματος κίνησης με ερπύστρια και περιστρεφόμενους βραχίονες (flipper tracks) για την παρούσα μελέτη βασίστηκε στην αδιαμφισβήτητη υπεροχή του έναντι των συμβατικών μεθόδων πλοήγησης. Παράλληλα, πρόκειται για μια τεχνολογική λύση ευρέως διαδεδομένη στα ρομποτικά συστήματα διάσωσης, γεγονός που εξασφαλίζει την ύπαρξη εκτενούς βιβλιογραφίας και ερευνητικών δεδομένων για την υποστήριξη του σχεδιασμού. Η υπεροχή του συστήματος αυτού βασίζεται κυρίως στο γεγονός ότι δίνεται η δυνατότητα στο V.L.A.D. να αναριχείται με ευκολία σε σκάλες/υψώματα. Περιστρέφοντας τα flippers προς τα κάτω, το ρομπότ ανυψώνει το μπροστινό μέρος του σώματος του, αλλάζοντας τη γωνία προσβολής. Αυτό επιτρέπει στο ρομπότ να ξεπεράσει ψηλά εμπόδια όπως ένα σκαλοπάτι. Επίσης, ο περιστρεφόμενος βραχίονας βοηθάει στη γενικότερη διαχείριση του κέντρου βάρους της πλατφόρμας. Κατά την άνοδο σε απότομες κλίσεις, τα flippers εκτείνονται μπροστά ή πίσω για να αυξήσουν το ενεργό μήκος του οχήματος. Αυτό μετατοπίζει το κέντρο βάρους και αποτρέπει την εκτροπή της πλατφόρμας όπως φαίνεται και στο Σχ. 2.8. Επιπροσθέτως, η συμβολή των αρθρωτών βραχιόνων (flippers) κρίνεται καθοριστική για τη δυνατότητα διέλευσης εδαφικών κενών. Στις αποστολές έρευνας και διάσωσης, οι οποίες διεξάγονται κατά κανόνα σε μετα-καταστροφικά περιβάλλοντα, η παρουσία εδαφικών ασυνεχειών αποτελεί συχνό φαινόμενο και μείζονα πρόκληση για την κινητικότητα ενός ρομποτικού συστήματος. Τέλος, οι βραχίονες αυτοί καθίστανται χρήσιμοι και σε περίπτωση ανατροπής της πλατφόρμας, όπου με τη χρήση τους ως μοχλό μπορεί ένα ρομποτικό σύστημα να επανέλθει στο φυσικό του προσανατολισμό.

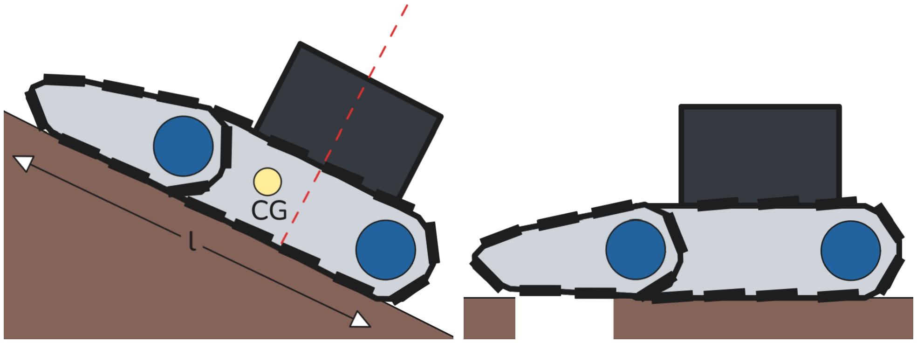
[picture p108: figure]
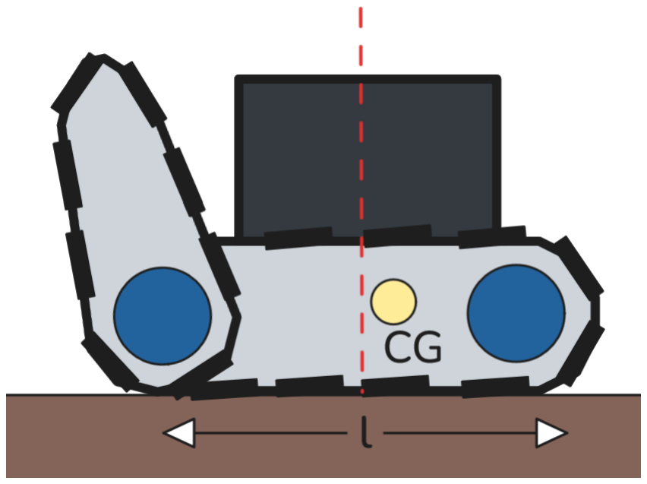
[picture p109: figure]

(αfl) Κίνηση σε ευθεία. | (βfl) Κίνηση σε κεκλιμένο επίπεδο. | (γfl) Διέλευση εδαφικών ασυνεχειών.

Σχήμα 2.8: Σενάρια κίνησης συστήματος με διπλή ερπύστρια και περιστρεφόμενο βραχίονα (Flipper).

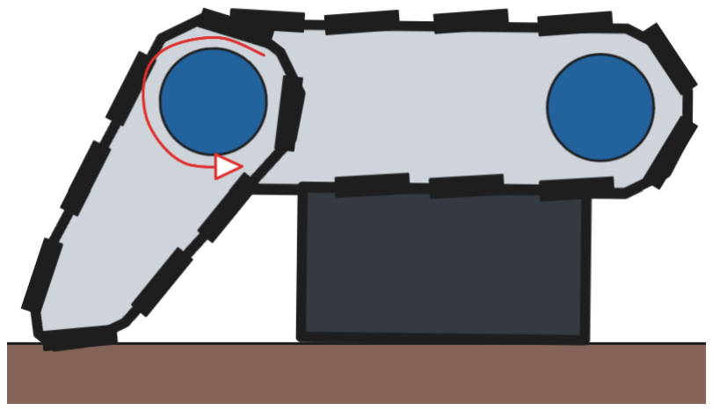
[picture p110: figure]
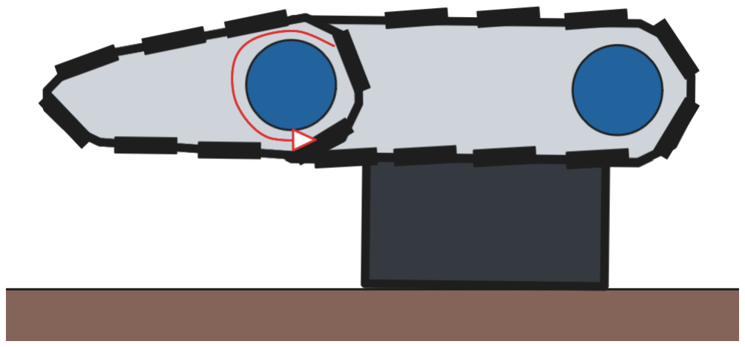
[picture p111: figure]

(αfl) Καρέ 1. | (βfl) Καρέ 2. | (γfl) Καρέ 3.

Σχήμα 2.9: Αλληλουχία επαναφοράς πλατφόρμας από ανατροπή με τη χρήση των flippers.

Μετάδοση κίνησης και αλλαγή κατεύθυνσης

Ο σύνηθης και πιο αποδοτικός τρόπος να κινείται ένας τέτοιος διασώστης είναι προφανώς η χρήση ηλεκτροκινητήρων. Για τη χρήση αυτών, θα πρέπει να επιλεχθεί το είδος του ηλεκτροκινητήρα καθώς και η διάταξη των κινητήρων. Η διάταξη και ο αριθμός των κινητήρων θα πρέπει να αποφασιστούν με γνώμονα τον επιθμητό τρόπο αλλαγής πορείας του ρομπότ.
Η επιλογή των ηλεκτροκινητήρων αποτελεί κρίσιμη παράμετρο για τον σχεδιασμό του συστήματος κίνησης, καθώς καθορίζει άμεσα την ικανότητα του ρομπότ να υπερνικά εμπόδια και να διαχειρίζεται το φορτίο του. Στη ρομποτική κινητικότητα, οι επικρατέστερες τεχνολογίες είναι τρεις.
Αρχικά, οι Βηματικοί Κινητήρες προσφέρουν υψηλή ακρίβεια θέσης χωρίς ανάγκη κλειστού βρόχου ελέγχου, ωστόσο απορρίπτονται συχνά σε εφαρμογές ταχείας κίνησης λόγω του χαμηλού λόγου ισχύος προς βάρος και της μειωμένης απόδοσης σε υψηλές στροφές. Μια δεύτερη κατηγορία είναι οι Κινητήρες Συνεχούς Ρεύματος. Διακρίνονται για την απλότητα της οδήγησής τους και το χαμηλό κόστος, αποτελώντας μια αξιόπιστη λύση και θεωρούνται η πλέον ενδεδειγμένη επιλογή για σύγχρονα ρομπότ έρευνας και διάσωσης. Αν και απαιτούν πολύπλοκα ηλεκτρονικά ελέγχου, προσφέρουν τον βέλτιστο λόγο ροπής-βάρους, υψηλότερη ενεργειακή απόδοση και μεγαλύτερη διάρκεια ζωής. Για αυτούς τους λόγους, το V.L.A.D. έχει επιλεχθεί να κινείται με κινητήρες συνεχούς ρεύματος.
Η ικανότητα αλλαγής πορείας ενός ρομποτικού οχήματος δύναται να υλοποιηθεί μέσω διαφορετικών μηχανικών διατάξεων, οι οποίες κατηγοριοποιούνται βάσει του τρόπου που επιβάλλουν τη ροπή στρέψης. Η πιο διαδεδομένη μέθοδος στα συμβατικά οχήματα είναι το σύστημα Ackermann (Ackermann steering), όπου η αλλαγή κατεύθυνσης επιτυγχάνεται μέσω της γεωμετρικής μεταβολής της γωνίας των κατευθυντήριων τροχών. Μια δεύτερη κατηγορία είναι η αρθρωτή αλλαγή διεύθυνσης (Articulated steering), κατά την οποία το σασί χωρίζεται σε δύο τμήματα που περιστρέφονται το ένα ως προς το άλλο, μέθοδος συνήθης σε βαρέα χωματουργικά οχήματα.
Ωστόσο, για τα ερπυστριοφόρα ρομπότ και τα οχήματα υψηλής ευελιξίας, προκρίνεται η μέθοδος της αλλαγής διεύθυνσης μέσω ολίσθησης (Skid Steering) ή διαφορικής (Differential Steering). Στη πρώτη, οι τροχοί ή οι ερπύστριες της αριστερής και της δεξιάς πλευράς κινούνται ανεξάρτητα. Η στροφή επιτυγχάνεται εφαρμόζοντας γωνιακές ταχύτητες αντίθετης κατεύθυνσης στην κάθε πλευρά, δημιουργώντας έτσι μια ροπή εκτροπής που εξαναγκάζει το όχημα να περιστραφεί ολισθαίνοντας. Το σημαντικότερο πλεονέκτημα αυτής της μεθόδου είναι η δυνατότητα επίτευξης μηδενικής ακτίνας στροφής, επιτρέποντας στο ρομπότ να περιστρέφεται γύρω από τον γεωμετρικό του άξονα, χαρακτηριστικό κρίσιμο για την πλοήγηση σε στενούς χώρους. Η δε δεύτερη, επιτυγχάνεται μέσω χρήσης ίδιας κατεύθυνσης αλλά διαφορετικής σε μέτρο, γωνιακή ταχύτητα σε κάθε πλευρά της πλατφόρμας, με αποτέλεσμα αυτή να στρίβει ακολουθώντας μια γεωμετρική καμπύλη στροφής.

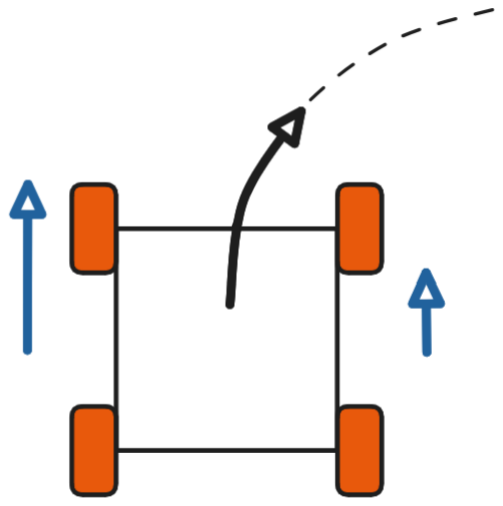
[picture p112: figure]

(αfl) Διαφορική αλλαγή κατεύθυνσης.


(βfl) Αλλαγή κατεύθυνσης μέσω ολίσθησης.

Σχήμα 2.10: Μέθοδοι αλλαγής κατεύθυνσης πλατφόρμας με τέσσερεις τροχούς.

## 2.3 Ισοζύγιο μάζας και διάταξη αισθητήρων

### 2.3.1 Αρχικός σχεδιασμός συστήματος κίνησης

Η ρομποτική πλατφόρμα Plasma RX

Ο τομέας της ρομποτικής διάσωσης γνωρίζει ραγδαία ανάπτυξη στις χώρες της Ασίας και, ειδικότερα, στην Ιαπωνία. Λόγω της έντονης σεισμικότητας που χαρακτηρίζει την περιοχή, η χρήση ρομποτικών διασωστών έχει αναχθεί σε επιτακτική ανάγκη για τη διασφάλιση της αποτελεσματικότητας και της ασφάλειας των επιχειρήσεων έρευνας και διάσωσης. Στο πλαίσιο αυτό, η σχεδίαση της πλατφόρμας V.L.A.D. ενσωματώνει και αξιοποιεί βέλτιστες πρακτικές και αρχιτεκτονικές επιλογές που έχουν προκύψει από την ιαπωνική έρευνα. Ιδιαίτερη έμφαση δίνεται σε λύσεις που έχουν δοκιμαστεί και διακριθεί στον ετήσιο διεθνή διαγωνισμό RoboCupRescue, ο οποίος αποτελεί πεδίο αναφοράς για την εξέλιξη των αυτόνομων διασωστικών συστημάτων.
Ειδικότερα, ξεκινώντας από το κρισιμότερο υποσύστημα ενός ρομποτικού διασώστη, αυτό της κίνησης, εξετάστηκαν σχεδιαστικές επιλογές που βασίζονται σε ερπύστριες με περιστρεφόμενους βραχίονες. Χαρακτηριστικό παράδειγμα αποτελεί η εργασία των Kamol Chuengsatiansup κ.ά. [2] και η ανάπτυξη της ρομποτικής πλατφόρμας Plasma RX. Η αρχιτεκτονική κίνησης του V.L.A.D. αντλεί το σχεδιαστικό της έναυσμα από την εν λόγω πλατφόρμα, ενώ επιμέρους στόχο της παρούσας έρευνας αποτελεί η βελτιστοποίηση του συγκεκριμένου μηχανισμού και η προσαρμογή του στις μικρότερες διαστάσεις του V.L.A.D.
Η πλατφόρμα Plasma RX συμμετείχε στον παγκόσμιο διαγωνισμό World RoboCup το 2008 κερδίζοντας τη πρώτη θέση και με τη βράβευση της καλύτερης κινητικότητας ρομποτικής πλατφόρμας. Η πλατφόρμα αφορά δύο διαφορετικούς διασώστες βασισμένους στην ίδια σχεδιαστική πρόταση. Αυτά είναι το RX και το Xiphias. Το μικρότερο εξ αυτών, το Xiphias, φέρει τα χαρακτηριστικά του Πίν. 2.2, και αποτελεί την έμπνευση για το V.L.A.D.

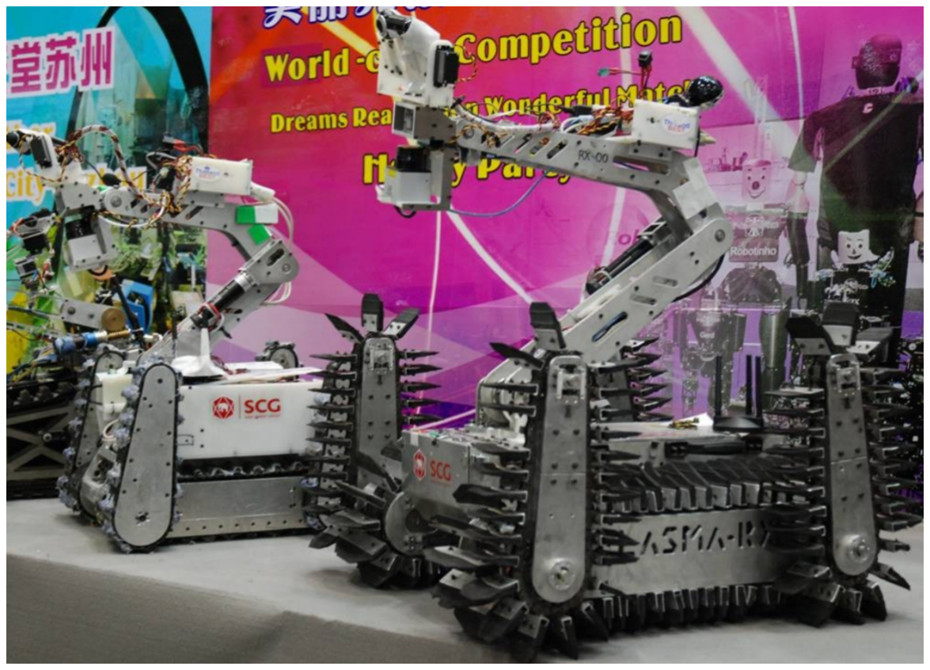
[picture p113: figure]

Σχήμα 2.11: Ρομποτική πλατφόρμα Plasma RX. Στα αριστερά το Xiphias και στα δεξιά το RX [2].

Characteristic | Value
Mass | 35 kg
Volume | 62 × 65 × 40cm3
Αριθμός βραχιόνων | 4 (2 σε κάθε πλευρά)

Πίνακας 2.2: Χαρακτηριστικά του ρομποτικού διασώστη Xiphias.

Η πλατφόρμα διασωστών Plasma RX αποτελείται από τέσσερεις συνολικά βραχίονες και έξι δαφορετικές ερπυστρίες. Επίσης, υιοθετεί και ρομποτικό χέρι-βραχίονα για την εξυπηρέτηση πιο δραστικών αναγκών ενός διασώστη από την απλή ανίχνευση. Το σύστημα κίνησης λειτουργεί με έξι συνολικά ηλεκτροκινητήρες εκ των οποίων, οι δύο είναι για τη μεταφορά της πλατφόρμας και τη κίνηση της βασικής ερπύστριας, ενώ οι υπόλοιποι τέσσερεις προορίζονται για τη περοστροφή των βραχιόνων (flippers).

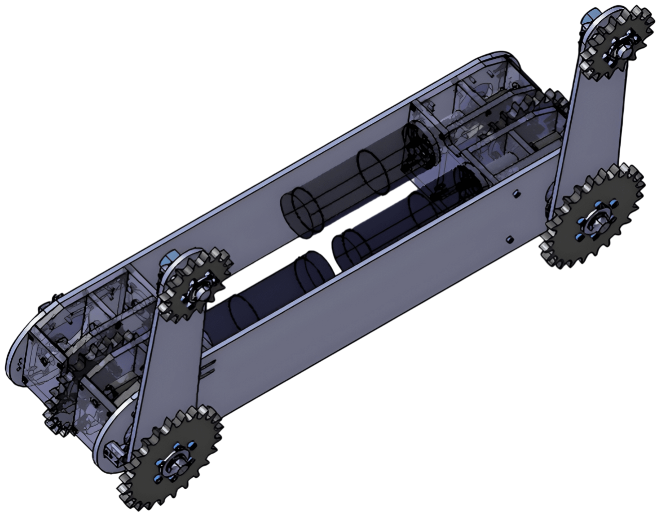
[picture p114: figure]

Σχήμα 2.12: Σύστημα κίνησης ερπύστριας και βραχιόνων της πλατφόρμας Plasma RX [2].

Παρακάτω φαίνεται επίσης και η τομή του συστήματος κίνησης. Αυτό αποτελείται από το περίβλημα του συστήματος (gearbox), δύο ζευγάρια οδοντωτών τροχών ατέρμονα-κορώνα, τον βραχίονα καθώς και τις ατράκτους για τη μεταφορά της κίνησης. Η κύρια άτρακτος (sprocket shaft) είναι υπεύθυνη για τη μετάδοση της κίνησης από τον ηλεκτροκινητήρα στο τροχό της ερπύστριας. Όπως παρατηρείτα, η ερπύστρια αποτελείται από αρθρωτούς συνδέσμους με πέλματα ενώ η διαφορετική περιστροφή του βραχίονα (flipper) και της κύριας ατράκτου επιτυγχάνεται μέσω χρήσης εδράνων κύλισης. Οι μεταφορές ροπής γίνονται με τη χρήση πολύσφηνων ή κοχλιών. Οι ερπύστριες των βραχιόνων και του κυρίου μέρους το συστήματος κίνησης κινούνται με κοινή γωνιακή ταχύτητα καθώς συνδέονται οι δύο τροχοί των διαφορετικών ερπυστριών στην ίδια άτρακτο κίνησης.
Η χρήση ζεύγους οδοντωτών τροχών ατέρμονα-κορώνας, αποτελεί μια ιδιαίτερα έξυπνη λύση για τη μεταφορά της ροπής. Η συγκεκριμένη οδοντοκίνηση χαρακτηρίζεται από μεγάλους λόγος μετάδοσης επιτρέποντας την μεγάλη αύξηση της ροπής έναντι της ταχύτητας. Επίσης, αποτελούν εξαιρετικά χρήσιμη λύση για την εξοικονόμιση χώρου καθώς μεταφέρουν τη ροπή σε άξονες κάθετους μεταξύ τους.


Σχήμα 2.13: Τομή συστήματος κίνησης Plasma RX [2].

Πρώτη εκδοχή πλατφόρμας V.L.A.D.

Ακολουθώντας τη σχεδιαστική λογική της παραπάνω πλατφόρμας, το πρώτο πράγμα που πρέπει να γίνει είναι ο σχεδιασμός των κομματιών που αποτελούν τη συναρμολογημένη διάταξη του συστήματος κίνησης. Οι αρχικές διαστάσεις των διαφόρων κομματιών προκύπτουν αυθαίρετα στην αρχή, τηρώντας τις προϋποθέσεις του σχεδιασμού στον Πίν. 2.1. Στη δεύτερη επανάληψη του ισοζυγίου μάζας θα προκύψουν πιο συγκεκριμένες και στοχευμένες διαστάσεις με γνώμονα που θα αναλυθεί παρακάτω. Στο πρώτο ισοζύγιο μάζας θα περιλαμβάνονται, τα δύο συμμετρικά κιβώτια κίνησης με τα επιμέρους κομμάτια και το σώμα της πλατφόρμας. Δε θα περιλαμβάνονται δηλαδή οι διαμορφώσεις για τον αποθηκευτικό χώρο του διασώστη αλλά και τα ηλεκτρονικά του συστήματος.


Σχήμα 2.14: Αρχική γεωμετρία για τη πρώτη επανάληψη του ισοζυγίου μάζας.

Ξεκινώντας με το σκαρίφημα της συναρμολογημένης, θα γίνουν έπειτα και τα τρισδιάστατα σχέδια του κάθε στοιχείου του μηχανισμού. Το σκαρίφημα φαίνεται στο Σχ. 2.15 και όπως παρατηρείται ακολουθεί πιστά τη πλατφόρμα του Plasma RX με ορισμένες αλλαγές. Οι αλλαγές αυτές αφορούν τον πιο ορθό ορισμό των εδράσεων.


Σχήμα 2.15: Αρχικό σκαρίφημα κιβωτίο κίνησης.

Στο παραπάνω σκαρίφημα, διακρίνονται όλα τα στοιχεία του μηχανισμού. Τα διαχωριστικά και το κιβώτιο κίνησης συνδέονται με κοχλίες καθώς και με στιβαρή πλάκα. Επομένως, αυτό είναι το στιβαρό κομμάτι του μηχανισμού. Η σταθερή έδραση γίνεται στα αριστερά, δηλαδή πιο κοντά στο σώμα της πλατφόρμας. Στο αρχικό σκαρίφημα υπάρχουν αρκετές εκρεμμότητες αλλά αυτές θα διορθωθούν κατά τη δεύτερη επανάληψη. Το πρώτο αυτό στάδιο χρησιμεύει στη πλαισίωση της ιδέας και στο να δημιουργήσει το αρχικό έναυσμα για τη δημιουργία των τρισδιάστατων αρχείων CAD των κομματιών αλλά και της συναρμολογημένης διάταξης του μηχανισμού. Αρχικά, γίνεται ο σχεδιασμός της κύριας ατράκτου. Θα χρησιμοποιηθούν ασφάλειες για τη τοποθέτηση όλων των στοιχείων και αυτό θα αναθεωρηθεί αργότερα. Η αρχική διάμετρος της ατράκτου επιλέγεται στα 20 mm. Δημιουργούνται όλα τα απαραίτητα διάκενα για τη τοποθέτηση των ασφαλειών και τη σταθεροποίηση των λοιπών στοιχείων. Επίσης, δημιουργούνται και τυφλές οπές για τη χρήση πολύσφηνου για τη μεταφορά της ροπής από την κύρια άτρακτο στους τροχούς των ερπυστριών. Θα σχεδιαστούν δύο συμμετρικά κιβώτια κίνησης που θα αποτελούνται από όλα τα επιμέρους στοιχεία κίνησης και τους κινητήρες. Όλα τα στοιχεία κίνησης θα αναφέρονται από εδώ και πέρα για τη πρώτη εκδοχή του σχεδιασμού ως v1 (version 1).

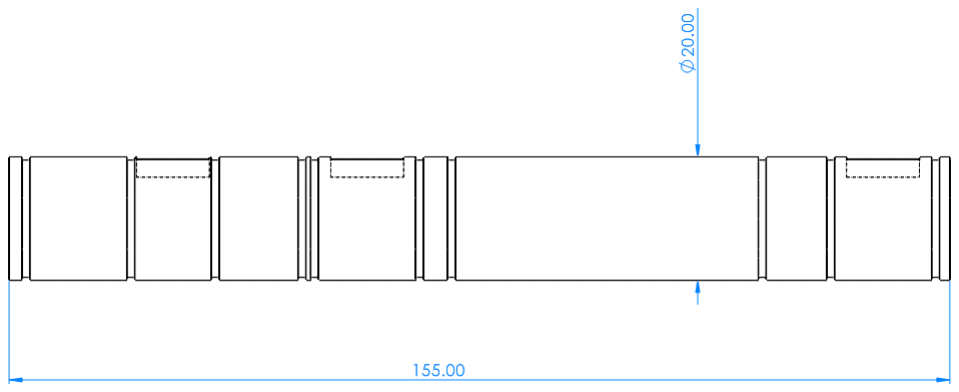
[picture p115: figure]

(αfl) Διαστάσεις της κύριας ατράκτου v1. | (βfl) Τριμετρική όψη κύριας ατράκτου v1.

Σχήμα 2.16: Τρισδιάστατο σχέδιο κύριας ατράκτου v1.

Έπειτα θα δημιουργηθεί ο βραχίονας (flipper) καθώς και η άτρακτος του βραχίονα (μανίκι). Το μανίκι θα πρέπει να εδράζεται στην κύρια άτρακτο κίνησης. Τα έδρανα κύλισης πρέπει εφαρμόζουν σε εσωτερική διάμετρο 20 mm. Όλα τα έδρανα κύλισης θα επιλεχθούν από τον επίσημο ιστότοπο της SKF Bearings. Οι ασφάλειες και τα λοιπά στοιχεία επιλέγονται από τον επίσημο ιστότοπο της McMaster Carr. Ο βραχίονας παρατηρείται παρακάτω.


Σχήμα 2.17: Περιστρεφόμενος βραχίονας v1.

Αυθαίρετα επιλέγονται τα έδρανα που φαίνονται στον Πίν. 2.3 για το σύστημα. Με βάση αυτές τις διαστάσεις σχεδιάζεται και η άτρακτος του βραχίονα καθώς και τα λοιπά μηχανολογικά στοιχεία. Ο τροχός της ερπύστριας επιλέγεται με διάμετρο αρκούντως μεγάλη για να προσφέρει ανοχή μεταξύ της αλυσίδας της ερπύστριας και του κιβωτίου κίνησης.

Bearing | Specification | Usage
w61704 | 20x27x4 mm | Σταθερή έδραση κύριας ατράκτου και έδραση διαχωριστικού
61804 | 20x32x7 mm | Εδράσεις ατράκτου βραχίονα
61809 | 45x58x7 mm | Έδραση κιβωτίου κίνησης

Πίνακας 2.3: Έδρανα κύλισης συστήματος κίνησης κύριας ερπύστριας και βραχίονα v1.

Παρακάτω φαίνεται η συναρμολογημένη του κιβωτίου με τα διαχωριστικά. Δύο συμμετρικά κιβώτια αποτελούν το σύστημα κίνησης της πλατφόρμας. Τα δύο αυτά κιβώτια θα συνδέονται με κοχλίες στο κεντρικό σώμα της πλατφόρμας. Το σώμα αυτό θα σχεδιασθεί για αρχή με συμβατικό τρόπο δημιουργείας σασί. Θα δημιουργηθεί δηλαδή δικτύωμα απο μεταλλικές μπάρες το οποίο θα περιβάλλεται απο μεταλλικές πλάκες. Αργότερα αυτό θα αναθεωρηθεί καθώς αποτελεί έναν παρχωχημένο, κοστοβόρο και μη αποδοτικό τρόπο σχεδιασμού.

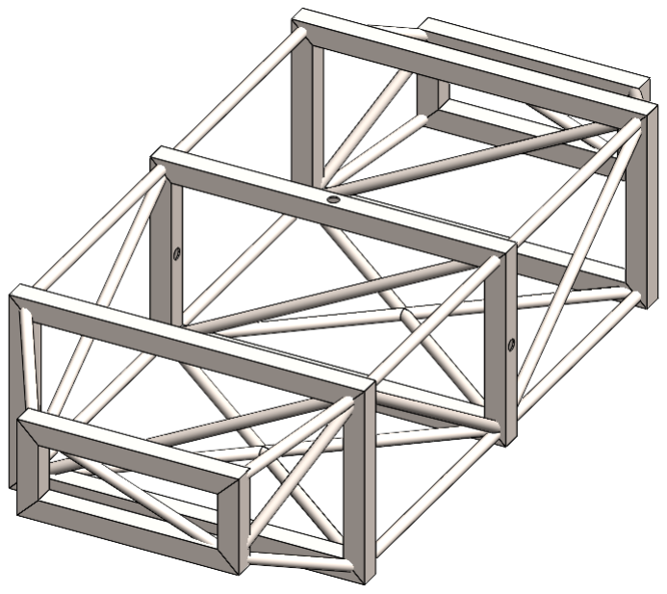
[picture p116: figure]

(αfl) Κιβώτιο κίνησης v1. | (βfl) Δικτύωμα σώματος v1.
| Σχήμα 2.18: Κιβώτιο κίνησης και σασί πλατφόρμας V.L.A.D. v1.

Όπως αναφέρθηκε, η ερπύστρια που θα χρησιμοποιηθεί θα αποτελείται από αρθρωτούς συνδέσμους και πέλματα αντί της ενιαίας χύτευσης. Συνολικά για τη γεωμετρία που προκύπτει για τη πλατφόρμα χρειάστηκαν 47 συναρμολογημένες διατάξεις συνδέσμου-πέλματος για τη κύρια ερπύστρια. Ενώ με μικρότερο πέλμα, χρειάστηκαν 29 σύνδεσμοι για τη δευτερεύουσα ερπύστρια του βραχίονα. Παρακάτω φαίνεται ο μεταλλικός αρθρωτός σύνδεσμος καθώς και η συναρμολόγηση με το πέλμα της ερπύστριας.

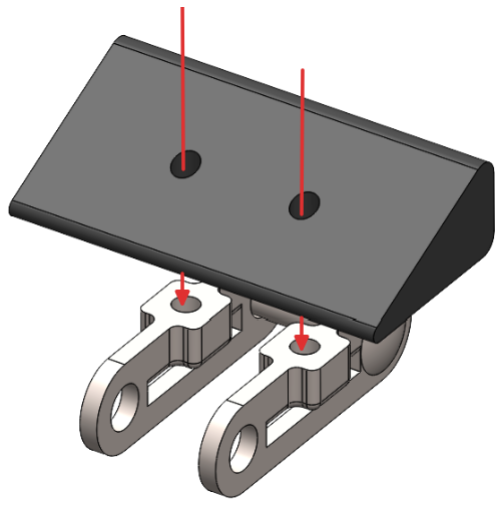
[picture p117: figure]

(αfl) Αρθρωτός σύνδεσμος αλυσίδας ερπύστριας. | (βfl) Συναρμολόγηση συνδέσμου-πέλματος ερπύστριας.

Σχήμα 2.19: Στοιχεία ερπύστριας v1.

Αφού λοιπόν σχεδιαστούν όλα τα τρισδιάστατα αρχεία των επιμέρους στοιχείων που αποτελούν τη πλατφόρμα, δημιουργείται και η ολική συναρμολογημένη διάταξη σε τρισδιάστατη μορφή. Περιορίζονται οι κατάλληλοι βαθμοί ελευθερίας με τη χρήση mates/joints, ενώ επιτρέπεται η περιστροφή των συνδέσμων της ερπύστριας αλλά και των βραχιόνων για καλύτερη οπτικοποίηση του μηχανισμού και των ανοχών του συστήματος. Η συναρμολογημένη φαίνεται παρακάτω.

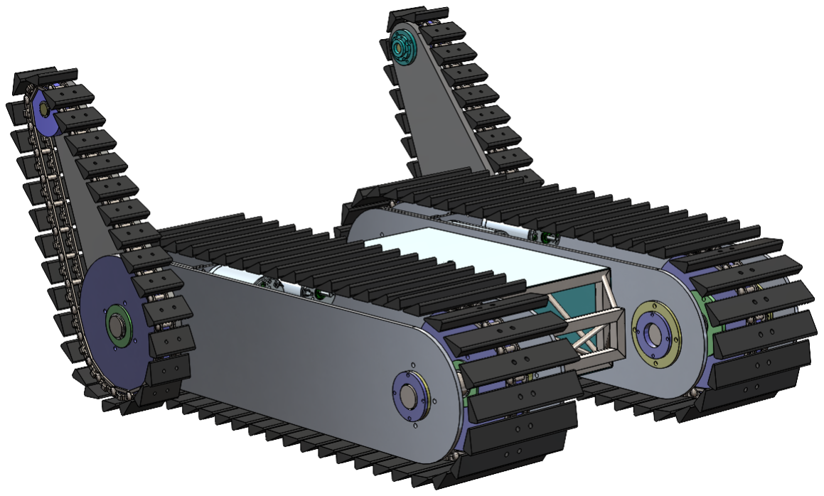
[picture p118: figure]
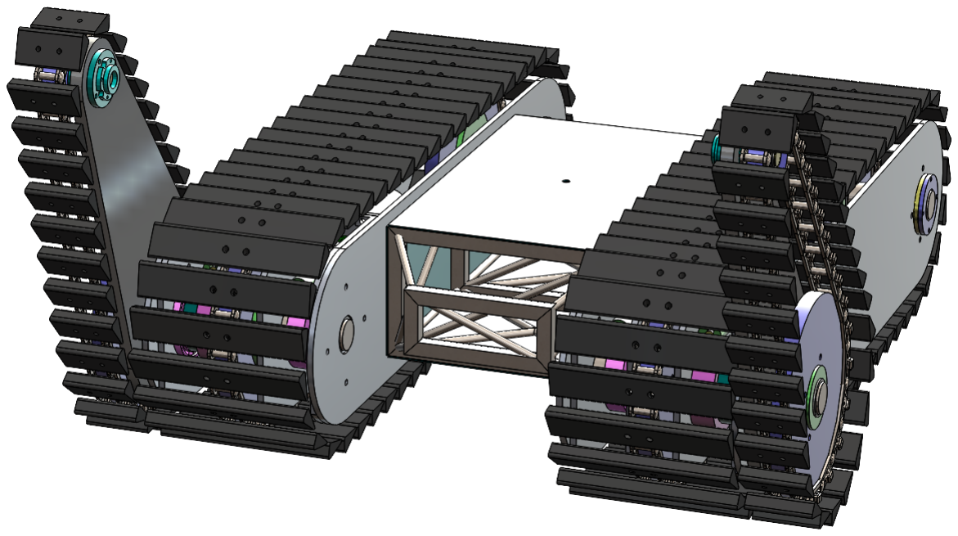
[picture p119: figure]
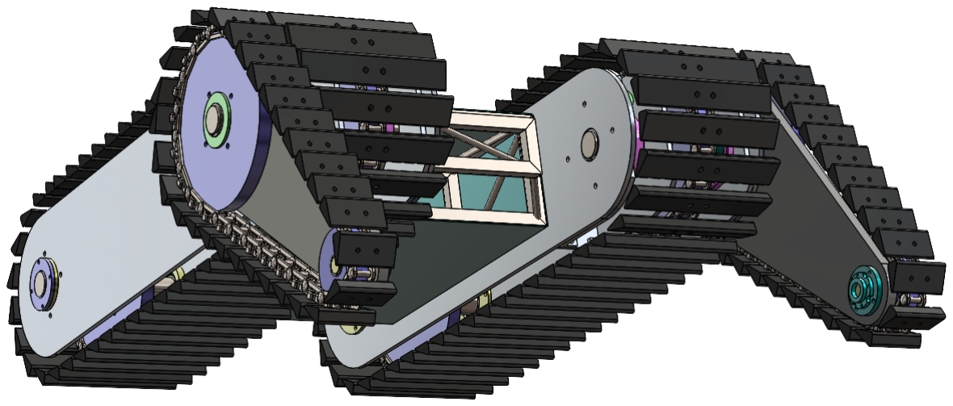
[picture p120: figure]

(αfl) Εμπρόσθια διμετρική όψη. | (βfl) Οπίσθια διμετρική όψη. | (γfl) Κάτω διμετρική όψη.

Σχήμα 2.20: Πρώτη εκδοχή της συναρμολογημένης πλατφόρμας V.L.A.D.

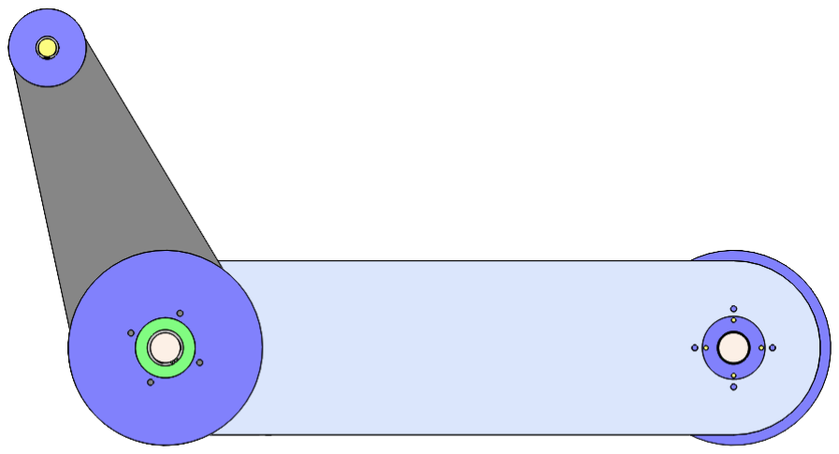
[picture p121: figure]

(αfl) Τριμετρική όψη. | (βfl) Πλάγια όψη.

Σχήμα 2.21: Πρώτη εκδοχή συναρμολογημένου διασώστη, δίχως τη παρουσία των ερπυστρίων.

Παρακάτω επίσης παρατηρούνται μερικές απεικονίσεις του V.L.A.D. κατά μερικά σενάρια λειτουργίας. Πιο συγκεκριμένα, οι αναδιπλωμένοι βραχίονες (retracted flippers) σε γωνία 0

- σε σχέση με τον άξονα κατά το μήκος του ρομπότ, βοηθούν στην εξοικονόμιση χώρου και τη μείωση του ενεργού μήκος της πλατφόρμας. Αυτό καθίσταται ιδιαίτερα χρήσιμο κατά τη διέλευση από στενά περάσματα. Έπειτα, οι ανασηκωμένοι βραχίονες κατά 90◦ ,
χρησιμοποιούνται κατά την καθοδική πορεία του διασώστη καθώς προσφέρουν τη μεγαλύτερη δυνατή τριβή λόγω της μικρότερης δυνατής επιφάνειας επαφής της δευτερεύουσας ερπύστριας με το έδαφος. Τέλος, οι εκτεταμένοι βραχίονες, ή αλλιώς οι βραχίονες σε γωνία 180◦
, προσφέρουν τη μέγιστη δυνατή τριβή αλλά και ενεργό επιφάνεια επαφής που τους καθιστά ιδιαίτερα χρήσιμους κατά την κίνηση σε κεκλιμένο επίπεδα και την αποφυγή ανατροπής της πλατφόρμας.

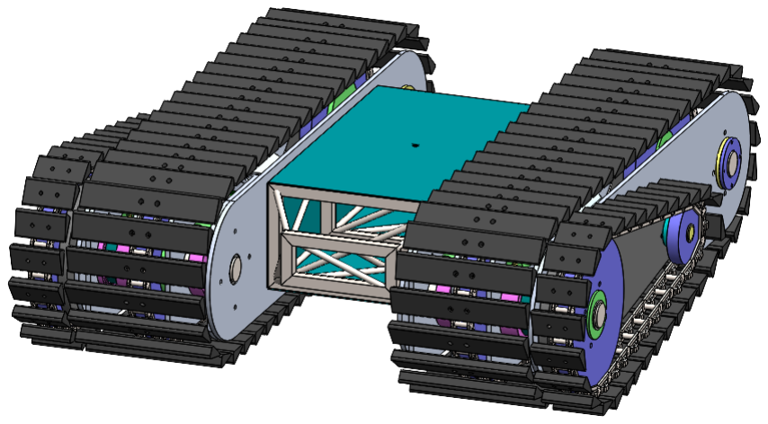
[picture p122: figure]

(αfl) Αναδιπλωμένοι βραχίονες για εξοικονόμηση χώρου.


(βfl) Ανασηκωμένοι βραχίονες σε γωνία 90◦ για κανονική πορεία σε ευθεία.

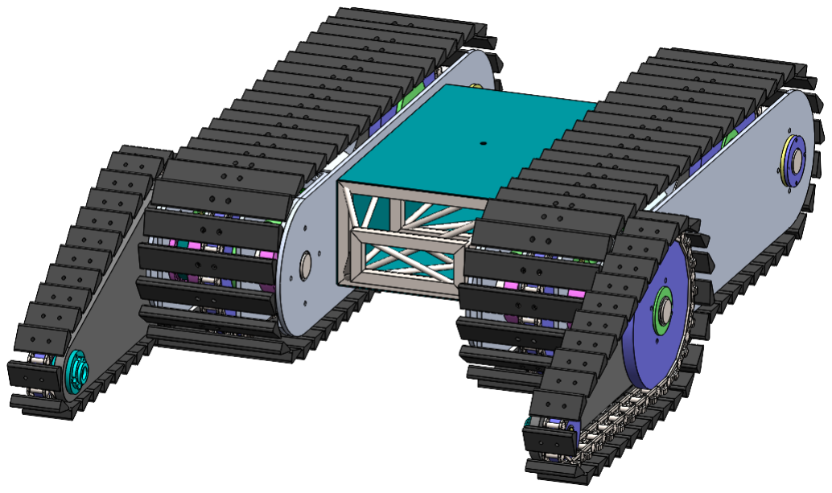
[picture p123: figure]

(γfl) Εκτεταμένοι βραχίονες για κίνηση σε κεκλιμένο.

Σχήμα 2.22: Σενάρια κίνησης πρώτης εκδοχής πλατφόρμας V.L.A.D.

Επιλογή υλικών και πρώτη εκδοχή ισοζύγιου μάζας

Όσο αναφορά τα υλικά των επιμέρους κομματιών του διασώστη. Αυτά επιλέγονται με γνώμονα τη μείωση του συνολικού βάρους της παλτφόρμας. Με βάση αυτό, για κάθε τεμάχιο, εκτός των πελμάτων και των αρθρωτών συνδέσμων της ερπύστριας και όλων των ατράκτων, επιλέγεται το αλουμίνιο ως υλικό κατασκευής. Πιο συγκεκριμένα επιλέγεται το υλικό 2024 T4, για τον υψηλό λόγο μέτρου ελαστικότητας προς πυκνότητα υλικού που διαθέτει, καθιστόντας το ιδανικό για τη μείωση του συνολικού βάρους της κατασκευής χωρίς να περιορίζεται η αντοχή της. Για τα υπόλοιπα μεταλλικά κομμάτια, δηλαδή για τις ατράκτους και τους συνδέσμους, επιλέγεται ο απλός κατασκευαστικός χάλυβας λόγω του μεγάλου μέτρου ελαστικότητας του υλικού και καθώς αυτό το υλικό συνηθίζεται για τη κατασκευή των συγκεκριμένων μηχανολογικών στοιχείων. Τέλος, τα πέλματα της ερπύστριας κατασκευάζονται από ελαστικό υλικό για την αποφυγή της ολίσθησης της πλατφόρμας κατά την εκκίνηση της περιστροφής των τροχών της ερπύστριας.
Ο υπολογισμός της μάζας του κάθε επιμέρους στοιχείου γίνεται μέσω του ίδιου λογισμικού σχεδίασης CAD (SOLIDWORKS) και του built-in εργαλείου του. Επίσης, στο ισοζύγιο πρέπει να συνυπολογιστούν και τα βάρη των:
- κινητήρων
- ηλεκτρονικών
- λοιπών μηχανολογικών στοιχείων
- payload

Το payload (φορτίο μεταφοράς), αναφέρεται στο φορτίο πρώτων βοηθειών που θα μεταφέρει ο διασώστης. Το φορτίο αυτό θα πρέπει να μη ξεπερνάει τα 5 kg σύμφωνα με τον Πίν. 2.1. Στο ισοζύγιο θα ληφθεί υπόψη η μέγιστη τιμή του payload, δηλαδή αυτή των πέντε κιλών. Αναφορικά με τα παρελκόμενα μηχανολογικά στοιχεία και τα υλικά σύνδεσης (κοχλίες, περικόχλια, ασφάλειες κ.ά.), διενεργήθηκε μια συντηρητική εκτίμηση της μάζας τους, ενσωματώνοντας σημαντικό περιθώριο ασφαλείας. Η προσέγγιση αυτή στοχεύει στην αύξηση του συνολικού υπολογιζόμενου βάρους στο ισοζύγιο μάζας, ώστε να διασφαλιστεί η εγκυρότητα της μελέτης βάσει της αρχής σχεδιασμού για το δυσμενέστερο σενάριο (worst-case scenario).
Όσον αφορά τον υπολογισμό της συνολικής μάζας των ηλεκτρονικών ελήφθησαν υπόψη οι τεχνικές προδιαγραφές αντίστοιχων εμπορικά διαθέσιμων αισθητήρων. Παράλληλα, για την ενεργειακή μονάδα του ρομπότ, διενεργήθηκε αναλυτική εκτίμηση βάρους. Θεωρώντας ότι η μπαταρία της πλατφόρμας συγκροτείται από συγκεκριμένο πλήθος στοιχείων λιθίου τύπου 18650, η συνολική μάζα υπολογίζεται αθροιστικά, λαμβάνοντας υπόψη την τυπική μάζα εκάστου στοιχείου. Η σχεδίαση της συστοιχίας περιλαμβάνει συνδεσμολογία σε σειρά για την επίτευξη της απαιτούμενης τάσης λειτουργίας, καθώς και παράλληλη σύνδεση για την αύξηση της χωρητικότητας και κατ' επέκταση της αυτονομίας του συστήματος. Θεωρώντας περίπου 40 τέτοια στοιχεία και με μάζα 50 g έκαστο, υπολογίζεται η συνολική μάζας της μπαταρίας στα 2 kg.
Τέλος, σχετικά με τους κινητήρες, επιλέγονται εμπορικά διαθέσιμοι κινητήρες συνεχούς ρεύματος. Οι κινητήρες αυτοί λειτουργούν ως place-holders, προσδίδουν δηλαδή την πιο ολοκληρωμένη γεωμετρική απεικόνιση του διασώστη χωρίς να έχει διερευνηθεί εάν μπορούν να υποστηρίξουν την πλατφόρμα με την απαραίτητη ροπή κίνησης. Αργότερα, αφού ολοκληρωθεί το ισοζύγιο μάζας θα υπολογισθούν πολύ πιο αναλυτικά οι απαιτήσεις των κινητήρων για το σύστημα.
Οι κινητήρες εδώ εφαρμόζουν στην πλάκα σύνδεσης των διαχωριστικών πλακών και πακτώνονται σε αυτήν μέσω των ιδίων εσωτερικών σπειρωμάτων που φέρουν στην εμπρόσθια επιφάνεια του κελύφους του κινητήρα. Ο κινητήρας έπειτα συνδέεται μέσω ενός εύκαμπτου συνδέσμου αξόνων, με τον ατέρμονα κοχλία. Ο σύνδεσμος αυτός, διαθέτει ελικοειδή χάραξη στο σώμα του που το βοηθάει να δρα ως ελατήριο, με αποτέλεσμα να απορροφάει κραδασμούς και να διορθώνει σφάλματα παράλληλων και γωνιακών αποκλίσεων. Οι απαραίτητες εδράσεις (μία μετά τον εύκαμπτο σύνδεσμο και μία μετά τον ατέρμονα) δε θα σχεδιασθούν για αυτό το πρώτο στάδιο του ισοζυγίου αλλά θα αναλυθούν μετέπειτα.


Σχήμα 2.23: Συνδεσμολογία κινητήρα και ατέρμονα κοχλία.

Παρακάτω στο Σχ. 2.26 φαίνεται η τομή της συναρμολογημένης διάταξης του κύριου συστήματος κίνησης και του δευτερεύων συστήματος κίνησης. Σχετικά με το δευτερεύων σύστημα κίνησης, αυτό πρέπει να φέρει άτρακτο με ελεύθερη περιστροφή η οποία στηρίζει και τον δευτερεύων τροχό της εξωτερικής ερπύστριας του βραχίονα. Εδώ, οι ασφάλειες είναι πρόχειρα τοποθετημένες για την εξακρίβωση της γεωμετρίας του συστήματος.


Σχήμα 2.24: Δευτερεύων σύστημα κίνησης πλατφόρμας.

Η διάμετρος της δευτερεύουσας ατράκτου εκλέγεται 10 mm και με βάση αυτήν επιλέγονται τα έδρανα κύλισης 61800 με διαστάσεις 10x19x5 mm. Σχεδιάεται και πλήμνη για την έδραση της ατράκτου στον βραχίονα ενώ ο τρόπος μεταφοράς ροπής από την δευτερεύουσα άτρακτο στον τροχό κρίνεται δίχως ενδιαφέρον για το συγκεκριμένο στάδιο του σχεδιασμού και θα αναλυθεί εκτενέστερα παρακάτω.
Τέλος, διακρίνονται και εξαρτήματα της οπίσθιας σύνδεσης, όπου η άτρακτος εδράζεται στο σώμα του κιβωτίου κίνησης και περιστρέφεται μέσω του οπίσθιου τροχού της κύριας ερπύστριας.

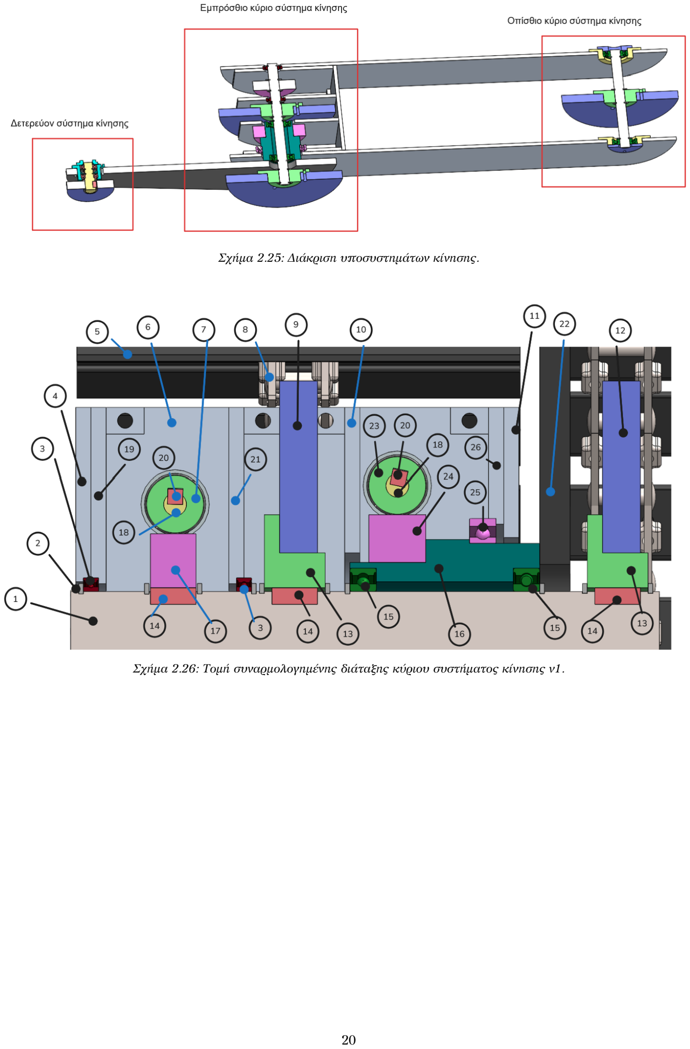
[picture p124: page 24]

Σχήμα 2.25: Διάκριση υποσυστημάτων κίνησης.

Σχήμα 2.26: Τομή συναρμολογημένης διάταξης κύριου συστήματος κίνησης v1.

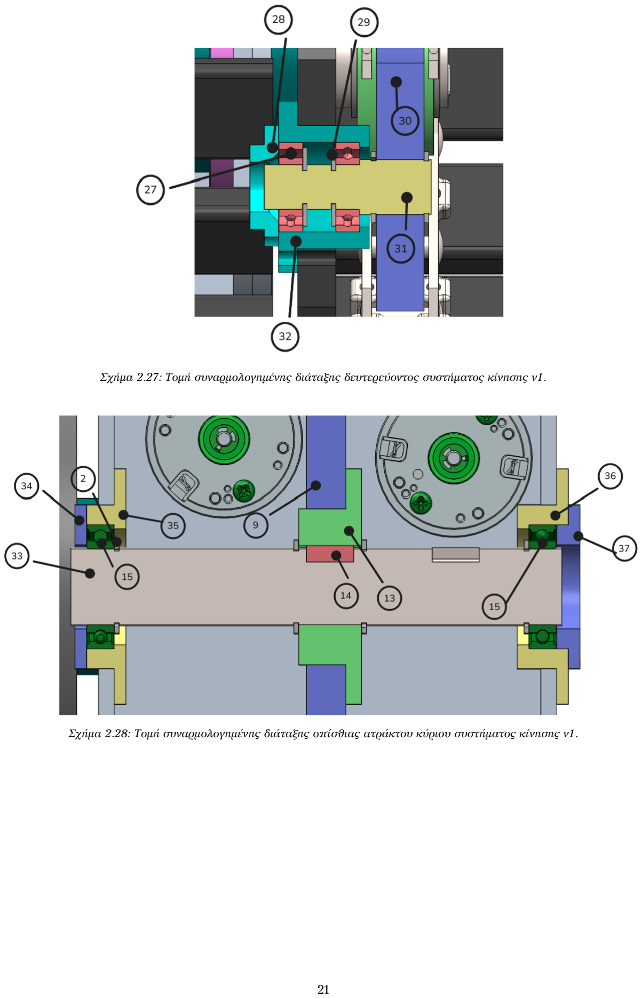
[picture p125: page 25]

Σχήμα 2.27: Τομή συναρμολογημένης διάταξης δευτερεύοντος συστήματος κίνησης v1.

Σχήμα 2.28: Τομή συναρμολογημένης διάταξης οπίσθιας ατράκτου κύριου συστήματος κίνησης v1.

Part ID | Description
MOB-01 | Κύρια άτρακτος
MOB-02 | Ασφάλεια ατράκτου
MOB-03 | SKF w61704
MOB-04 | Εσωτερικό καπάκι κιβωτίου κίνησης
MOB-05 | Πέλμα κύριας ερπύστριας
MOB-06 | Πλάκα ένωσης διαχωριστικών
MOB-07 | Ατέρμονας κύριας ερπύστριας
MOB-08 | Αρθρωτός σύνδεσμος ερπύστριας
MOB-09 | Τροχός κύριας ερπύστριας
MOB-10 | Διαχωριστική πλάκα
MOB-11 | Εξωτερικό καπάκι κιβωτίου κίνησης
MOB-12 | Κινητήριος τροχός δευτερεύουσας ερπύστριας (ίδιος με κύριας)
MOB-13 | Φλάντζα τροχού ερπύστριας
MOB-14 | Πολύσφηνο κύριας ατράκτου
MOB-15 | SKF 61804
MOB-16 | Άτρακτος περιστρεφόμενου βραχίονα
MOB-17 | Οδοντωτός τροχός κύριας ατράκτου
MOB-18 | Άξονας ατέρμονα κοχλία
MOB-19 | Πλάκα στήριξης εδράνου 1
MOB-20 | Πολύσφηνο ατράκτου ατέρμονα
MOB-21 | Πλάκα στήριξης εδράνου 2
MOB-22 | Περιστρεφόμενος βραχίονας
MOB-23 | Ατέρμονας δευτερεύουσας ερπυστρίας
MOB-24 | Οδοντωτός τροχός ατράκτου βραχίονα
MOB-25 | SKF 61809
MOB-26 | Πλάκα στήριξης εδράνου 3
MOB-27 | SKF 61800
MOB-28 | Καπάκι πλήμνης βραχίονα
MOB-29 | Ασφάλεια ατράκτου
MOB-30 | Τροχός δευτερέυουσας ερπύστριας
MOB-31 | Δευτερεύουσα άτρακτος
MOB-32 | Πλήμνη στήριξης βραχίονα
MOB-33 | Οπίσθια κύρια άτρακτος
MOB-34 | Καπάκι πλήμνης κιβωτίου 1
MOB-35 | Πλήμνη στήριξης κιβωτίου κίνησης 1
MOB-36 | Πλήμνη στήριξης κιβωτίου κίνησης 2
MOB-37 | Καπάκι πλήμνης κιβωτίου 2

Πίνακας 2.4: Λίστα εξαρτημάτων συστήματος κίνησης.

Από τις παραπάνω τομές διακρίνονται όλα τα επιμέρους στοιχεία του μηχανισμού του συστήματος κίνησης. Παρακάτω, στον Πίν. 2.5 φαίνεται η πρώτη επανάληψη του ισοζυγίου μάζας με όλα τα εξαρτήματα συγκεντρωμένα. Στα λοιπά μηχανολογικά στοιχεία έχουν συμπεριληφθεί κοχλίες, περικόχλια, οι έυκαμπτοι σύνδεσμοι, ασφάλειες και γενικότερα, οποιδήποτε εξάρτημα δεν αναγράφεται ως διακριτή οντότητα στον πίνακα. Τα λοιπά ηλεκτρονικά, αναφέρονται στα καλώδια, connectors κ.λ.π. ενώ τα λοιπά εξαρτήματα στο σώμα αναφέρονται πάλι σε μηχανολογικά στοιχεία όπως εξαρτήματα σύνδεσης. Έχουν καταγραφεί μόνο οι αισθητήρες που έχουν σημαντική μάζα στοιχείου ενώ οι υπόλοιποι εξ αυτών έχουν ομαδοποιηθεί μέσω των λοιπών αισθητήρων. Τέλος, να σημειωθεί πως στο συγκεκριμένο στάδιο, ο ατέρμονας είναι κοινός στο σχεδιασμό και για τις δύο οδοντοκινήσεις.

Part | Material | Qty | Unit Mass (g) | Total Mass (g)
| Mobility Subsystem
Καπάκι πλήμνης κιβωτίου 1 | 2024 T4 | 2 | 8.15 | 16.3
Καπάκι πλήμνης κιβωτίου 2 | 2024 T4 | 2 | 11.63 | 23.26
Πλήμνη στήριξης κιβωτίου κίνησης 1 | 2024 T4 | 2 | 32.95 | 65.9
Πλήμνη στήριξης κιβωτίου κίνησης 2 | 2024 T4 | 2 | 28.18 | 56.36
Αρθρωτός σύνδεσμος ερπύστριας | Steel | 152 | 12.25 | 1862
Πέλμα κύριας ερπύστριας | Rubber Natural | 94 | 16.64 | 1564.16
Πέλμα δευτερεύουσας ερπυστρίας | Rubber Natural | 58 | 6.09 | 353.22
Περιστρεφόμενος βραχίονας | 2024 T4 | 2 | 526.09 | 1052.18
Άτρακτος περιστρεφόμενου βραχίονα | 2024 T4 | 2 | 109.54 | 219.08
Πλάκα στήριξης εδράνου 1 | 2024 T4 | 2 | 130.42 | 260.84
Πλάκα στήριξης εδράνου 2 | 2024 T4 | 2 | 131.62 | 263.24
Πλάκα στήριξης εδράνου 3 | 2024 T4 | 2 | 108.22 | 216.44
Διαχωριστική πλάκα | 2024 T4 | 2 | 122.7 | 245.4
Πλάκα ένωσης διαχωριστικών | 2024 T4 | 2 | 133.23 | 266.46
Πλήμνη στήριξης βραχίονα | 2024 T4 | 2 | 18.2 | 36.4
Δευτερεύουσα άτρατκος | Steel | 2 | 23.82 | 47.64
Καπάκι πλήμνης βραχίονα | 2024 T4 | 2 | 4.33 | 8.66
Τροχός δευτερεύουσας ερπύστριας | 2024 T4 | 2 | 55.7 | 111.4
Τροχός κύριας ερπύστριας | 2024 T4 | 6 | 332.66 | 1995.96
Φλάντζα τροχού ερπυστρίας | 2024 T4 | 6 | 58.68 | 352.08
Κύρια άτρακτος | Steel | 2 | 386.41 | 736.82
Οπίσθια κύρια άτρακτος | Steel | 2 | 298.84 | 597.86
Εσωτερικό καπάκι κιβωτίου κίνησης | 2024 T4 | 2 | 585.25 | 1170.5
Εξωτερικό καπάκι κιβωτίου κίνησης | 2024 T4 | 2 | 571.04 | 1142.08
Ατέρμονας κοχλίας (κοινός) | 2024 T4 | 4 | 11.89 | 47.56
Άξονας ατέρμονα | 2024 T4 | 4 | 12.04 | 48.16
Οδοντωτός τροχός κύριας ατράκτου | 2024 T4 | 2 | 54.91 | 109.82
Οδοντωτός τροχός ατράκτου βραχίονα | 2024 T4 | 2 | 76.6 | 153.2
Λοιπά μηχανολογικά στοιχεία | Var. | 1 | 3000.0 | 3000.0
Body Subsystem
Δικτύωμα σώματος | Steel | 1 | 526.98 | 526.98
Καπάκια σασί σώματος | 1060 Al | 1 | 335.36 | 335.36
Payload | Var. | 1 | 5000.0 | 5000.0
Λοιπά στοιχεία | Var. | 1 | 1000.0 | 1000.0
Electronics Hardware
LiDAR Unit | - | 1 | 200.0 | 200.0
Thermal Camera | - | 1 | 200.0 | 200.0
Λοιποί αισθητήρες | - | 1 | 50.0 | 50.0
Μπαταρία | - | 1 | 2000.0 | 2000.0
Κινητήρες ερπύστριας | - | 2 | 480.0 | 960.0
Κινητήρες βραχίονα | - | 2 | 480.0 | 960.0
Λοιπά ηλεκτρονικά | - | 1 | 10.0 | 10.0
Grand Total Mass | | | | 27.36 kg

Πίνακας 2.5: Ισοζύγιο μάζας v1.

### 2.3.2 Αναθεώρηση διαστάσεων ρομποτικού διασώστη

Μετά την πρώτη επανάληψη του ισοζυγίου μάζας, θα πρέπει να πραγματοποιηθούν βελτιώσεις στο V.L.A.D. με κύριο σκοπό τη μείωση του βάρους του διασώστη. Μια βασική αλλαγή για την επίτευξη του σκοπού αυτού θα είναι ο επανασχεδιασμός των βασικών διαστάσεων του διασώστη. Κυρίως όσον αναφορά, το μήκος, πλάτος και ύψος της πλατφόρμας.

Κατά την πρώτη επανάληψη, η μάζα του V.L.A.D. είναι 27.36 kg και φαίνεται στον Πίν. 2.5. Αντίστοιχα, το μήκος της πλατφόρμας, μετρημένο από το κέντρο του εμπρόσθιου τροχού της κύριας ερπύστριας έως το κέντρο του οπίσθιου τροχού της ερπύστριας, προκύπτει 380 mm. Επίσης, το μήκος του βραχίονα, από το κέντρο του μεγάλου τροχού της δευτερεύουσας ερπύστριας έως το κέντρο του μικρού, είναι 215 mm. Οι συγκεκριμένες τιμές, βρίσκονται εντός των αρχικά εκλεγμένων οριών του Πίν. 2.1. Ωστόσο, με βάση δύο απλούς πυλώνες, θα βελτιστοποιηθούν τα συγκεκριμένα μεγέθη.
Ο πρώτος πυλώνας αφορά την ικανότητα του διασώστη να προσαρμόζεται σε δύσβατα εδάφη. Κρίνεται γενικότερα σκόπιμο σε τέτοιες αποστολές διάσωσης, οι ρομποτικοί διασώστες να έχουν την δυνατότητα υπερπήδησης εμποδίων και υψομετρικών διαφορών, αντίστοιχα με την ικανότητα των ανθρώπων να ανέρχονται σκαλοπάτια. Η διαδικασία λειτουργίας που ακολουθεί η πλατφόρμα V.L.A.D. για την υπερπήδηση ενός σκαλοπατιού, βασίζεται στη χρήση του περιστρεφόμενου βραχίονα του, όπως φαίνεται και στο Σχ. 2.29. Με βάση λοιπόν τα παραπάνω, κρίνεται ότι η ιδανική διάσταση για το μήκος του βραχίονα πρέπει να είναι μεγαλύερο από ένα συμβατικό σκαλοπάτι. Το ύψος ενός σκαλοπατιού εκτιμάται στα 180 mm. Έτσι, το μήκος του βραχίονα μπορεί να μειωθεί στα 200 mm, με αποτελέσμα και τη μείωση της μάζας του.

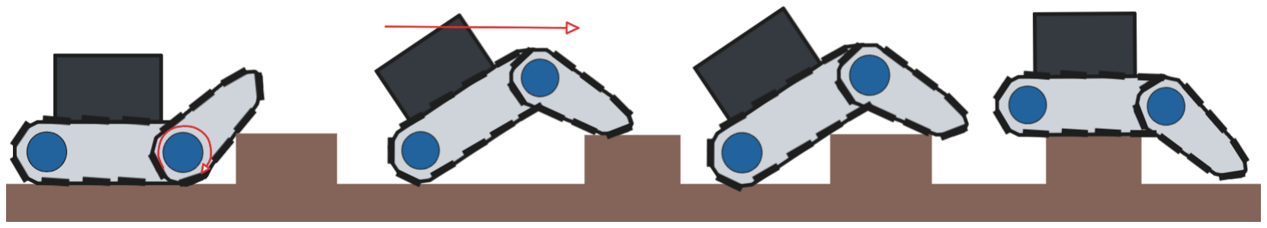
[picture p126: figure]

Σχήμα 2.29: Αλληλουχία κινήσεων πλατφόρμας V.L.A.D. κατά την υπερπήδηση σκαλοπατιού.

Ο δεύτερος πυλώνας αφορά την κινηματική σταθερότητα της πλατφόρμας και την αποφυγή της ανατροπής της. Το συνολικό μήκος της πλατφόρμας σε σύγκριση με το σημείο του κέντρου βάρους της, επηρεάζουν άμεσα την ανατροπή του διασώστη κατά την ανάβαση σε κεκλιμένα επίπεδα. Από τη πρώτη εκδοχή της συναρμολογήμενης διάταξης σε CAD του V.L.A.D. μπορεί να ληφθεί το σημείο του κέντρου βάρους του.

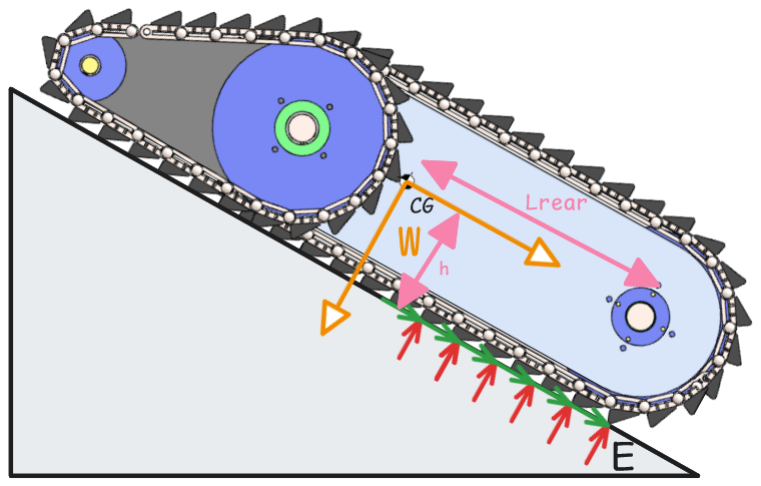
[picture p127: figure]

Σχήμα 2.30: Στατική ανάλυση κατά την πορεία σε κεκλιμένο επίπεδο της πλατφόρμας V.L.A.D.

Όπως παρατηρείται στο Σχ. 2.30, κατά την ανατροπή του διασώστη, η κάθετη αντίδραση του εδάφους μηδενίζεται σε κάθε σημείο επαφής της ερπύστριας με το έδαφος, εκτός από το σημείο E, γύρω από το οποίο περιστρέφεται και ο διασώστης κατά τη πορεία σε κεκλιμένο με γωνία θ. Λίγο πριν την ανατροπή η συνισταμένη ροπών ως προς το E είναι μηδενική:
ΣME = 0 | (2.1)

Στη συνισταμένη επιδρά μόνο το βάρος του διασώστη, το οποίο ασκείται στο κέντρο βάρος της πλατφόρμας που απέχει ℎ από το σημείο επαφής με το κεκλιμένο και Lrear από το E. Αναλύοντας τις συνιστώσες του βάρους προκύπτει:

w · ℎ · sinθ − w · Lrear · cosθ = 0 | (2.2)

Αναδιατυπώνοντας την παραπάνω εξίσωση προκύπτει η μέγιστη τιμή της γωνίας του κεκλιμένου επιπέδου για την αποφυγή της ανατροπής της πλατφόρμας:

θ = arctan(

Lrear
ℎ

)

(2.3)

Παρατηρείται ότι, όσο αυξάνεται η απόσταση του κέντρου βάρους της πλατφόρμας από το σημείο ανατροπής τόσο αυξάνεται και η επιτρεπτή γωνία κεκλιμένου. Για αυτόν τον λόγο, κατά την ανάβαση κεκλιμένου εδάφους, ο βραχιόνας οριζοντιοποιείται με το επίπεδο μετακινώντας το κέντρο βάρους πιο μακριά από το σημείο ανατροπής. Θεωρώντας λοιπόν μια αρκούντως ικανοποιητική γωνία κεκλιμένου θ = 50◦
, οι διαστάσεις Lrear, ℎ μπορούν να ξανά οριστούν και πιο συγκεκριμένα να μειωθεί το μήκος της πλατφόρμας σε σημείο που η οριακή γωνία κεκλιμένου είναι η ζητούμενη. Έτσι, μειώνεται το μήκος της πλατφόρμας στα 280 mm.

### 2.3.3 Μείωση μάζας

Έχοντας πλέον μειώσει τις διαστάσεις του V.L.A.D., σειρά έχουν πιο δραστικές αλλαγές για τη μείωση της μάζας του. Όλες οι τεχνικές μείωσης μάζας που χρησιμοποιήθηκαν κατά τη δεύτερη εκδοχή του ισοζυγίου μάζας θα αναλυθούν παρακάτω.
Η πιο βασική τεχνική μείωσης της μάζας, είναι η επιλογή ελαφρύτερων υλικών με παρόμοια στιβαρότητα. Καθώς το αλουμίνιο αποτελεί ένα ελαφρύ σε σύγκριση με το χάλυβα υλικό, για αρχή επιλέγεται ξανά το υλικό των ατράκτων να είναι αλουμίνιο. Με αυτόν τον τρόπο εξοικονομείται πολύ μάζα στα βαριά κομμάτια του συστήματος κίνησης (ατράκτοι). Επίσης, επιλέγονται τα κομμάτια του σώματος, τα οποία θα επανασχεδιαστούν αργότερα, αλλά και τα εξωτερικά καπάκια του κιβωτίου κίνησης να κατασκευαστούν από σύνθετο υλικό ινών άνθρακα (carbon fiber). Πιο συγκεκριμένα επιλέγεται ο τύπος Zoltek Panex 33 λόγω της βελτιωμένης αντοχής του. Τέλος, οι αρθωτοί σύνδεσμοι της ερπύστριας κρίνεται ότι θα κατασκευαστούν επίσης από αλουμίνιο. Καθώς μειώθηκε το μήκος της πλατφόρμας, μειώνονται και οι σύνδεσμοι της ερπύστριας, με αποτέλεσμα να μείωνεται ακόμη περισσότερο η μάζα. Παρατηρώντας ξανά τον Πίν. 2.5, φαίνεται ότι οι ατράκτοι προσδίδουν πολύ βάρος στη κατασκευή. Επομένως, κρίνεται αναγκαίο να μειωθεί κάπως η μάζα τους. Με τη μετατροπή των κυλίνδρικών ατράκτων σε κύλινδρο με αξονική οπή κατά όλο το μήκος τους, μειώνεται σημαντικά η μάζας της κάθε ατράκτου. Επιλέγεται κοίλη διατομή εσωτερικής διαμέτρου 5 mm. Η συγκεκριμένη γεωμετρία βελτιστοποιεί τον λόγο αντοχής προς βάρος, καθώς επιτυγχάνει τη μείωση της μάζας χωρίς να διακυβεύεται η μηχανική αντοχή και η δυσκαμψία του εξαρτήματος. Παράλληλα, στο πλαίσιο της βελτιστοποίησης του βάρους, εξετάστηκε η δυνατότητα μείωσης των δομικών στοιχείων. Καθώς η απλή αφαίρεση εξαρτημάτων θα διακύβευε τη λειτουργικότητα του μηχανισμού, προκρίθηκε η στρατηγική της ενοποίησης εξαρτημάτων. Συγκεκριμένα, η συναρμογή άτρακτος-πολύσφηνο-φλάντζας-τροχού αντικαταστάθηκε από απλούστερο σχεδιασμό. Στη νέα διάταξη, η φλάντζα του τροχού της ερπύστριας κατασκευάζεται ως ενιαίο τμήμα της κύριας ατράκτου, καταργώντας την ανάγκη για ξεχωριστά εξαρτήματα προσαρμογής και συνδέσμους, μειώνοντας έτσι τόσο τη μάζα όσο και την πολυπλοκότητα συναρμολόγησης. Αντίστοιχα, και ο οδοντωτός τροχός της κύριας ερπύστριας κατεργάζεται και αυτός απευθείας πάνω στην άτρακτο.

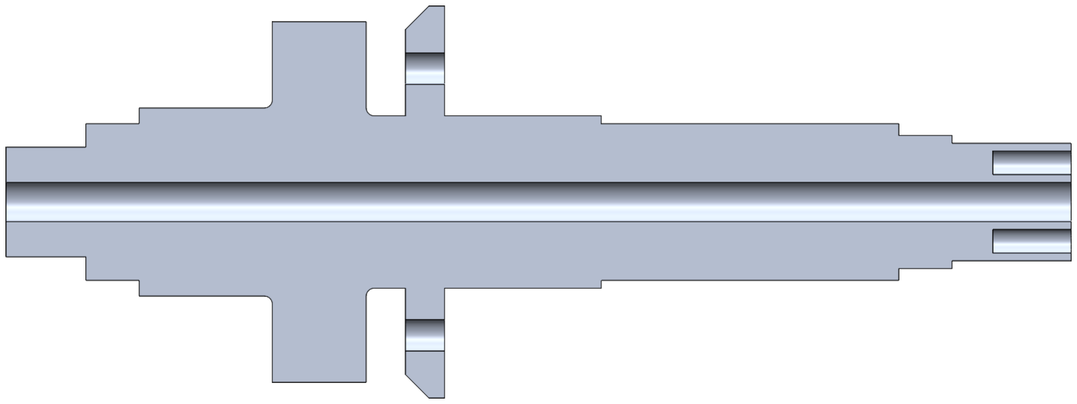
[picture p128: figure]

(αfl) Πρώτη εκδοχή. | (βfl) Δεύτερη εκδοχή.

Σχήμα 2.31: Τομή κύριας ατράκτου κατά την πρώτη και δεύτερη επανάληψη του ισοζυγίου μάζας.

Συνεχίζοντας, οι τροχοί των ερπυστριών μεταξύ της πρώτης και της δεύτερης εκδοχής σημειώνουν αλλαγές με σκοπό τη μείωση της επιμέρους μάζας τους. Αφαιρείται υλικό κατά την ακτινική διεύθυνση των τροχών με αποτέλεσμα να δημιουργείται νεύρο στην εσωτερική του κάθε τροχού που ενώνει την εξωτερική και την εσωτερική ακτίνα του. Αυτό συμβαίνει τόσο για τον κύριο τροχό όσο και για τον τροχό του δευτερεύοντος συστήματος κίνησης.

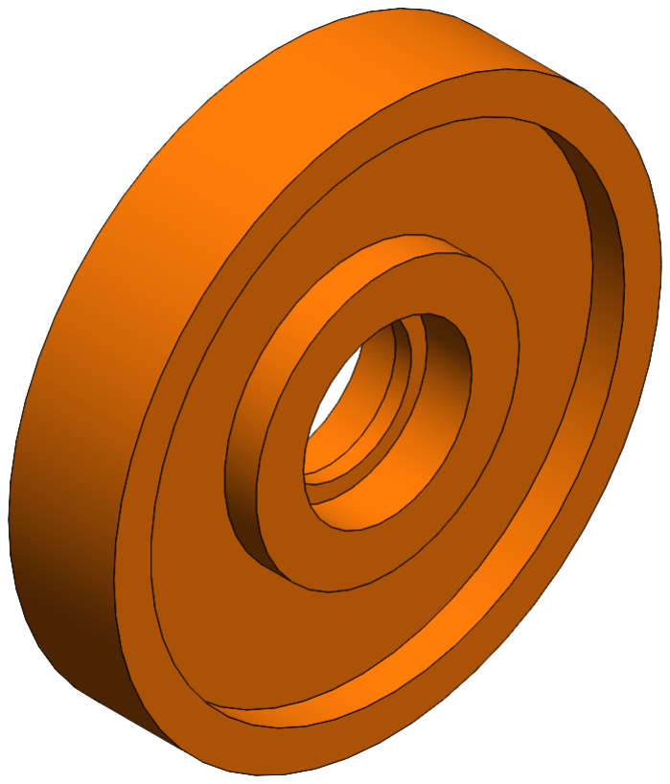
[picture p129: figure]
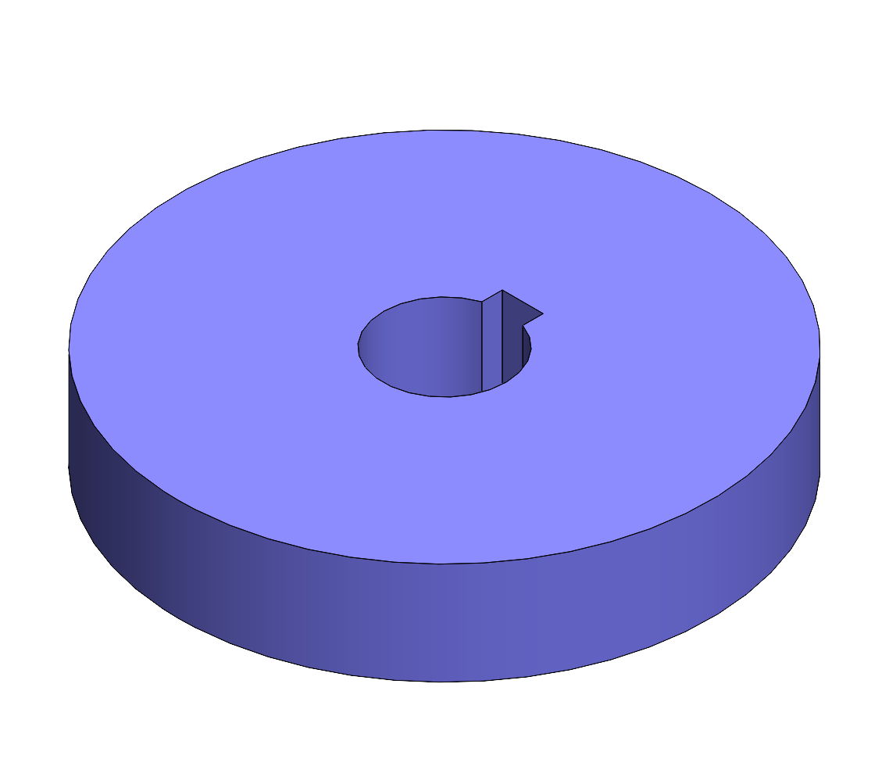
[picture p130: figure]

(αfl) Πρώτη εκδοχή. | (βfl) Δεύτερη εκδοχή.

Σχήμα 2.32: Δευτερεύον οδοντωτός τροχός κίνησης κατά την πρώτη και δεύτερη επανάληψη του ισοζυγίου μάζας.

Σχετικά με τα κομμάτια του κιβωτίου κίνησης, αυτά επίσης προσδίδουν μεγάλο βάρος στην κατασκευή. Επιλέγεται λοιπόν η μείωση του πάχους των εσωτερικών και εξωτερικών καπακιών του κιβωτίου καθώς και η αφαίρεση των διαχωριστικών. Τα διαχωριστικά θα αντικατασταθούν από σταθεροποιητές για την έδραση των ζευγών των γραναζοκινήσεων ατέρμονα-τροχού, ενώ τα εξωτερικά καπάκια θα σχεδιασθούν πιο στιβαρά στα σημεία σταθεροποίησης των εδράνων κύλισης.
Τέλος, όπως έχει ήδη αναφερθεί, η επιλογή του σχεδιασμού δικτυώματος για το σώμα του V.L.A.D. αποτελεί μία παρωχημένη πλέον λύση. Όπως μπορεί κανείς να παρατηρήσεις από τον Πίν. 2.5, το δικτύωμα και τα καπάκια του συνεισφέρουν σημαντικά στην αύξηση του βάρους της κατασκευής. Εφόσον η τεχνολογία των σύνθετων υλικών εξυπηρέτησε και σε προηγούμενο σημείο τη μείωση της μάζας, προσφέροντας εξαιρετική αντοχή και ποιότητα έναντι κόστους, κρίνεται σκόπιμο, τόσο και για τη προσφορά περαιτέρω ελευθερίας κατά τον σχεδιασμό, να χρησιμοποιηθούν σύνθετα υλικά για το σώμα της πλατφόρμας. Επίσης, για την αύξηση της στιβαρότητας του συνολικού συστήματος στα σημεία ένωσης των δύο συμμετρικών κιβωτίων κίνησης του V.L.A.D., επιλέγεται η συγχώνευση του εσωτερικού καπακιού του κιβωτίου κίνησης με το σώμα της πλατφόρμας. Με αυτόν τον τρόπο, καταπολεμάται η στρέψη των κιβωτίων κίνησης αντίθετα μεταξύ τους (Σχ. 2.33) κατά την λειτουργία του διασώστη, μια καταπόνηση ιδίως σοβαρή λόγω και της έλλειψης ανάρτησης στο όχημα.

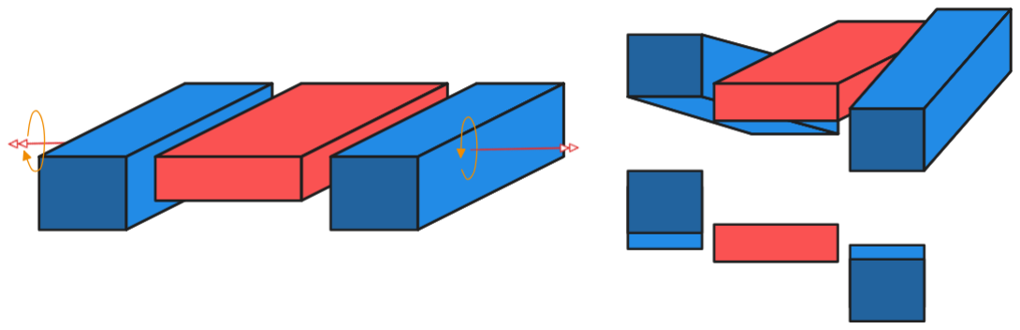
[picture p131: figure]

Σχήμα 2.33: Στρέψη κιβωτίων κίνησης ως προς το σώμα της πλατφόρμας.

Παρακάτω, στο 2.34βfi παρατηρείται η καινούργια βελτιωμένη εκδοχή το σώματος της πλατφόρμας. Παραπάνω σχετικά με τις σχεδιαστικές αλλαγές του θα ανλυθούν στα παρακάτω κεφάλαια. Είναι εμφανές ότι τα εσωτερικά καπάκια του κιβωτίου, είναι πλέον αναπόσπαστο κομμάτι το σώματος του V.L.A.D. Το υλικό που επιλέγεται για τη κατασκευή αυτή είναι πάλι σύνθετο ανθρακόνημα Zoltek Panex 33, είτε με τη χρήση τρισδιάτατης εκτύπωσης, χρησιμοποιώντας το υλικό ως ενίσχυση σε συμβατικά πλαστικά εκτύπωσης, είτε με τη χρήση χύτευσης καλουπιού, τη σύνηθη μέθοδο παραγωγής εξαρτημάτων από ίνες άνθρακα. Για το σημείο αυτό, επιλέγεται η χρήση της απλής χύτευσης καθώς απλοποιεί τη διαδικασία υπολογισμού της μάζας του σώματος.

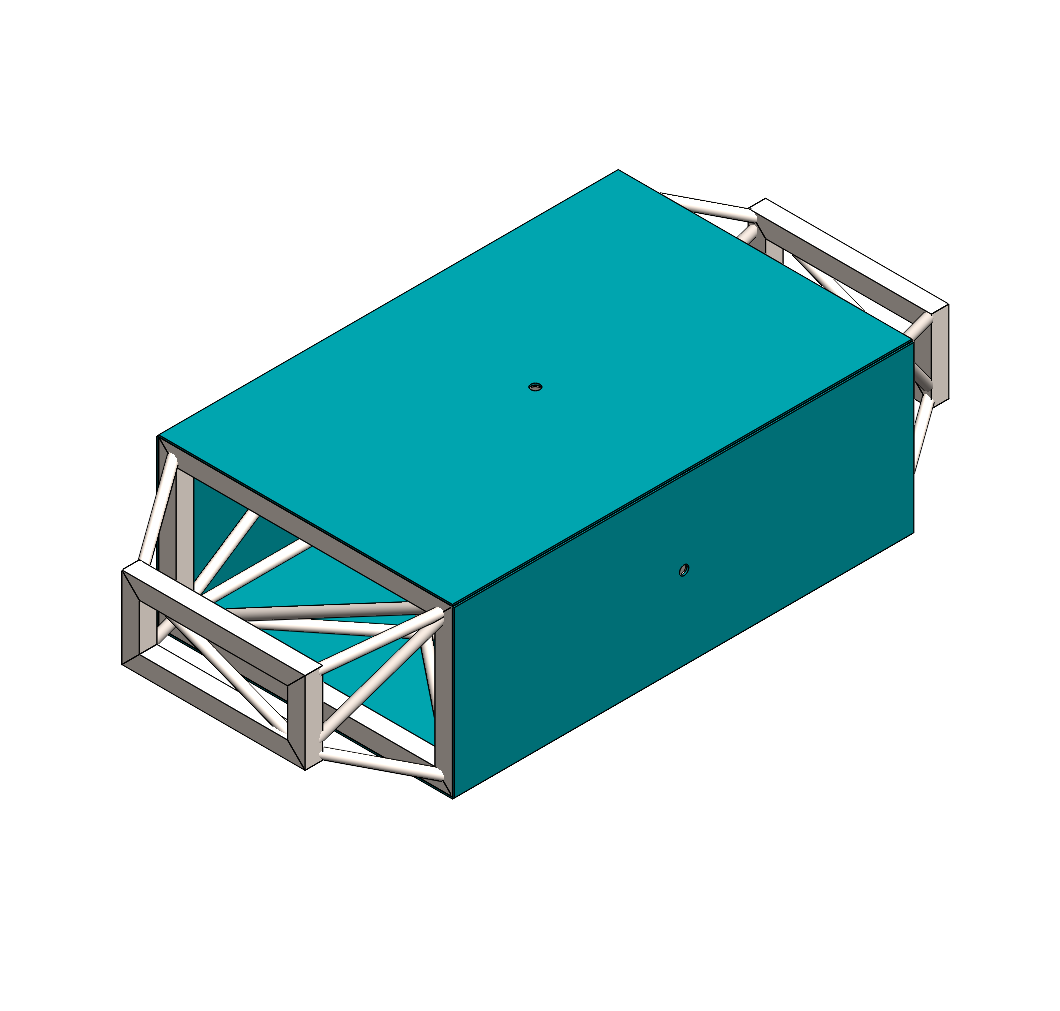
[picture p132: figure]

(αfl) Πρώτη εκδοχή. | (βfl) Δεύτερη εκδοχή.

Σχήμα 2.34: Διάταξη σώματος πλατφόρμας κατά την πρώτη και δεύτερη επανάληψη του ισοζυγίου μάζας.

### 2.3.4 Στρατηγική τοποθέτησης αισθητήρων και αλγοριθμική διαχείριση τους

Μετά την επιλογή των αισθητήρων και τον καθορισμού της χρήσης και λειτουργίας τους στα προηγούμενα κεφάλαια, θα πρέπει να δωθεί βάση και στη χωροταξική τοποθέτηση των αισθητήρων στην πλατφόρμα του V.L.A.D. με σκοπό την πιο αξιόπιστη και αποδοτική λειτουργία των ηλεκτρονικών και των αλγορίθμων διαχείρισης των δεδομένων των αισθητήρων. Με μια ανακεφαλαίωση, οι αισθητήρες που θα χρησιμοποιηθούν είναι οι εξής:

- Θερμική κάμερα
- Μικρόφωνο
- Επιταχυνσιόμετρο
- LiDAR
- IMU
- Αισθητήρας διοξειδίου του άνθρακα

Ξεκινώντας με την κάμερα, κρίνεται ότι μια κάμερα είναι αρκετή για να πληρεί τις λειτουργίες-στόχους του διασώστη. Η κάμερα θα πρέπει να βρίσκεται σε υψηλό σημείο στην πλατφόρμα με σκοπό να μην επηρεάζεται το οπτικό της πεδίο από τα μέρη του ίδιου του διασώστη που αποτελούν σημαντικές πηγές θερμότητας, όπως οι κινητήρες και η μονάδα ενέργειας (μπαταρία). Η κάμερα θα πρέπει να διαθέτει αρκούντως μεγάλο οπτικό πεδίο ώστε να περιοριστεί η ανάγκη για σχεδιασμό συστήματος που της προσφέρει πολλούς βαθμούς ελευθερίας κινήσεων. Σύμφωνα και με την επιλογή του αισθητήρα LiDAR παρακάτω, κρίνεται ότι ένας περιστροφικός βραχίονας προσδίδει στην κάμερα ικανοποιητικό οπτικό πεδίο, δηλαδή 360◦
, εφόσον αυτή κατέχει μεγάλο οπτικό πεδίο. Το όριο που τίθεται για το οπτικό πεδίο της κάμερας είναι οι 80◦ καθώς για την κάλυψη ολόκληρου το πεδίου γύρω από την πλατφόρμα απαιτείται λίγο περισσότερο από 4 περιστροφές των 90◦ γύρω από τον βραχίονα περιστροφής της κάμερας.
Παράλληλα, για τα μικρόφωνα είναι πάλι αναγκαία η κάλυψη όλου το πεδίου γύρω από την πλατφόρμα, έτσι ώστε η τυχόν επικοινωνία με επιζώντες να μπορεί να πραγματοποιηθεί δίχως τεχνικές δυσκολίες και αντίστοιχα οι αλγόριθμοι εύρεσης θυμάτων να μην έχουν πολλά σημεία μικρής εμπιστοσύνης στο πεδίο του χώρου (λόγω ασθενών σημάτων ήχου). Για τον λόγο αυτό λοιπόν, και για την υπεροχή τους ως προς τον λόγο ποιότητας προς κόστος σε σχέση με τους υπόλοιπους τύπους, επιλέγονται δύο δικατευθιντικά μικρόφωνα, τα οποία αρκεί να τοποθετηθούν σε άξονες κάθετους μεταξύ τους για να καλύπτεται όλο το πεδίο γύρω από τον διασώστη. Τα μικρόφωνα αμφίδρομης κατευθυντικότητας, καταγράφουν σήμα μέσω πολικού διαγράμματος οκταειδούς και χαρακτηρίζονται από σημεία μηδενισμού στον εγκάρσιο άξονα της κάψουλας, ενώ διατηρούν μέγιστη ευαισθησία στον διαμήκη άξονα. Μέσω της χρήσης δύο τέτοιων καψών σε ορθογώνια διάταξη και την εφαρμογή αλγορίθμων διασταύρωσης δεδομένων, επιτυγχάνεται η ελαχιστοποίηση της αβεβαιότητας του ακουστικού σήματος στα "τυφλά" σημεία της διάταξης.


Σχήμα 2.35: Διάγραμμα καταγραφής σήματος διάταξης μικροφώνων.

Σχετικά με το επιταχυνσιόμετρο, για τη καλύτερη εξακρίβωση των δεδομένων θα πρέπει να τοποθετηθούν δύο όμοιοι αισθητήρες. Ένας ως σημείο αναφοράς των δονήσεων που παράγει το μηχανικό σύστημα της πλατφόρμας, και ένας κοντά στην πηγή καταγραφής των δονήσεων, δηλαδή σε όσο πιο άμεση επαφή με το έδαφος. Αυτό σημαίνει ότι το επιταχυσνιόμετρο θα πρέπει να βρίσκεται στο σώμα του διασώστη, κοντά στο έδαφος ενώ το επιταχυσνιόμετρο σημείο αναφοράς μέσα στο σύστημα κίνησης ή στο κέλυφος του κιβωτίου κίνησης.
Προφανώς η μονάδα αδρανειακής μέτρησης θα πρέπει να βρίσκεται κοντά στο κέντρο βάρους της κατασκευής, ενώ αναφορικά με το LiDAR, μιας και η θερμική κάμερα καλύπτει ήδη την ανάγκη για τρισδιάστατη χωρική απεικόνιση, ο αισθητήρας αυτός λόγω του μικρότερου κόστους μπορεί να επιλεγεί για δισδιάστατη απεικόνιση. Έτσι, με ένα 2D LiDAR με πεδίο σκαναρίσματος 360◦
, οι ανάγκες χαρτογράφησης του χώρου της αποστολής του διασώστη καλύπτεται πλήρως.
Τέλος, οι αισθητήρες καταγραφής διοξειδίου του άνθρακα, θα πρέπει να καλύπτουν επίσης όλο το πεδίο γύρω από τον διασώστη. Μιας και οι αισθητήρες αυτοί γενικά δεν έχουν μεγάλκο εύρος καταγραφής, θα πρέπει να τοποθετηθεί ένας σε κάθε πλευρά του V.L.A.D. με σκοπό τη πλήρη κάλυψη του πεδίου. Η τελική χωροταξική τοποθέτηση των αισθητήρων στη πλατφόρμα φαίνεται στο Σχ. 2.36.

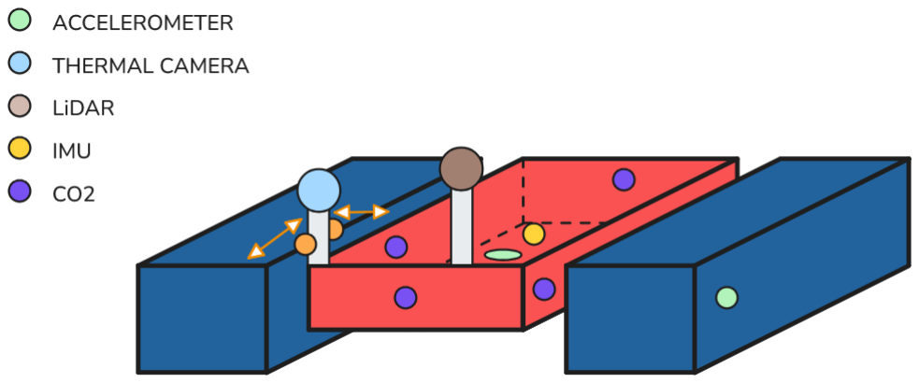
[picture p133: figure]

Σχήμα 2.36: Στρατηγική τοποθέτηση αισθητήρων στη πλατφόρμα του V.L.A.D.

Για όλους τους παραπάνω αισθητήρες, θεωρείται ότι υπάρχει αντίστοιχος αλγόριθμος επεξεργασίας των δεδομένων. Είναι πολύ σημαντικό επίσης, κυρίως για τα επιταχυσνιόμετρα και τα μικρόφωνα να προηγείται στάδιο φιλτραρίσματος των σημάτων για την απλοποίηση του σειρών των δεδομένων και της καλύτερης μετεπεξεργασίας τους. Εάν τα δεδομένα κάθε αισθητήρα, μετά από την κατάλληλη προ-επεξεργασία του σήματος, είχαν τον δικό τους αλγόριθμο εντοπισμού θύματος, πρέπει να δημιουργηθεί μια λογική αλληλουχία αλγοριθμικής διαχείρισης ώστε η πλατφόρμα να δουλεύει αυτόνομα κατά την αναζήτηση θυμάτων. Ο διασώστης θεωρείται ότι λειτουργεί αυτόνομα έως ότου παρέμβει ο χειριστής του. Έτσι, με τη χρήση του παρακάτω αλγόριθμου διαχείρισης του συνόλου των δεδομένων, επιτυγχάνεται ο εντοπισμός του θύματος.
Αν θεωρηθεί ότι:
- A: είναι το αποτέλεσμα (λογικό 1 ή 0) του αλγορίθμου εντοπισμού θύματος μόνο από τα δεδομένα της θερμικής κάμερας μετά από κατάλληλη προ-επεξεργασία αυτών. Όπου λογικό 1 σημαίνει ότι ο αλγόριθμος εντοπίζει θύμα προς συγκεκριμένη κατεύθυνση και 0 ότι δεν εντοπίζει.

- Mi

: είναι το αποτέλεσμα (λογικό 1 ή 0) του αλγορίθμου εντοπισμού θύματος μόνο από τα δεδομένα των μικροφώνων μετά από κατάλληλη προ-επεξεργασία αυτών. Όπου λογικό 1 σημαίνει ότι ο αλγόριθμος εντοπίζει θύμα προς συγκεκριμένη κατεύθυνση και 0 ότι δεν εντοπίζει.

- Ci

: είναι το αποτέλεσμα (λογικό 1 ή 0) του αλγορίθμου εντοπισμού θύματος μόνο από τα δεδομένα των αισθητήρων διοξειδίου του άνθρακα μετά από κατάλληλη προ-επεξεργασία αυτών. Όπου λογικό 1 σημαίνει ότι ο αλγόριθμος εντοπίζει θύμα προς συγκεκριμένη κατεύθυνση και 0 ότι δεν εντοπίζει.

- V: είναι το αποτέλεσμα (λογικό 1 ή 0) του αλγορίθμου εντοπισμού θύματος μόνο από τα δεδομένα του επιταχυνσιόμετρου μετά από κατάλληλη προ-επεξεργασία αυτών. Όπου λογικό 1 σημαίνει ότι ο αλγόριθμος εντοπίζει θύμα προς συγκεκριμένη κατεύθυνση και 0 ότι δεν εντοπίζει.

Για τα αποτελέσματα των αισθητήρων των μικροφώνων και του διοξειδίου του άνθρακα, θα πρέπει τουλάχιστον ένας εξ αυτών να έχει αποτέλεσμα λογικό 1. Δηλαδή για να ισχύει ότι Mi = 1 θα πρέπει M1ORM2 = 1. Επίσης ορίζοντας τα παρακάτω σενάρια προκύπτει μια προτεινόμενη δομή του ολικού αλγορίθμου εντοπισμού θυμάτων της πλατφόρμας στο Σχ. 2.37:

- S1: Σενάριο πρώτο, όπου το σύστημα του V.L.A.D., λόγω χαμηλής εμπιστοσύνης του ολικού αλγορίθμου εντοπισμού θύματος, παραπέμπει στον χειριστή να λάβει την απόφαση για τις επόμενες κινήσεις της αποστολής (αν θα συνεχιστεί η αναζήτηση, να ελεγχθεί κάποια άλλη συγκεκριμένη περιοχή, να επιβεβαιώσει αν όντως βρέθηκε θύμα).
- V I: Σενάριο αναγνώρισης θύματος. Κάθε φορά δηλαδή που ο αλγόριθμος καταλήγει στο αποτέλεσμα ότι εντοπίστηκε θύμα και αναμένει τις εντολές του χειριστή.
- S2: Σενάριο δεύτερο, όπου ξεκινά η αναγνώριση της πηγής ων δονήσεων μέσω κατάλληλου αλγορίθμου.
- SL: Σενάριο εκκίνησης αλγορίθμου εντοπισμού της πηγής του ηχητικού κύματος.
- 0: Σενάριο σφάλματος, δεν λαμβάνονται υπόψη οι ενδείξεις των αλγορίθμων και συνεχίζεται η αναζήτηση.
- CL: Σενάριο εκκίνησης αλγορίθμου εντοπισμού της πηγής υψηλής συγκέντρωσης διοξειδίου του άνθρακα.

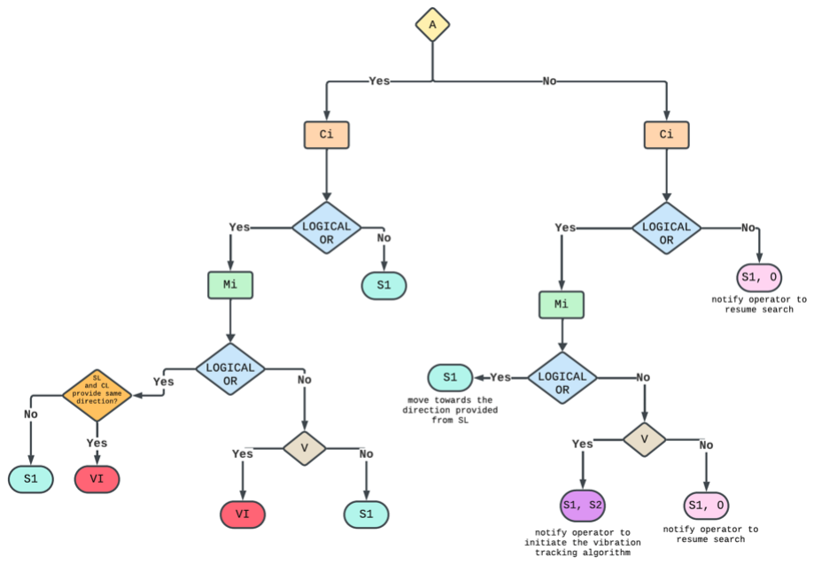
[picture p134: figure]

Σχήμα 2.37: Ολικός αλγόριθμος εντοπισμού θυμάτων της πλατφόρμας V.L.A.D.

Θα αναλυθούν δύο παραδείγματα παρακάτω ώστε να γίνει απολύτως αντιληπτή η λειτουργία της αυτόνομης διαχείρισης των δεδομένων με σκοπό τον εντοπισμό θυμάτων.
Ξεκινώντας με τις ενδείξεις της θερμικής κάμερας, έστω ότι ο αλγόριθμος εντοπισμός θυμάτων μόνο από αυτά τα δεδομένα καταλήγει σε λογικό 1 (βρέθηκε θύμα). Τότε, ακολουθώντας τη δομή του ολικού αλγορίθμου, σειρά έχει η εξακρίβωση των ενδείξεων της θερμικής κάμερας με τους αισθητήρες CO2. Έστω ότι ένας εξ αυτών καταλήγει σε λογικό 1, τότε επιβεβαιώνει τις ενδείξεις της θερμικής κάμερας και σειρά έχουν οι ενδείξεις των μικροφώνων. Έστω πάλι ότι ένα από τα δύο μικρόφωνα εντοπίζει θύμα μέσω του αλγορίθμου του, και επίσης έστω ότι η τοποθεσία του θύματος σύμφωνα με το αποτέλεσμα του αλγορίθμου εντοπισμού τοποθεσίας SL και του CL είναι προς κοινή κατεύθυνση, τότε ο ολικός αλγόριθμος καταλήγει στο συμπέρασμα ότι εντοπίστηκε θύμα.
Για το δεύτερο παράδειγμα υποτίθεται ότι οι ενδείξεις της κάμερας δεν εντοπίζουν θύμα. Ωστόσο, εάν τα αποτελέσματα από τουλάχιστον έναν αισθητήρα CO2 καταλήγουν θετικά, ελέγχονται τότε και τα αποτελέσματα των μικροφώνων. Εάν αυτά δεν εντοπίζουν θύμα, με τη σειρά τους ελέγχονται τα αποτελέσματα του αλγορίθμου των επιταχυνσιόμετρων και έστω ότι και αυτά πορκύψουν αρνητικά, τότε ο ολικός αλγόριθμος παραπέμπει τον χειριστή να συνεχίσει την αναζήτηση.
Ο παραπάνω αλγόριθμος αποτελεί μια πρόταση για το πως οι εκλεγμένοι αισθητήρες μπορούν να πλαισιώσουν την αποστολή του διασώστη προσφέροντας αυτονομία κατά την λειτουργία του, ακολουθώντας τον κύριο στόχο σχεδιασμού του V.L.A.D. Προφανώς, υπάρχουν καλύτερες και πιο αποδοτικές μέθοδοι διαχείρισης του όγκου των δεδομένων από όλους τους αισθητήρες, ωστόσο αυτή η πρόταση αποτελεί μια εξακρίβωση της ευρωστίας του λειτουργικού συστήματος του ρομποτικού διασώστη.

### 2.3.5 Σχεδιασμός σώματος και αποθήκης ειδών πρώτης ανάγκης

Όπως έχει προηγουμένως αναφερθεί, το σώμα της πλατφόρμας θα πληρεί τις παρακάτω προϋποθέσεις:

- Θα παρέχει χώρο αποθήκευσης ειδών πρώτης ανάγκης, με βάρος φορτίου όχι μεγαλύτερο από 5 κιλά.
- Θα αποτελεί το μέρος της πλατφόρμας όπου θα τοποθετηθούν όλα τα ηλεκτρονικά και η μπαταρία του συστήματος.
- Θα είναι ενιαίο κομμάτι με το εσωτερικό κέλυφος του κιβωτίου κίνησης για αύξηση της στιβαρότητας της κατασκευής.

Να σημειωθεί, ότι στις τελικές αλλαγές του σώματος, λήφθηκαν υπόψη οι πραγματικές επιλογές ηλεκτρονικών εξαρτημάτων και η τοποθέτηση τους. Οι επιλογές αυτές θα καλυφθούν σε μετέπειτα κεφάλαια.
Καταρχάς, πρέπει να ορισθεί σαφώς το φορτίο πρώτων βοηθειών της πλατφόρμας. Για τον λόγο αυτό χρειάζεται να επιλεγούν συγκεκριμένα αντικείμενα και παροχές που είναι σημαντικά και προτείνονται σε αποστολές διάσωσης. Στην δουλειά του Εμμανουήλ Κυριαζή κ.ά. ([8]), καταγράφονται σημαντικές λειτουργίες και στρατηγικές στις αποστολές διάσωσης σε σεισμούς. Με βάση την παραπάνω αναφορά αλλά και με περαιτέρω έρευνα προκύπτουν παρακάτω τα άκρως αναγκαία μεταφερόμενα αντικείμενα του διασώστη:
- Νερό σε μπουκάλι ή σε πλαστικές σακούλες με στόμιο.
- Επίδεσμους, γάζες και άλλες παροχές για την περίθαλψη τραυματισμών.
- Αλοιφές ευγκαυμάτων και καταπολέμησης πόνων.
- Τρόφιμα σε ξηρή ή ρευστή μορφή, όπου στη δεύτερη περίπτωση με μεταφορά σε ειδικά σακουλάκια.

Επιλέγεται λοιπόν, με βάση τα παραπάνω, η χρήση δύο μπουκαλιών νερού των 200 ml το κάθε ένα, η χρήση ενός φορητού φαρμακείου με επιδέσμους, γάζες, αλοιφές, χάπια κ.ά., και φακελάκια ρευστής και ξηράς τροφής. Έχοντας πλέον ορίσει πιο συγκεκριμένα το payload της πλατφόρμας, μπορεί να δημιουργηθεί το τρισδιάστατο αρχείο του σώματος. Το σώμα επιλέγεται να χωριστεί σε δύο μέρη, ένα για τη τοποθέτηση της μονάδας της μπαταρίας και ένας για την αποθήκευση του payload.
Το κάτω μέρος, υπεύθυνο για την τοποθέτηση του κύριου κυκλώματος ηλεκτρονικών, σχεδιάζεται με βάση τις διαστάσεις του δικτυώματος του σώματος. Η τελική του μορφή φαίνεται παρακάτω στο Σχ. 2.38. Όπως γίνεται αντιληπτό, τα εσωτερικά μέρη του κελύφους του κιβωτίου κίνησης αποτελούν προέκταση του σώματος. Επίσης, φαίνονται και δίαφοροι αποστάτες για τη τοποθέτηση συγκεκριμένων αισθητήρων όπως θα αναλυθεί και παρακάτω. Αυτό το μισό του σώματος θα είναι υπεύθυνο για την αποθήκευση της πλακέτας του επεξεργαστή, των οδηγών των κινητήρων, των αισθητήρων καταγραφής CO2, της μπαταρίας και των απαραίτητων πλακετών διεπαφής των ηλεκτρονικών της πλατφόρμας.

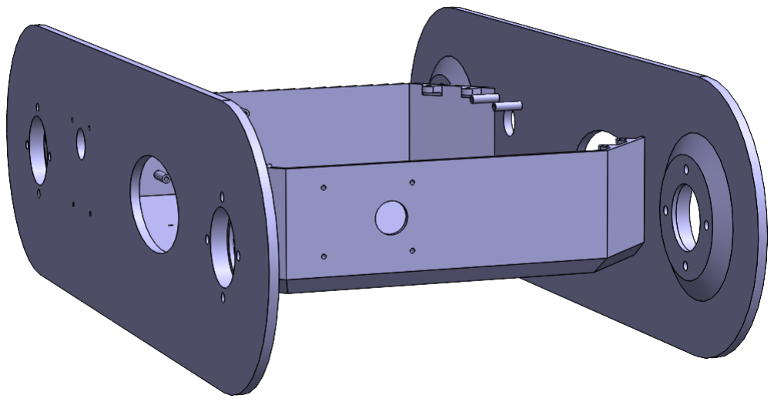
[picture p135: figure]

(αfl) Διμετρική όψη. | (βfl) Προοπτική σώματος.


(γfl) Αποστάτες τοποθέτησης αισθητήρων.

Σχήμα 2.38: Τρισδιάστατο σχέδιο CAD του κάτω μέρους του σώματος της πλατφόρμας V.L.A.D.

Το πάνω μέρος του σώματος του V.L.A.D. θα είναι υπεύθυνο για την μεταφορά του payload και των αισθητήρων LiDAR, της κάμερας και των μικροφώνων, καθώς όπως έχει αναφερθεί, αυτά θα πρέπει να βρίσκονται σε υψηλά σημεία στην πλατφόρμα. Για λόγους αισθητικής, και εφόσον ακόμη και με αυτόν τον τρόπο εξυπηρετούνται οι στόχοι της αποστολής επιλέγεται να σχεδιαστεί θόλος για αυτό το μισό του σώματος. Ο θόλος αυτός, αποτελείται από δύο μέρη, την βάση και το καπάκι και το υλικό αυτών καθώς και η μέθοδος παραγωγής τους, επιλέγονται διαφορετικά από αυτών του κάτω μέρους. Κρίνεται ότι η χρήση τεχνολογιών τρισδιάστατης εκτύπωσης αποτελούν μια ικανοποιητική και μη κοστοβόρα επιλογή για τη κατασκευή του θόλου. Το υλικό που επιλέγεται είναι το PEEK λόγω της υψηλής αντοχής του. Παρακάτω, στα Σχ. 2.39 και Σχ. 2.40 φαίνεται η τρισδιάστατη μορφή του θόλου καθώς και κάποιοι όγκοι που αναπαριστούν τα αντικείμενα πρώτων βοηθειών του payload. Με τη πράσινη απόχρωση αναπαρίσταται το φαρμακείο πρώτων βοηθειών με διαστάσεις 80 × 75 × 40 mm και με ροζ απόχρωση τα μπουκάλια νερού των 200ml, με διαστάσεις ∅49 × 142 mm. Ο συνολικός όγκος μεταφοράς αντικειμένων πρώτων βοηθειών του θόλου προκύπτει 4.05 lt.
Όπως φαίνεται, η βάση για το LiDAR τοποθετείται στο υψηλότερο σημείο του σώματος για τους λόγους που έχουν αναφερθεί παραπάνω, ενώ η κάμερα τοποθετείται λίγο χαμηλότερα, με αποτέλεσμα βέβαια να μειώνεται λίγο από το οπτικό της πεδίο. Αυτή η παραδοχή έγινε για να μην καλύπτεται το οπτικό πεδίο σάρωσης του LiDAR. Επιπροσθέτως, η βάση στήριξης του LiDAR σχεδιάστηκε ως διαιρετή, με στόχο τη βελτιστοποίηση της διαχείρισης των καλωδιώσεων εντός της πλατφόρμας. Συγκεκριμένα, η βάση φέρει δύο οπές διέλευσης, οι οποίες επιτρέπουν την ασφαλή όδευση των καλωδίων από τους αισθητήρες του άνω επιπέδου προς τις υποδοχές των ηλεκτρονικών μονάδων που βρίσκονται στο κάτω τμήμα.

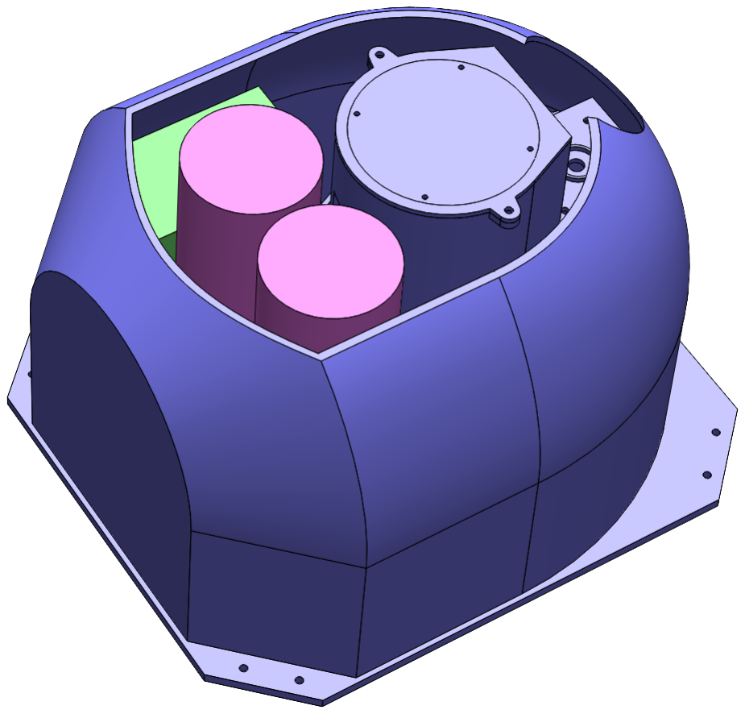
[picture p136: figure]

(αfl) Συναρμολογημένη θόλου. | (βfl) Βάση θόλου. | (γfl) Χώρος αποθήκευσης payload.

Σχήμα 2.39: Τρισδιάστατη απεικόνιση άνω μέρος σώματος και χώρου αποθήκευσης.

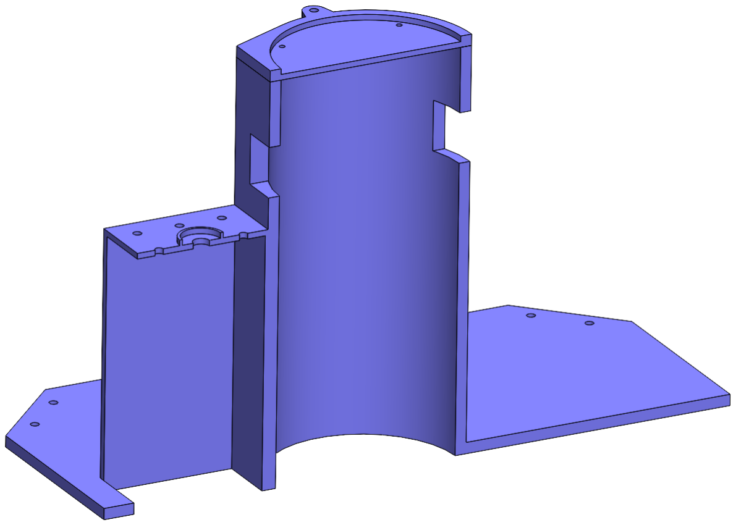
[picture p137: figure]
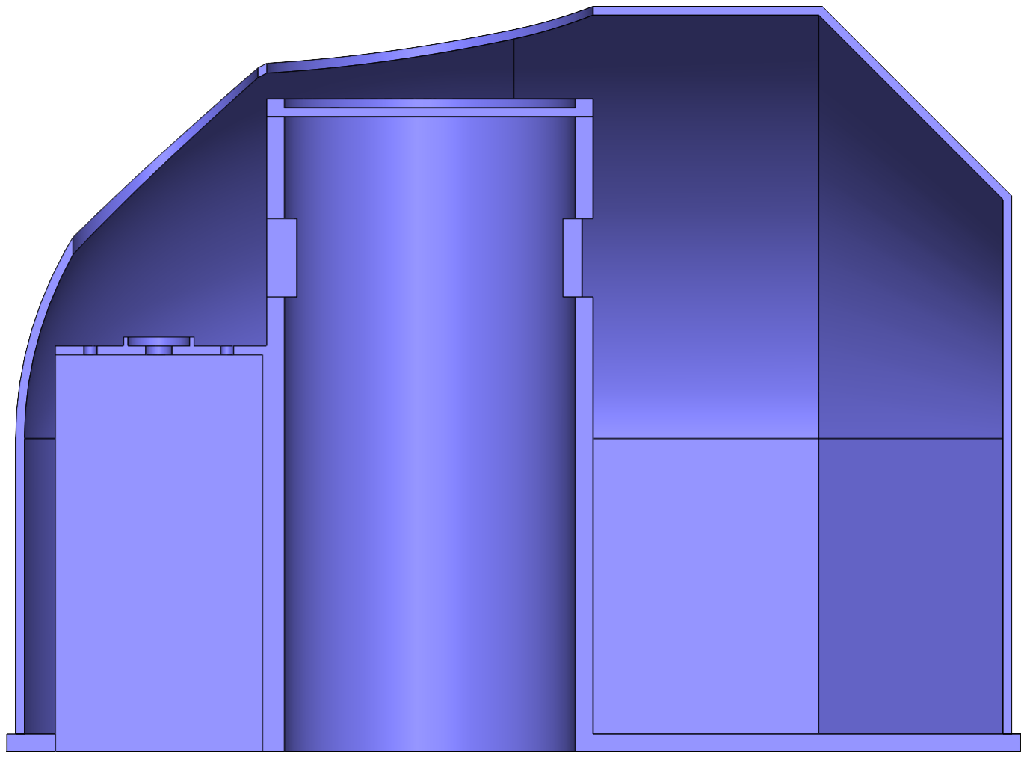
[picture p138: figure]

(αfl) Τομή βάσης θόλου. | (βfl) Τομή συναρμολογημένης.
| Σχήμα 2.40: Τομή άνω μέρους σώματος.

### 2.3.6 Αναθεώρηση σχεδιασμού συστήματος κίνησης και τελικό ισοζύγιο μάζας

Μετά και τον τελικό σχεδιασμό του σώματος, οι πιο κρίσιμες αλλαγές είναι αυτές στο σύστημα κίνησης για τη διασφάλιση της σωστής λειτουργίας όλων των μηχανολογικών εξαρτημάτων. Έχει ήδη προαναφερθεί, ότι κατά τη προηγούμενη σχεδιαστική πρόταση του συστήματος κίνησης, υπήρχαν αρκετά σημεία που χρήζαν πιο ορθή μελέτη και σχεδιασμό, αλλά για το σκοπό της αρχικής εκτίμησης μάζας κρίθηκε μη αναγκαίο να οριστούν καλύτερα σε εκείνο το σημείο. Πλεόν πρέπει να ορισθούν πιο ορθά οι εδράσεις του συστήματος, επιτρέποντας κατάλληλη στήριξη στις ατράκτους του συτήματος και οι συνδέσεις των λοιπών μηχανολογικών εξαρτημάτων.
Ξεκινώντας από τις εδράσεις, αυτές δεν ακολουθούσαν τις σύνηθεις πρακτικές στην έδραση ατράκτων. Μιας και η πλατφόρμα του V.L.A.D. αποτελεί ένα σύστημα που δύναται να χρησιμοποιηθεί σε δυσμενείς συνθήκες πρέπει οι εδράσεις να εξασφαλίζουν τη σταθερότητα της ατράκτου και τη σωστή διαχείριση των δυνάμεων που αυτή δέχεται. Με πλέον στιβαρό σημείο της κατασκευής το εσωτερικό μέρος του κελύφους, που αποτελεί κομμάτι του σώματος, η έδραση του σώματος στην άτρακτο αποτελεί ένα κρίσιμο σημείο καταπόνησης της κατασκευής. Έτσι, σε εκείνο το σημείο επιλέγεται να δημιουργηθεί η σταθερή έδραση της ατράκτου. Το κινητό δημείο της έδρασης της ατράκτου θα είναι στο εξωτερικό κομμάτι του κελύφους του κιβωτίου κίνησης. Σε όλα τα σημεία εδράσεων, τα κατασκευαστικά στοιχεία που είναι υπεύθυνα για τη σταθεροποίηση των εδράνων πρέπει να παρουσιάζουν κατάλληλη στιβαρότητα. Επομένως, σε εκείνα τα σημεία το πάχος των τεμαχίων αυτών αυξάνεται για να διασφαλίσει τη κατασκευαστική ακεραιότητα του συστήματος.
Τα λοιπά διαχωριστικά επιλέγεται να απαλοιφθούν από τη συναρμολόγηση του κιβωτίου, επομένως μόνο η έδραση της ατράκτου του βραχίονα (flipper) του V.L.A.D. πρέπει να ορισθεί ορθά από τις εδράσεις του κύριου συτήματος κίνησης. Επιλέγεται πάλι μια συνδεσμολογία εδράνων τύπου "Σταθερή-Κινητή", όπου η σταθερή έδραση συμβαίνει στο εξωτερικό σημείο της ατράκτου, αξιοποιώντας τη κοχλιοσύνδεση του βραχίονα στην άτρακτο για τη παρεμπόδιση της κίνησης του εδράνου και τη σταθεροποίηση της ατράκτου του βραχίονα. Καθώς η άτρακτος του βραχίονα φέρει κατεργασία οδόντωσης θα πρέπει να δωθούν μεγάλη προσοχή στον ορισμό των ανοχών της συναρμολογημένης για τη διασφάλιση της ορθής θέσης λειτουργίας της οδοντοκίνησης.
Και για τις δύο εδράσεις των δύο ατράκτων του κύριου συστήματος κίνησης, χρησιμοποιούνται και περικόχλια ασφαλείας ατράκτου. Αυτά τοποθετούνται σε ειδικά διαμορφωμένα εξωτερικά σπειρώματα στην επιφάνεια της κύριας ατράκτου. Για τη σύσφιξη των εδράσεων χρησιμοποιούνται και αποστάτες με σκοπό την αύξηση της επιφάνειας επαφής για τη σταθεροποίηση της έδρασης.
Οι επιλογές των μηχανολογικών εξαρτημάτων έγινε με βάση των διαστάσεων που είχαν ορισθεί κατά τον σχεδιασμό του τρισδιάστατου αρχείου CAD της πλατφόρμας. Προφανώς οι επιλογές αυτές θα πρέπει να ελεγχθούν για αντοχή με βάση το έδρανο κύλισης που επιλέγεται. Μια πρόχειρη μελέτη, καθώς πιο λεπτομερής ανάλυση ξεφεύγει του στόχουν της παρόν εργασίας, πραγματοποιείται σε μετέπειτα κεφάλαια. Η τομή του κύριου συστήματος κίνησης με τις αλλαγές που προαναφέρθηκαν στο παρόν υποκεφάλαιο και στα κεφάλαια αναφορικά με τις τεχνικές μείωσης μάζας της πλατφόρμας, παρατηρείται στο Σχ. 2.41

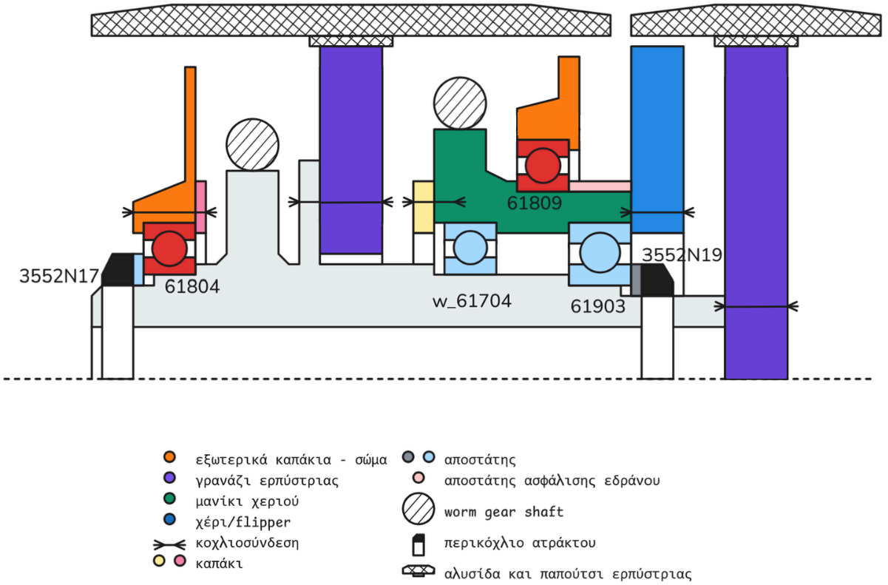
[picture p139: figure]

Σχήμα 2.41: Σκαρίφημα συναρμολογημένης διάταξης κύριου συτήματος κίνησης κατά την δεύτερη επανάληψη του ισοζυγίου μάζας v2.

Παράλληλα, αναφορικά με το οπίσθιο σύστημα κίνησης, η σταθερή έδραση είναι πάλι στο εσωτερικό κομμάτι του κελύφους, διορθώνοντας το προηγούμενο σφάλμα όπου το καπάκι της πλήμνης του κιβωτίου φέρει επαφή και με τους δύο δαχτύλιους του εδράνου κύλισης. Τέτοια σφάλματα, μαζί και με άλλα, έγιναν κατά την πρώτη επανάληψη καθώς ο σκοπός ήταν να διορθωθούν στη δεύτερη έκδοση του ισοζυγίου μάζας. Όπως ήδη αναφέρθηκε, η πρώτη επανάληψη έγινε για να αποκτηθεί μια πρώτη εκδοχή των σχεδίων της κατασκευής και να δημιουργηθεί μια πρώτη χωροταξική εκτίμηση της συναρμολόγισης. Επίσης, αντίστοιχα με τη κύρια άτρακτο, οι φλάντζες για τη πάκτωση των οδοντωτών τροχών και τη μεταφορά ροπής κατεργάζονται απευθείας στην οπίσθια κύρια άτρακτο. Η δεύτερη έδραση της ατράκτου, δημιουργείται και αυτή ως σταθερή καθώς αυτή η άτρακτος είναι βοηθητική και οδηγείται από τον εμπρόσθιο τροχό. Στο Σχ. 2.42 φαίνεται το σκαρίφημα του οπίσθιου συστήματος κίνησης.

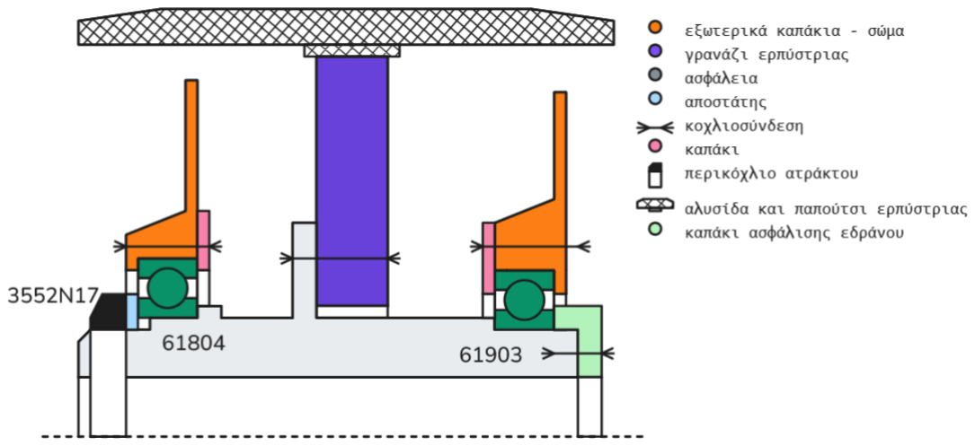
[picture p140: figure]

Σχήμα 2.42: Σκαρίφημα συναρμολογημένης διάταξης οπίσθιου συστήματος κίνησης κατά τη δεύτερη επανάληψη του ισοζυγίου μάζας v2.

Επιπρόσθετα, το δευτερεύον σύστημα κίνησης αλλάζει σε σχέση με τον ορισμό της έδρασης του βραχίονα. Πλεόν, η δευτερεύουσα άτρακτος συνδέεται μέσω κοχλιοσύνδεσης με τον βραχίονα περιστροφής και η έδραση πραγματοποιείται στον οδοντωτό τροχό. Ο τροχός αυτός είναι κινούμενος από τον τροχό της δευτερεύουσας ερπύστριας του κύριου συτήματος κίνησης. Τα έδρανα ακουλουθούν μια έδραση με προένταση τύπου "Χ", καθώς προεντείνονται τα εσωτερικά δαχτυλίδια των εδράνων μέσω ενός περικοχλίου ασφαλείας ατράκτου. Προφανώς για να λειτουργήσει αυτή η έδραση θα πρέπει ο αποστάτης των εσωτερικών δαχτυλιδιών των εδράνων να έχει μικρότερο πάχος από ότι ο αποστάτης των άνω δαχτυλιδιών, ο οποίος είναι κατεργαζμένος στον οδοντωτό τροχό. Η άτρακτος κατασκευάζεται και αυτή ως κοιλοδοκός για τη μείωση της μάζας του υποσυστήματος. Το σκαρίφημα φαίνεται παρακάτω.

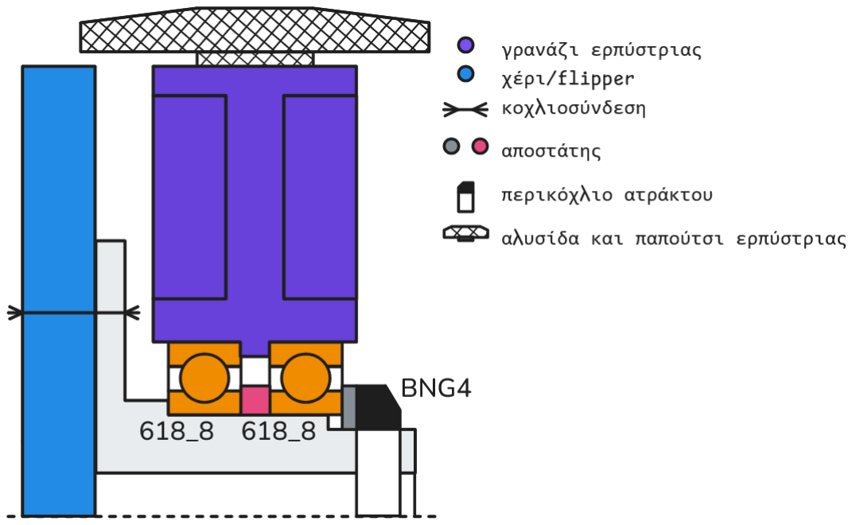
[picture p141: figure]

Σχήμα 2.43: Σκαρίφημα συναρμολογημένης διάταξης οπίσθιου συστήματος κίνησης κατά τη δεύτερη επανάληψη του ισοζυγίου μάζας v2.

Πέραν των συστημάτων κίνησης, θα πρέπει να επανασχεδιαστεί με πολύ μεγαλύτερη σαφήνεια και η έδραση του ατέρμονα κοχλία. Για να εδραστεί σωστά η άτρακτος του κοχλία θα πρέπει να δημιουργηθεί ένα σταθερό σημείο έδρασης. Αυτό επιλέγεται να γίνει στην πλευρά μακριά του κινητήρα για διευκόλυνση της συναρμολόγησης. Για να δημιουργηθούν ορθά οι εδράσεις θα πρέπει τα σημεία που πακτώνονται τα έδρανα να έχουν ικανοποιητική στιβαρότητα. Επομένως, εισάγονται στο σχεδιασμό δύο σταθεροποιητές. Αυτοί θα συνδέονται τόσο στην πλάκα ένωσης του κιβωτίου κίνησης και του σώματος όσο και στο ίδιο το σώμα μέσω κοχλισυνδέσεων. Το υλικό τους επιλέγεται για άλλη μια φορά το PEEK. Παρακάτω, στο Σχ. 2.44 φαίνεται το σκαρίφημα της συναρμολογημένης.

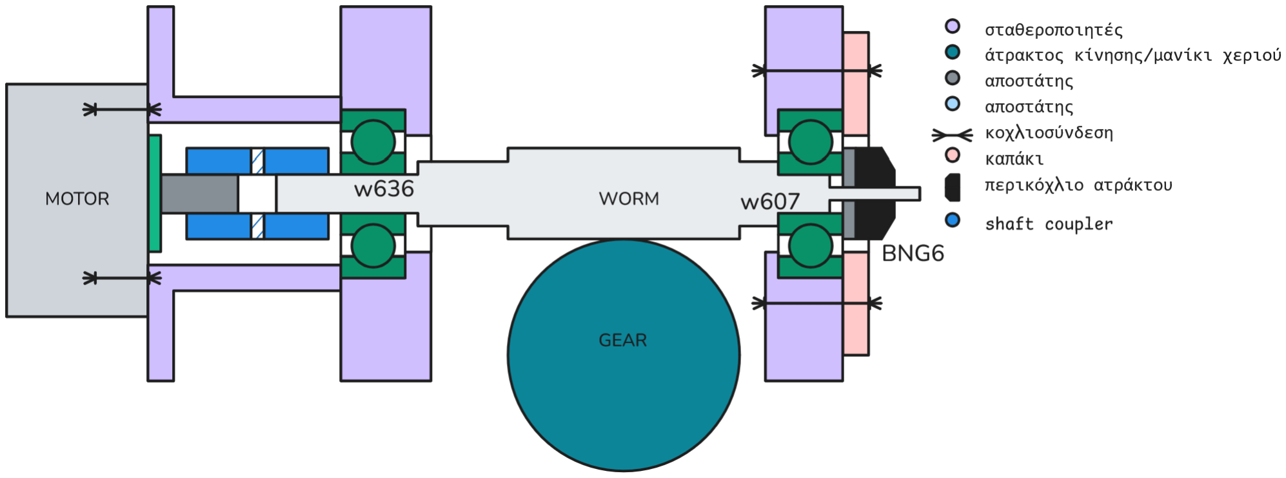
[picture p142: figure]

Σχήμα 2.44: Σκαρίφημα συναρμολογημένης διάταξης οπίσθιου συστήματος κίνησης κατά τη δεύτερη επανάληψη του ισοζυγίου μάζας v2.

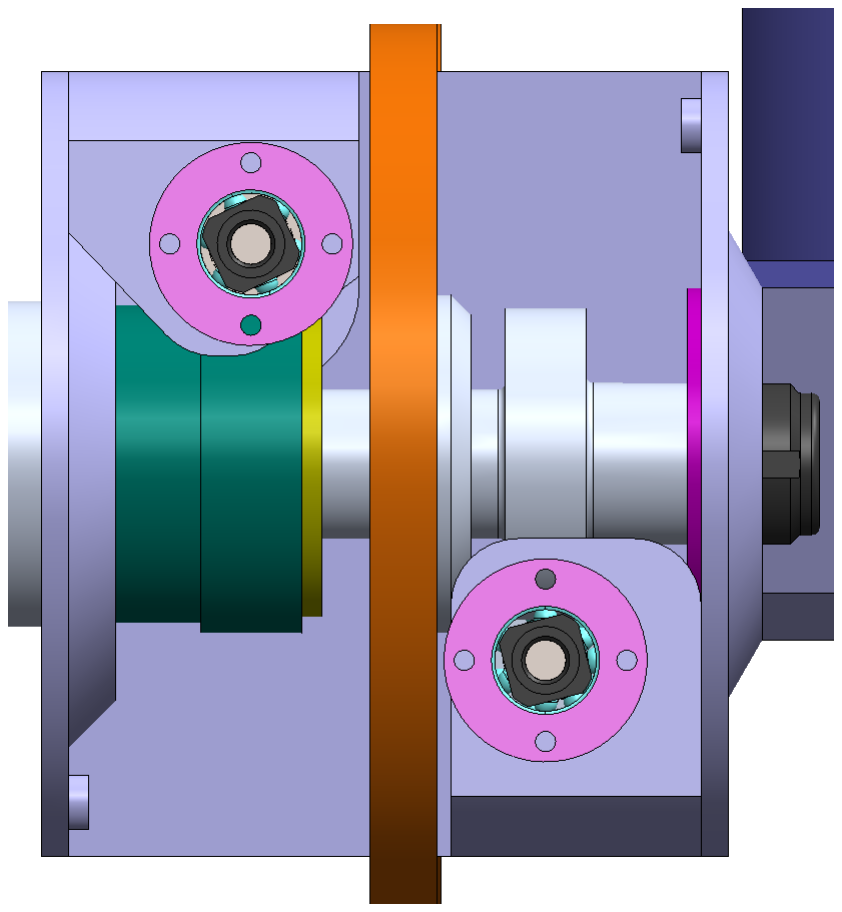
[picture p143: figure]

(αfl) Άνω σταθεροποιητής. | (βfl) Αρχείο CAD. | (γfl) Άνω και κάτω σταθεροποιητές.

Σχήμα 2.45: Σταθεροποιητές άξονα ατέρμονα κοχλία του κύριου συστήματος κίνησης.

Όπως παρατηρείται παρακάτω, οι δύο σταθεροποιητές εδράζονται στην άτρακτο του ατέρμονα κοχλία, έχοντας τη σταθερή έδραση προς την αντίθετη κατεύθυνση από το σημείο εφαρμογής της ροπής από τον κινητήρα. Αυτό συμβαίνει για διευκόλυνση της συναρμολόγησης της διάταξης. Στη συναρμολόγηση, η άτρακτος εισέρχεται εντός του σταθεροποιητή από την εξωτερική του οπή και εδράζεται στην κινητό έδρανο της διάταξης, που είναι ήδη εφαρμοζμένο στον σταθεροποιητή. Οι κοχλίες σύσφιξης του καμπτικού συνδέσμου θα πρέπει να συσφιχθούν αφού φορεθεί η άτρακτος, επομένως ο αποστάτης που προεξέχει από τη πλάκα ένωσης δεν αντισκέται περιμετρικά στο έδρανο κύλισης αλλά σε ένα τόξο 270◦
, αφήνοντας άνοιγμα για το εργαλείο σύσφιξης των κοχλιών.

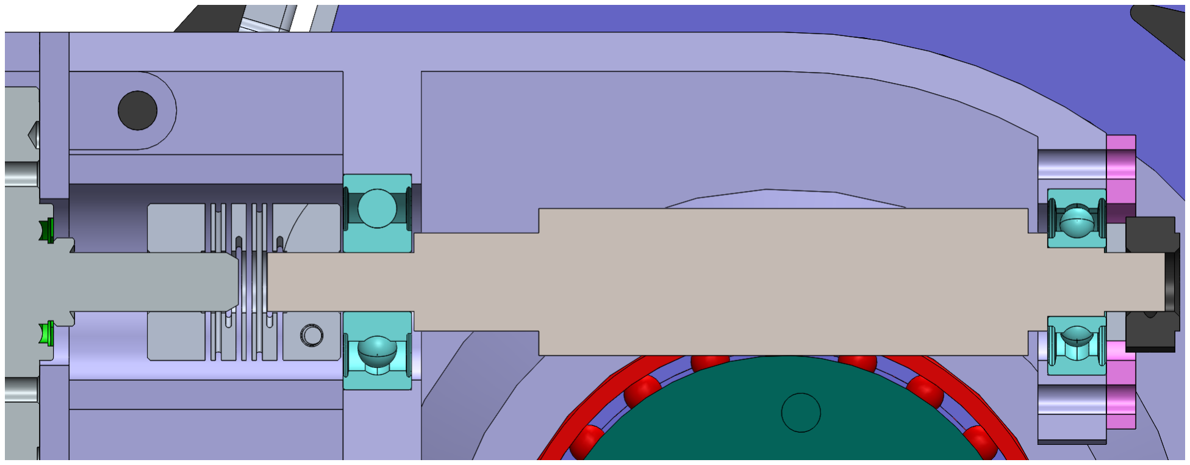
[picture p144: figure]
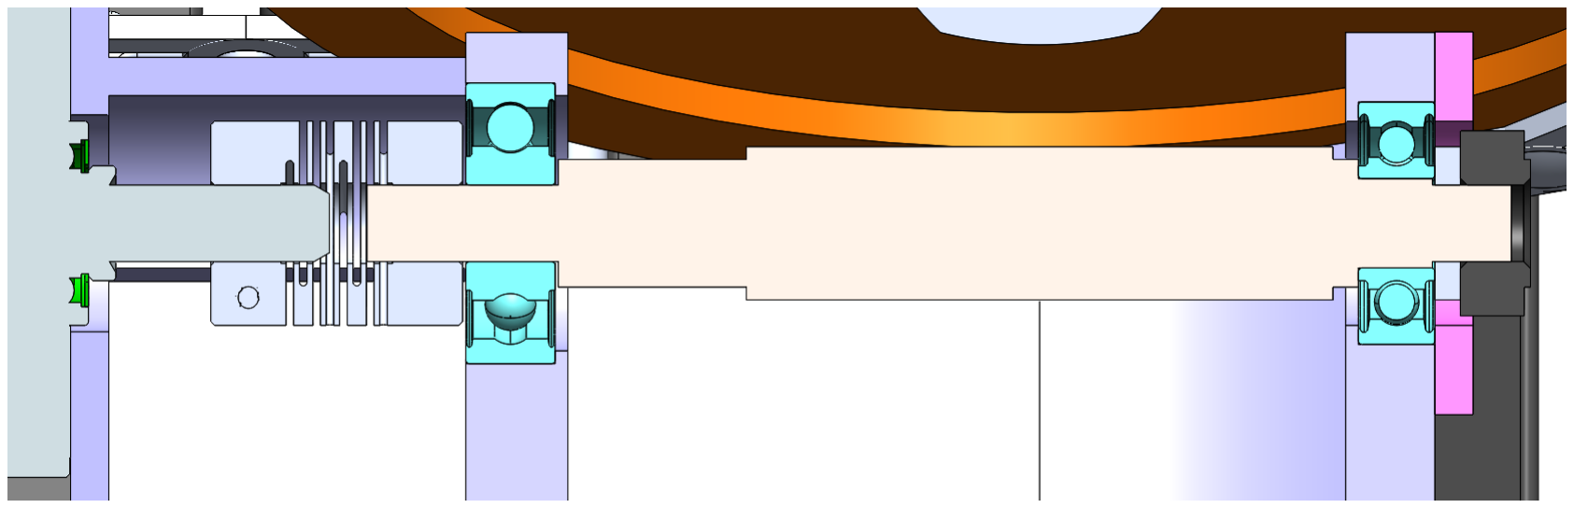
[picture p145: figure]

(αfl) Άνω σταθεροποιητής. | (βfl) Κάτω σταθεροποιητής.

Σχήμα 2.46: Τομές συναρμολογημένων διατάξεων άνω και κάτω σταθεροποιητών.

Εφόσον πλεόν, έχουν ορισθεί ορθά οι εδράσεις σε όλα τα σημεία του συστήματος κίνησης, θα πρέπει να επιλεχθούν τα έδρανα και τα λοιπά μηχανολογικά στοιχεία που ικανοποιούν τα κριτήρια του σχεδιασμού. Για τα έδρανα κύλισης επιλέγονται πάλι από τη βιβλίοθήκη της SKF, σφαιρικά έδρανα κύλισης που ικανοποιούν τις διαστάσεις του σχεδιασμού. Σχετικά με τα περικόχλια ατράκτου, αυτά επιλέγονται από τη βιβλιοθήκη της McMaster Carr και της MISUMI. Ο εύκαμπτος σύνδεσμος αξόνων επιλέγεται και αυτός από τον κατάλογο της McMaster Carr.

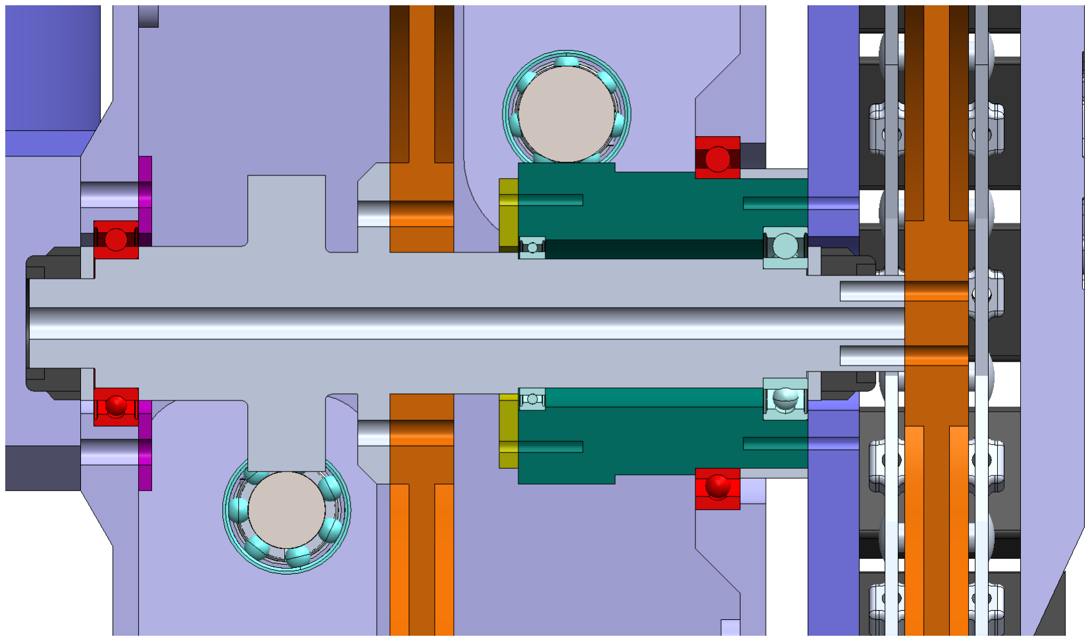
[picture p146: figure]
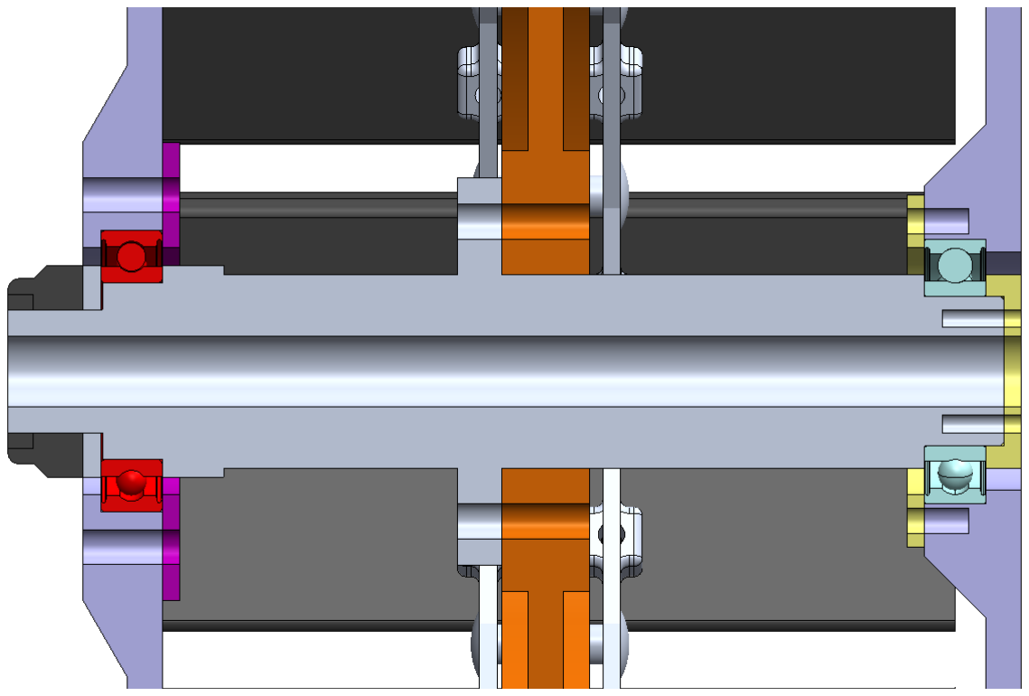
[picture p147: figure]

(αfl) Κύριο σύστημα κίνησης. | (βfl) Οπίσθιο σύστημα κίνησης. | (γfl) Δευτερεύον σύστημα κίνησης.

Σχήμα 2.47: Τομές συναρμολογημένων διατάξεων συστημάτων κίνησης κατά τη δεύτερη επανάληψη του ισοζυγίου μάζας v2.

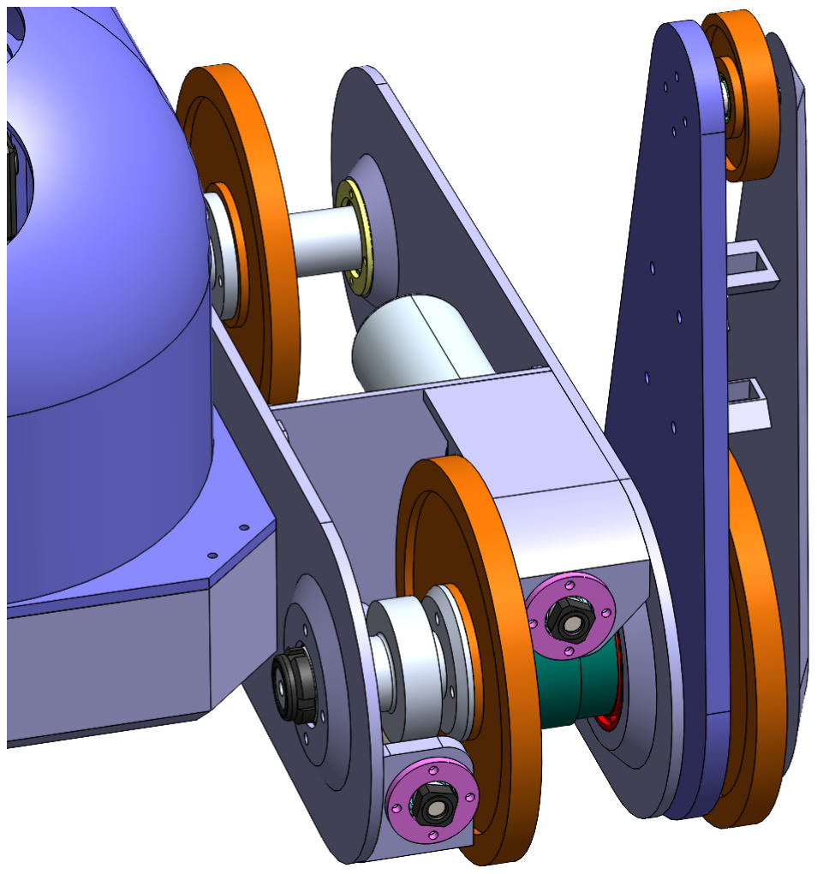
[picture p148: figure]
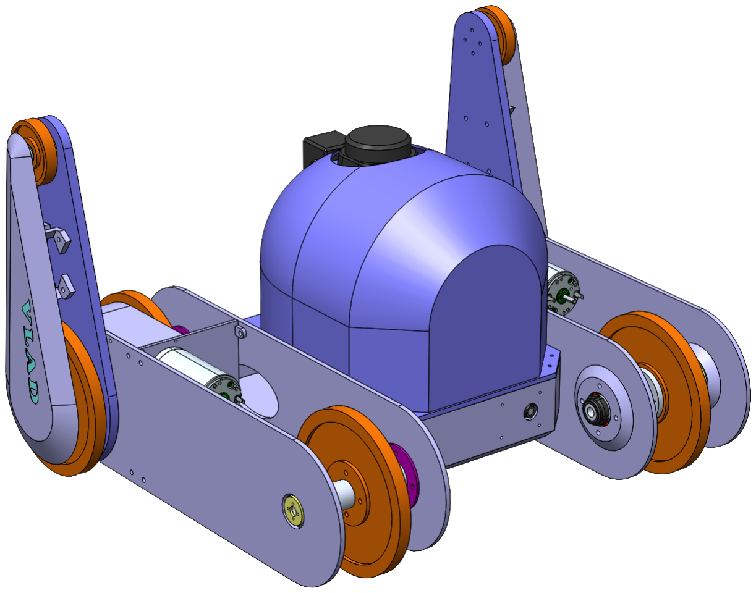
[picture p149: figure]

(αfl) Διμετρική όψη. | (βfl) Λεπτομέρειες σχεδιασμού.

Σχήμα 2.48: Λεπτομέρειες συστήματος κίνησης της πλατφόρμας V.L.A.D. κατά τη δεύτερη επανάληψη του ισοζυγίου μάζας v2.

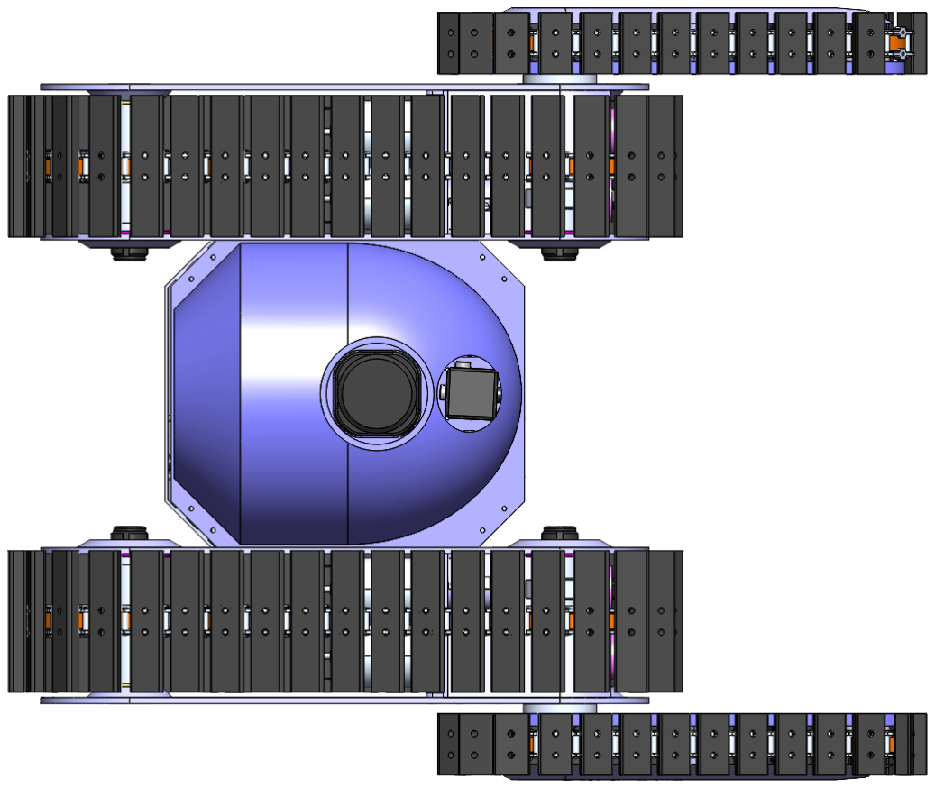
[picture p150: figure]

(αfl) Διμετρική όψη. | (βfl) Κάτοψη.

Σχήμα 2.49: Τρισδιάστατη απεικόνιση πλατφόρμας V.L.A.D. κατά τη δεύτερη επανάληψη του ισοζυγίου μάζας v2.

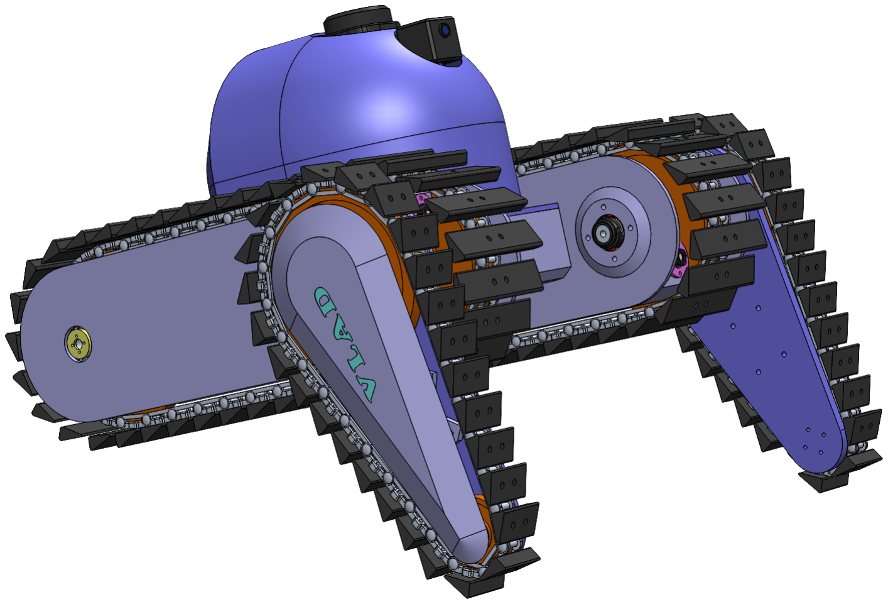
[picture p151: figure]
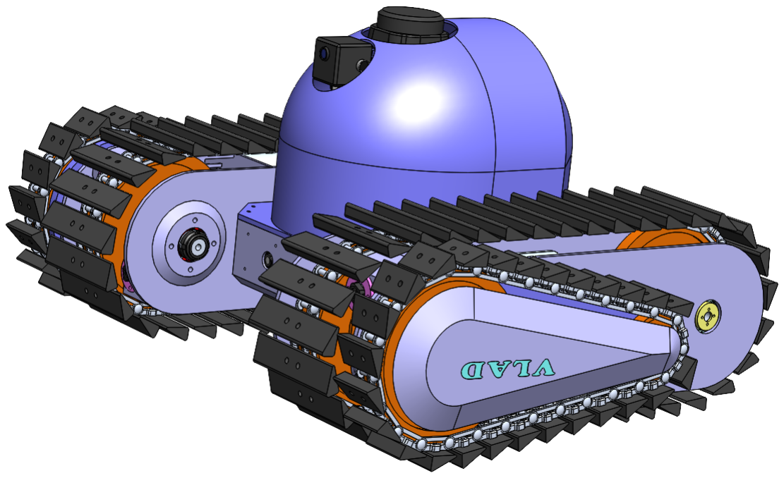
[picture p152: figure]

(αfl) Αναρρίχηση εμποδίων. | (βfl) Εξοικονόμιση χώρου.

Σχήμα 2.50: Μερικές λειτουργίες της πλατφόρμας V.L.A.D. κατά τη δεύτερη επανάληψη του ισοζυγίου μάζας v2.

Κατά την δεύτερη επανάληψη, έγινε και μια πιο ορθή εκτίμηση του βάρους των μηχανολογικών εξαρτημάτων, του φορτίου μεταφοράς (payload) και των ηλεκτρονικών. Αυτή η εκτίμηση καθτέστη δυνατή, λόγω του πιο εμπερειστατωμένου και αναλυτικού ορισμού των στοιχείων αυτών. Η συνολική μάζα της πλατφόρμας, με όλες τις αλλαγές που περιγράφηκαν σε αυτά τα κεφάλαια, μειώθηκε κατά περίπου 10 κιλά. Μια πολύ σημαντική μείωση με σκοπό τη βελτιστοποίηση της αποόδοσης του διασώστη, που αποτελεί ένα πολύ πιο ολοκληρωμένο σημείο εκκίνησης για τον διαμορφωτικό σχεδιασμό του V.L.A.D. Στον Πίν. 2.6 φαίνονται αναλυτικά τα στοιχεία της κατασκευής και το ισοζύγιο μάζας κατά τη δεύτερη επανάληψη. Εδώ, σαν λοιπά μηχανολογικά στοιχεία έχουν θεωρηθεί και οι διάφοροι αποστάτες για σταθεροποίηση των εδράσεων. Έχει επίσης σχεδιαστεί ένα καπάκι για τον βραχίονα, με σκοπό τη προστασία των τροχών στην εξωτερική μεριά του, που φέρει και το ακρωνύμιο της πλατφόρμας.

Part | Material | Qty | Unit Mass (g) | Total Mass (g)
| Mobility Subsystem
Σύνδεσμος κύριας ερπύστριας | 2024 Τ4/Rubber | 37 | 18.05 | 667.85
Σύνδεσμος δευτερεύουσας ερπύστριας | 2024 Τ4/Rubber | 27 | 10.17 | 274.59
Περιστρεφόμενος βραχίονας | 2024 T4 | 2 | 515.88 | 1031.76
Άτρακτος περιστρεφόμενου βραχίονα | 2024 T4 | 2 | 146.42 | 292.84
Πλάκα ένωσης σώματος-κιβωτίου | 2024 T4 | 2 | 108 | 216
Δευτερεύουσα άτρατκος | Steel | 2 | 22.23 | 44.46
Ελεύθερος τροχός δευτερεύουσας ερπύστριας | 2024 T4 | 2 | 35.39 | 70.78
Τροχός κύριας ερπύστριας | 2024 T4 | 4 | 231.27 | 925.08
Τροχός δευτερεύουσας ερπύστριας | 2024 T4 | 2 | 223.11 | 446.22
Κύρια εμπρόσθια άτρακτος | 2024 T4 | 2 | 175.8 | 351.6
Κύρια οπίσθια άτρακτος | 2024 T4 | 2 | 108.12 | 216.24
Εξωτερικό καπάκι κιβωτίου κίνησης | Zoltek Panex 33 | 2 | 329.7 | 659.4
Ατέρμονας κοχλίας κύριας ερπύστριας | Steel | 2 | 52.02 | 104.04
Ατέρμονας κοχλίας περιστρεφόμενου βραχίονα | Steel | 2 | 82.2 | 164.4
Σταθεροποιητής ατέρμονα ερπύστριας | PEEK | 2 | 45.08 | 90.16
Σταθεροποιητής ατέρμονα βραχίονα | PEEK | 2 | 37.67 | 75.34
Καπάκι βραχίονα | PEEK | 2 | 179.53 | 359.06
Καπάκι σταθεροποίησης εδράνου ατράκτου βραχίονα | 2024 T4 | 2 | 9.08 | 18.16
Λοιπά μηχανολογικά στοιχεία | Var. | 1 | 1500.0 | 1500.0
Body Subsystem
Κάτω μέρος σώματος | Zoltek Panex 33 | 1 | 1180.5 | 1180.5
Άνω μέρος σώματος | PEEK | 1 | 778.43 | 778.43
Payload | Var. | 1 | 2000.0 | 2000.0
Λοιπά στοιχεία | Var. | 1 | 200.0 | 200.0
Electronics Hardware
LiDAR Unit | - | 1 | 380.0 | 380.0
Thermal Camera | - | 1 | 30.0 | 30.0
Λοιποί αισθητήρες | - | 1 | 50.0 | 50.0
Μπαταρία | - | 1 | 2000.0 | 2000.0
Κινητήρες ερπύστριας | - | 2 | 820.0 | 1640.0
Κινητήρες βραχίονα | - | 2 | 480.0 | 960.0
Λοιπά ηλεκτρονικά | - | 1 | 100.0 | 100.0
Grand Total Mass | | | | 17.33 kg

Πίνακας 2.6: Ισοζύγιο μάζας v2.

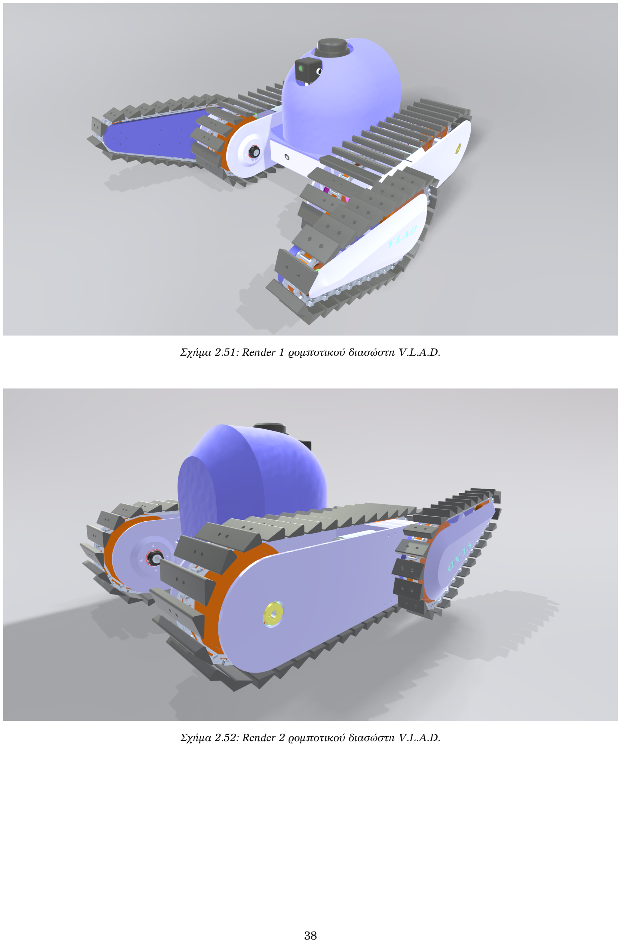
[picture p153: page 42]

Σχήμα 2.51: Render 1 ρομποτικού διασώστη V.L.A.D.

Σχήμα 2.52: Render 2 ρομποτικού διασώστη V.L.A.D.

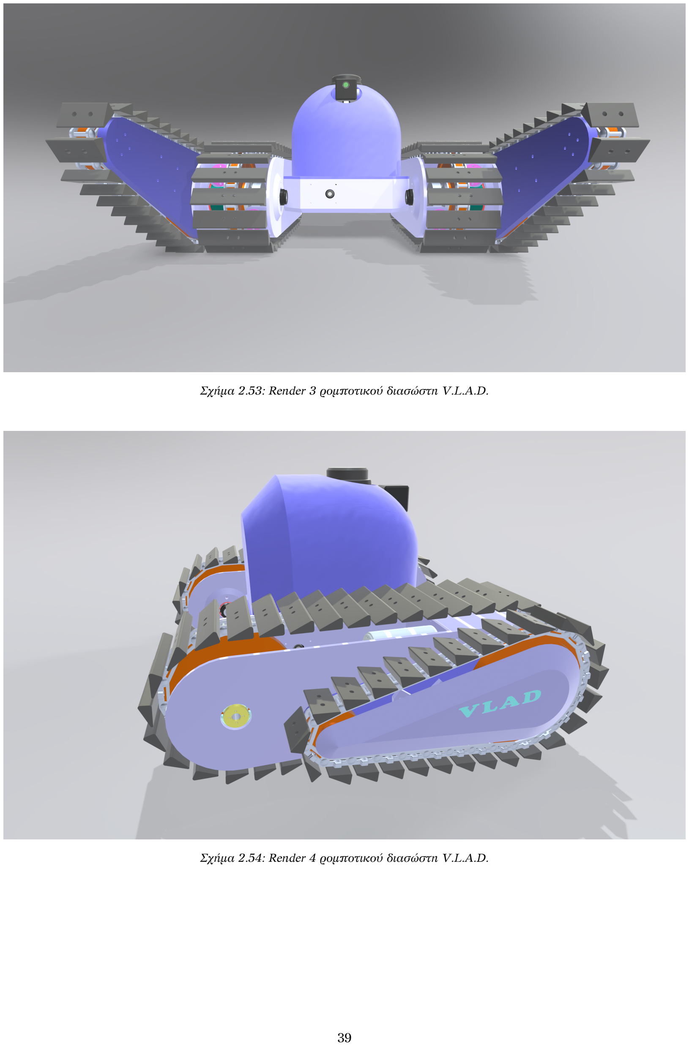
[picture p154: page 43]

Σχήμα 2.53: Render 3 ρομποτικού διασώστη V.L.A.D.

Σχήμα 2.54: Render 4 ρομποτικού διασώστη V.L.A.D.

## 2.4 Ισοζύγιο ισχύος και εκλογή κινητήρων

### 2.4.1 Απαιτήσεις ροπής και εκλογή κινητήρων

Έχοντας πλέον τη συνολική εκτιμώμενη μάζα της πλατφόρμας V.L.A.D., για να κλείσει το κεφάλαιο του προκαταρτικού σχεδιασμού, πρέπει να επιλεχθούν κινητήρες για τη κύρια ερπύστρια αλλά και για τους βραχίονες. Αρχικά πρέπει να γίνει εκτίμηση της απαιτούμενης ροπής για τους δύο κινητήρες. Σχετικά με τον κινητήρα της κύριας ερπύστριας, αυτός θα πρέπει να είναι ικανός για εκκίνηση σε κεκλιμένο επίπεδο. Πιο συγκεκριμένα της μέγιστης εκλεγμένης γωνίας κεκλιμένου a = 50◦


Σχήμα 2.55: Υπολογισμός ροπής κινητήρα κύριας ερπύστριας.

Για να υπολογιστεί η ροπή, απαιτείται ο γεωμετρικός ορισμός των οδοντοκινήσεων. Ορίζοντας αρχικά, τη διάμετρο του τροχού κίνησης της ερπύστριας Ds = 130 mm και υποθέτοντας μια ταχύτητα ως στόχο της πλατφόρμας στα V = 200mm/s, μπορούν να υπολογιστούν μερικά γεωμετρικά μεγέθη παρακάτω.
Ορίζεται επίσης η κύρια διάμετρος της οδοντοκίνησης του οδοντωτού τροχού της ατράκτου DG = 46 mm και η απόσταση των κέντρων του ατέρμονα και του γραναζιού ως C = 29 mm. Θεωρώντας μία οδόντωση με μία εκκίνηση για τον ατέρμονα NW = 1 και ένα βήμα για την οδόντωση του γραναζιού pG = 0.61 teetℎ/mm, προκύπτει ο αριθμός δοντιών του τροχού:
NG = ROUND(pG · D2) | (2.4)

Επίσης, από την απόσταση των κεντρών μπορεί να προκύψει η κύρια διάμετρος της οδόντωσης του ατέρμονα:

DW = 2 · C − DG | (2.5)

Το αξονικό βήμα του ατέρμονα είναι:

px = π ·

D2 NG | (2.6)

Μπορεί λοιπόν να προκύψει η γραμμική απόσταση που διανύει ένα σημείο σε πλήρη περιστροφή του ατέρμονα (πρόωση):
Lx = px · NW | (2.7)

Έτσι, προκύπτει η γωνία ελίκωσης του ατέρμονα:

λ = arctan(

Lx
π · DW
) | (2.8)

Στη συνέχεια, προκύπτει η κάθετη γωνία πίεσης της οδόντωσης ακολουθώντας τις συστάσεις του συγγράματος των Shigley J. κ.ά. [14] για την επιλογή της φn συναρτήσει της γωνίας ελίκωσης με σκοπό την αποφυγή του φαινομένου της υποκοπής:

φn =

{
20◦

if λ < 30◦
25◦
if 30◦ ≤ λ ≤ 45◦ | (2.9)

Τέλος, πρέπει να υπολογιστεί ο συντελεστής τριβής. Με την υπόθεση της ταχύτητας μπορεί να προκύψει η περιστροφική ταχύτητα του τροχού:

nG = 60

V
π · DG

(2.10)

Έχοντας τον αριθμό των δοντιών της συγκεκριμένης οδοντοκίνησης μπορεί να προκύψει η σχέση μετάδοσης που προκύπτει ξέροντας ότι ο κινητήριος τροχός είναι ο ατέρμονας:

iD =

DG
DW

(2.11)

Μέσω της σχέσης μετάδοσης υπολογίζεται πλεόν η περιστροφική ταχύτητα του ατέρμονα:

nW = nG · iD | (2.12)

Και έτσι προκύπτει η ταχύτητα ολίσθησης της οδοντοκίνησης ως:

VW =

DW · nW · π
60

(2.13)

Vs =

VW
cosλ | (2.14)

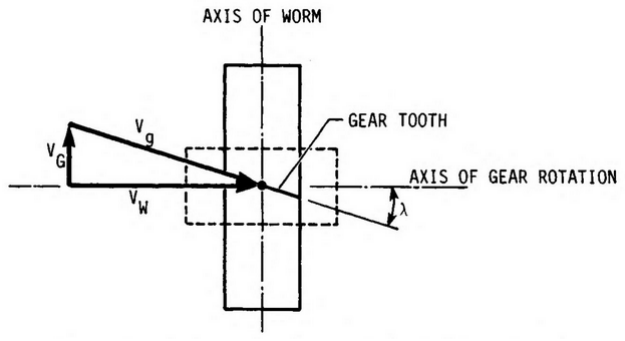
[picture p155: figure]

Σχήμα 2.56: Συνιστώσες ταχύτητας σε μια οδοντοκίνηση ατέρμονα - τροχού.

Έχοντας πλέον τη ταχύτητα ολίσθησης μπορεί να υπολογιστεί ο συντελεστής τριβής της οδοντοκίνησης από το Σχ. 2.57.

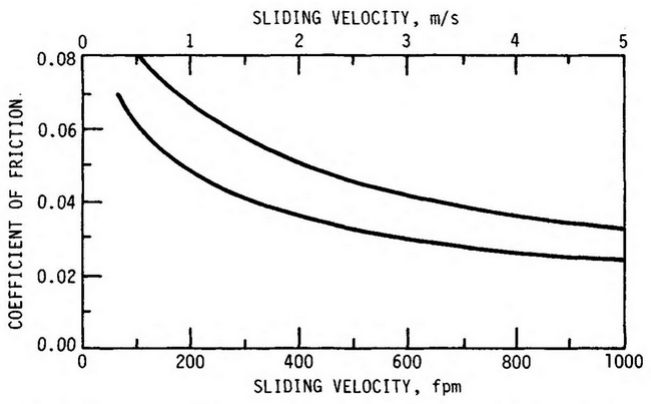
[picture p156: figure]

Σχήμα 2.57: Συντελεστής τριβής συναρτήσει της ταχύτητας ολίσθησης. Θεωρείται επαρκής λίπανση. Η άνω καμπύλη αναφέρεται σε μη επισκληρημένα υλικά οδοντώσεων ενώ η κάτω σε βέλτιστα υλικά οδοντοκίνησης ατέρμονα - τροχού [14].

Υπολογίζεται τελικά παρακάτω η αποδοτικότητα της οδοντοκίνησης:

ηD =

cosφn − μ · tanλ
cosφn + μ · cotλ | (2.15)

Από το Σχ. 2.55, προκύπτει ότι η απαιτούμενη δύναμη ώθησης του κινητήρα για εκκίνηση σε κεκλιμένο επίπεδο, θεωρώντας πολύ μικρή επιτάχυνση της πλατφόρμας, είναι:

FW = Wtot · sina | (2.16)
FFr = μa · Wtot · cosa | (2.17)
Ftrac = FFr + FW | (2.18)
| (2.19)

Όπου, μa είναι ο συντελεστής τριβής της ασφάλτου με το υλικό του πέλματος της ερπύστριας (Rubber), και Wtot, το συνολικό βάρος της κατασκευής. Επομένως, η απαιτούμενη ροπή του κινητήρα της ερπύστριας υπολογίζεται μέσω της απαιτούμενης ροπής της ατράκτου TD = Ftrac ·

Ds
2

και της σχέσης μετάδοσης της οδοντοκίνησης:

TMD =

Ftrac · Rs iD · ηD | (2.20)

Με εντελώς όμοιο τρόπο, προκύπτουν και η σχέση μετάδοσης iF και απόδοσης ηF της οδοντοκίνησης του βραχίονα, θεωρώντας, C = 32.5 mm, DG = 50 mm, pG = 0.5 teetℎ/mm, nW = 1. O κινητήρας του βραχίονα θα πρέπει να είναι ικανός να ανασηκώσει το βάρος του διασώστη από μηδενική γωνία του βραχίονα με το έδαφος. Όταν δηλαδή ο βραχίονας προσπαθεί να ανασηκώσει τη πλατφόρμα όντας πλήρως επιμηκυνμένος.


Σχήμα 2.58: Υπολογισμός ροπής κινητήρα βραχίονα.

Από το νόμο των συνημιτόνων:
sinφ

lBtot

=

sinθ

lFtot

(2.21)

Προκύπτει εν τέλει απαιτούμενη ροπή της ατράκτου του βραχίονα:

TF = wF · cosθ · lF + wF · sinφ · ℎF + wB · cosθ · lB − wB · sinθ · ℎB + μ · wF · cosφ · lFtot − μ · wB · cosφ · lBtot | (2.22)

Επομένως, υποθέτοντας πολύ μικρή γωνιακή επιτάχυνση η απαιτούμενη ροπή του κινητήρα προκύπτει:

TMF =

TF

iF · ηF

(2.23)

Στον Πίν. 2.7 φαίνονται οι υπολογισμοί για τις απαιτούμενες ροπές των κινητήρων. Με βάση τα παρακάτω επιλέγονται κινητήρες από την MAXON που ικανοποιούν τόσο τις απαιτήσεις χώρου αλλά και τις απαιτήσεις ροπής. Τα μοντέλα που επιλέχθηκαν είναι οι κινητήρες συνεχούς ρεύματος EC-i 579165 52 και EC-i 666603 40 για την ερπύστρια και τον βραχίονα αντίστοιχα.

Variable | Symbol | Calculation
Tracks Gear Interface
Worm Pitch Diameter | D W [mm] T | 12
Worm Lead Angle | ◦ λ T [ ] | 7.8
Tracks Gear Ratio | iD | 28
Tracks Gear Efficiency | ηD [%] | 60.94

Flipper Gear Interface
Worm Pitch Diameter | W [mm] F D | 15
Worm Lead Angle | F [ ◦ ] λ | 7.59
Tracks Gear Ratio | iF | 25
Tracks Gear Efficiency | ηF [%] | 63.52

Motors Torque
Main Shaft Torque Required | TD [Nm] | 6.203
Tracks Motor Torque Required | TMD [Nm] | 0.364
Flipper Shaft Torque Required | TF [Nm] | 3.375
Flipper Motor Torque Required | TMD [Nm] | 0.213

Πίνακας 2.7: Υπολογισμοί απαιτούμενης ροπής κινητήρων.

Υπολογίζοντας ένα περιθώριο ασφάλειας για τον κάθε κινητήρα ως:

MoS [%] =

Nominal Motor Torque
Required Torque | − 1 | (2.24)

Πλέον, τα βάρη των κινητήρων προσθέτονται στο ισοζύγιο μάζας για τη τελικό υπολογισμό του βάρους της πλατφόρμας, το οποίο καταλήγει όπως αναγράφεται στον πίνακα Πίν. 2.6.
Τέλος, για τον κινητήρα της κάμερας, καθώς δεν υπάρχει απαίτηση στη ροπή, επιλέγεται ένας βηματικός κινητήρας τύπου NEMA 11 τεσσάρων φάσεων. Αυτός έχει ικανοποιητική ροπή για να περιστρέψει το βάρος της κάμερας και απαιτεί τυπική επιλογή σε παρόμοιες εφαρμογές.
Part Number | Shell Diameter | Wattage | Max Continuous Torque | Nominal Speed | MoS
EC-i 579165 52 | ∅52 mm | 180 W | 0.423 Nm | 4470 rpm | 16%
EC-i 666603 40 | ∅40 mm | 130 W | 0.343 Nm | 3910 rpm | 46%

Πίνακας 2.8: Επιλεγμένοι κινητήρες συνεχούς ρεύματος της πλατφόρμας V.L.A.D.

### 2.4.2 Σχεδιασμός κυκλώματος ηλεκτρονικών

Έχοντας πλέον αποφασίσει περί των κινητήρων, σειρά έχει ο σχεδιασμός του κυκλώματος των ηλεκτρονικών. Το μέρος αυτό ξεφεύγει των στόχων μιας γενικότερης προκαταρτικής σχεδιαστικής πρότασης, ωστόσο επιλέγεται να πραγματοποιηθεί για τη παράδοση μιας πιο ολοκληρωμένης πλατφόρμας.
Πριν την επιλογή των ηλεκτρονικών εξαρτημάτων, πρέπει να βελτιστοποιηθεί το σύστημα καταγραφής CO2. Καθώς οι περισσότεροι αισθητήρες καταγραφής κατέχουν σχετικά αργή απόκριση, και εφόσον οι απαιτήσεις του σχεδιασμού θα προϋπόθεταν μικρή σταθερά χρονοκαθυστέρησης του συστήματος για ημι-αυτόνομη λειτουργία, επιλέγεται να χρησιμοποιηθούν ένα ζεύγος αισθητήρων με ταχεία απόκριση και ένα ζεύγος με τυπική απόκριση. Το ζεύγος ταχείας απόκρισης θα τοποθετηθεί μπροστά και πίσω στο σώμα της πλατφόρμας ενώ το άλλο στα πλάγια. Αρχικά, επιλέγονται οι οδηγοί των κινητήρων. Για τον κινητήρα της κάμερας, θα επιλεχθεί τυπική πλακέτα οδήγησης τύπου A4988. Όλοι οι οδηγοί επιλέγονται με βάση το απαιτούμενο ρεύμα λειτουργίας των κινητήρων. Για τους κινητήρες της MAXON δίνεται ο χάρτης λειτουργίας του κινητήρα. Επιλέγοντας το σημείο λειτουργίας (Πίν. 2.8), προκύπτει η ταχύτητα περιστροφής και το ρεύμα λειτουργίας του κάθε κινητήρα.


(αfl) Κινητήρας ερπύστριας EC-i 579165 52. | (βfl) Κινητήρας βραχίονα EC-i 666603 40.

Σχήμα 2.59: Χάρτες λειτουργίας κινητήρων συστήματος κίνησης.

Από τους παραπάνω χάρτες προκύπτει ότι τα ρεύματα λειτουργίας των κινητήρων είναι αρκετά υψηλά. Έτσι, είναι αναγκαία η χρήση οδηγού υψηλών προδιαγραφών τόσο για το επιτρεπόμενο ρεύμα οδήγησης όσο και για την επιτρεπόμενη τάση οδήγησης. Η τάση οδήγησης και των δύο κινητήρων του συστήματος κίνησης είναι στα 48 V. Επομένως, για τους πιο απαιτητικούς κινητήρες του συστήματος κίνησης διαλέγονται οι οδηγοί ODrive S1. Αντίστοιχα, για τον κινητήρα περιστροφής της κάμερας, επιλέγεται από το φύλλο δεδομένων του επιλεγμένου NEMA 11, το ρεύμα λειτουργίας του. Ο οδηγός A4998 είναι ικανός για οδήγηση κινητήρα έως 2 A ενώ το NEMA 11 11HS3410 που επιλέγεται κινείται με 0.1 A.
Με τους κινητήρες επιλεγμένους, σειρά έχει ο εγκέφαλος της πλατφόρμας. Για αυτή τη χρήση επιλέγεται μια τυπική πλακέτα μικροεπεξεργαστή Raspberry Pi 5, για την οδήγηση των κινητήρων και την επικοινωνία με τον σταθμό χειρισμού του διασώστη. Προφανώς, λόγω των υψηλών απαιτήσεων της αποστολής και του μεγάλου πλήθους δεδομένων που θα κληθεί να διαχειριστεί η πλακέτα RPi5, θα χρειαστεί και ψύκτρα για τη διασφάλιση της ορθής λειτουργίας της. Για τη σύνδεση της πλακέτας με τους οδηγούς των κινητήρων, ακολουθούνται οι οδηγίες των φύλλων οδηγιών των οδηγών (Σχ. 2.60).

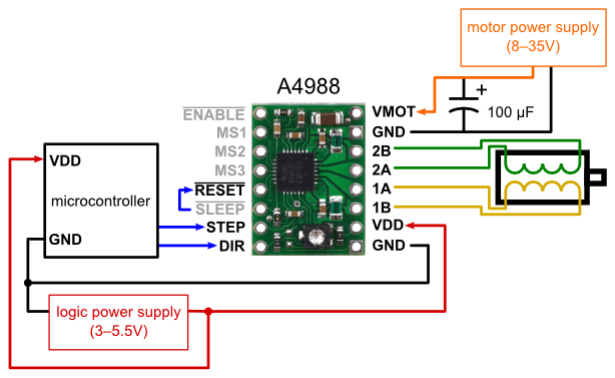
[picture p157: figure]

(αfl) ODrive S1. | (βfl) A4998.
| Σχήμα 2.60: Συνδεσμολογία οδηγών κινητήρων.

Όπως φαίνεται, προτείνεται η χρήση απομονωτή στο κύκλωμα του οδηγού ODrive S1. Αυτός επιλέγεται επίσης από την εταιρία της ODrive και επιλέγεται σύνδεση USB μεταξύ του επεξεργαστή και του οδηγού. Θα πρέπει επίσης να επιλεχθούν και μετατροπείς υποβιβασμού τάσης (Buck Converters). Ένας εξ αυτών θα πρέπει να δέχονται τάση στα 48V, όσο και οι κινητήρες που τροφοδοτούνται μέσω του οδηγού ODrive S1, και να υποβιβάζει τη τάση στα 5V για τη τροφοδοσία του RPi5 και του NEMA 11. Επίσης, ένας άλλος θα πρέπει να τροφοδοτεί το λογικό κύκλωμα του οδηγού AA998, που είναι προδιαγραφόμενο στα 3.3V.
Η κάμερα και το LiDAR, φέρουν καλώδιο USB για τη σύνδεση κατευθείαν στο RPi5. Αντίστοιχα, όλοι οι απομονωτές θα πρέπει να συνδέονται με USB. Για τη διασφάλιση αρκετών θυρών θα χρησιμοποιηθεί και USB Hub. Οι αισθητήρες καταγραφής CO2 και τα επιταχυνσιόμετρα συνδέονται στις GPIO υποδοχές του RPi5. Για τα μικρόφωνα, θα χρησιμοποιηθεί κάψουλα μικροφώνου, κολλημένη σε καλώδιο τύπου Jack ενώ η σύνδεση με το RPi5 θα γίνει μέσω κάρτας ήχου Jack-USB. Τέλος, ο αισθητήρας IMU θα επικοινωνεί μέσω πρωτοκόλου I2C με τη πλακέτα του επεξεργαστή. Προφανώς σχεδιάζεται κοινή γραμμή γείωσης για το σύστημα. Όλοι οι επιλεγμένοι αισθητήρες φαίνονται παρακάτω.
Για την επικοινωνία με το σταθμό χειρισμού, επιλέγεται κεραία και πρωτόκολλο Wi-Fi. Χρησιμοποιώντας έναν κεντρικό υπολογιστή (Laptop) με λειτουργικό Linux OS, η πλακέτα RPi5 στη πλατφόρμα θα αποτελεί και Wi-

Fi Host για την επικοινωνία laptop και ρομπότ. Για την μεταφορά των δεδομένων από τους αισθητήρες στον υπολογιστή αλλά και για τον απομακρυσμένο χειρισμό του V.L.A.D. θα επιλεχθεί να στηθεί σύστημα επικοινωνίας ROS. Το λογικό κύκλωμα των ηλεκτρονικών φαίνεται στο Σχ. 2.61.


Σχήμα 2.61: Κύκλωμα ηλεκτρονικών.

Πλέον με την επιλογή των κινητήρων και του σημείου λειτουργίας, μπορεί να υπολογιστεί και η πραγματική ταχύτητα της πλατφόρμας. Στο σημείο λειτουργίας του κινητήρα της ερπύστριας και μέσω της σχέσης μετάδοσης της οδοντοκίνησης όπως προέκυψε προηγουμένως, η ταχύτητα του V.L.A.D. είναι V = 1.08 m/s.

Actuators
Usage | Type | Nominal Voltage [V] | Nominal Amperage [A]
Flipper | 3P BLDC | 48 | 3.87
Tracks | 3P BLDC | 48 | 4.59
Camera | 4P Stepper | 3.6 | 0.1
Drivers
Usage | Type | Logic Voltage [V] | Nominal Output Amperage [A]
Flipper | ODrive S1 | From RPi5 | 40
Tracks | ODrive S1 | From RPi5 | 40
Camera | A4998 | 5V | 2
Sensors
Usage | Module | Logic Voltage [V] | Response Time [s]
CO2 Fast | K30 | 5 | 2
CO2 Slow | MG-811 | 5 | <20
Usage | Module | Logic Voltage [V] | Nominal Amperage [A]
IR Camera | Waveshare ESP32-S3 IR | 3.7 | 0.13
IMU | Waveshare 10 DOF | 3.7 | 0.005
Accelerometer | ATO-SADR301 | 3.7 | 0.005
LiDAR | WayPonDEV S2P | 5 | 0.005
Microphone Capsule | ECM-715N | 1.5 | 0.005
Rest
Usage | Module | - | -
MCU | Raspberry Pi 5 | - | -
MCU Cooler | Raspberry Pi 5 | - | -
MCU | Raspberry Pi Cooler | - | -
Step Down 5V | Polulu D42V110F5 | - | -
Step Down 3.3V | Polulu D36V28F3 | - | -
USB Dock | Generic 4 port dock | - | -
Sound Card | Generic Jack (F) - USB (M) | - | -
Wi-Fi Antenna | RTL8192cu for RPi5 | - | -
ODrive Isolator | ODrive Isolator for S1 | - | -

Πίνακας 2.9: Ισοζύγιο ισχύος.

### 2.4.3 Επιλογή μπαταριών και εκτίμηση χρόνου λειτουργίας

Η επιλογή της κατάλληλης πηγής ενέργειας δεν είναι καθόλου αμελητέα — είναι βασικό θέμα για τον σχεδιασμό ενός αυτόνομου ρομποτικού συστήματος διάσωσης, γιατί καθορίζει άμεσα την επιχειρησιακή εμβέλεια και πόσο θα διαρκέσει μια αποστολή. Σύμφωνα με τον Πίν. 2.9 μπορεί να προκύψει η συνολική ζήτηση ρεύματος του συστήματος σε συνεχή κατάσταση λειτουργίας.
Από τις επιλογές στοιχείων μπαταρίας, προκρίθηκε η τεχνολογία Ιόντων Λιθίου (Lithium-Ion) και συγκεκριμένα στοιχεία τύπου 18650. Αυτή η τεχνολογία δίνει τον καλύτερο συμβιβασμό ανάμεσα σε χωρητικότητα, βάρος και ασφάλεια, ενώ επίσης διατηρεί σχετικά σταθερή τάση εκφόρτισης. Για να πετύχουμε τα επιθυμητά ηλεκτρικά χαρακτηριστικά, τα μεμονωμένα στοιχεία οργανώνονται σε μια συστοιχία (battery pack) με μικτή συνδεσμολογία. Η διάταξη καθορίζεται κυρίως από δύο παραμέτρους: την απαιτούμενη τάση λειτουργίας (V) για να δουλεύουν σωστά οι οδηγοί των κινητήρων, και την επιθυμητή χωρητικότητα (Ah) που καθορίζει την αυτονομία. Καταλαβαίνετε, δεν είναι μόνο αριθμοί — έχει και πρακτική πλευρά. Συγκεκριμένα, επιλέγεται η σύνδεση S στοιχείων σε σειρά (series) για να αυξηθεί η τάση στα 48 V, και P παράλληλων κλάδων (parallel) για να πολλαπλασιαστεί η χωρητικότητα και το μέγιστο συνεχές ρεύμα εκφόρτισης. Η τελική διαμόρφωση της συστοιχίας περιορίζεται και επίσης από τη χωροταξική τοποθέτηση της στο σώμα της πλατφόρμας.
Υποθέτοντας συνεχή λειτουργία όλων των ηλεκτρονικών, πράγμα που στη πράξη δεν συμβαίνει, μπορεί να υπολογιστεί ο χρόνος λειτουργίας της πλατφόρμας πριν την επαναφόρτιση. Κανονικά, θα πρέπει να οριστούν κύκλοι λειτουργίας της πλατφόρμας και με βάση αυτούς να υπολογιστεί η απαιτούμενη χωρητικότητα της μπαταρίας. Θεωρώντας όμως το πιο συντηρητικό σενάριο υπολογισμού, δηλαδή αυτό σε συνθήκες μέγιστης καταπόνησης, επιλέγεται να υπολογιστεί με αυτόν τον τρόπο ο χρόνος λειτουργίας. Το σύστημα μπαταριών που επιλέγεται αποτελείται από 3 στοιχεία παράλληλα με 5000 mAℎ το κάθε ένα και 13 στοιχεία σε σειρά με 3.7 V έκαστο. Η συνολική ισχύς της μπαταρίας είναι 48 V και 15 Aℎ. Έτσι μπορεί να προκύψει ο χρόνος λειτουργίας της πλατφόρμας:

OT =

Battery Capacity
Total Continuous Current Consumtion | (2.25)

Τελικά προκύπτει ο χρόνος λειτουργίας της πλατφόρμας OT = 0.72 h ή OT = 43 min έως την ανάγκη φόρτισης της. Ο παραπάνω χρόνος είναι ικανοποιητικός για το σκοπό της αποστολής, δηλαδή την έρευνα και ανίχνευση θυμάτων μετά από καταστροφές. Μετά τον χρόνο αυτό χρειάζεται η αλλαγή μπαταρίας ή φόρτιση του διασώστη. Για διευκόλυνση και επέκταση του πραγματικού χρόνου της αποστολής, προτείνεται ο σχεδιασμός ώστε η αλλαγή της μπαταρίας να καθίσταται εύκολη. Αυτό μπορεί να γίνει με την εισαγωγή καταπακτής στο πάτο του σώματος της πλατφόρμας για τοποθέτηση της μπαταρίας από την κάτω πλευρά του V.L.A.D.

# Κεφάλαιο 3

# Διαμορφωτικός Σχεδιασμός

## 3.1 Σκοπός διαμορφωτικού σχεδιασμού

Το στάδιο του προκαταρκτικού σχεδιασμού αποτελούσε τη θεμελίωση του εγχειρήματος, όπου πραγματοποιήθηκε η δόμηση της κεντρικής ιδέας και ο καθορισμός των βασικών αρχών λειτουργίας του ρομπότ. Σε εκείνο το στάδιο, ο στόχος δεν ήταν η λεπτομέρεια, αλλά η απόδειξη της σκοπιμότητας της λύσης. Οι υπολογισμοί που εκπονήθηκαν είχαν χαρακτήρα εκτίμησης της τάξης μεγέθους, στοχεύοντας να αποδείξουν ότι η προτεινόμενη αρχιτεκτονική είναι φυσικά και τεχνικά υλοποιήσιμη.
Πλέον, ακολουθεί το στάδιο του διαμορφωτικού σχεδιασμού, το οποίο αποτελεί τη γέφυρα μεταξύ της θεωρητικής σύλληψης και της κατασκευαστικής πραγματικότητας. Σε αυτή τη φάση, η αρχική ιδέα μετουσιώνεται σε μια πλήρως ορισμένη μηχανολογική οντότητα. Οι προσεγγιστικές τιμές του προηγούμενου σταδίου αντικαθίστανται από ακριβείς διαστάσεις και αυστηρές ανοχές, καθώς εκπονούνται λεπτομερή κατασκευαστικά σχέδια και τρισδιάστατα μοντέλα (CAD). Παράλληλα, οι μαθηματικοί υπολογισμοί παύουν να είναι διερευνητικοί και γίνονται επιβεβαιωτικοί: στόχος είναι η πλήρης εξακρίβωση της μηχανικής αντοχής και της αξιοπιστίας της κατασκευής υπό τις πραγματικές συνθήκες φόρτισης που θα αντιμετωπίσει στο πεδίο. Μέσω αυτής της διαδικασίας, διασφαλίζεται ότι το τελικό σύστημα δεν είναι απλώς μια λειτουργική ιδέα, αλλά μια στιβαρή κατασκευή ικανή να ανταπεξέλθει στις απαιτήσεις της αποστολής διάσωσης.
Στην παρόν έρευνα, όπως έχει ήδη αναφερθεί, ο ολοκληρωμένος διαμορφωτικός σχεδιασμός αποτελεί έναν στόχο με χρονική διάρκεια ολοκλήρωσης πολύ μεγαλύτερη της επιθυμητής. Επομένως, καθώς ξεφεύγει των ενδιαφερόντων της παρόν εργασίας, θα πραγματοποιηθούν μετρημένες μελέτες των μηχανολογικών εξαρτημάτων για τη παρουσίαση μιας πιο ολοκληρωμένης σχεδιομελέτης. Στη πραγματικότητα, κατά αυτό το στάδιο, πρέπει να ορισθούν επακριβώς, η αρχιτεκτονική και το λειτουργικό σύστημα της πλατφόρμας, καθιστόντας την ικανή να ανταπεξέλθει τις συνθήκες μιας αποστολής διάσωσης. Ωστόσο, οι στόχοι του διαμορφωτικού σχεδιασμού στο παρόν πλαίσιο θα είναι:
- Η ανάλυση της οδοντοκίνησης, τόσο γεωμετρικά όσο και λειτουργικά, για τις οδοντοκινήσεις του βραχίονα και της ερπύστριας. Θα ορισθεί επακριβώς η γεωμετρία των οδοντώσεων και θα εκλεθούν οι συντελεστές ασφαλείας της εφαρμογής.
- Η ανάλυση της λειτουργικότητας των μηχανολογικών εξαρτημάτων του συστήματος κίνησης. Θα αναλυθούν επακριβώς οι τρόποι με τους οποίους, τα επιλεγμένα μηχανολογικά εξαρτήματα λειτουργούν στην πλατφόρμα.
- Η ανάλυση των εδράνων κύλισης όσο αναφορά την αντοχή των εδράσεων. Θα αναλυθούν λειτουργικά οι εδράσεις των ατράκτων των ατέρμονων κοχλιοειδών τροχών. Οι περαιτέρω εδράσεις δεν θα αναλυθούν με βάση την αντοχή τους.
- Η επεξήγηση της επικοινωνίας της πλατφόρμας με το σταθμό τηλεχειρισμού και η πρόταση μιας λύσης που ικανοποιεί τις απαιτήσεις της αποστολής.

Να σημειωθεί ότι, οι οδονοτοκινήσεις θα επιλυθούν αρχικά γεωμετρικά, και έπειτα θα ορισθούν κατάλληλα για να ικανοποιούν επαρκείς συντελεστές ασφαλείας. Τα έδρανα κύλισης δε θα αναλυθούν όλα, καθώς η επίλυση όλων των εδράσεων θεωρείται ότι ξεφεύγει του χρονικού πλαισίου εκπόνησης της παρόν εργασίας. Επομένως, για εξακρίβωση και ορθή υλοποίηση όλου του συστήματος της οδοντοκίνησης, επιλέγεται να επιλυθούν τουλάχιστον οι εδράσεις στο συγκεκριμένο υποσύστημα.

## 3.2 Ανάλυση μηχανολογικών στοιχείων

### 3.2.1 Ανάλυση οδοντωτών τροχών

Όπως έχει ήδη αναλυθεί και σε προηγούμενα κεφάλαια, μερικά βασικά γεωμετρικά στοιχεία των οδοντοκινήσεων ήταν απαραίτητο να ορισθούν πριν το στάδιο του διαμορφωτικού σχεδιασμού για την επιλογή των κινητήρων της πλατφόρμας. Αυτά τα στοιχεία φαίνονται στον Πίν. 2.7. Με βάση αυτά θα πρέπει να υπολογιστούν και μερικά ακόμη γεωμετρικά χαρακτηριστικά. Αυτά θα υπολογσιτούν τόσο για την οδοντοκίνηση της ερπύστριας όσο και του βραχίονα. Στη συνέχεια, σε παρακάτω κεφάλαια, θα εισαχθούν τα μεγέθη αυτά στο λογισμικό υπολογισμού αντοχής γραναζιών KISSsoft 2025 Student Version. Παρακάτω παρατηρούνται μερικά βασικά γεωμετρικά μεγέθη.


Σχήμα 3.1: Γεωμτρικές διαστάσεις οδοντοκίνησης ατέρμονα - τροχού [15].

Αρχικά πρέπει να υπολογιστεί το αξονικό μέτρο οδόντωσης. Αυτό, σύμφωνα με τις αναλυτικές σχέσεις της αναφοράς [14] προκύπτει:

mx =

px

π

(3.1)

Έπειτα, πρέπει να υπολογιστεί το ύψος της κεφαλής του δοντιού. Αυτό είναι:

a = 0.3183 · px | (3.2)

Ο οδοντωτός τροχός σε μια οδοντοκίνηση ατέρμονα - τροχού, κατεργάζεται με ακτίνα καμπυλότητας κατά το μήκος του δοντιού για τη σωστή εφαρμογή του με τον ατέρμονα. Η ακτίνα αυτή προκύπτει με βάση τη διάμετρο λειτουργίας του ατέρμονα όπως δίνεται στην αναφορά [15] καθώς το βιβλίο των Shigley J. κ.ά. δεν αναγράφει κάποια αναλυτική σχέση για τον υπολογισμό της. Έτσι υπολογίζεται επίσης και η διάμετρος του λαιμού του γραναζιού:

rc =

DW
2
− a | (3.3)
Dt,g = DG + 2 · a | (3.4)

Στη συνέχεια υπολογίζεται το ενεργό ύψος της οδόντωσης:

ℎk = 0.6366 · px | (3.5)

Χρειάζεται να υπολογιστούν και τα πλάτη των οδοντωτών τροχών. Για τον ατέρμονα υπολογίζεται το ελάχιστο μήκος του. Το μήκος δηλαδή που κατεργάζεται η οδόντωση στην άτρακτο του:

f = 2 ·

√(

Dt,g
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
(3.6)

Αντίστοιχα, για τον τροχό, υπολογίζεται το ενεργό πλάτος ως:

Fe =

√

(DW + ℎk)

2 − a
2
(3.7)

Τέλος, υπολογίζεται και η εξωτερική διάμετρος του τροχού στο χείλος του δοντιού σύμφωνα με τις εξισώσεις για σύστημα αξονικού μέτρου [15]:
Da,2 = DG + 2 · a + mx | (3.8)

Με βάση όλα τα παραπάνω υπολογίζονται στον Πίν. 3.1 τα γεωμετρικά χαρακτηριστικά των οδοντώσεων των ζεύγων ατέρμονα - τροχού για το βραχίονα και την ερπύστρια.

Characteristic | Units | TRACKS | FLIPPER
i | − | 28 | 25
C | mm | 29 | 32.5
px | mm | 5.161 | 6.283
λ | ◦ | 7.8 | 7.59
φn | ◦ 20
mx | mm | 1.643 | 2.00
a | mm | 1.643 | 1.999
rc | mm | 4.38 | 5.50
Dt,g | mm | 49.29 | 54.00
ℎk | mm | 3.28 | 3.99
f | mm | 48.41 | 53.14
Fe | mm | 9.47 | 11.66
Da,2 | mm | 50.93 | 55.99

Πίνακας 3.1: Αναλυτικά γεωμετρικά χαρακτηριστικά οδοντοκινήσεων ερπύστριας και βραχίονα.

### 3.2.2 Λοιπά μηχανολογικά στοιχεία

Σχετικά με υπόλοιπα μηχανολογικά στοιχεία του συστήματος κίνησης, θα παρουσιαστούν οι επιλογές των εδράνων κύλισης του συτήματος και οι επιλογές και ο τρόπος λειτουργίας των περικοχλιών ατράκτου. Αναφορικά με τους κοχλίες του συστήματος, δε θα γίνει κάποια αναφορά σε αυτούς καθώς έχουν επιλεγεί αυθαίρετα. Αρχικά, όπως φαίνεται και στα Σχ. 2.41, Σχ. 2.43, Σχ. 2.42, Σχ. 2.44, τα έδρανα που χρησιμοποιήθηκαν είναι από τον κατάλογο της SKF. Δύο εδράσεις στηρίζουν την κάθε άτρακτο του συστήματος. Χρησιμοποιούνται αποκλειστικά σφαιρικά έδρανα κύλισης (deep groove ball bearings) που ικανοποιούν τους περιορισμούς των διαστάσεων του σχεδιασμού. Παρακάτω στον Πίν. 3.2 φαίνονται αναλυτικά τα επιλεγμένα ρουλεμάν για τη κατασκευή καθώς και τα χαρακτηριστικά τους και οι διαστάσεις τους στη μορφή Bore/Outer/Widtℎ.

Bearing | Usage | Dimensions [mm] | C0 [kN] | C [kN] | Mass [g]
61804 | Fixed main/back shaft | 20/32/7 | 2.32 | 4.03 | 18
61809 | Non-locating flipper shaft | 45/58/7 | 4 | 5.4 | 38
61903 | Fixed main/back shaft shaft | 17/30/7 | 2.55 | 4.62 | 15
W 61704 | Non-locating main shaft | 20/27/4 | 0.39 | 0.585 | 6
618/8 | Indirect secondary shaft | 8/16/4 | 0.3 | 0.819 | 3
W 636 | Non-locating worm shaft | 6/22/7 | 0.78 | 1.99 | 13.6
W 607 | Fixed worm shaft | 7/19/6 | 0.585 | 1.53 | 7

Πίνακας 3.2: Έδρανα κύλισης συστήματος κίνησης.

Όπως αναφέρθηκε, θα αναλυθούν τα έδρανα κύλισης που εδράζουν στην άτρακτο των ατέρμονων κοχλιών. Αυτά είναι τα W 636 και W 607, όπως φαίνεται και παραπάνω. Το δεξί έδρανο W 607 είναι το σταθερό ενώ το W 636 είναι το κινητό σύμφωνα με το Σχ. 2.44. Για να αναλυθούν τα έδρανα πρέπει να αναλυθούν οι δυνάμεις που αυτά δέχονται.
Το σταθερό έδρανο θα είναι αυτό που παραλαμβάνει τα αξονικά φορτία του συστήματος, ενώ τα ακτινικά φορτία μοιράζονται στα δύο έδρανα ανάλογα με την απόσταση τους από το σημείο άσκησης των δυνάμεων αυτών. Αυτές οι δυνάμεις προέρχονται από την οδοντοκίνηση. Σύμφωνα με την [14], οι δυνάμεις σε μια οδοντοκίνηση ατέρμονα - τροχού μπορούν να αναλυθούν στις παρακάτω συνιστώσες.


Σχήμα 3.2: Ανάλυση δυνάμεων στην οδοντοκίνηση ατέρμονα - τροχού [14].

Προκύπτει ότι οι συνιστώσες υπολογίζονται ως:

Wx = W · (cosφnsinλ + μcosλ) | (3.9)
Wy = W · sinφn | (3.10)
Wz = W · (cosφncosλ − μsinλ) | (3.11)

Γίνεται εύκολα αντιληπτό ότι η αξονική φόρτιση των εδράνων είναι η Wz ενώ η ακτινική προκύπτει μέσω των άλλων δύο ως η υποτείνουσα του τριγώνου τους:

Fa = Wz | (3.12)

Fr =

√

W²

x + W² y | (3.13)

Ωστόσο, επειδή οι δυνάμεις δεν ασκούνται στον άξονα της ατράκτου αλλά σε απόσταση D/2 από τον κεντρικό της άξονα, θα πρέπει να εισαχθεί και μια διόρθωση λόγω των ροπών που δημιουργούν αυτές οι δυνάμεις ως προς το κέντρο της ατράκτου. Η κάθετη ακτινική δύναμη Wy, δε δημιουργεί κάποια ροπή καθώς διέρχεται από το κέντρο της ατράκτου, η εφαπτομενική συνιστώσα Wx, δημιουργεί ροπή που τείνει να περιστρέψει την άτρακτο γύρω από τον κεντρικό άξονα της. Τα ρουλεμάν δε αντιστέκονται σε αυτή τη κίνηση. Τέλος, η αξονική δύναμη Wz, δημιουργεί ροπή που καταπονεί τα έδρανα ακτινικά. Έτσι, αυτή πρέπει να ληφθεί υπόψη κατά τη διόρθωση των δυνάμεων στις εδράσεις. Επομένως έχουμε τη ροπή που δημιουργεί η αξονική δύναμη:

Mti p = Wz ·

D
2 | (3.14)

Η αντίστοιχη δύναμη διόρθωσης, λόγω της παραπάνω ροπής, στα έδρανα προκύπτει ως η δύναμη που χρειάζεται να προστεθεί στις αντιδράσεις για να ισσοροπήσει το ισοζύιγο δυνάμεων:

Fcorr =

Mti p
L

(3.15)

Όπου L, είναι η απόσταση από τα σημεία εφαρμογής των εδράνων κύλισης.

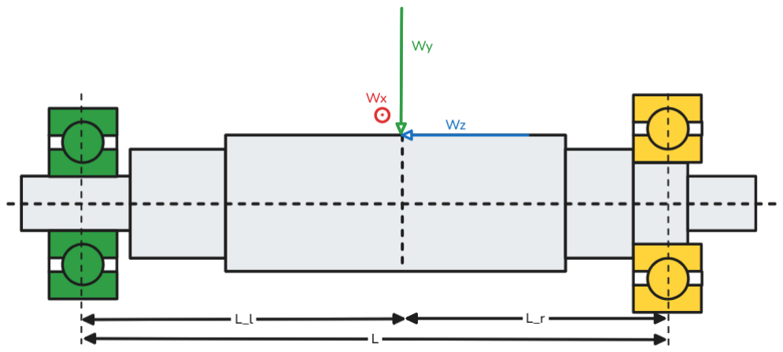
[picture p158: figure]

Σχήμα 3.3: Ανάλυση δυνάμεων εδράνων κύλισης ατράκτου ατέρμονα.

Η ακτινική δύναμη πρέπει να μοιραστεί και αυτή με βάση την απόσταση των εδράνων από το κέντρο εφαρμογής των δυνάμεων της οδοντοκίνησης. Αυτή αναλύεται ως εξής:

Frl = Fr ·

Lr
L

(3.16)

Frr = Fr ·

Ll
L

(3.17)

Προσθέτωντας και στα δύο έδρανα τη διόρθωση προκύπτει για τη συνολική ανάλυση:

Fa = Wz | (3.18)

Frl = Fr ·

Lr
L
+ Fcorr | (3.19)

Frr = Fr ·

Ll
L
+ Fcorr | (3.20)

Στη συγκεκριμένη οδοντοκίνηση, ισχύει ότι η αξονική συνιστώσα των δυνάμεων είναι:

Wx =

2 · TM D | (3.21)

Όπου TM η ροπή το εκάστοτε κινητήρα όπως φαίνεται στον Πίν. 2.8 και D η διάμετρος λειτουργίας του ατέρμονα κοχλία όπως υπολογίστηκε στον Πίν. 3.4. Έτσι, μπορούν εύκολα να προκύψουν όλες οι συνιστώσες των δυνάμεων της οδοντοκίνησης και κατ' επέκταση των εδράνων κύλισης στον Πίν. 3.6 και να επιλυθούν τα έδρανα στο λογισμικό KISSsoft.
Επίσης, τα περικόχλια ατράκτου, γίνονται και αυτά εμφανή από τα σκαριφήματα των υποσυστημάτων του συστήματος κίνησης. Όπως αναφέρθηκε αυτά επιλέχθηκαν από τον κατάλογο της McMaster και της MISUMI, όπως αυτά ικανοποιούν τις χωροταξικές απαιτήσεις της κατασκευής. Στον Πίν. 3.3 φαίνονται τα επιλεγμένα περικόχλια ατράκτου.
Lock Nut | Catalogue | Usage | Thread [mm] | Lock Type
3552N17 | McMaster-Carr | Fix 61804 bearing | M14 × 1 | Nylon insert grip
3552N19 | McMaster-Carr | Fix 61903 bearing | M15 × 1 | Nylon insert grip
BNG4 | MiSUMi | Tighten indirect bearing arrangement | M4 × 1 | Set screw and pin
BNG6 | MiSUMi | Fix W 607 bearing | M6 × 1 | Set screw and pin

Πίνακας 3.3: Περικόχλια ατράκτου συστήματος κίνησης.

Η πρώτη κατηγορία (τύπου McMaster Nylon Insert) αξιοποιεί τις ελαστικές ιδιότητες των πολυμερών για την επίτευξη αυτοασφάλισης. Τα συγκεκριμένα περικοχλία φέρουν ενσωματωμένο στο εσωτερικό τους έναν δακτύλιο από πολυαμίδιο, ο οποίος έχει εσωτερική διάμετρο ελαφρώς μικρότερη από αυτή του σπειρώματος της ατράκτου. Κατά τη βίδωμα, το σπείρωμα του άξονα εισέρχεται στο νάιλον ένθετο, προκαλώντας του ελαστική και εν μέρει πλαστική παραμόρφωση. Η ελαστική επαναφορά του υλικού ασκεί συνεχή ακτινική πίεση στα σπειρώματα, δημιουργώντας υψηλές δυνάμεις τριβής που αποτρέπουν την ακούσια χαλάρωση λόγω κραδασμών. Το πλεονέκτημα αυτής της μεθόδου είναι η στεγανοποίηση της σύνδεσης και η απορρόφηση των μικρο-δονήσεων, ενώ ταυτόχρονα αποφεύγεται η μεταλλική φθορά στην άτρακτο.
Η δεύτερη κατηγορία περικοχλίων (σειρά Misumi BNG) ενσωματώνει έναν μηχανισμό ασφάλισης που βασίζεται στην τριβή, χωρίς όμως να προκαλεί φθορά στο σπείρωμα του άξονα. Κάθε περικόχλιο φέρει στο σώμα του, κάθετα προς τον άξονα περιστροφής, έναν ή περισσότερους κοχλίες ακινητοποίησης (set screws). Η καινοτομία έγκειται στην παρεμβολή ενός μικρού κυλινδρικού παρεμβύσματος, κατασκευασμένου συνήθως από μαλακότερο μέταλλο, μεταξύ του κοχλία ακινητοποίησης και του σπειρώματος της ατράκτου. Κατά τη σύσφιξη του κοχλία ακινητοποίησης, η πίεση μεταφέρεται στο παρέμβυσμα, το οποίο πιέζει τα σπειρώματα της ατράκτου δημιουργώντας την απαραίτητη δύναμη συγκράτησης. Με αυτόν τον τρόπο επιτυγχάνεται ισχυρή ακινητοποίηση χωρίς ο χαλύβδινος κοχλίας να έρχεται σε άμεση επαφή με την άτρακτο, αποτρέποντας έτσι τον τραυματισμό των σπειρωμάτων

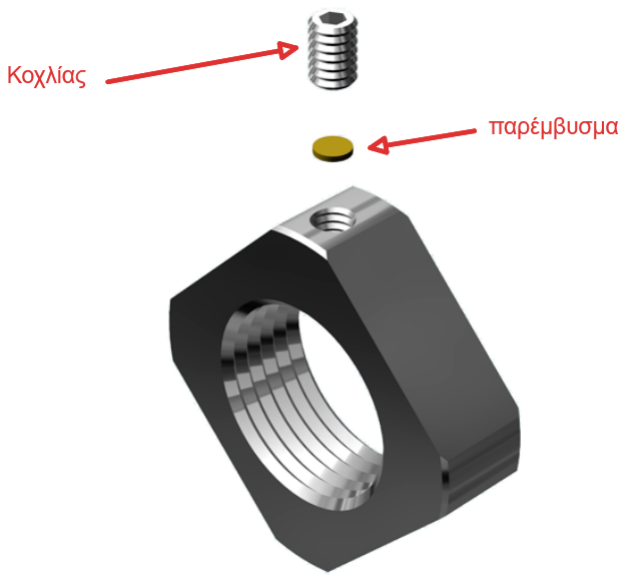
[picture p159: figure]

(αfl) Ασφάλιση με δακτύλιο πολυαμιδίου. | (βfl) Ασφάλιση με παρέμβυσμα.

Σχήμα 3.4: Τρόποι ασφάλισης περικοχλίων ατράκτου του συστήματος κίνησης.

## 3.3 Ανάλυση στοιχείων με χρήση λογισμικού

### 3.3.1 Εισαγωγή παραμέτρων και συντελεστές ασφαλείας οδοντοκίνησεων

Έχοντας υπολογίσει τα γεωμετρικά μεγέθη των οδοντωτών τροχών του συστήματος κίνησης, μπορούν να εισαχθούν οι παραπάνω μεταβλητές στο λογισμικό υπολογισμού αντοχής KISSsoft για υπολογισμό χεύγους ατέρμονα -τροχού (Worms with enveloping worm wheels). Αρχικά, στρογγυλοποιείται το αξονικό μέτρο οδόντωσης της οδοντοκίνησης της ερπύστριας σε mx = 1.65 mm. Έπειτα εισάγονται οι παράκτω παράμετροι ως δεδομένα στους πίνακες υπολογισμού:

- Αξονικό μέτρο οδόντωσης mx.
- Δόντια ατέρμονα και τροχού z1, z2.
- Γωνία πίεσης φn.

Μέσω των παραπάνω, και ορίζοντας την αξονική απόσταση των γραναζιών προκύπτουν αυτόματα η γωνίας ελίκωσης του ατέρμονα λ. Στη συνέχεια, υπολογίζονται τα πλάτη των γραναζιών ακολουθώντας τους τύπους του Niemann. Με βάση αυτούς προκύπτει αυτόματα από το λογισμικό ότι το μέγιστο πλάτος του ατέρμονα για την ερπύστρια δε πρέπει να ξεπερνάει τα f ≤ 44.6 mm. Επομένως, σύμφωνα με τους αναλυτικούς υπολογισμούς, θα πρέπει να ισχύει 48.41 ≥ f ≤ 44.6, το οποίο είναι αδύνατο. Έτσι, ορίζεται το πλάτος του ατέρμονα για την ερπύστρια ώστε να ικανοποιεί τις προϋποθέσεις του Niemann με βάση το λογισμικό. Κρατώντας όλες τις υπόλοιπες μεταβλητές στις τυπικές τιμές του (defaul settings), προκύπτουν ποιότητες με βάση το DIN 3974, 6 και 7 για τον ατέρμονα και τον τροχό αντίστοιχα. Τα προφίλ των οδοντώσεων επιλέγονται τυπικά με βάση το ISO 53: Type C, από τις διαθέσιμες επιλογές του λογισμικού. Ενώ οι ανοχές επιλέγονται και αυτές αυτόματα. Τέλος, ορίζεται το ποσοστό του χρόνου χρήσης της οδοντοκίνησης στα 100%, κάτι που δεν ισχύει στη πραγματικότητα, για την μελέτη του δυσμενέστερου σεναρίου για τα γρανάζια. Εισάγωντας και τις αποστάσεις των εδράνων κύλισης από το κέντρο του ατέρμονα, όπως αυτές έχουν προκύψει από τον προκαταρκτικό σχεδιασμό, υπολογίζονται από το λογισμικό τα παρακάτω:

- Διάρκεια ζωής οδοντοκίνησης H.
- Διάμετρος λειτουργίας ατέρμονα και τροχού dm = Di , i = Wori = G.
- Συντελεστής ασφαλείας σε εκκοιλάνσεις SH .
- Συντελεστής ασφαλείας σε θραύση SF.
- Συντελεστής ασφαλείας σε φθορά SW .

- Θερμοκρασιακός συντελεστής ασφαλείας ST .
- Συντελεστής ασφαλείας έναντι βέλους κάμψης του άξονα ατέρμονα Sδ.

Παρακάτω παρατίθονται τα υπολογιστικά επιλυόμενα γεωμετρικά χαρακτηριστικά των οδοντώσεων όπως προκύπτουν μέσω του λογισμικού αλλά και οι συντελεστές ασφαλείας των οδοντοκινήσεων. Να σημειωθεί ότι τα υλικά επιλέγονται ως έχουν κατά τη δεύτερη επανάληψη του ισοζυγίου μάζας (Steel για τον ατέρμονα και Aluminum για το γρανάζι). Ο συγκεκριμένος κωδικός υλικού επιλέγεται από τις διαθέσιμες επιλογές του λογισμικού ώστε να προκύπτουν ικανοποιητικοί συντελεστές ασφαλείας. Αντίστοιχα επιλέγεται και η λίπανση για τη κάθε οδοντοκίνηση. Οι υπολογισμοί γίνονται με βάση το DIN 3996:2019.

Characteristic | Units | TRACKS | FLIPPER
λ | ◦ | 7.96 | 7.59
mx | mm | 1.65 | 2.00
rc | mm | 4.25 | 5.50
f | mm | 40 | 40
Fe | mm | 11.2 | 15.0
Da,2 | mm | 51.5 | 56.0
DW | mm | 11.8 | 15.0
DG | mm | 46.2 | 50.0
Worm Material | − | X46Cr13
Gear Material | − | 2024-T4
Lubrication Method | − | Injection
Lubricant | − | Kluberoil 4UH1-32N

Πίνακας 3.4: Υπολογιστικά αποτελέσματα οδοντοκινήσεων ερπύστριας και βραχίονα.

Όπως παρατηρείται, μεταξύ αναλυτικών και υπολογιστικών αποτελεσμάτων υπάρχουν κάποιες διαφορές στα γεωμετρικά μεγέθη. Να σημειωθεί ότι τα μεγέθη του Πίν. 3.4 προκύπτουν έπειτα από κάποιες επαναλήψεις με κύριο γνώμονα οι συντελεστές ασφαλείας να προκύπτουν S ≥ 1.1. Τα νούμερα που δίνονται είναι τα τελικά υπολογιζόμενα ώστε να ικανοποιείται αυτός ο περιορισμός. Ο συντελεστής της εφαρμογής KA επιλέγεται ως KA = 1.75 για την ερπύστρια και ως KA = 1.6 για τον βραχίονα, σύμφωνα με το DIN 3990/ISO 6336.

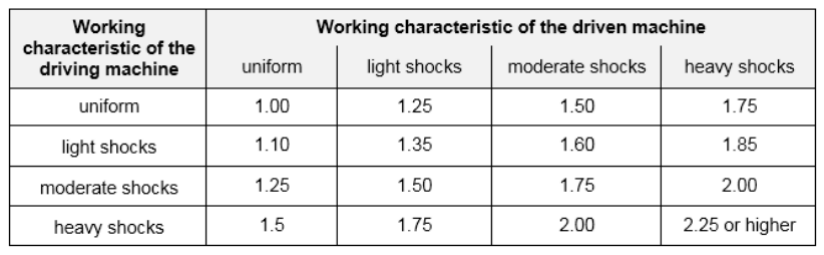
[picture p160: figure]

Σχήμα 3.5: Συντελεστής εφαρμογής σύμφωνα με το DIN 3990/ISO 6336.

Ορίζοντας ως στόχο χρόνου λειτουργίας τις 20000 ώρες για την οδοντοκίνηση προκύπτουν οι συντελεστές ασφαλείας της πλατφόρμας. Η τιμή αυτή εκλέχθηκε με βάση μια τυπική διάρκεια αποστολής έρευνας (4 ώρες). Επομένως, με στόχο τις 5000 αποστολές έως την ανάγκη αλλαγής των γραναζιών προκύπτει ο χρόνος λειτουργίας.

Safety Factor | TRACKS | FLIPPER
SF | 4.892 | 14.580
SH | 1.164 | 1.838
SW | 999.900 | 999.900
ST | 13.350 | 26.703
Sδ | 1.402 | 5.658

Πίνακας 3.5: Συντελεστές ασφαλείας για χρόνο λειτουργίας της πλατφόρμας H = 20000 ℎ.

Η μέγιστη διάρκεια ζωής προκύπτει όταν ο συντελεστής ασφαλείας σε εκκοιλάνσεις (ο μικρότερος από όλους) παίρνει την τιμή της μονάδας. Αυτό συμβαίνει για χρόνο λειτουργίας Hmax = 49796 για την ερπύστρια και Hmax = 770391 για τον βραχίονα, υποθέτοντας όπως αναφέρθηκε διάρκεια χρησιμοποίησης της οδοντοκίνησης 100%.

Επίσης, ο συντελεστής φθοράς όπως φαίνεται υπολογίζεται και στις δύο περιπτώσεις 999.90. Αυτός δεν είναι ο πραγματικός συντελεστής όσο ένα όριο του ίδιου του λογισμικού, υπονοώντας ότι ο ρυθμός φθοράς είναι σχεδόν μηδενικός. Αυτό συμβαίνει λόγω της φαινομενικά μικρής ροπής επί των γραναζιών και κατ' επέκταση της μικρής επιφανειακής πίεσης των δοντιών.
Παρακάτω, προκύπτει από το λογισμικό KISSsoft, η τρισδιάστατη απεικόνιση (μοντέλο CAD) των δύο οδοντοκινήσεων. Δηλαδή η πλήρης και ορθά ορισμένη γεωμετρία των γραναζιών για την επίτευξη των στόχων ζωής της πλατφόρμας.


(αfl) Ερπύστριας. | (βfl) Βραχίονα.

Σχήμα 3.6: τρισδιάστατα μοντέλα CAD οδοντωτών ζεύγων ατέρμονα - τροχού για την ερπύστρια και τον περιστρεφόμενο βραχίονα της πλατφόρμας.

### 3.3.2 Εισαγωγή παραμέτρων και συντελεστές ασφαλείας εδράσεων

Όπως αναφέρθηκε και παραπάνω, έχουν γίνει οι υπολογισμοί των δυνάμεων που καταπονούν τα έδρανα κύλισης της ατράκτου του ατέρμονα. Αυτές προκύπτουν από τις δυνάμεις που αναπτύσσονται στα δόντια των γραναζιών και της ροπής του ηλεκτροκινητήρα που τα κινεί.

Force [N] | Fa | Frl | Frr
TRACKS | 314 | 91 | 97
FLIPPER | 198 | 62 | 63

Πίνακας 3.6: Δυνάμεις καταπόνησης εδράνων κύλισης ατράκτου ατέρμονα.

Εισάγωντας λοιπόν τα παρακάτω στο λογισμικό KISSsoft:

- Περιστροφική ταχύτητα κινητήρα nM [rpm].
- Αξονική δύναμη καταπόνησης Fa [N].
- Ακτινική δύναμη καταπόνησης για κάθε έδρανο Fr [N].
- Τα επιλεγμένα έδρανα W 636 και W 607 ως κινητό και πακτωμένο αντίστοιχα.

Υπολογίζονται αυτόματα οι χρόνοι λειτουργίας των εδράνων L10ℎ στον Πίν. 3.7.

L10ℎ [ℎ] | W 636 | W 607
TRACKS | 38992 | 267
FLIPPER | 140947 | 1004

Πίνακας 3.7: Χρόνος λειτουργίας εδράνων κύλισης ατράκτου ατέρμονα.

Παρατηρώντας το μιρκότερο χρόνο λειτουργίας με εμπιστευτικότητα 90% στις 267 ℎ, ορίζεται και ο πραγματικός χρόνος λειτουργίας στις 260 ℎ για να προκύψουν και οι συντελεστές ασφαλείας της κατασκευής.

S0 | W 636 | W 607
TRACKS | 8.571 | 2.718
FLIPPER | 12.581 | 4.276

Πίνακας 3.8: Συντελεστές ασφαλείας εδράνων κύλισης ατράκτου ατέρμονα για 260 ώρες λειτουργίας με εμπιστευτικότητα 90%.

Όπως παρατηρείται, οι χρόνοι λειτουργίας είναι αρκετά ικανοποιητικοί. Μετά από 260 ώρες λειτουργίας της πλατφόρμας ή όπως αναφέρθηκε (για 4 ώρες διάρκεια αποστολής διάσωσης) για 65 αποστολές, κρίνεται αναγκαία η αλλαγή των εδράνων κύλισης που επιλέχθηκαν. Διαφορετικά μπορούν αν επιλεχθούν και έδρανα με μεγαλύτερη στατική και δυναμική αντοχή για την επέκταση της διάρκειας ζωής της πλατφόρμας.

## 3.4 Επικοινωνία χειριστή με την πλατφόρμα

Η αμφίδρομη επικοινωνία μεταξύ του ρομποτικού διασώστη και του Σταθμού Ελέγχου Εδάφους (Ground Control Station - GCS) υλοποιείται μέσω ασύρματου τοπικού δικτύου WLAN. Συγκεκριμένα, η κεντρική υπολογιστική μονάδα της πλατφόρμας (Raspberry Pi 5) διαμορφώνεται ώστε να λειτουργεί ως Ασύρματο Σημείο Πρόσβασης (Wireless Access Point / Hotspot), δημιουργώντας ένα αυτόνομο δίκτυο στο οποίο συνδέεται ο φορητός υπολογιστής του χειριστή, ο οποίος φέρει λειτουργικό σύστημα Linux. Αυτή η τοπολογία εξασφαλίζει τη δυνατότητα επικοινωνίας ακόμα και σε περιβάλλοντα όπου δεν υφίσταται προϋπάρχουσα δικτυακή υποδομή, συνθήκη τυπική για αποστολές έρευνας και διάσωσης USAR.
Η ανταλλαγή δεδομένων βασίζεται στο λογισμικό μεσαίου επιπέδου ROS (Robot Operating System), το οποίο ακολουθεί την αρχιτεκτονική Publisher-Subscriber. Η ροή της πληροφορίας διακρίνεται σε δύο σκέλη:
1. Τηλεμετρία και Λήψη Δεδομένων (Upstream Flow). Όσον αφορά την εποπτεία της κατάστασης του ρομπότ, οι επιμέρους κόμβοι λογισμικού (ROS nodes) που εκτελούνται στο Raspberry Pi είναι υπεύθυνοι για την ανάγνωση των αισθητήρων. Τα δεδομένα αυτά (εικόνα κάμερας, νέφος σημείων LiDAR, δεδομένα αδράνειας IMU, μετρήσεις αερίων) δημοσιεύονται σε πραγματικό χρόνο σε συγκεκριμένα θεματικά κανάλια (topics), όπως για παράδειγμα cameraimage_raw, scan και imu/data. Ο σταθμός ελέγχου, δηλαδή το laptop, λειτουργώντας ως συνδρομητής (subscriber) σε αυτά τα κανάλια, λαμβάνει τα πακέτα δεδομένων και τα οπτικοποιεί μέσω γραφικού περιβάλλοντος (ROS GUI tools, όπως το RViz ή το rqt), παρέχοντας στον χειριστή πλήρη εικόνα του πεδίου επιχειρήσεων.
2. Τηλεχειρισμός και Έλεγχος Κίνησης (Downstream Flow). Για τις περιπτώσεις που απαιτείται χειροκίνητη παρέμβαση, ο χειριστής έχει τη δυνατότητα ανάληψης του ελέγχου μέσω ασύρματου χειριστηρίου (gamepad). Η διαδικασία ελέγχου ακολουθεί την εξής αλληλουχία:
- Ένας κόμβος στον υπολογιστή του χειριστή (π.χ. joy_node) αναγιγνώσκει τις εντολές από τα πλήκτρα και τους αναλογικούς μοχλούς και τις δημοσιεύει στο κανάλι joy.
- Στη συνέχεια, ένας ενδιάμεσος κόμβος μετατροπής (π.χ. teleop_twist_joy) μεταφράζει τις εντολές αυτές σε κινηματικά μεγέθη (γραμμική και γωνιακή ταχύτητα) και τις δημοσιεύει στο κεντρικό κανάλι ελέγχου κίνησης cmd_vel.
- Τέλος, ο ελεγκτής των κινητήρων (motor controller) που εκτελείται στο ρομπότ, εγγράφεται στο κανάλι cmd_vel, λαμβάνει τις επιθυμητές ταχύτητες και τις μετατρέπει στα κατάλληλα σήματα PWM για την οδήγηση των κινητήρων.

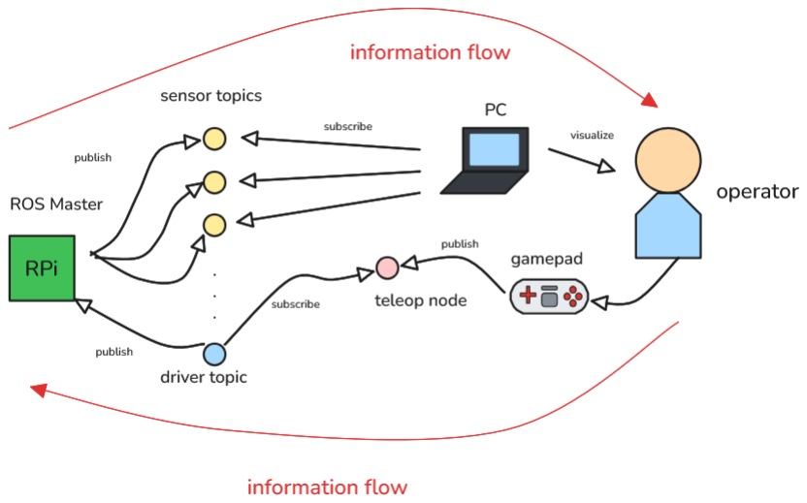
[picture p161: figure]

Σχήμα 3.7: Ροή πληροφορίας μεταξύ πλατφόρμας V.L.A.D. και χειριστή.

# Κεφάλαιο 4

# Συμπεράσματα και Μελλοντική Έρευνα

## 4.1 Διαχείριση όγκου εργασίας

Η εκπόνηση της παρούσας διπλωματικής εργασίας απαίτησε τη διαχείριση ενός μεγάλου όγκου δεδομένων, υπολογισμών και σχεδιαστικών αρχείων. Για την οργάνωση του υλικού και την παρακολούθηση της εξέλιξης του σχεδιασμού, χρησιμοποιήθηκε η πλατφόρμα GitHub. Σε αυτό το αποθετήριο καταχωρήθηκαν τα αρχεία CAD, οι κώδικες υπολογισμών, και οι σημειώσεις προόδου.
Κατά τη διάρκεια της μελέτης, η πολυπλοκότητα του συστήματος οδήγησε αναπόφευκτα στη συσσώρευση μεγάλου πλήθους πληροφοριών. Παρόλο που καταβλήθηκε προσπάθεια για συστηματική καταγραφή, διαπιστώθηκε ότι σε προχωρημένα στάδια του σχεδιασμού, ορισμένες επί μέρους τροποποιήσεις ή σκέψεις δεν καταγράφονταν άμεσα λόγω της ταχύτητας των αλλαγών.
Ένα χαρακτηριστικό παράδειγμα της επαναληπτικής διαδικασίας που ακολουθήθηκε είναι η εξέλιξη του τρισδιάστατου μοντέλου. Αναπτύχθηκαν δύο κύριες εκδόσεις, το CAD v1 και το CAD v2, οι οποίες αντιστοιχούν στις δύο επαναλήψεις του ισοζυγίου μάζας. Η μετάβαση από την έκδοση v1 στην v2 πραγματοποιήθηκε κατόπιν αξιολόγησης των αρχικών εκτιμήσεων βάρους, οδηγώντας σε βελτιστοποιημένες επιλογές εξαρτημάτων και δομικές απλουστεύσεις.

## 4.2 Συμπεράσματα

Ολοκληρώνοντας τον προκαταρτικό και ηλεκτρολογικό σχεδιασμό του ρομποτικού διασώστη V.L.A.D., δύναται να εξαχθούν σημαντικά συμπεράσματα σχετικά με την επίτευξη των στόχων και τη βιωσιμότητα της πρότασης.

### 4.2.1 Αποτίμηση Στόχων

Το σύνολο των στόχων που τέθηκαν στην αρχή της μελέτης θεωρείται ότι έχει επιτευχθεί. Η μελέτη απέδειξε τη μηχανολογική εφικτότητα της κατασκευής, προσδιορίζοντας με ακρίβεια τα κρίσιμα εξαρτήματα (κινητήρες, μετάδοση κίνησης, υλικά) και επιβεβαιώνοντας τη λειτουργικότητα του συστήματος μέσω αναλυτικών υπολογισμών.

### 4.2.2 Κριτική Αξιολόγηση και Περιορισμοί

Παρά την επιτυχή σχεδιαστική προσέγγιση, εντοπίζονται ορισμένοι περιορισμοί που χρήζουν αναφοράς:

- Ενεργειακή Αυτονομία: Ένα από τα κρισιμότερα ζητήματα είναι η διάρκεια λειτουργίας. Βάσει των υπολογισμών του ενεργειακού ισοζυγίου, ο μέγιστος χρόνος λειτουργίας υπό φορτίο είναι περιορισμένος. Ρεαλιστικά, για την κάλυψη μιας τυπικής αποστολής διάσωσης διάρκειας 4 ωρών, θα απαιτούνταν πολλαπλές αλλαγές μπαταρίας (έως και 5 φορές), γεγονός που αυξάνει τον φόρτο της επιχειρησιακής υποστήριξης.
- Οικονομική Αποδοτικότητα (Cost Efficiency): Κατά τον σχεδιασμό, δόθηκε προτεραιότητα στη μέγιστη απόδοση και αξιοπιστία, χωρίς αυστηρούς περιορισμούς κόστους. Αυτό οδήγησε στην επιλογή εξαρτημάτων υψηλής ποιότητας (π.χ. κινητήρες, εξειδικευμένα ρουλεμάν), τα οποία καθιστούν την κατασκευή οικονομικά απαιτητική.
- Διάρκεια Ζωής (Service Life): Η απαιτούμενη διάρκεια ζωής του συστήματος περιορίζεται από συγκεκριμένα στοιχεία μηχανών. Συγκεκριμένα, η διάρκεια ζωής περιορίζεται στις 260 ώρες λειτουργίας, τιμή η οποία υπαγορεύεται από την αντοχή των επιλεγμένων εδράνων κύλισης υπό τα μέγιστα φορτία. Αν και επαρκής για πρωτότυπο, η τιμή αυτή είναι χαμηλή για ένα προϊόν μαζικής παραγωγής.

## 4.3 Προτάσεις για μελλοντική έρευνα

### 4.3.1 Βελτιώσεις στον Υφιστάμενο Σχεδιασμό

Για την αύξηση της αξιοπιστίας και της απόδοσης του ρομπότ προτείνονται:

- Στεγανοποίηση Κιβωτίου (Sealing): Σχεδιασμός και ενσωμάτωση παρεμβυσμάτων για τη στεγανοποίηση του κιβωτίου μετάδοσης, ώστε να επιτραπεί η χρήση υγρού λιπαντικού όπως έχει αποδειχθεί ότι χρειάζεται, βελτιώνοντας την ψύξη και μειώνοντας τις τριβές.
- Ενίσχυση Εδράνων: Αντικατάσταση των τρεχόντων εδράνων με άλλα υψηλότερης αντοχής ή αλλαγή της διάταξης έδρασης, με στόχο την αύξηση του προσδόκιμου ζωής (Required Service Life) πέραν των 260 ωρών. Ένα χαρακτηριστικό παράδειγμα εδράνου με υωηλότερη αντοχή του επιλεγόμενου κρίσιμου W 607 είναι το έδρανο κύλισης 607 από τον κατάλογο της SKF, που σημειώνει αύξηση στο συντελεστή δυναμικής και στατικής αντοχής.
- Αύξηση Διαμέτρου Οδοντωτών Τροχών: Μελέτη για τη χρήση γραναζιών μεγαλύτερης διαμέτρου ή μέτρου οδόντωσης, ώστε να αυξηθούν περαιτέρω οι συντελεστές ασφαλείας έναντι θραύσης και επιφανειακής κόπωσης οι οποίοι αποδείχθηκαν ικανοποιητικοί αλλά ταυτόχρονα σχετικά χαμηλοί.
- Ενεργειακή Διαχείριση: Έρευνα για τη μείωση της κατανάλωσης ενέργειας (π.χ. μέσω αλγορίθμων ελέγχου ή αποδοτικότερων ηλεκτρονικών), ώστε να αυξηθεί ο χρόνος λειτουργίας μεταξύ των επαναφορτίσεων.

### 4.3.2 Νέες Λειτουργικές Δυνατότητες

Για την επαύξηση των επιχειρησιακών δυνατοτήτων του διασώστη προτείνονται:

- Μηχανισμός Αυτο-αναστροφής (Flip Mechanism): Σχεδιασμός συστήματος (π.χ. βραχίονες ή αρθρωτό σώμα) που θα επιτρέπει στο ρομπότ να επανέρχεται στην κανονική του θέση σε περίπτωση ανατροπής.
- Σύστημα Φωτισμού: Προσθήκη ισχυρού φακού LED για επιχειρήσεις σε σκοτεινά περιβάλλοντα (π.χ. συντρίμμια, σήραγγες).
- Οπίσθιοι Βραχίονες (Rear Flippers): Προσθήκη ζεύγους flippers και στο πίσω μέρος για βελτίωση της ικανότητας υπερπήδησης εμποδίων και αναρρίχησης σε σκάλες.
- Σύστημα Ανάρτησης: Μελέτη ενσωμάτωσης ανάρτησης για την απορρόφηση κραδασμών, προστατεύοντας τα ευαίσθητα ηλεκτρονικά και το ωφέλιμο φορτίο.

### 4.3.3 Επόμενα Βήματα Υλοποίησης

Για τη συνέχιση της εργασίας και την ολοκλήρωση της κατασκευής απαιτούνται:

- Μηχανισμός Ασφάλισης Φορτίου: Λεπτομερής σχεδιασμός του μηχανισμού ανοίγματος του θαλάμου μεταφοράς (payload chamber). Ο μηχανισμός πρέπει να είναι εύχρηστος, αλλά ταυτόχρονα στιβαρός ώστε να μην ανοίγει ακούσια λόγω των κραδασμών. Θα πρέπει να απαιτεί ελάχιστη προσπάθεια από τον χρήστη κατά το άνοιγμα και κλείσιμο του. Παράδειγμα τέτοιου μηχανισμού θα μπορούσε να αποτελεί ο μηχανισμός Push-To-Open.
- Εσωτερική Χωροταξία: Ενσωμάτωση της μπαταρίας και των ηλεκτρονικών πλακετών στο CAD μοντέλο, με σχεδιασμό ειδικών βάσεων στήριξης (housing) εντός του σώματος. Παρόλο που η μπαταρία και όλα τα ηλεκτρονικά έχουν ελεγχθεί περί των χωροταξικών οριών της πλατφόρμας, δεν έχουν τοποθετηθεί ακόμη οι τελικά επιλεγμένοι αισθητήρες στο σώμα του V.L.A.D.
- Λοιποί Μηχανολογικοί Υπολογισμοί: Εκπόνηση υπολογισμών για τα υπόλοιπα έδρανα του συστήματος και έλεγχος αντοχής των ατράκτων σε σύνθετη καταπόνηση. Επίσης, πρέπει να πραγματοποιηθεί και η επιλογή κοχλιών σύνδεσης και η μελέτη αυτών περί ροπών σύσφιξης.
- Ανάλυση Πεπερασμένων Στοιχείων (FEA): Διεξαγωγή προσομοιώσεων αντοχής στα κρίσιμα υποσυστήματα της πλατφόρμας για την επαλήθευση των αναλυτικών υπολογισμών.
- Ανάπτυξη Λογισμικού και Ηλεκτρονικών: Υλοποίηση του κυκλώματος των αισθητήρων και συγγραφή του κώδικα ελέγχου (ROS/Python) για την αυτόνομη πλοήγηση.
- Πρωτοτυποποίηση (Prototyping): Κατασκευή ενός πρωτοτύπου μέσω τρισδιάστατης εκτύπωσης (3D printing) για τον έλεγχο της συναρμολογησιμότητας (assemblability), των ανοχών και των βασικών μηχανικών λειτουργιών.

# Κατάλογος σχημάτων

2.1 | Διάφοροι ρομποτικοί διασώστες γαι ξεχωριστές λειτουργίες. Από αριστερά προς τα δεξιά: άμεσος
ρομποτικός διασώστης, ρομπότ αρωγής ανθρώπινων αποστολών, ρομπότ έρευνας και ανίχνευσης. . . | 5
2.2 Γενικότερη πορεία σχεδιασμού και σταδίων της μελέτης | | 6
2.3 Δυνατότητες ανίχνευσης ρομποτικού διασώστη με βάση το διαφορετικό είδος δεδομένων | | 7
2.4 Μηχανικά μέρη ερπυστρίας | | 9
2.5 Σύγκριση διαφορετικών ειδών ερπύστριας | | 9
2.6 Συστήματα κίνησης μεταβλητής γεωμετρίας | | 10
2.7 Σύστημα πολλαπλής ερπύστριας με περιστρεφόμενο βραχίονα [5] | | 10
2.8 Σενάρια κίνησης συστήματος με διπλή ερπύστρια και περιστρεφόμενο βραχίονα (Flipper) | | 11
2.9 Αλληλουχία επαναφοράς πλατφόρμας από ανατροπή με τη χρήση των flippers | | 11
2.10 Μέθοδοι αλλαγής κατεύθυνσης πλατφόρμας με τέσσερεις τροχούς | | 12
2.11 Ρομποτική πλατφόρμα Plasma RX. Στα αριστερά το Xiphias και στα δεξιά το RX [2] | | 12
2.12 Σύστημα κίνησης ερπύστριας και βραχιόνων της πλατφόρμας Plasma RX [2] | | 13
2.13 Τομή συστήματος κίνησης Plasma RX [2] | | 13
2.14 Αρχική γεωμετρία για τη πρώτη επανάληψη του ισοζυγίου μάζας | | 14
2.15 Αρχικό σκαρίφημα κιβωτίο κίνησης | | 14
2.16 Τρισδιάστατο σχέδιο κύριας ατράκτου v1 | | 15
2.17 Περιστρεφόμενος βραχίονας v1 | | 15
2.18 Κιβώτιο κίνησης και σασί πλατφόρμας V.L.A.D. v1 | | 16
2.19 Στοιχεία ερπύστριας v1 | | 16
2.20 Πρώτη εκδοχή της συναρμολογημένης πλατφόρμας V.L.A.D | | 17
2.21 Πρώτη εκδοχή συναρμολογημένου διασώστη, δίχως τη παρουσία των ερπυστρίων | | 17
2.22 Σενάρια κίνησης πρώτης εκδοχής πλατφόρμας V.L.A.D | | 17
2.23 Συνδεσμολογία κινητήρα και ατέρμονα κοχλία | | 18
2.24 Δευτερεύων σύστημα κίνησης πλατφόρμας | | 19
2.25 Διάκριση υποσυστημάτων κίνησης | | 20
2.26 Τομή συναρμολογημένης διάταξης κύριου συστήματος κίνησης v1 | | 20
2.27 Τομή συναρμολογημένης διάταξης δευτερεύοντος συστήματος κίνησης v1 | | 21
2.28 Τομή συναρμολογημένης διάταξης οπίσθιας ατράκτου κύριου συστήματος κίνησης v1 | | 21
2.29 Αλληλουχία κινήσεων πλατφόρμας V.L.A.D. κατά την υπερπήδηση σκαλοπατιού | | 24
2.30 Στατική ανάλυση κατά την πορεία σε κεκλιμένο επίπεδο της πλατφόρμας V.L.A.D | | 24
2.31 Τομή κύριας ατράκτου κατά την πρώτη και δεύτερη επανάληψη του ισοζυγίου μάζας | | 25
2.32 Δευτερεύον οδοντωτός τροχός κίνησης κατά την πρώτη και δεύτερη επανάληψη του ισοζυγίου μάζας. 26
2.33 Στρέψη κιβωτίων κίνησης ως προς το σώμα της πλατφόρμας | | 26
2.34 Διάταξη σώματος πλατφόρμας κατά την πρώτη και δεύτερη επανάληψη του ισοζυγίου μάζας | | 27
2.35 Διάγραμμα καταγραφής σήματος διάταξης μικροφώνων | | 28
2.36 Στρατηγική τοποθέτηση αισθητήρων στη πλατφόρμα του V.L.A.D | | 28
2.37 Ολικός αλγόριθμος εντοπισμού θυμάτων της πλατφόρμας V.L.A.D | | 29
2.38 Τρισδιάστατο σχέδιο CAD του κάτω μέρους του σώματος της πλατφόρμας V.L.A.D | | 30
2.39 Τρισδιάστατη απεικόνιση άνω μέρος σώματος και χώρου αποθήκευσης | | 31
2.40 Τομή άνω μέρους σώματος | | 31
2.41 Σκαρίφημα συναρμολογημένης διάταξης κύριου συτήματος κίνησης κατά την δεύτερη επανάληψη του
ισοζυγίου μάζας v2 | 32
2.42 Σκαρίφημα συναρμολογημένης διάταξης οπίσθιου συστήματος κίνησης κατά τη δεύτερη επανάληψη
του ισοζυγίου μάζας v2 | 33
2.43 Σκαρίφημα συναρμολογημένης διάταξης οπίσθιου συστήματος κίνησης κατά τη δεύτερη επανάληψη
του ισοζυγίου μάζας v2 | 33
2.44 Σκαρίφημα συναρμολογημένης διάταξης οπίσθιου συστήματος κίνησης κατά τη δεύτερη επανάληψη
του ισοζυγίου μάζας v2 | | 34
2.45 Σταθεροποιητές άξονα ατέρμονα κοχλία του κύριου συστήματος κίνησης | | 34
2.46 Τομές συναρμολογημένων διατάξεων άνω και κάτω σταθεροποιητών | | 35
2.47 Τομές συναρμολογημένων διατάξεων συστημάτων κίνησης κατά τη δεύτερη επανάληψη του ισοζυγίου
μάζας v2 | 35

2.48 Λεπτομέρειες συστήματος κίνησης της πλατφόρμας V.L.A.D. κατά τη δεύτερη επανάληψη του ισο-
ζυγίου μάζας v2 | 35
2.49 Τρισδιάστατη απεικόνιση πλατφόρμας V.L.A.D. κατά τη δεύτερη επανάληψη του ισοζυγίου μάζας v2. 36
2.50 Μερικές λειτουργίες της πλατφόρμας V.L.A.D. κατά τη δεύτερη επανάληψη του ισοζυγίου μάζας v2. | 36
2.51 Render 1 ρομποτικού διασώστη V.L.A.D | | 38
2.52 Render 2 ρομποτικού διασώστη V.L.A.D | | 38
2.53 Render 3 ρομποτικού διασώστη V.L.A.D | | 39
2.54 Render 4 ρομποτικού διασώστη V.L.A.D | | 39
2.55 Υπολογισμός ροπής κινητήρα κύριας ερπύστριας | | 40
2.56 Συνιστώσες ταχύτητας σε μια οδοντοκίνηση ατέρμονα - τροχού | | 41
2.57 Συντελεστής τριβής συναρτήσει της ταχύτητας ολίσθησης. Θεωρείται επαρκής λίπανση. Η άνω καμπύλη αναφέρεται σε μη επισκληρημένα υλικά οδοντώσεων ενώ η κάτω σε βέλτιστα υλικά οδοντο-
κίνησης ατέρμονα - τροχού [14] | | 41
2.58 Υπολογισμός ροπής κινητήρα βραχίονα | | 42
2.59 Χάρτες λειτουργίας κινητήρων συστήματος κίνησης | | 44
2.60 Συνδεσμολογία οδηγών κινητήρων | | 44
2.61 Κύκλωμα ηλεκτρονικών | | 45
3.1 Γεωμτρικές διαστάσεις οδοντοκίνησης ατέρμονα - τροχού [15] | | 49
3.2 Ανάλυση δυνάμεων στην οδοντοκίνηση ατέρμονα - τροχού [14] | | 51
3.3 Ανάλυση δυνάμεων εδράνων κύλισης ατράκτου ατέρμονα | | 52
3.4 Τρόποι ασφάλισης περικοχλίων ατράκτου του συστήματος κίνησης | | 53
3.5 Συντελεστής εφαρμογής σύμφωνα με το DIN 3990/ISO 6336 | | 54
3.6 τρισδιάστατα μοντέλα CAD οδοντωτών ζεύγων ατέρμονα - τροχού για την ερπύστρια και τον περι-
στρεφόμενο βραχίονα της πλατφόρμας | | 55
3.7 Ροή πληροφορίας μεταξύ πλατφόρμας V.L.A.D. και χειριστή | | 56

# Κατάλογος πινάκων

2.1 | Προϋποθέσεις σχεδιασμού ρομποτικού διασώστη για USAR αποστολές | | 5
2.2 Χαρακτηριστικά του ρομποτικού διασώστη Xiphias | | 13
2.3 Έδρανα κύλισης συστήματος κίνησης κύριας ερπύστριας και βραχίονα v1 | | 15
2.4 Λίστα εξαρτημάτων συστήματος κίνησης | | 22
2.5 Ισοζύγιο μάζας v1 | | 23
2.6 Ισοζύγιο μάζας v2 | | 37
2.7 Υπολογισμοί απαιτούμενης ροπής κινητήρων | | 43
2.8 Επιλεγμένοι κινητήρες συνεχούς ρεύματος της πλατφόρμας V.L.A.D | | 43
2.9 Ισοζύγιο ισχύος | | 46
3.1 Αναλυτικά γεωμετρικά χαρακτηριστικά οδοντοκινήσεων ερπύστριας και βραχίονα | | 50
3.2 Έδρανα κύλισης συστήματος κίνησης | | 50
3.3 Περικόχλια ατράκτου συστήματος κίνησης | | 52
3.4 Υπολογιστικά αποτελέσματα οδοντοκινήσεων ερπύστριας και βραχίονα | | 54
3.5 Συντελεστές ασφαλείας για χρόνο λειτουργίας της πλατφόρμας H = 20000 ℎ | | 54
3.6 Δυνάμεις καταπόνησης εδράνων κύλισης ατράκτου ατέρμονα | | 55
3.7 Χρόνος λειτουργίας εδράνων κύλισης ατράκτου ατέρμονα | | 55
3.8 Συντελεστές ασφαλείας εδράνων κύλισης ατράκτου ατέρμονα για 260 ώρες λειτουργίας με εμπιστευ-
| τικότητα 90% | | 56

# Βιβλιογραφία

[1] S. Ali A. Moosavian, Hesam Semsarilar και Arash Kalantari. ``Design and Manufacturing of a Mobile Rescue Robot''. Στο: 2006 IEEE/RSJ International Conference on Intelligent Robots and Systems. 2006, σσ. 3982–3987.

## DOI: 10.1109/IROS.2006.281835. (https://doi.org/10.1109/IROS.2006.281835)

[2] Kamol Chuengsatiansup κ.ά. ``Plasma-RX: Autonomous Rescue robots''. Στο: (Μαρ. 2009), σσ. 1986–1990. DOI:

## 10.1109/ROBIO.2009.4913305. (https://doi.org/10.1109/ROBIO.2009.4913305)

[3] Argiris Dentsoras. Εισαγωγή Στη Θεωρία Σχεδιασμού. Μια Μεθοδολογική Προσέγγιση Για Σχεδιαστές Μηχανικούς. 1η έκδοση. Εκδ. Τζιόλα, 2022.
[4] Hesham Enshasy κ.ά. ``A Comprehensive Design of Unmanned Ground Search and Rescue Robot''. Στο: Journal of Computer Science and Technology 14 (Φεβ. 2019), σσ. 52–80.
[5] Xin’an Gao κ.ά. ``Design and Ground Performance Evaluation of a Multi-Joint Wheel-Track Composite Mobile Robot for Enhanced Terrain Adaptability''. Στο: Applied Sciences 13.12 (2023). ISSN: 2076-3417. DOI: 10.3390/
app13127270. (https://doi.org/10.3390/app13127270) URL: https://www.mdpi.com/2076-3417/13/12/7270.
[6] Jesús M. García και Franklyn G. Duarte. ``Mobile rolling robots designed to overcome obstacles: A review''. Στο: Forces in Mechanics 16 (2024), σ. 100283. ISSN: 2666-3597. DOI: https://doi.org/10.1016/j.finmec.
2024.100283. (https://doi.org/https://doi.org/10.1016/j.finmec.2024.100283) URL: https://www.sciencedirect.com/science/article/pii/S2666359724000295.
[7] Soheil Habibian κ.ά. ``Design and implementation of a maxi-sized mobile robot (Karo) for rescue missions''. Στο: ROBOMECH Journal 8.1 (2021), σ. 1. ISSN: 2197-4225. DOI: 10 . 1186 / s40648 - 020 - 00188 - 9. (https://doi.org/10.1186/s40648-020-00188-9) URL:
https://doi.org/10.1186/s40648-020-00188-9.
[8] Emmanouil Kyriazis και Anastasios Zisiadis. Search & Rescue Operations in Earthquakes: Technical Handbook No. 1. Αδημοσίευτη ερευνητική εργασία. Athens, Greece: European Centre on Prevention κ.ά., 1999. URL:

## https://oasp.gr/sites/default/files/library/2021-02/Search%20%26%20Rescue%20Operations%

20in%20Earthequakes.pdf. (https://oasp.gr/sites/default/files/library/2021-02/Search%20%26%20Rescue%20Operations%20in%20Earthequakes.pdf)

[9] Elena Messina και Adam Jacoff. ``Performance Standards for Urban Search and Rescue Robots''. en. Στο: Proceedings of the SPIE Defense και Security Symposium, Orlando, FL, Ιούν. 2006. URL: https://tsapps.
nist.gov/publication/get_pdf.cfm?pub_id=822695. (https://tsapps.nist.gov/publication/get_pdf.cfm?pub_id=822695)
[10] S.A.A. Moosavian κ.ά. ``ResQuake: A Tele-Operative Rescue Robot''. Στο: Journal of Mechanical Design - J MECH DESIGN 131 (Αύγ. 2009). DOI: 10.1115/1.3179117. (https://doi.org/10.1115/1.3179117)
[11] Sharma Naman. ``Conceptual Design of an Autonomous Rescue Bot for Assistance During Natural Disaster Rescue Operations''. Στο: International Journal of Mechanical and Production Engineering Research and Development 10 (3 Ιούν. 2020).
[12] Jean-Luc Paillat, Philippe Lucidarme και Laurent Hardouin. ``Original Design of an Unmanned Ground Vehicle for Exploration in Rough Terrain''. Στο: Advanced Robotics 24 (Ιαν. 2010), σσ. 255–276. DOI: 10 . 1163 /

## 016918609X12586221919482. (https://doi.org/10.1163/016918609X12586221919482)

[13] Mohammadreza Sharifibamrood και Majid Mafi. ``Designing and Manufacturing the Arad Rescue Robot and Evaluating Its Efficiency for USAR Missions''. Στο: Science and Innovation 16.1 (Απρ. 2024), σσ. 83–94. DOI:
10 . 15407 / scine16 . 01 . 083. (https://doi.org/10.15407/scine16.01.083) URL: https : / / nasu - periodicals . org . ua / index . php / science /

## article/view/2139. (https://nasu-periodicals.org.ua/index.php/science/article/view/2139)

[14] Joseph Edward Shigley, Charles R. Mischke και Thomas H. Brown. Standard Handbook of Machine Design. 3η έκδοση. New York: McGraw-Hill, 2004.
[15] Surface Durability of Worm Gear | KHK --- khkgears.net. https://khkgears.net/new/gear_knowledge/
gear_technical_reference/surface-durability-worm-gear.html. (https://khkgears.net/new/gear_knowledge/gear_technical_reference/surface-durability-worm-gear.html) [Accessed 16-11-2025].
[16] Yuan Tao κ.ά. ``Analysis of Motion Characteristics and Stability of Mobile Robot Based on a Transformable Wheel Mechanism''. Στο: Applied Sciences 12.23 (2022). ISSN: 2076-3417. DOI: 10.3390/app122312348. (https://doi.org/10.3390/app122312348) URL:
https://www.mdpi.com/2076-3417/12/23/12348.
[17] A. Tunwannarux και S. Hirunyaphisutthikul. ``Design features and characteristics of a rescue robot''. Στο: IEEE International Symposium on Communications and Information Technology, 2005. ISCIT 2005. Τόμ. 2. 2005,
σσ. 1083–1087. DOI: 10.1109/ISCIT.2005.1567056. (https://doi.org/10.1109/ISCIT.2005.1567056)
