vasilepi/Thesis/CAD/mobSub.SLDASM

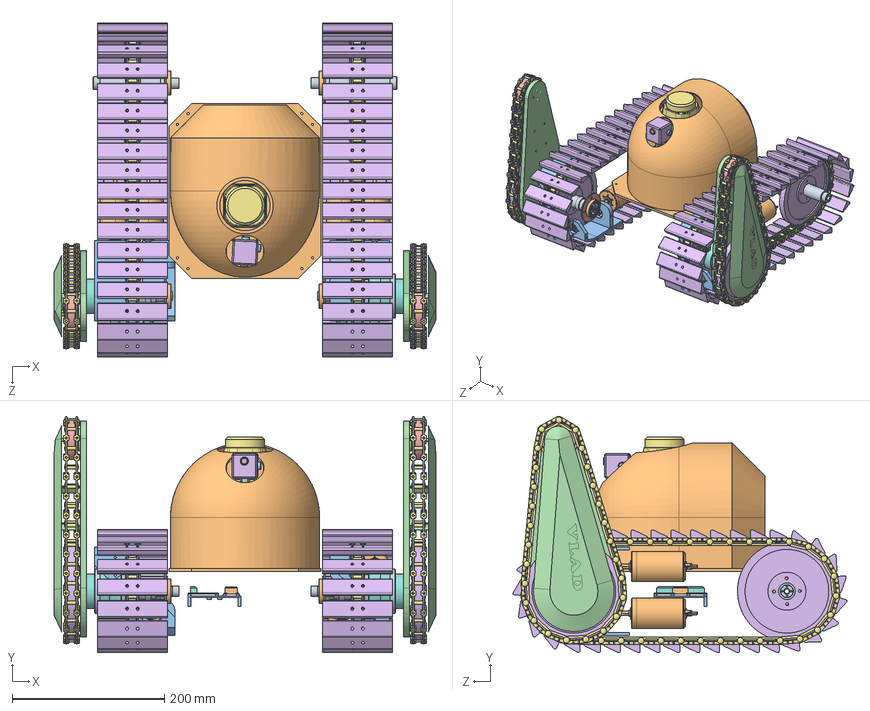
[picture p162: CAD file, 2026-06-05]
CAD/mobSub.SLDASM
502.0 x 310.8 x 439.1 mm
mainShaft x 4
flipperShaft x 2
seconderFlipperShaft x 2
sprocket x 6
secondaryFlipperSprocket x 2
flipperArm x 2
skf_bearing_w_61704_2 x 2
skf_bearing_61804_2 x 4
skf_bearing_61809_2 x 2
w_636 x 4
w_607 x 4
BNG4 x 2
BNG6 x 4
wormMotorStabilizer x 4
motor-sample x 4
cameraMotor-NEMA17
secGTSpacer x 2
chainLink x 128
chainShoe x 74
bodyGTCap x 4
flipperArmCover x 2
mainPCB
batteryCase
battery x 8
motorDriver
liDAR
cameraEnclosure
thermalCamera
cameraShaft
biMic x 2
bodyUpper
lockNutSpacer x 12
