vasilepi/Thesis/CAD/trackLink.SLDASM

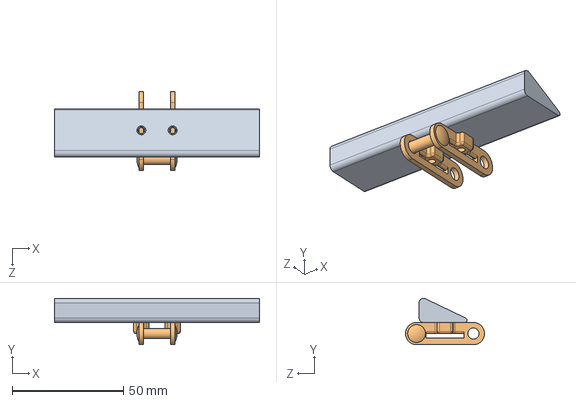
[picture p163: CAD file, 2026-06-05]
CAD/trackLink.SLDASM
92.0 x 20.8 x 35.5 mm
chainLink
chainShoe
