vasilepi/Thesis/CAD/Parts/misc/electronics/mainPCB.SLDPRT

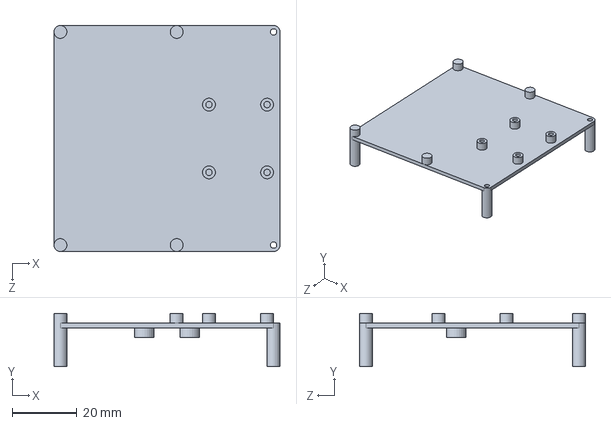
[picture p164: CAD file, 2026-06-05]
CAD/Parts/misc/electronics/mainPCB.SLDPRT
70.0 x 16.5 x 70.0 mm
