vasilepi/Thesis/CAD/Parts/misc/electronics/batteryPack.SLDASM

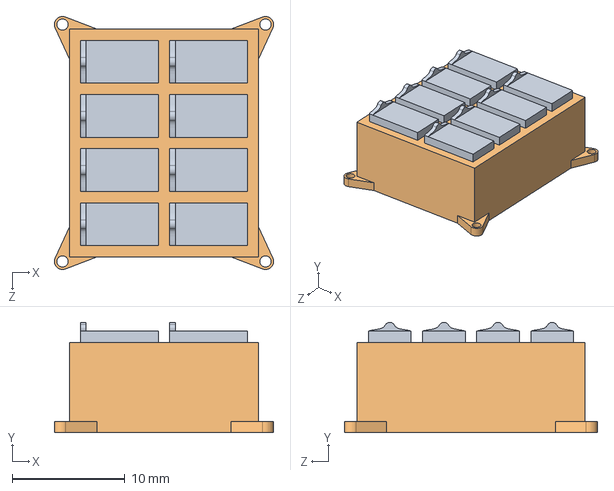
[picture p165: CAD file, 2026-06-05]
CAD/Parts/misc/electronics/batteryPack.SLDASM
19.4 x 9.79 x 22.4 mm
batteryCase
battery x 8
