vasilepi/Thesis/CAD/Parts/misc/electronics/hardware.SLDASM

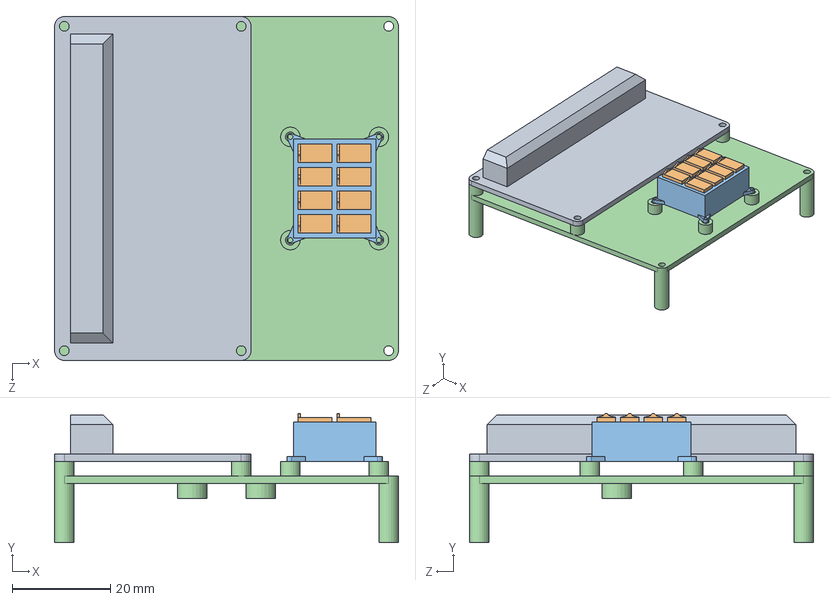
[picture p166: CAD file, 2026-06-05]
CAD/Parts/misc/electronics/hardware.SLDASM
70.0 x 26.3 x 70.0 mm
mainPCB
batteryCase
battery x 8
motorDriver
