vasilepi/Thesis/CAD/Parts/misc/electronics/cameraMount.SLDASM

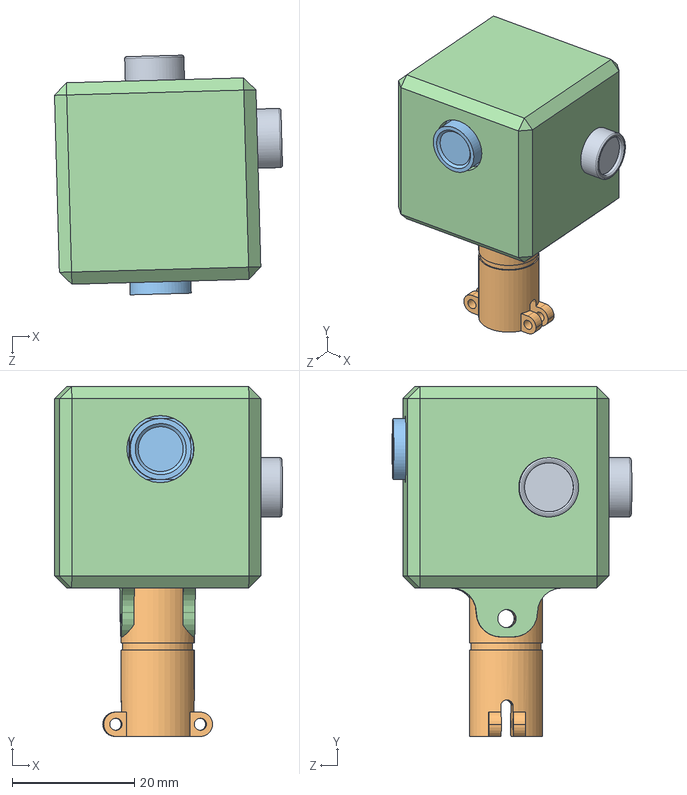
[picture p167: CAD file, 2026-06-05]
CAD/Parts/misc/electronics/cameraMount.SLDASM
37.3 x 57.3 x 39.2 mm
cameraEnclosure
thermalCamera
cameraShaft
biMic x 2
