vasilepi/Thesis/CAD/Parts/mainShaft.SLDPRT

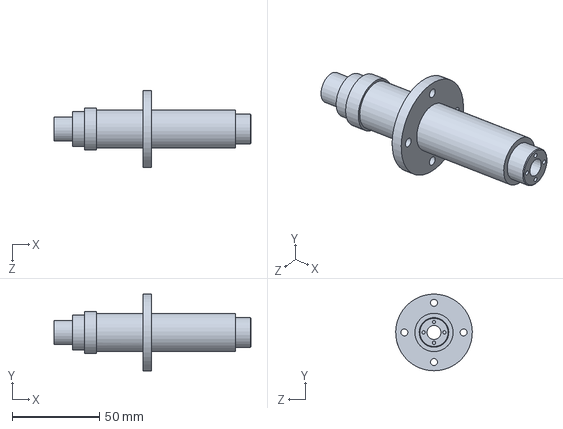
[picture p168: CAD file, 2026-06-05]
CAD/Parts/mainShaft.SLDPRT
113.0 x 43.9 x 44.0 mm
