vasilepi/Thesis/CAD/Parts/bodyUpper.SLDPRT

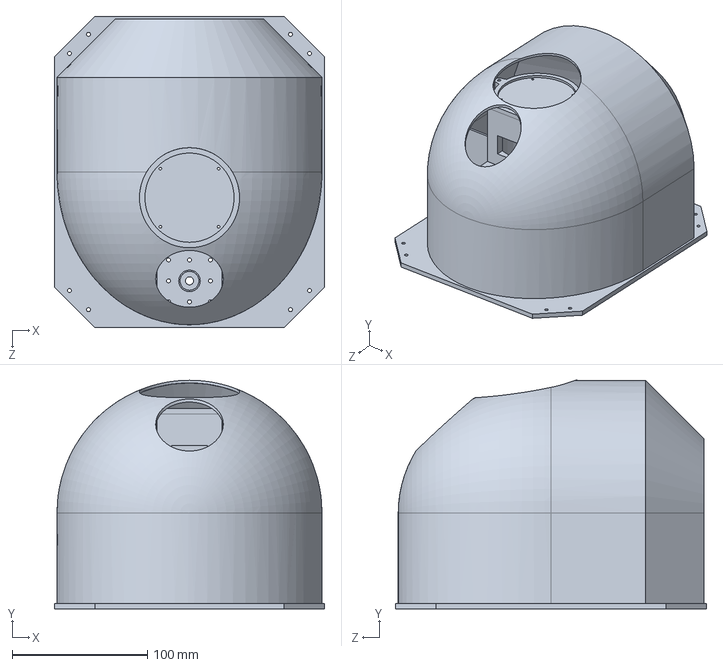
[picture p169: CAD file, 2026-06-05]
CAD/Parts/bodyUpper.SLDPRT
200.0 x 169.0 x 230.0 mm
