vasilepi/Thesis/CAD/Parts/misc/bearings/skf_bearing_ba_6_2.SLDPRT

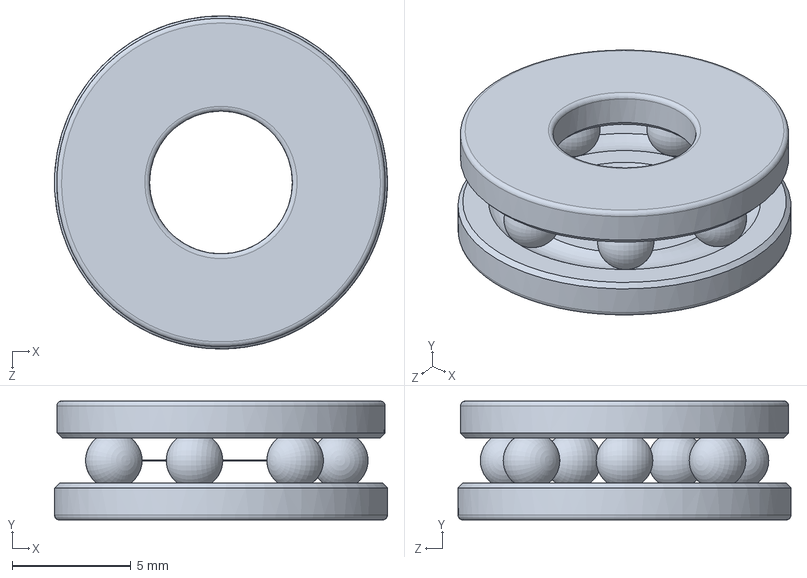
[picture p170: CAD file, 2026-06-05]
CAD/Parts/misc/bearings/skf_bearing_ba_6_2.SLDPRT
14.0 x 5.00 x 14.0 mm
