vasilepi/Thesis/CAD/Parts/misc/electronics/battery.SLDPRT

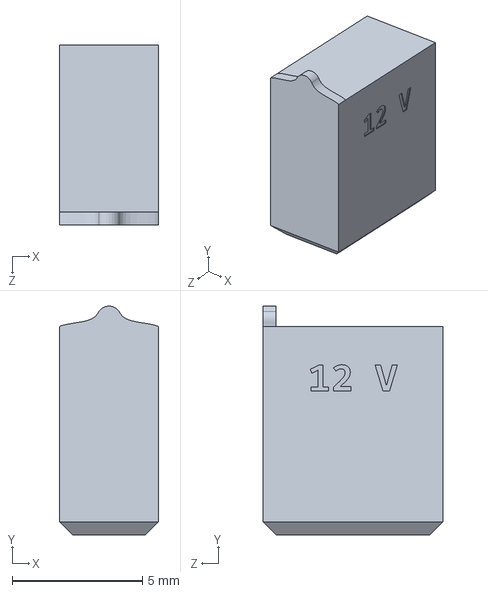
[picture p171: CAD file, 2026-06-05]
CAD/Parts/misc/electronics/battery.SLDPRT
3.80 x 8.79 x 6.90 mm
