vasilepi/Thesis/CAD/Parts/misc/motor-sample.SLDPRT

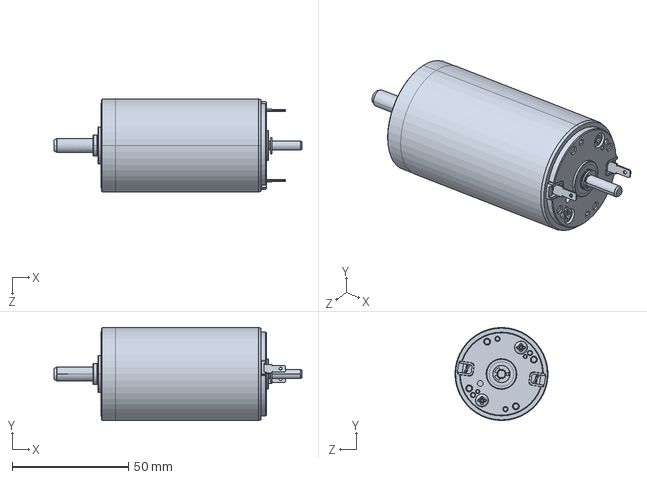
[picture p172: CAD file, 2026-06-05]
CAD/Parts/misc/motor-sample.SLDPRT
106.6 x 40.0 x 40.0 mm
