vasilepi/Thesis/GearAnalysis/wormGearFlipper.stp

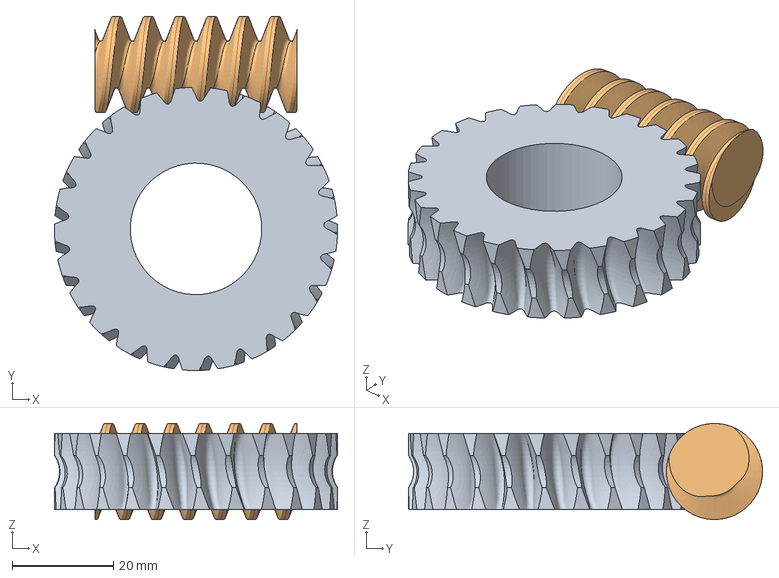
[picture p173: CAD file, 2026-06-05]
GearAnalysis/wormGearFlipper.stp
56.0 x 70.0 x 19.0 mm
WormWheel
Worm
