vasilepi/Thesis/CAD/Parts/misc/bearings/618_8.SLDPRT

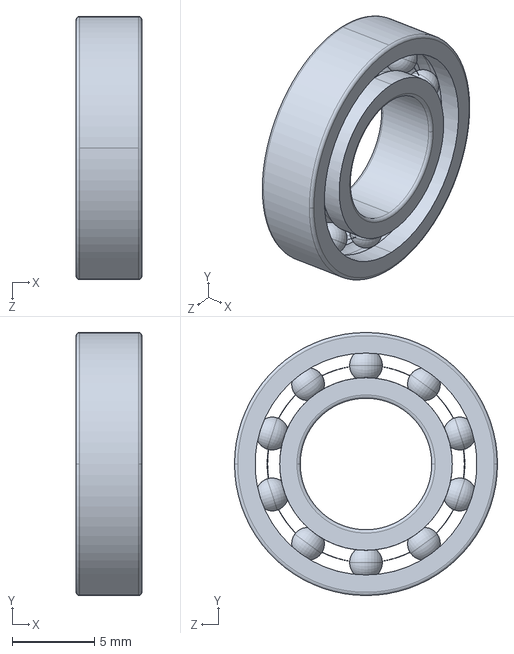
[picture p174: CAD file, 2026-06-05]
CAD/Parts/misc/bearings/618_8.SLDPRT
4.00 x 16.0 x 16.0 mm
