vasilepi/Thesis/CAD/Parts/misc/electronics/cameraEnclosure.SLDPRT

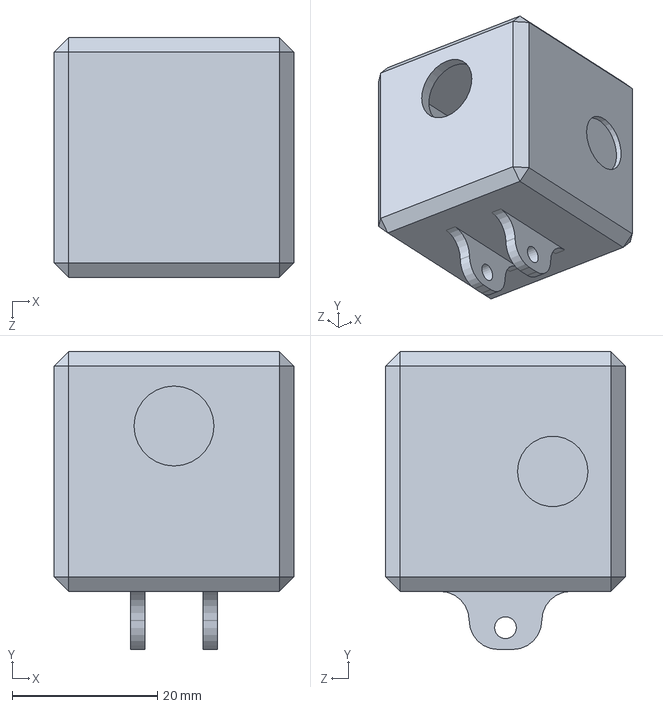
[picture p175: CAD file, 2026-06-05]
CAD/Parts/misc/electronics/cameraEnclosure.SLDPRT
33.0 x 41.0 x 33.0 mm
