vasilepi/Thesis/CAD/Parts/secGTSpacer.SLDPRT

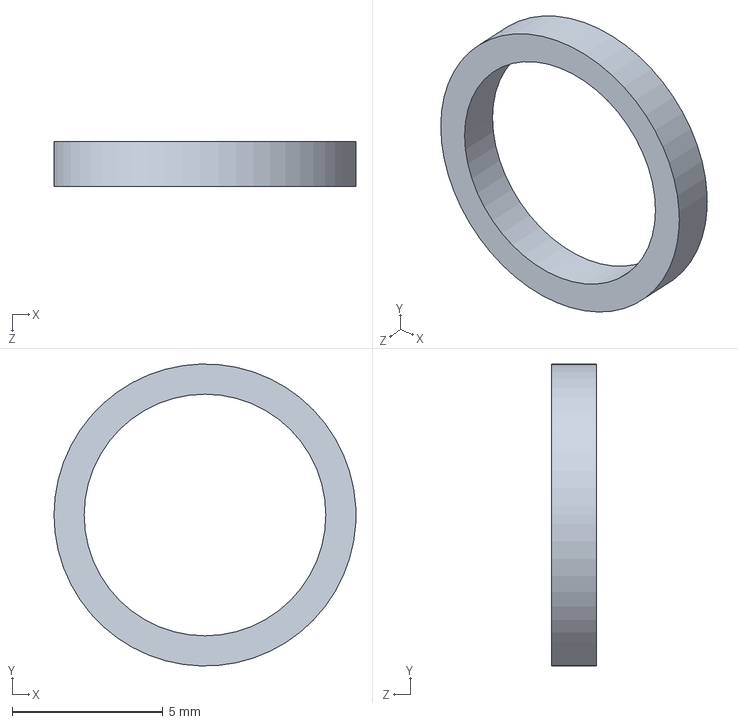
[picture p176: CAD file, 2026-06-05]
CAD/Parts/secGTSpacer.SLDPRT
10.0 x 10.00 x 1.50 mm
