vasilepi/Thesis/CAD/Parts/misc/bearings/skf_bearing_61804_2.SLDPRT

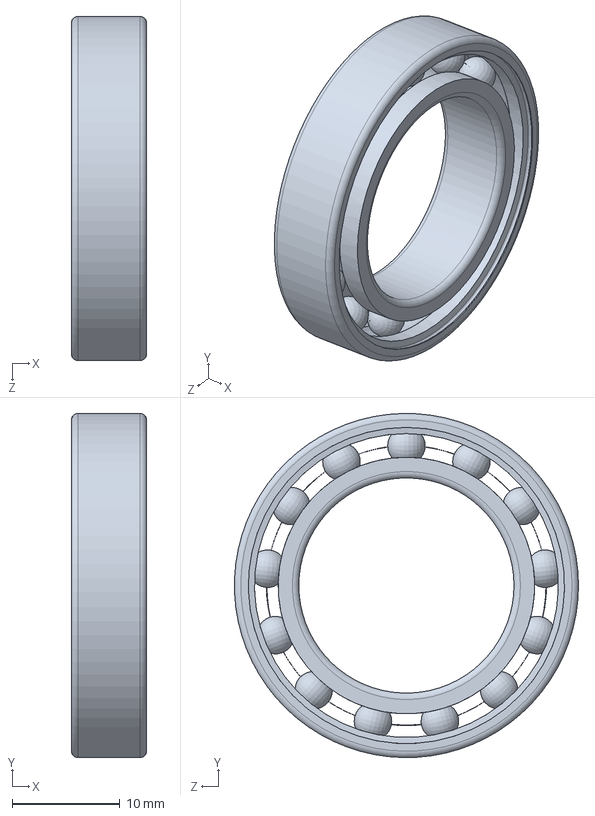
[picture p177: CAD file, 2026-06-05]
CAD/Parts/misc/bearings/skf_bearing_61804_2.SLDPRT
7.00 x 32.0 x 32.0 mm
