vasilepi/Thesis/CAD/Parts/misc/electronics/liDAR.SLDPRT

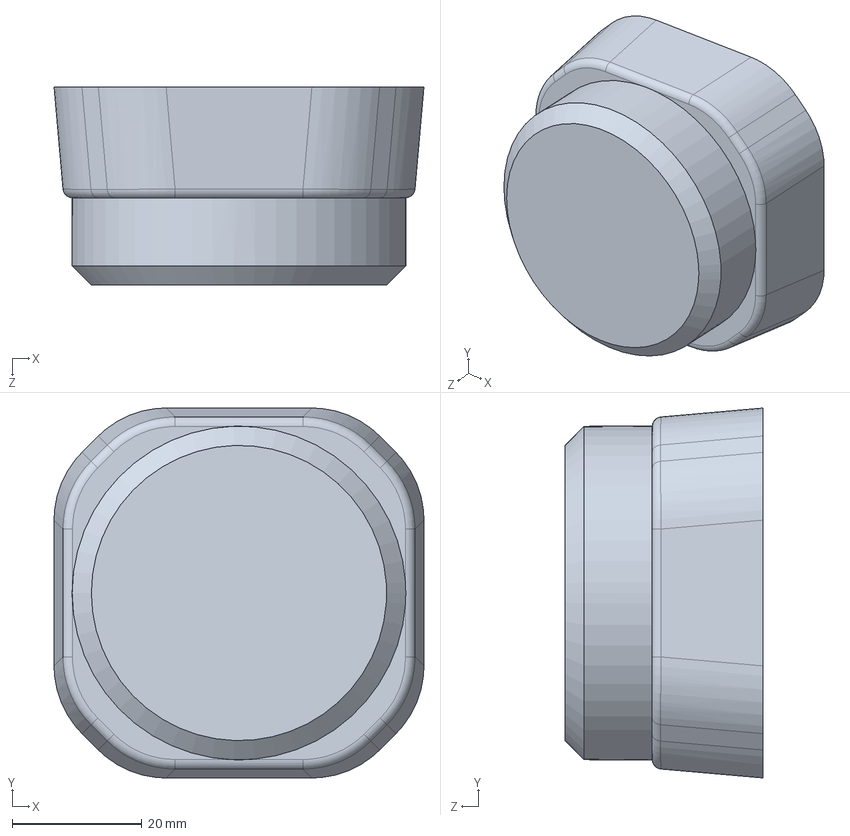
[picture p178: CAD file, 2026-06-05]
CAD/Parts/misc/electronics/liDAR.SLDPRT
57.0 x 57.0 x 30.6 mm
