vasilepi/Thesis/CAD/Parts/flipperArmCover.SLDPRT

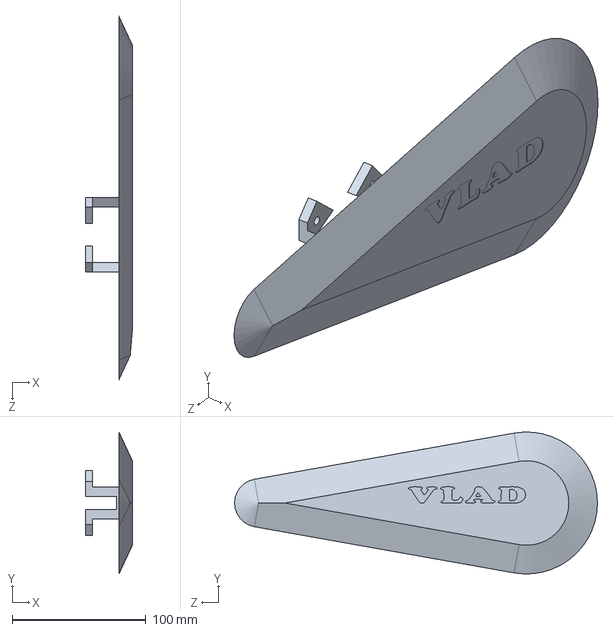
[picture p179: CAD file, 2026-06-05]
CAD/Parts/flipperArmCover.SLDPRT
35.0 x 105.9 x 271.0 mm
