vasilepi/Thesis/CAD/Parts/misc/bearings/skf_bearing_w_61704_2.SLDPRT

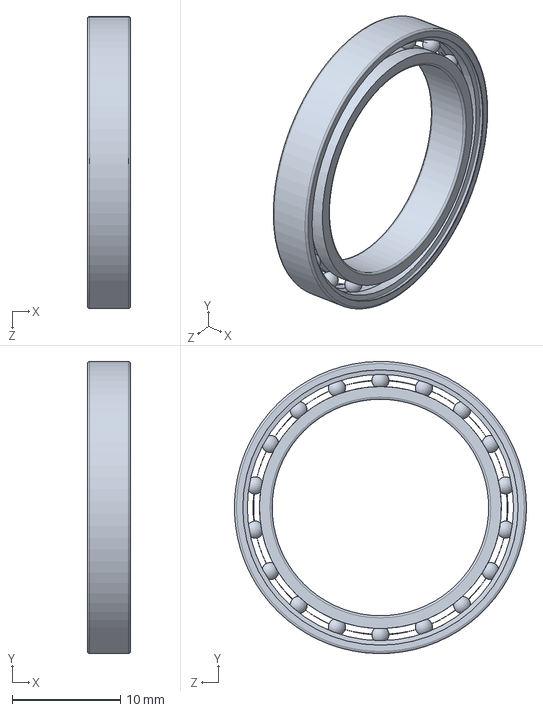
[picture p180: CAD file, 2026-06-05]
CAD/Parts/misc/bearings/skf_bearing_w_61704_2.SLDPRT
4.00 x 27.0 x 27.0 mm
