vasilepi/Thesis/CAD/Parts/misc/shaft couplers/BNG5.SLDPRT

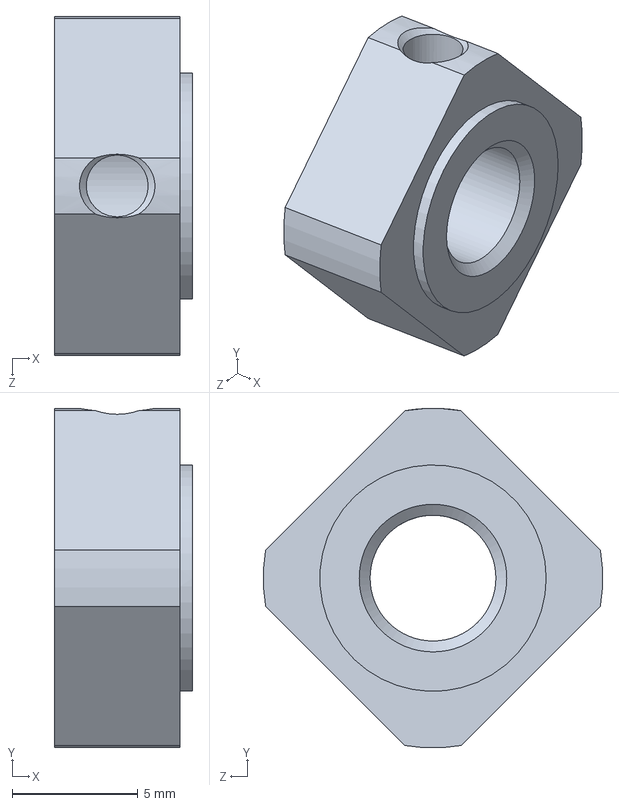
[picture p181: CAD file, 2026-06-05]
CAD/Parts/misc/shaft couplers/BNG5.SLDPRT
5.50 x 13.5 x 13.5 mm
