vasilepi/Thesis/CAD/Parts/flipperArm.SLDPRT

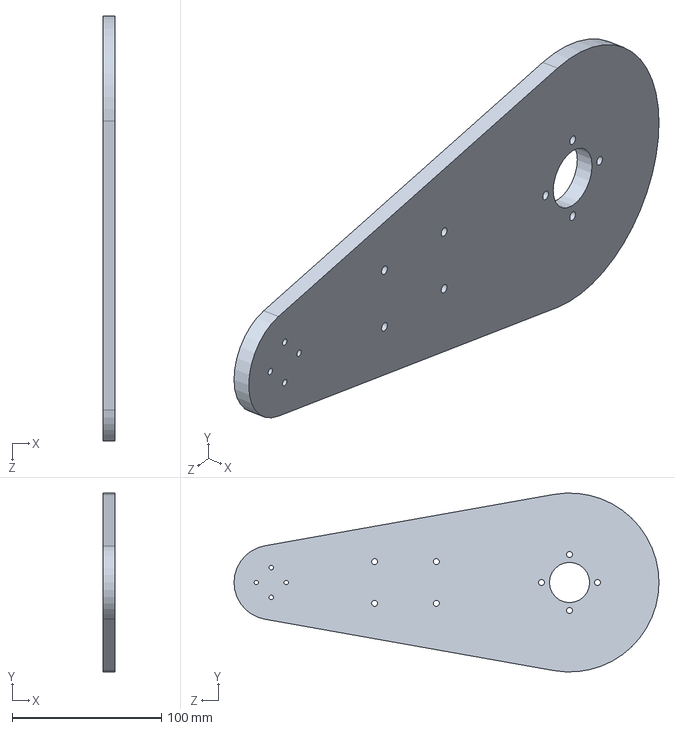
[picture p182: CAD file, 2026-06-05]
CAD/Parts/flipperArm.SLDPRT
8.00 x 119.9 x 285.0 mm
