vasilepi/Thesis/CAD/Parts/misc/bearings/skf_bearing_61809_2.SLDPRT

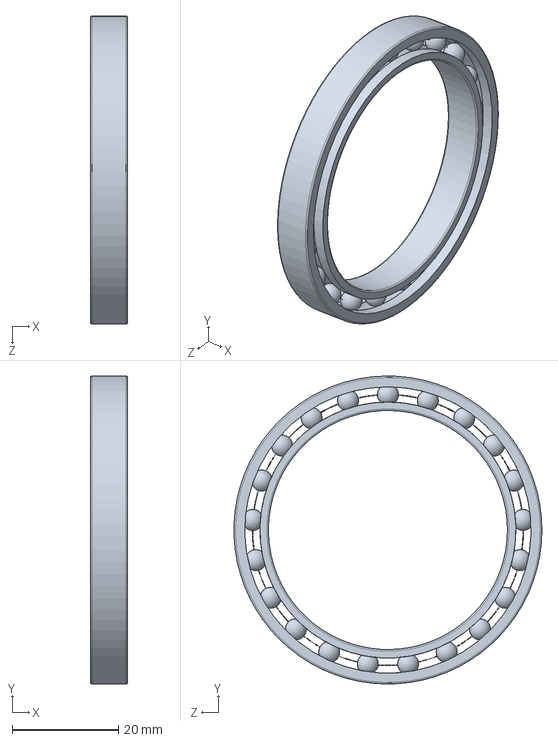
[picture p183: CAD file, 2026-06-05]
CAD/Parts/misc/bearings/skf_bearing_61809_2.SLDPRT
7.00 x 58.0 x 58.0 mm
