vasilepi/Thesis/CAD/Parts/misc/shaft couplers/BNG6.SLDPRT

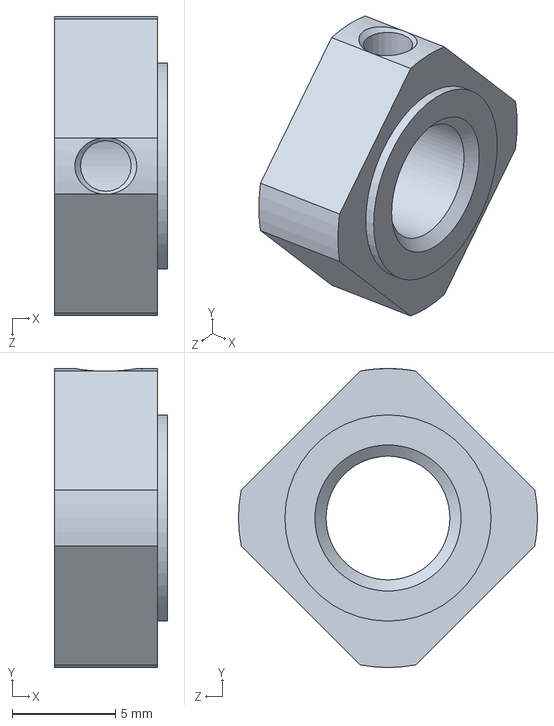
[picture p184: CAD file, 2026-06-05]
CAD/Parts/misc/shaft couplers/BNG6.SLDPRT
5.50 x 14.5 x 14.5 mm
