vasilepi/Thesis/CAD/Parts/flipperShaft.SLDPRT

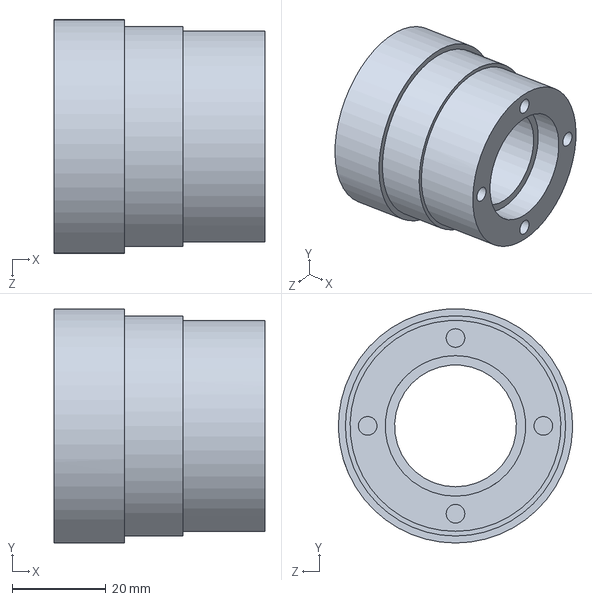
[picture p185: CAD file, 2026-06-05]
CAD/Parts/flipperShaft.SLDPRT
45.0 x 49.9 x 50.0 mm
