vasilepi/Thesis/CAD/Parts/misc/electronics/cameraMountSpacer.SLDPRT

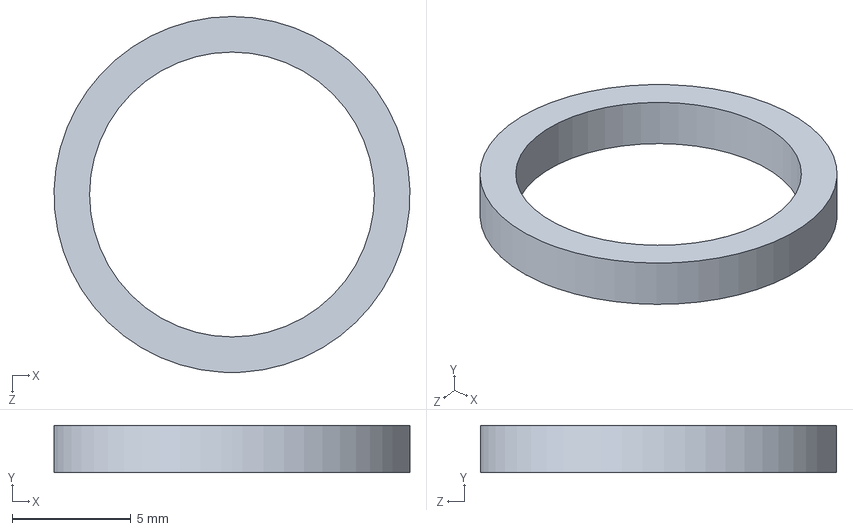
[picture p186: CAD file, 2026-06-05]
CAD/Parts/misc/electronics/cameraMountSpacer.SLDPRT
15.0 x 2.00 x 15.0 mm
