vasilepi/Thesis/CAD/Parts/chainLink.SLDPRT

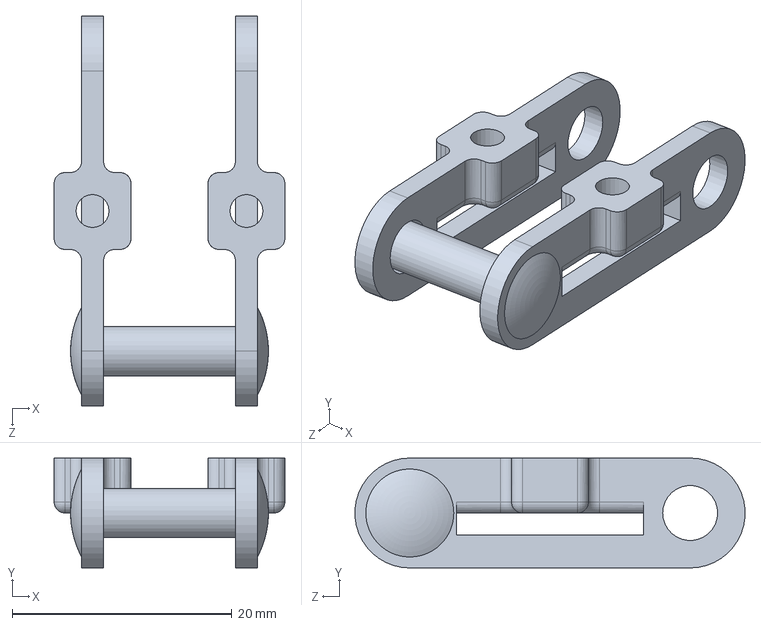
[picture p187: CAD file, 2026-06-05]
CAD/Parts/chainLink.SLDPRT
21.0 x 10.0 x 35.5 mm
