vasilepi/Thesis/CAD/Parts/misc/bearings/w_636.SLDPRT

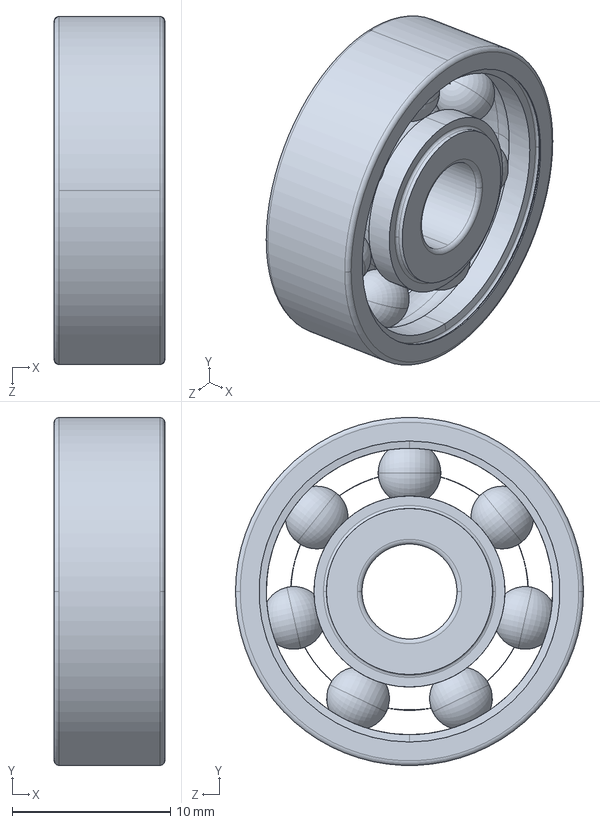
[picture p188: CAD file, 2026-06-05]
CAD/Parts/misc/bearings/w_636.SLDPRT
7.00 x 22.0 x 22.0 mm
