vasilepi/Thesis/CAD/Parts/misc/electronics/batteryCase.SLDPRT

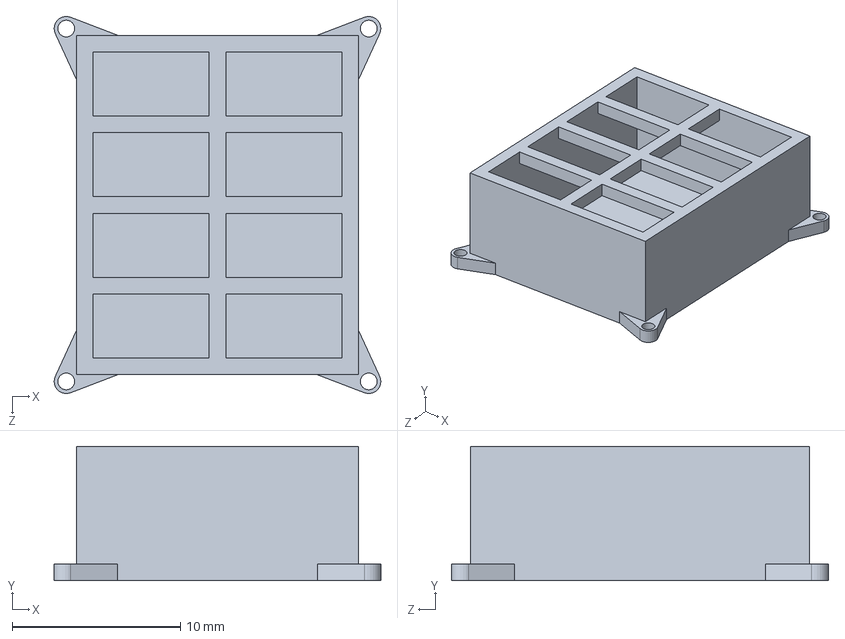
[picture p189: CAD file, 2026-06-05]
CAD/Parts/misc/electronics/batteryCase.SLDPRT
19.4 x 8.00 x 22.4 mm
