vasilepi/Thesis/CAD/Parts/misc/shaft couplers/BNG4.SLDPRT

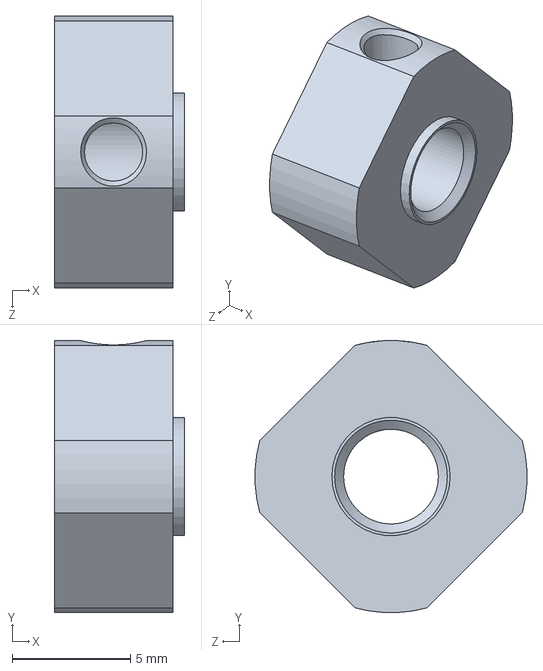
[picture p190: CAD file, 2026-06-05]
CAD/Parts/misc/shaft couplers/BNG4.SLDPRT
5.50 x 11.5 x 11.5 mm
