vasilepi/Thesis/CAD/Parts/misc/bearings/w_61801.SLDPRT

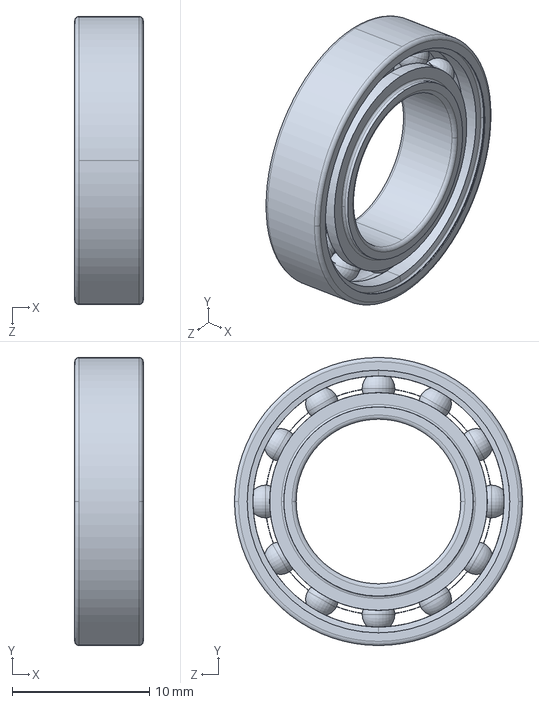
[picture p191: CAD file, 2026-06-05]
CAD/Parts/misc/bearings/w_61801.SLDPRT
5.00 x 21.0 x 21.0 mm
