vasilepi/Thesis/CAD/Parts/misc/electronics/cameraMotor-NEMA17.SLDPRT

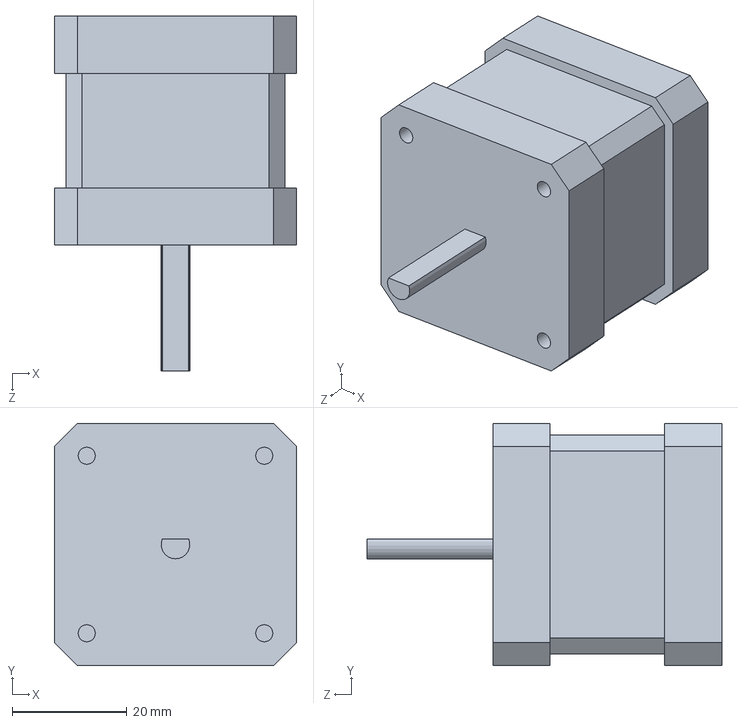
[picture p192: CAD file, 2026-06-05]
CAD/Parts/misc/electronics/cameraMotor-NEMA17.SLDPRT
42.3 x 42.3 x 62.0 mm
