vasilepi/Thesis/CAD/Parts/sprocket.SLDPRT

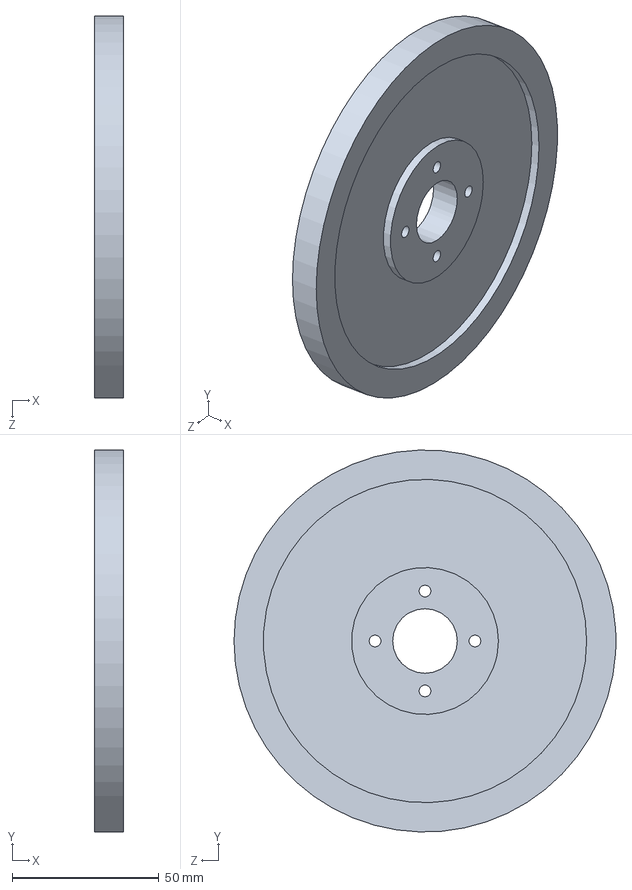
[picture p193: CAD file, 2026-06-05]
CAD/Parts/sprocket.SLDPRT
10.0 x 129.9 x 130.0 mm
