vasilepi/Thesis/CAD/Parts/misc/electronics/cameraShaft.SLDPRT

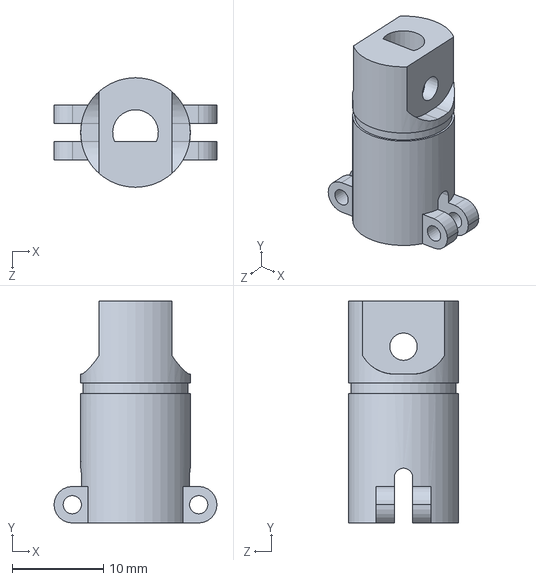
[picture p194: CAD file, 2026-06-05]
CAD/Parts/misc/electronics/cameraShaft.SLDPRT
17.8 x 24.3 x 12.0 mm
