vasilepi/Thesis/CAD/Parts/seconderFlipperShaft.SLDPRT

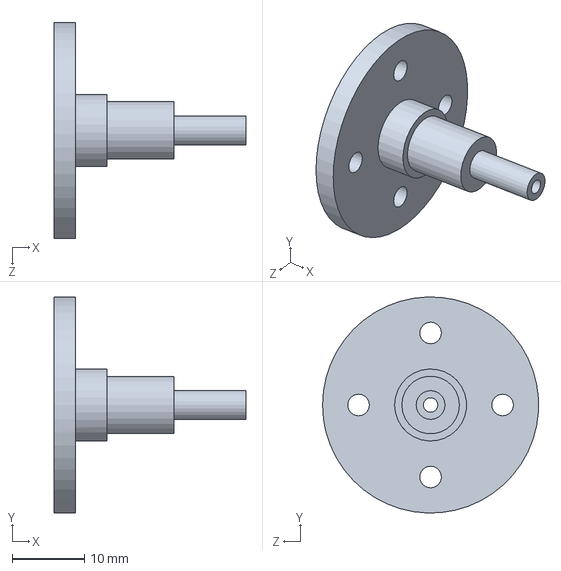
[picture p195: CAD file, 2026-06-05]
CAD/Parts/seconderFlipperShaft.SLDPRT
26.6 x 30.0 x 30.0 mm
