vasilepi/Thesis/CAD/Parts/misc/bearings/w_607.SLDPRT

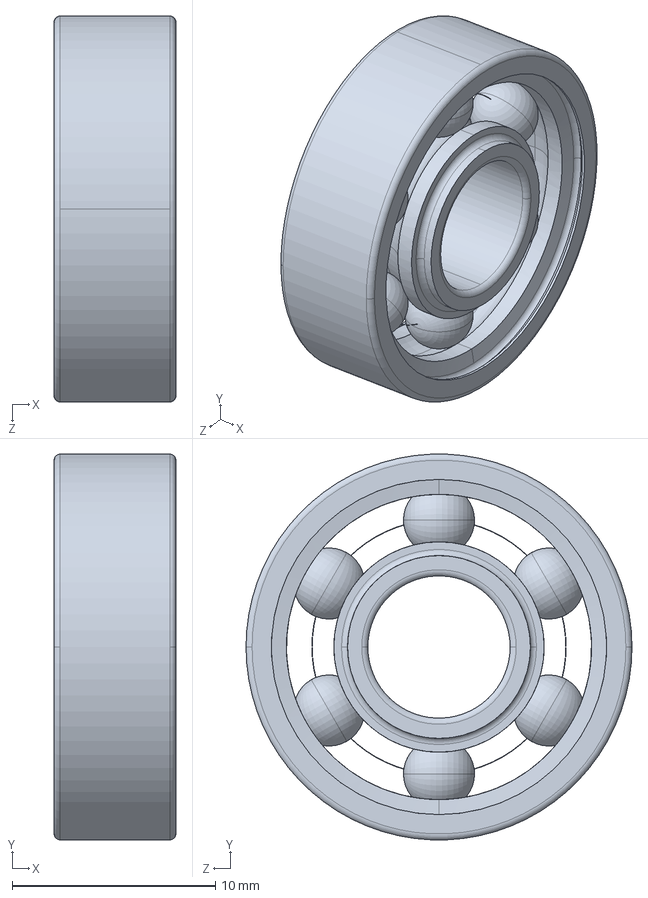
[picture p196: CAD file, 2026-06-05]
CAD/Parts/misc/bearings/w_607.SLDPRT
6.00 x 19.0 x 19.0 mm
