vasilepi/Thesis/CAD/Parts/misc/electronics/motorDriver.SLDPRT

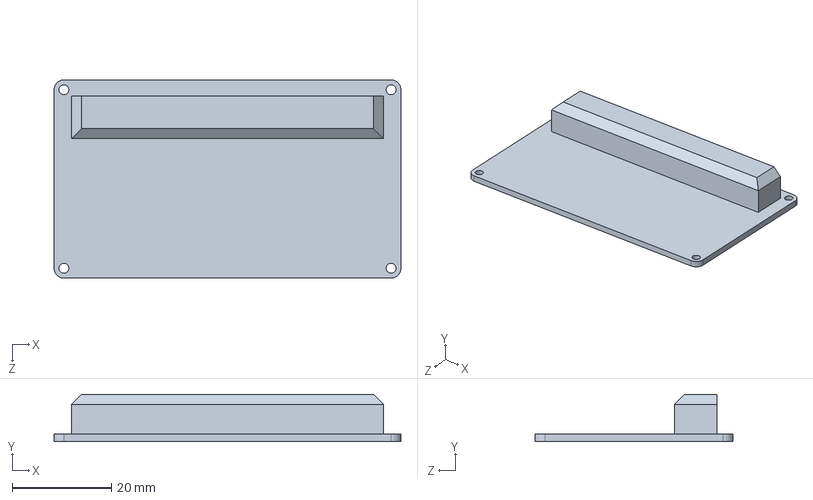
[picture p197: CAD file, 2026-06-05]
CAD/Parts/misc/electronics/motorDriver.SLDPRT
70.0 x 9.50 x 40.0 mm
