vasilepi/Thesis/CAD/Parts/secondaryFlipperSprocket.SLDPRT

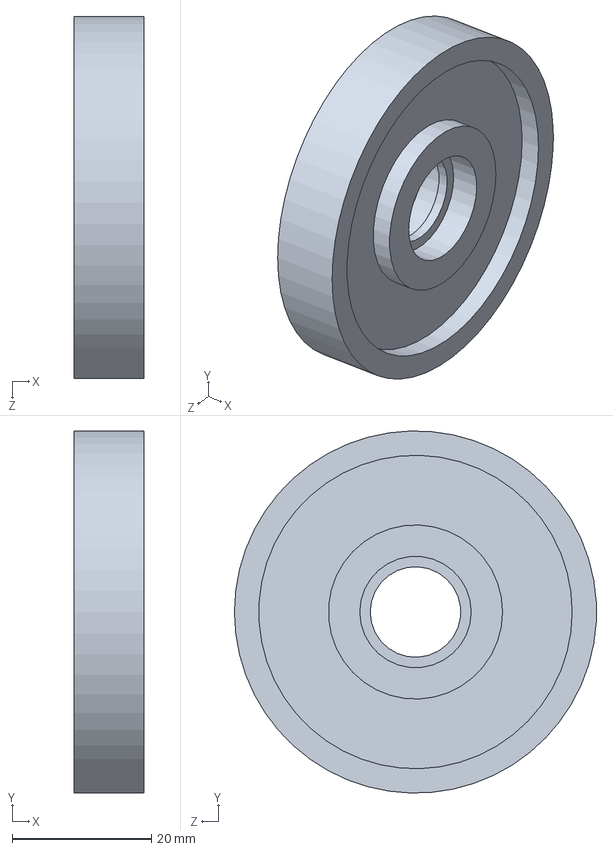
[picture p198: CAD file, 2026-06-05]
CAD/Parts/secondaryFlipperSprocket.SLDPRT
10.0 x 52.0 x 52.0 mm
