vasilepi/Thesis/CAD/Parts/lockNutSpacer.SLDPRT

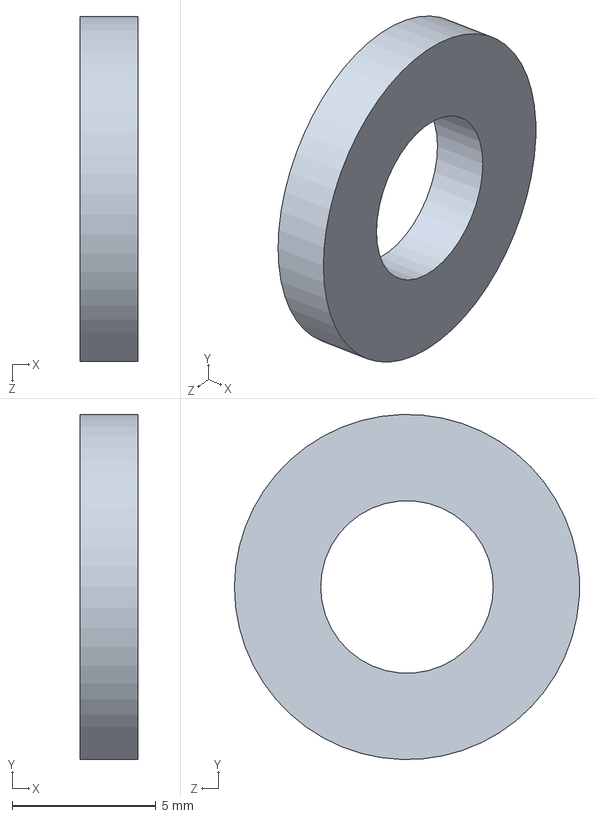
[picture p199: CAD file, 2026-06-05]
CAD/Parts/lockNutSpacer.SLDPRT
2.00 x 12.0 x 12.0 mm
