vasilepi/Thesis/CAD/Parts/misc/electronics/thermalCamera.SLDPRT

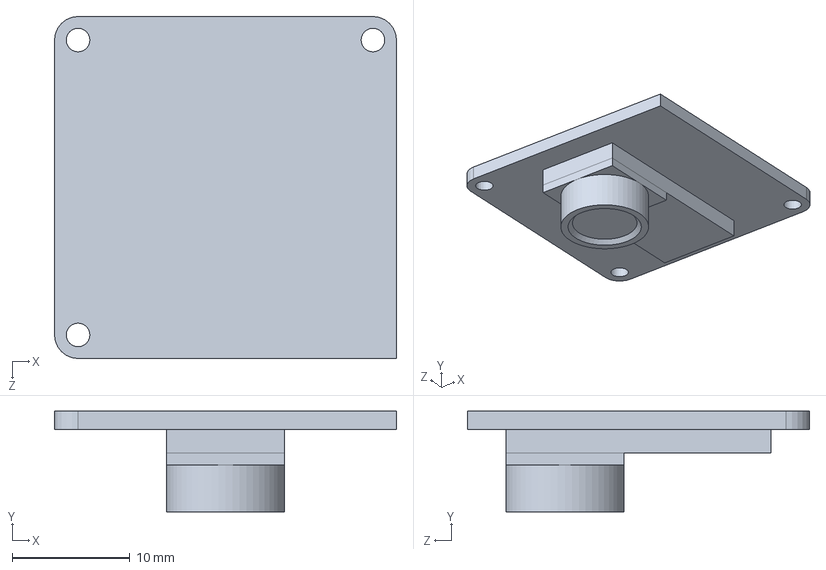
[picture p200: CAD file, 2026-06-05]
CAD/Parts/misc/electronics/thermalCamera.SLDPRT
29.0 x 8.56 x 29.0 mm
