vasilepi/Thesis/CAD/Parts/bodyGTCap.SLDPRT

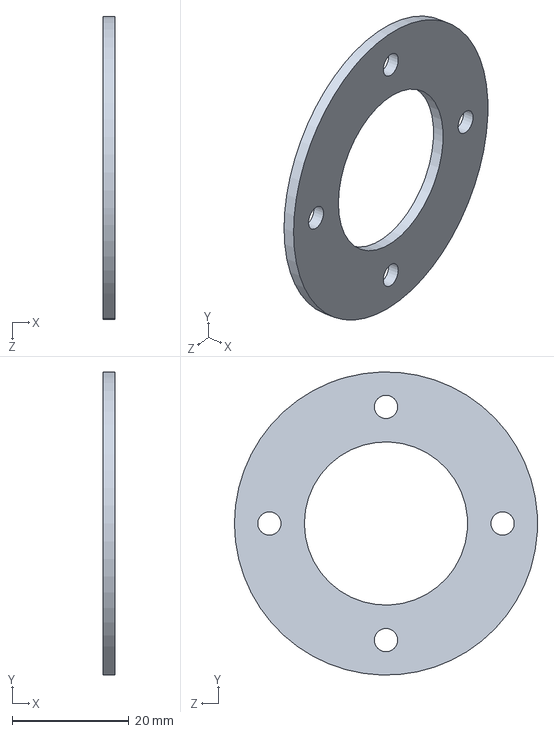
[picture p201: CAD file, 2026-06-05]
CAD/Parts/bodyGTCap.SLDPRT
2.00 x 52.0 x 52.0 mm
