vasilepi/Thesis/CAD/Parts/misc/bearings/skf_bearing_ba_5_2.SLDPRT

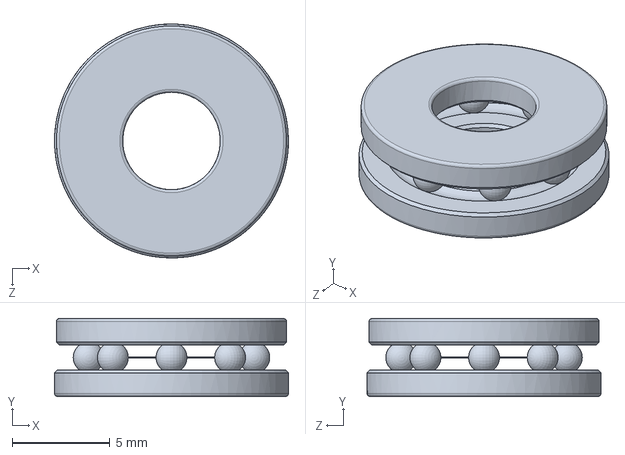
[picture p202: CAD file, 2026-06-05]
CAD/Parts/misc/bearings/skf_bearing_ba_5_2.SLDPRT
12.0 x 4.00 x 12.0 mm
