vasilepi/Thesis/CAD/Parts/misc/electronics/cameraMountOuterHousing.SLDPRT

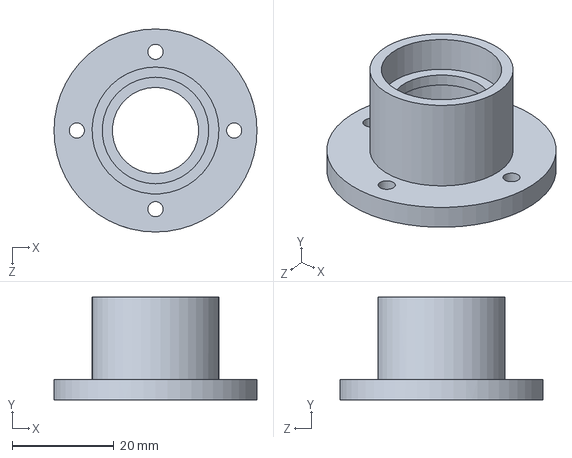
[picture p203: CAD file, 2026-06-05]
CAD/Parts/misc/electronics/cameraMountOuterHousing.SLDPRT
40.0 x 20.2 x 40.0 mm
