vasilepi/Thesis/CAD/Parts/chainShoe.SLDPRT

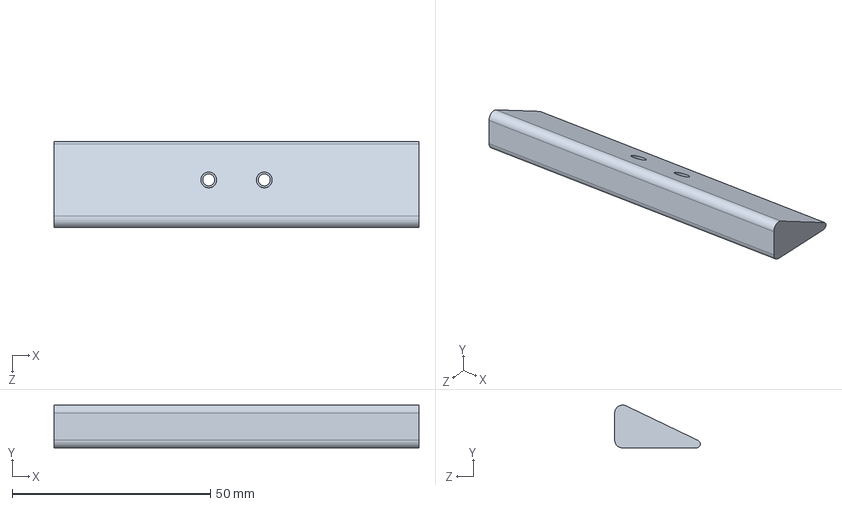
[picture p204: CAD file, 2026-06-05]
CAD/Parts/chainShoe.SLDPRT
92.0 x 10.8 x 21.6 mm
