vasilepi/Thesis/CAD/Parts/misc/electronics/biMic.SLDPRT

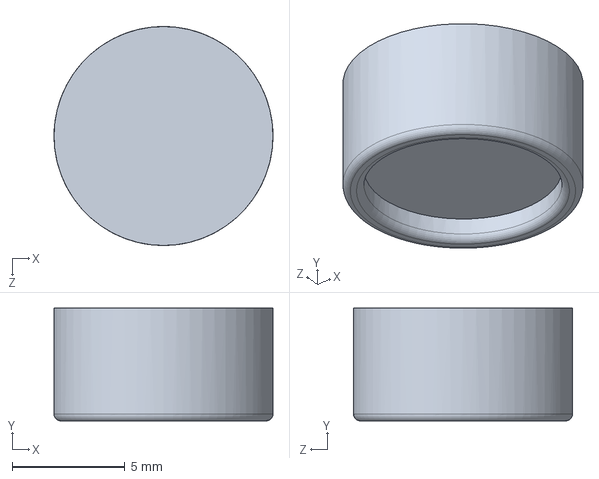
[picture p205: CAD file, 2026-06-05]
CAD/Parts/misc/electronics/biMic.SLDPRT
9.70 x 5.00 x 9.70 mm
