vasilepi/Thesis/CAD/Parts/wormMotorStabilizer.SLDPRT

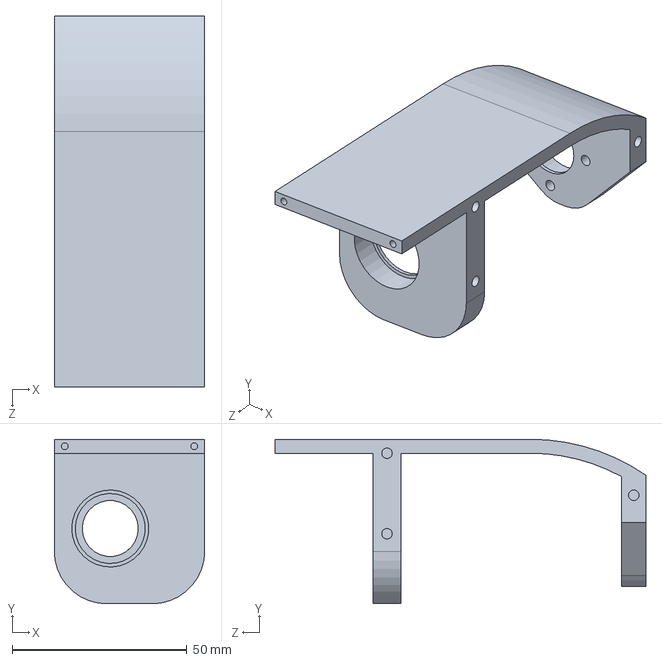
[picture p206: CAD file, 2026-06-05]
CAD/Parts/wormMotorStabilizer.SLDPRT
43.0 x 47.0 x 106.0 mm
