vasilepi/Thesis/CAD/Parts/body.SLDPRT

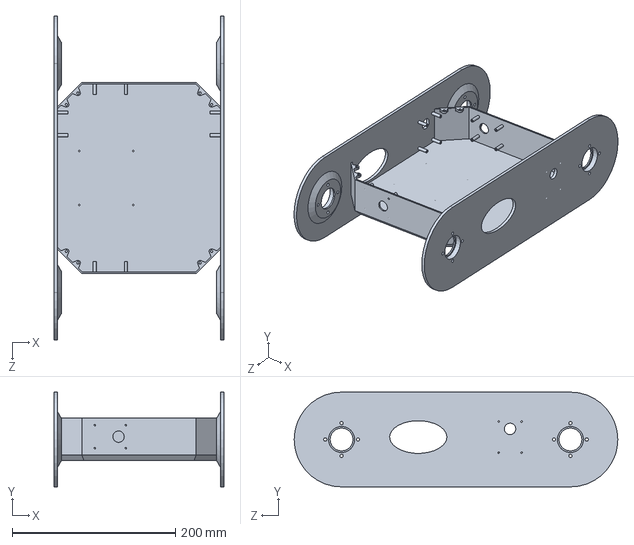
[picture p207: CAD file, 2026-06-05]
CAD/Parts/body.SLDPRT
208.0 x 116.0 x 396.0 mm
