vasilepi/Thesis/CAD/Parts/misc/electronics/psdSensor.SLDPRT

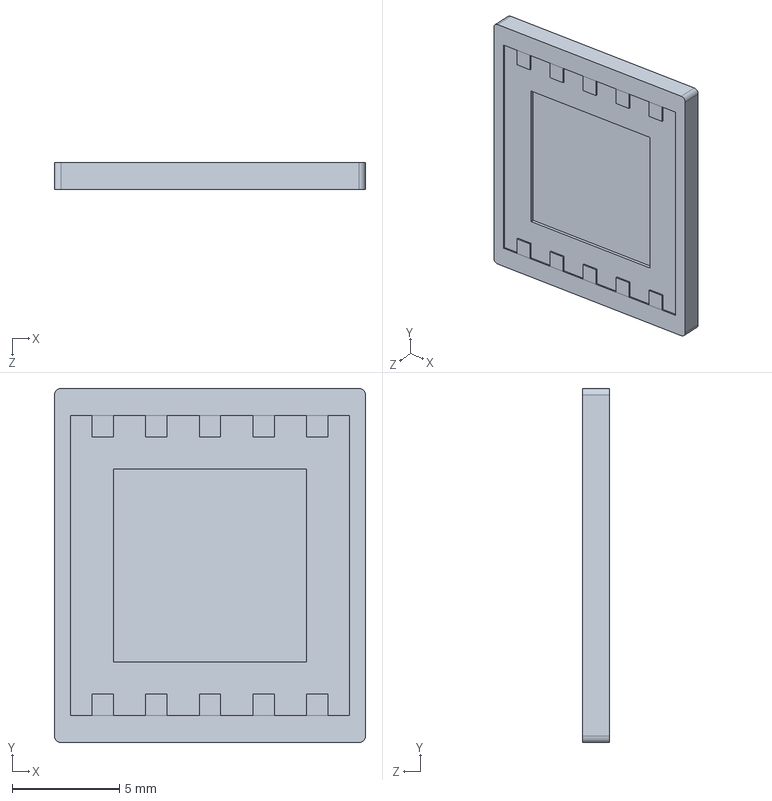
[picture p208: CAD file, 2026-06-05]
CAD/Parts/misc/electronics/psdSensor.SLDPRT
14.5 x 16.5 x 1.26 mm
