vasilepi/Thesis/CAD/Parts/backBearingFixement.SLDPRT

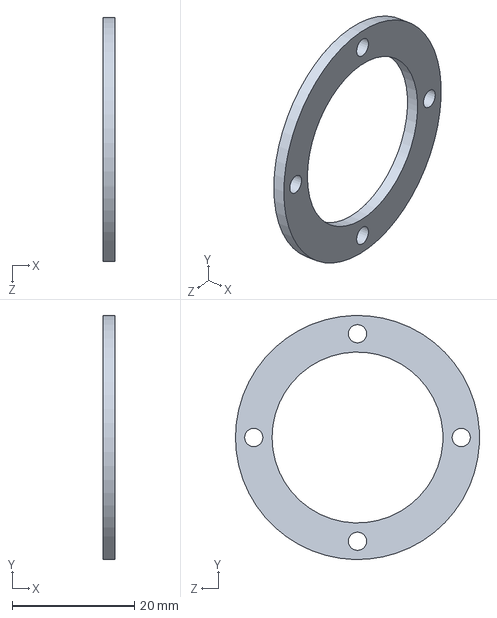
[picture p209: CAD file, 2026-06-05]
CAD/Parts/backBearingFixement.SLDPRT
2.00 x 40.0 x 40.0 mm
