vasilepi/Thesis/CAD/Parts/misc/electronics/vibeSensor.SLDPRT

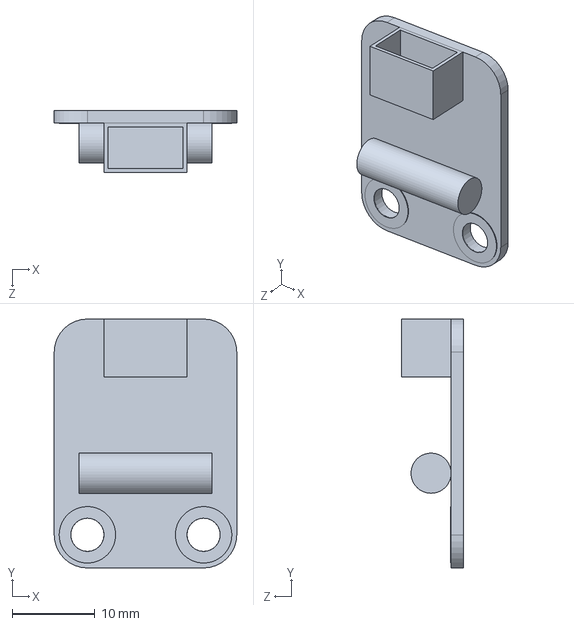
[picture p210: CAD file, 2026-06-05]
CAD/Parts/misc/electronics/vibeSensor.SLDPRT
22.0 x 30.0 x 7.50 mm
