vasilepi/Thesis/CAD/Parts/misc/electronics/imuSensor.SLDPRT

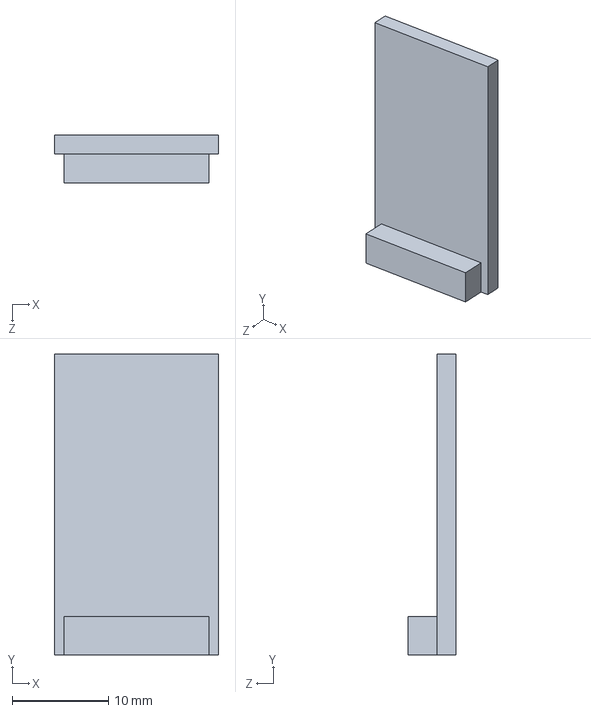
[picture p211: CAD file, 2026-06-05]
CAD/Parts/misc/electronics/imuSensor.SLDPRT
17.0 x 31.2 x 5.00 mm
