vasilepi/Thesis/CAD/Parts/trackCoverPlate.SLDPRT

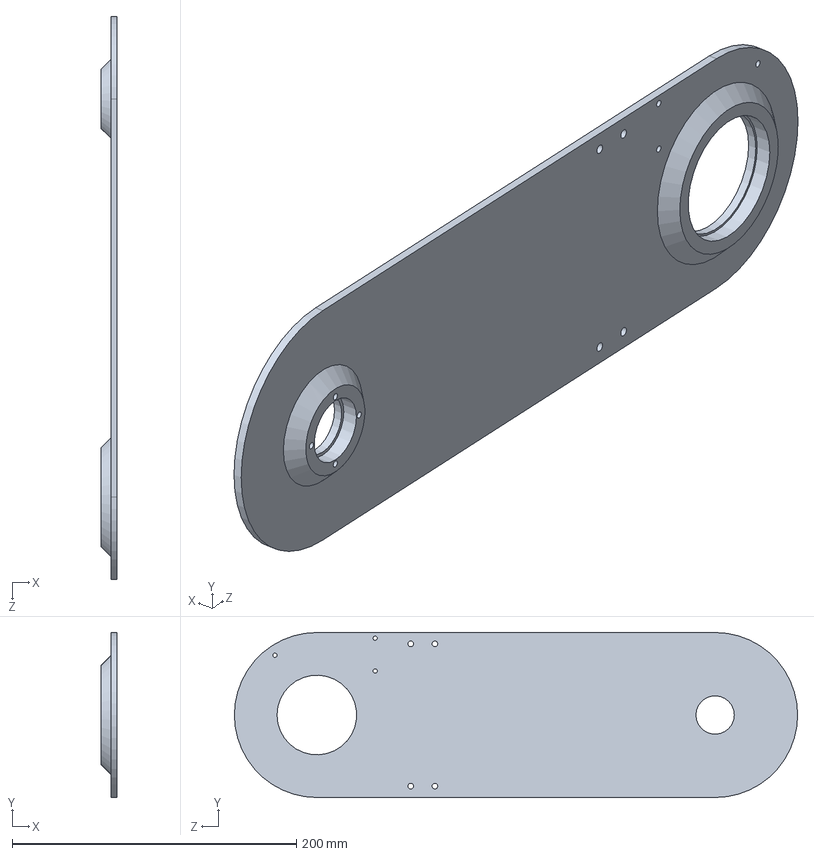
[picture p212: CAD file, 2026-06-05]
CAD/Parts/trackCoverPlate.SLDPRT
11.0 x 116.0 x 396.0 mm
