vasilepi/Thesis/CAD/Parts/misc/electronics/co2Sensor.SLDPRT

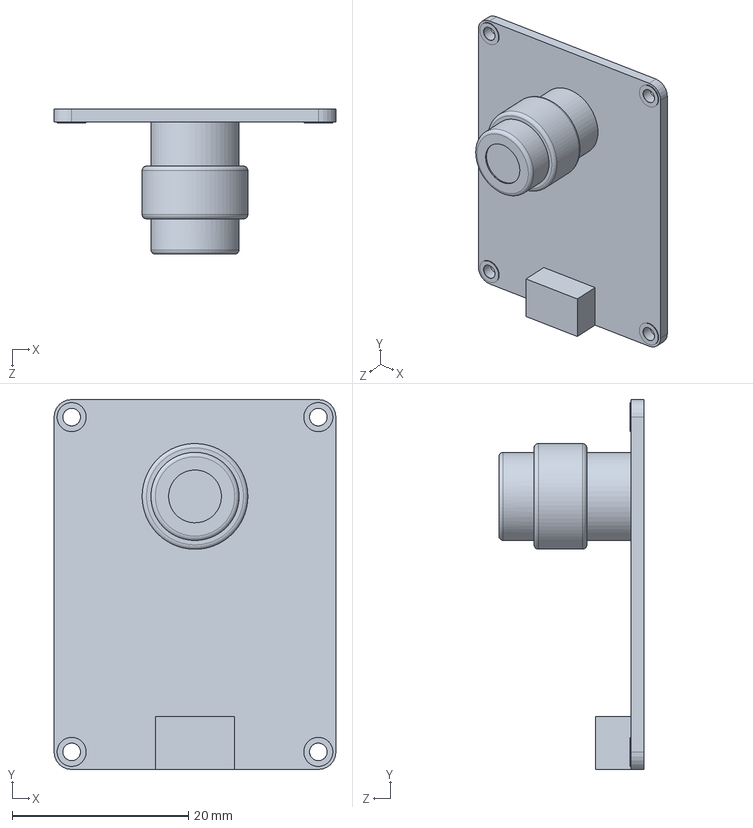
[picture p213: CAD file, 2026-06-05]
CAD/Parts/misc/electronics/co2Sensor.SLDPRT
32.0 x 42.0 x 16.5 mm
