vasilepi/Thesis/CAD/Parts/wormGearShaft.SLDPRT

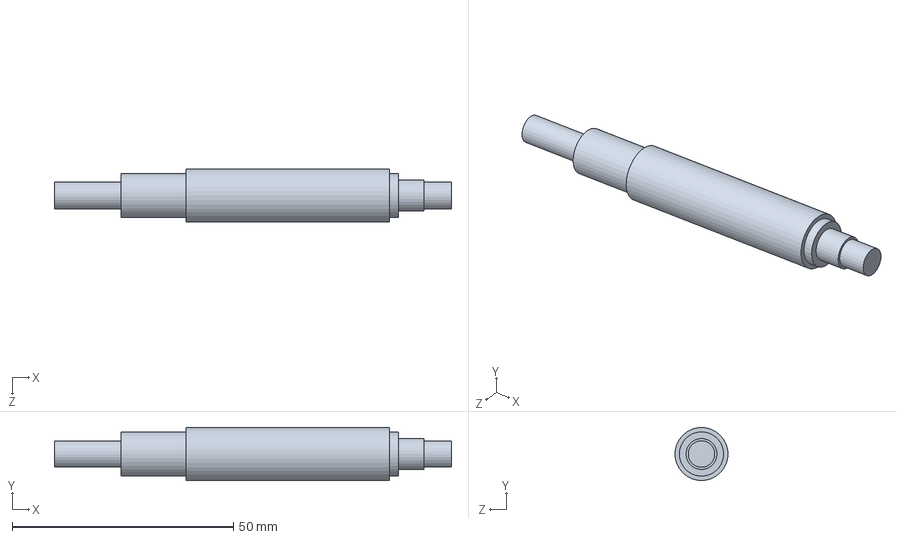
[picture p214: CAD file, 2026-06-05]
CAD/Parts/wormGearShaft.SLDPRT
89.8 x 12.0 x 12.0 mm
