vasilepi/Thesis/CAD/Parts/wormStabCap.SLDPRT

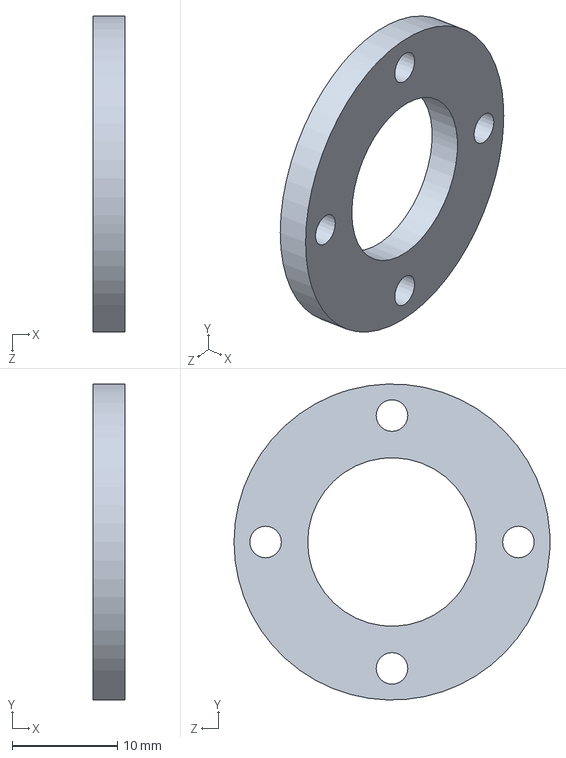
[picture p215: CAD file, 2026-06-05]
CAD/Parts/wormStabCap.SLDPRT
3.00 x 30.0 x 30.0 mm
