vasilepi/Thesis/CAD/Parts/flipperShaftCap.SLDPRT

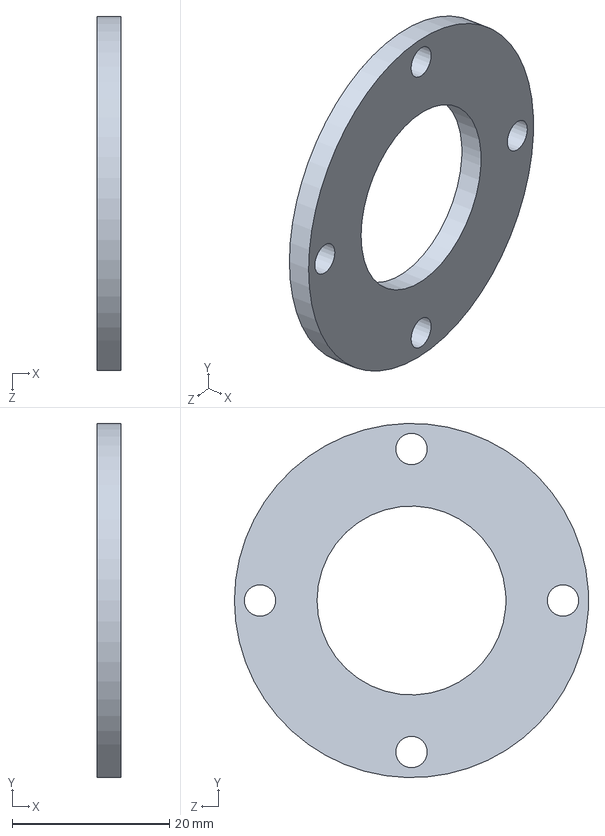
[picture p216: CAD file, 2026-06-05]
CAD/Parts/flipperShaftCap.SLDPRT
3.00 x 45.0 x 45.0 mm
