vasilepi/Thesis/CAD/Parts/dtBackPlate.SLDPRT

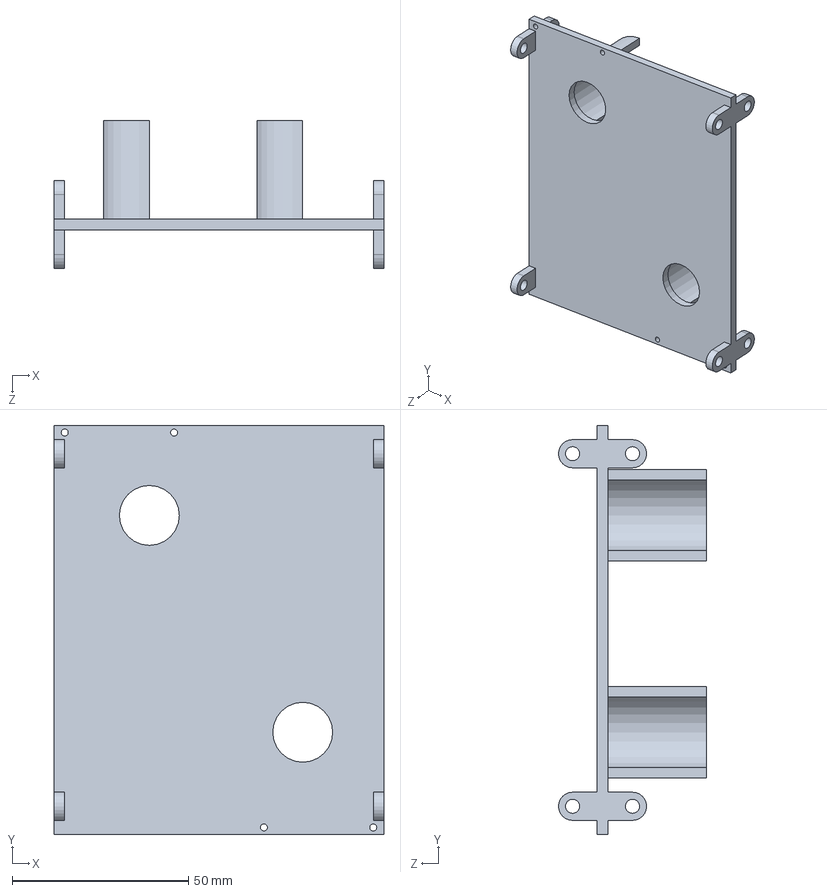
[picture p217: CAD file, 2026-06-05]
CAD/Parts/dtBackPlate.SLDPRT
93.5 x 116.0 x 42.0 mm
