vasilepi/Thesis/CAD/Parts/key.SLDPRT

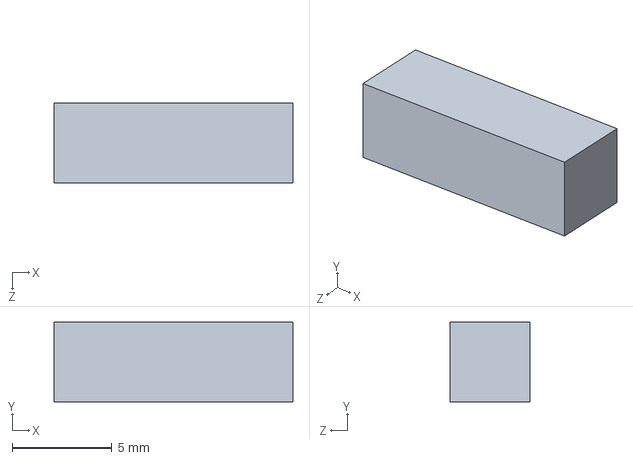
[picture p218: CAD file, 2026-06-05]
CAD/Parts/key.SLDPRT
12.0 x 4.00 x 4.00 mm
