vasilepi/Thesis/CAD/Parts/track-link-small-assembly.SLDASM

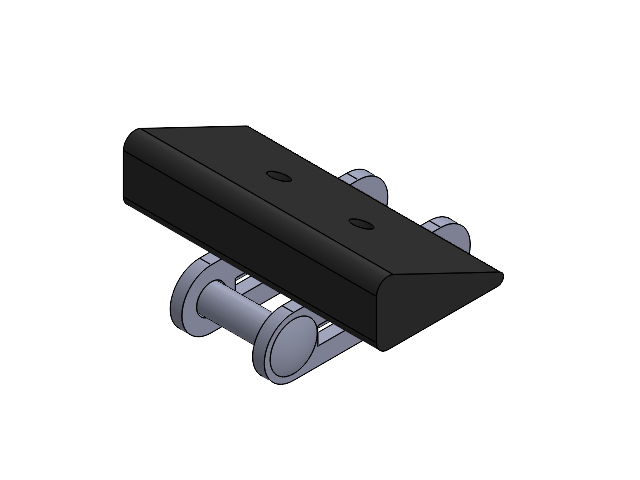
[picture p219: CAD file, 2026-06-05]
CAD/Parts/track-link-small-assembly.SLDASM
chain-link(draft)
chain-shoe-small(draft)
