vasilepi/Thesis/(list of files, cad)

Other CAD files:
CAD/Parts/track-link-assembly.SLDASM
CAD/Parts/misc/bearings/w_61704.SLDPRT
CAD/Parts/misc/bearings/61900.SLDPRT
CAD/Parts/misc/bearings/61903.SLDPRT
CAD/Parts/misc/shaft couplers/3552N12_Bearing Retaining Locknut.SLDPRT
CAD/Parts/misc/shaft couplers/3552N17_Bearing Retaining Locknut.SLDPRT
CAD/Parts/misc/shaft couplers/3552N19_Bearing Retaining Locknut.SLDPRT
CAD/Parts/misc/shaft couplers/8011N225_Precision Flexible Shaft Coupling.SLDPRT
CAD/Parts/misc/shaft rings/97213A101_Inverted External Retaining Rings.SLDPRT
CAD/Parts/misc/shaft rings/97213A108_Inverted External Retaining Rings.SLDPRT
CAD/Parts/misc/shaft rings/98541A119_External Retaining Ring.SLDPRT
CAD/Parts/misc/shaft rings/99178A106_Heavy Duty Side-Mount External Retaining Ring.SLDPRT
