vasilepi/Thesis/(threads)

Thread 1 (2024-11-04):

Functionality system

vasilepi, 2024-11-04:
Design a high-level functionality system. Should include:
- Sensors
- Control algorithms

## To do's
- [ ] Declare sensor types and number of sensors
- [ ] Design control systems for basic robot functions

The robot should be able to achieve the below with its functionalities.
## Objective
- Locate victims
- Obstacle recognition/negotiation
- Localization and mapping of environment
- Autonomous speed control

vasilepi, 2024-11-30:
The sensor that are proposed are:
- x1 Thermal Camera with wide FOV (>80deg)
- x2 Bidirectional Microphones
- x1 Vibration sensor
- x1 2D 360 FOV LiDAR
- x1 IMU
- x1 PSD
- x4 CO2 sensors

Positions:
- The camera will be on a base at the top surface of the robot body so it can have a clear field of view
- The microphone will be near the camera on the base facing perpendicular directions directions so the bipolarity of the two mics will cover a 360deg field.
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
- The vibration sensor should be at the bottom surface of the robot body, as close to the ground as possible so the input will be as intact as it can be due to damping
- The LiDAR should be above the robot's highest surface so it can scan only the environment and not the robot parts
- The IMU should as close to the robot's COG as possible
- The PSD should be as close to the ground as possible ans as close to the front wheels as possible
- The CO2 will be on each vertical side of the robot body

### SUMMING UP:
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

vasilepi, 2024-12-03:
The robot is assumed to work semi-autonomously. That means that whenever needed a human operator can take control of the robot. For the functionality it is assumed that the robot works autonomously until the operator intervene. The functionality of the above sensor picks is justified by the following proposed automation algorithm for victim identification. The following algorithm proves that the sensors chosen can function adequately for a USAR mission. Here for every sensor it is assumed that after collecting the data, an appropriate NN algorithm is used to determine whether or not a victim is identified (by that sensor reading only). So:
- A: the response of the  Camera Sensor NN algorithm.
- Mi: the response of the Microphones NN algorithm. Before the NN algorithm the readings are filtered properly.
- Ci: the response of the CO2 sensors NN algorithm
- V: the response of the Vibe sensor NN algorithm. Before the NN algorithm the readings are filtered properly.

For each of the above, the result will be a boolean variable where 1 means that the algorithm identified a victim and 0 that it didn't. For the Ci and Mi sensor results, at least one of them needs to provide a result. That's why these sensor pass through a LOGICAL gate (Each sensor reading passes through the NN algorithm. So for 2 microphones we have 2 readings and 2 passes through the NN algorithm so 2 results). Also:
- S1: Scenario 1 is when the system prompts the human operator to call the decision (whether or not to keep searching, if the human operator detects a victim through the camera, to check if the victim identified is actually a victim and various other functions)
- VI: stands for Victim identification through the automation algorithm. Every time the algorithm itself identifies a victim without the need of the operator, the operator is notified to confirm the decision
- S2: Scenario 2 is the vibration localization algorithm. It stands for a localization algorithm where the robot tracks the vibrations source from the sensor readings
- SL: Sound localization algorithm
- 0: resume search, ignore sensor readings

### RECAP
| Variable | Info |
|---| --|
| A| A=1 or A=0 means the camera sensor NN algorithm identified or did not identified a victim|
| Mi| Mi=1 or Mi=0 means the microphone sensor i NN algorithm identified or did not identified a victim|
| Ci| Ci=1 or Ci=0 means the CO2 sensor i NN algorithm identified or did not identified a victim|
| V| V=1 or V=0 means the vibration sensor NN algorithm identified or did not identified a victim|
| S1| Prompt to the human operator to decide the next robot funciton |
| S2| Initiate vibrations localization algorithm|
| SL| Initiate sound localization algorithm|
|0| Resume search|
| VI|Victim identified by the automation algorithm alone|
| S1, S2| Notify the operator to start S2 |
| S1, 0| Notify the operator to resume search |

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

Thread 4 (2025-02-27):

Mass and Energy Budget

vasilepi, 2025-02-27:
Calculate the mass budget and energy budget of the vehicle.
Steps:

- [ ] Create CAD assembly of the robot
- [ ] Add density and materials in solidworks to calculate the total mass

After calculating the mass:

- [ ] Declare motors
- [ ] Create energy budget
- [ ] Declare battery

vasilepi, 2025-03-05:
The first iteration of the CADV1.0 is complete. Materials have been added to all the parts. The materials that were chosen are
- 2024-T4 Aluminum due to its high elastic modulus over density
- Alloy steel (common material for shafts, good manufacturability, high strength)
- Rubber (for the track shoes for higher friction with the ground)

The complete mass budget can be found [here](https://docs.google.com/spreadsheets/d/1dSLtLHoS9FY3o4XzIignpxQ59i9sujoK4btNogsYrk4/edit?usp=sharing)

vasilepi, 2025-03-12:
Since the mass budget V1 is complete, the second loop with primary goal to reduce weight starts for the conceptual design. After this loop the conceptual ends.
## From thesis session 11/3/2025
### GOAL -> Reduce weight (aim for <= 15kg)
Add weight reqs to be satisfied:
- The robot should be able to march/climb stairs given its length
- The robot should be able to overcome a conventional stair height given its flippers length.
- Payload as before should be ~5kg of specific volume (specific emergency items like water bottles, masks, bandages etc)

### Actions for CONCEPTUAL LOOP 2
- Reduce length of the tracks
- Make body and the inside track covers one rigid body (preferably from a light material like carbon fiber, synthetic or other kinds of plastic). This is to reduce weight but also eliminate that much rigid bodies from the assembly (the shafts of the two tracks are now "connected" to a single rigid body)
- Choose motors, battery

## CONCEPTUAL END

After that the PRELIMINARY STARTS with the first few steps
- Detailed gear design
